ihsinoky/he-piantor-42/task/screenshots/dashboard-390.png

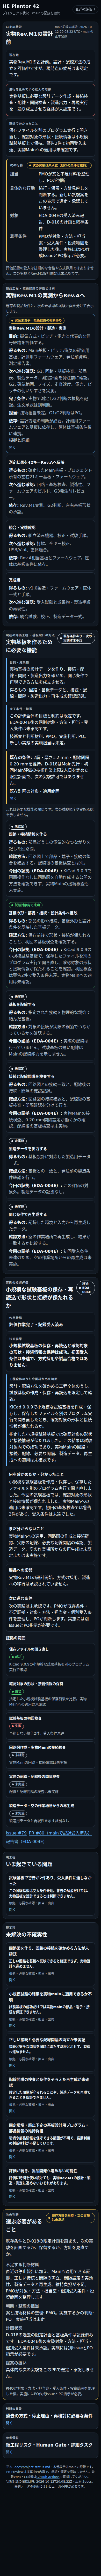
task/screenshots/dashboard-390.png
