ihsinoky/he-piantor-42/task/screenshots/dashboard-320.png

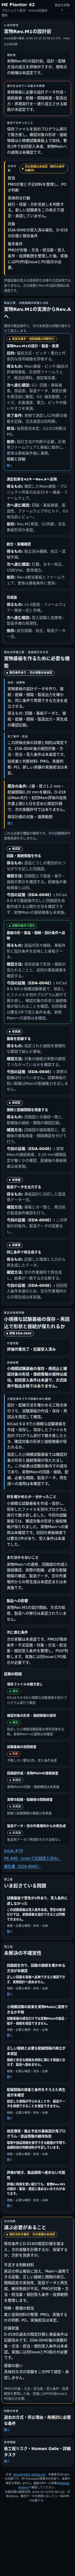
task/screenshots/dashboard-320.png
