ihsinoky/he-piantor-42/mechanical/README.md

# Mechanical

ケース最終データの正本は既存の `hardware/case/issue-198-final/` です。
[成果物索引](../docs/artifacts-index.md)からパラメトリック源・凍結入力・組立STEP・
印刷5ピースのSTEP/STL・検証結果へ直接進めます。

17mm版が正、16mm版は再生成・検証版。固定点15点、200mmハーネス収納、
別基板UDB C3、南辺フラッシュはPO了解済みです。
量産ピッチはMatrix実測後の判断で、ケース印刷はPO判断待ち。
保持力・クリープ等の物理検証は未実施です。[現行状態](../docs/project-status.md)を参照。
