ihsinoky/he-piantor-42/firmware/README.md

# Firmware

Planned stages:

1. Evaluation-board raw sensor acquisition and CSV/log output.
2. Per-key Hall calibration.
3. Digital press/release detection.
4. Vial keymap integration.
5. Layer indicator.
6. Optional adjustable actuation and Rapid Trigger behavior.
