ihsinoky/he-piantor-42/docs/tscircuit-native-spike-report.md

# Issue #19 — native tscircuit Hall spike report

## Outcome and scope

Checkpoints A, B, and C have native TSX implementations and machine-readable stock
tscircuit verification. GitHub Actions remains the authoritative execution
environment. PR #24 run #6 (ID `36808045782`) passed the Checkpoint A regression
and every mandatory Checkpoint B electrical category. Checkpoint B remains a source-level fixture with routing disabled, while
Checkpoint C adds a separate routed manufacturing fixture. This is not a GO or
NO-GO decision for Issue #19; the final decision remains a Human Gate.

The bootstrap task started at handoff commit
`e6ca2dfb0d2d3963bb9bd67fe15b7107af973b36`, which descends from main commit
`44735c7538cb21230758ba9acd334621ba09ad55`. The existing KiCad designs,
firmware, Hall sensor selection, ADC/MUX architecture, and production layout
were not modified.

## Source-of-truth model

The intended experiment was native TypeScript/TSX as the candidate EDA
source-of-truth, with Circuit JSON and manufacturing outputs generated by stock
tscircuit. No KiCad importer, generated-file editing, schema fork, exporter
fork, or autorouter fork was used. Because dependency acquisition was blocked,
the committed design source remains native TSX. Circuit JSON is generated only
as CI evidence and is never edited or committed.

## Tested versions and dependency reproducibility

The requested baseline is `tscircuit` **0.0.2646** and Bun **1.2.22**. Local
Codex Cloud execution remains unavailable:

- `npm view tscircuit@0.0.2646 version bin dependencies --json` returned
  `E403 Forbidden` for `https://registry.npmjs.org/tscircuit`.
- A direct `curl -I https://registry.npmjs.org/tscircuit` failed because the
  environment proxy rejected the CONNECT tunnel with HTTP 403.
- The installed Bun was 1.2.14, not the required 1.2.22.
- Node was v24.15.0 and npm was 11.4.2.

No alternative tscircuit version was selected. The handed-off `package.json`
and `package-lock.json` are unchanged. The lockfile SHA-256 is
`a6bd33cc9d0cfdd6f9f60fa343bf413fae4de33b62a8f4c26141857763cf9d33`.
The workflow hard-gates that digest, runs `npm ci`, checks that the lockfile
remains unchanged, and exactly asserts both runtime versions. Run #1 passed the
digest, install, immutability, Bun 1.2.22, and tscircuit CLI 0.0.2646 gates.

`npm ls --all --json` exited with status 1 and reported peer dependency
diagnostics involving `circuit-json@0.0.499` and
`@tscircuit/alphabet@0.0.25`. These diagnostics are retained in the evidence
artifact but do not invalidate the locked installation. The install output also
reported 11 vulnerabilities (8 moderate and 3 high), which remain a
dependency-health and supply-chain risk. This bootstrap checkpoint does not run
`npm audit fix`, update dependencies, or regenerate the lockfile.

The inherited `footprint:verify` package script is an Issue #13 artifact. It is
left unchanged to preserve the verified dependency pair and remains a future
cleanup candidate outside this checkpoint.

## Geometry provenance and Checkpoint A

The repository's existing
`hardware/lib/third_party/marbastlib-he.pretty/SW_MX_HE_0deg_1u.kicad_mod` was
read only as the permitted secondary reference. It identifies the Gateron
Magnetic Jade switch mechanical datasheet and contains the already verified
project geometry. It was not used as converter input and was not modified.

Checkpoint A uses only the pinned stock native `footprint`, `smtpad`,
`platedhole`, `hole`, and `keepout` primitives. The fixture also places stock
top and bottom copper pours. Repository-owned assertions inspect the resulting
Circuit JSON with an absolute tolerance of 0.001 mm.

The authoritative Checkpoint A conclusions are:

- **Native geometry — PASS:** three SMD pads, one PTH, two NPTHs, and all six
  generated positions verified within 0.001 mm.
- **Pin semantics — PASS:** DRV5055 DBZ pin 1 is VCC, pin 2 is OUT, and pin 3
  is GND. SMD pad 3 and PTH pad 3 are distinct physical PCB ports. Stock
  tscircuit represents them as internally connected source ports using
  `source_component_internal_connection`.
- **Keepout — PASS:** native top and bottom keepouts exist with
  `allow_traces = true` and `allow_placements = true`; actual copper-pour
  exclusion is demonstrated on both layers.
- **Copper pour — PASS:** top and bottom BRep pours were generated, both have
  an exclusion ring spanning the conservative keepout envelope, and the source
  render error count is zero.

| Feature | Native value | Provenance | Verification result |
| --- | --- | --- | --- |
| Hall SMD pads | Pin 1 `(-0.9375, -0.95)`, pin 2 `(-0.9375, +0.95)`, pin 3 `(+0.9375, 0)` mm; each `1.475 × 0.6` mm, top | Existing verified project footprint `hardware/lib/third_party/marbastlib-he.pretty/SW_MX_HE_0deg_1u.kicad_mod` | Circuit JSON asserts count, position, size, layer, and port hints |
| Pin 3 PTH | `(2.3, 0)` mm; 0.3 mm drill, 0.6 mm outer diameter | Existing verified project footprint | Circuit JSON asserts geometry and port hint `3` |
| Switch NPTH | `(-5.08, 0)` and `(+5.08, 0)` mm; 1.7 mm diameter | Existing verified project footprint; Gateron Magnetic Jade / KS-20 project reference | Circuit JSON asserts two circular holes and geometry |
| Hall pin mapping | `1=VCC`, `2=OUT`, `3=GND` | TI DRV5055 DBZ | Primary source ports are asserted; SMD 3 and PTH 3 resolve through distinct physical `pcb_port` records to source ports joined by a Hall-owned `source_component_internal_connection` |
| Relative alignment | Literal component-relative coordinates above | Existing verified project footprint | All six copper/mechanical features asserted within 0.001 mm |
| Top keepout | Center `(0,0)`, `4.0 × 3.6` mm, traces and placements allowed | Conservative native representation of the existing KiCad verified geometry's outer envelope | `pcb_keepout` fields and applicable stock copper-pour BRep inner ring asserted |
| Bottom keepout | Center `(0,0)`, `4.0 × 3.6` mm, traces and placements allowed | Conservative native representation of the existing KiCad verified geometry's outer envelope | `pcb_keepout` fields and applicable stock copper-pour BRep inner ring asserted |

### Native keepout result

Two independent native keepouts cover the conservative envelope on top and
bottom. Passing verification requires two `pcb_keepout` records and one stock
BRep copper pour per layer, each with an inner ring spanning the keepout
envelope. The pours use fixture-only `net.GND` because `connectsTo` is required
by the pinned stock API. They do not connect the Hall sensor and do not start
Checkpoint B. Merely finding keepout records is not sufficient.

## Checkpoint B — electrical result

**PASS.** PR #24 workflow run #6 (ID `36808045782`) is the authoritative
Checkpoint B execution. The native electrical fixture uses routing disabled
and contains exactly one `U1` Hall sensor, one `C_HALL1` 100 nF 0603
capacitor, and one `TP_H0_RAW` circular 1.2 mm pad test point. Named source
traces explicitly connect U1.VCC and C_HALL1.pin1 to the power net `HALL_5V`,
U1.GND and C_HALL1.pin2 to the ground net `GND`, and U1.OUT and
TP_H0_RAW.pin1 to `H0_RAW`.

PMO inspection of the generated stock Circuit JSON and all four evidence files
confirmed that every mandatory category passes:

- Hall sensor count: one named `U1` with `ftype = simple_chip`.
- Required nets: unique `HALL_5V`, `GND`, and `H0_RAW`; stock output marks
  `HALL_5V.is_power = true` and `GND.is_ground = true`.
- Hall mapping: primary pins `1=VCC`, `2=OUT`, `3=GND`.
- Hall attributes: VCC requires power and connection and recommends 100 nF
  decoupling; OUT requires connection; GND requires ground and connection.
- Hall connectivity: named source traces resolve VCC to `HALL_5V`, GND to
  `GND`, and OUT to `H0_RAW` using generated `source_port`, `source_net`, and
  `source_trace` records with `connected_source_port_ids` and
  `connected_source_net_ids`, not net-name string matching.
- Duplicate pin 3: the secondary physical PTH port remains internally connected
  to primary U1.GND.
- Decoupling: `C_HALL1` normalizes to `1e-7 F`; its two independently checked
  traces connect pin1 to `HALL_5V` and pin2 to `GND`.
- Capacitor footprint: one PCB component and two SMT pads are generated by the
  stock `0603` footprinter.
- Raw test point: stock `simple_test_point` output retains pad/circle/1.2 mm
  configuration and generates an SMT pad; its named trace connects pin1 to
  `H0_RAW`, shared with U1.OUT.
- Source electrical errors: `source_failed_to_create_component_error`,
  `source_trace_not_connected_error`, `source_pin_must_be_connected_error`, and
  `pcb_missing_footprint_error` each have count zero.
- Routing remains intentionally disabled in Checkpoint B; Checkpoint C uses its separate routed fixture.
- Checkpoint A regression: PASS in the same authoritative workflow.

The Checkpoint B artifact is `issue-19-tscircuit-native-checkpoint-b`, artifact
ID `11138353031`, digest
`sha256:a2924fee0e4158fd2677385f7176dd2c108224afc7b06eae0895679c6d4b6c01`.
Checkpoint B PASS is not an Issue #19 GO decision.

## Checkpoint C — two-layer PCB and manufacturing result

**PASS.** The authoritative GitHub Actions run is PR #25 workflow run #8
(ID `36851569406`, result **success**). The fixture uses stock
`autorouter="default"`, an explicit two-layer 1.2 mm board, 0.20 mm
trace/clearance rules, top and bottom GND pours, and one explicit 0.30/0.60 mm
top-to-bottom GND stitching via. PMO verification of the Checkpoint C artifact
confirmed one PCB board, three PCB traces, one PCB via, two keepouts, and zero
Circuit JSON `*_error` records. Physical routing exists for `HALL_5V`, `GND`,
and `H0_RAW`. Checkpoints A and B regressions also pass in the same workflow.

The stock `tsci build` command exits zero. `tsci check` reports zero errors.
The non-fatal warnings are `schematic_missing_sheet_warning` and
`pcb_component_missing_courtyard_warning` for U1 and TP_H0_RAW. The locked
stock `tsci check shorts --mode gerber --layer all` reports zero shorts; no
dependency or CDN workaround was used.

## Manufacturing results

Stock `tsci export <generated-circuit-json> --format gerbers` produces the ZIP;
no generated output is edited. Machine-readable verification confirms:

- `F_Cu.gbr`, `B_Cu.gbr`, and `Edge_Cuts.gbr` exist and are non-empty, with no
  inner-copper Gerber.
- `drill-L1-L2.drl` retains both 0.30 mm plated drills: the Hall PTH and the GND
  via. `drill_npth.drl` retains both 1.70 mm switch holes.
- `bom.csv` contains U1 and C_HALL1. U1 source metadata retains TI
  `DRV5055A3QDBZR`, and the stock BOM retains JLCPCB part `C266128`.
- `pick_and_place.csv` contains U1 and C_HALL1 with designator, finite X/Y,
  top/bottom layer, and finite rotation. The physical test point is normally
  excluded from assembly output.
- The plated drill contains the Hall PTH at `X2.3000Y0.0000` and the GND
  stitching via at `X7.0000Y3.0000`, both 0.30 mm. The NPTH drill contains the
  switch holes at `X-5.0800Y0.0000` and `X5.0800Y0.0000`, diameter 1.70 mm.
- The actual stock PnP rows are `U1,0.000,0.000,top,0` and
  `C_HALL1,7.000,-3.000,top,0` (columns: designator, mid X, mid Y, layer,
  rotation).

**PCB FABRICATION PIPELINE = PASS. PCBA DATA STRUCTURE = PASS. PCBA ORDER
READINESS = PARTIAL / DESIGN DATA GAP.** The `C_HALL1` 100 nF 0603 capacitor
supplier identity remains **TBD**, and supplier-specific JLCPCB orientation
correction is **UNVERIFIED**. These are design-data gaps, not stock exporter
data loss, and the PCB is not declared ready to order. The baseline FR4, two
layers, 1.2 mm, 0.20 mm trace/clearance, 0.30/0.60 mm via, and 1.70 mm NPTH is
within the supplied JLCPCB capability baseline. The existing Hall 0.30 mm PTH
is within minimum drilling capability but remains a **MANUFACTURABILITY
CAUTION** because it is below the general 0.50 mm PTH recommendation.

Custom router/exporter/format-workaround count is **zero**. STOP A, B, C, D,
and E are not reached. The authoritative Checkpoint C workflow and artifact
details are recorded below.

## Available DRC/checks

Stock render assertions, `tsci build`, `tsci check`, stock Gerber-mode shorts
checking, and repository-owned read-only verification of Circuit JSON and
manufacturing files all pass locally. The repository code does not implement
EDA, routing, manufacturing export, or generated-file repair.

## CI and evidence artifact

PR #23 workflow run #3 (ID `36770701295`) is **FAIL** for the two implementation
defects described above. Its Checkpoint A artifact ID is `11123790964`, digest
`sha256:1162fc507e20ad94806b1214e56531cef63a6271209c23cc67bce74328f62b0d`.
That run exposed the initial verifier's incorrect shared-`pcb_port_id`
assumption and the copper-pour fixture's missing required `connectsTo` prop.
Both defects were corrected in the subsequent revision.

PR #23 workflow run #4 (ID `36778588388`) is **PASS**. Its Checkpoint A artifact
`issue-19-tscircuit-native-checkpoint-a` has artifact ID `11126467110` and
digest
`sha256:071f9856bd37782197fc6f434c3dac8bc27cfc1aed724696164cffefbfa02094`.
PMO inspection confirmed every mandatory result is PASS, with Circuit JSON
counts of three `pcb_smtpad`, one `pcb_plated_hole`, two `pcb_hole`, two
`pcb_keepout`, two `pcb_copper_pour`, and zero
`source_failed_to_create_component_error` records. Existing `engineering-ci`
run #141 is also **PASS**.

PR #24 workflow run #6 (ID `36808045782`) is **PASS**. Checkpoint A regression
and all mandatory Checkpoint B electrical categories passed in that run. The
Checkpoint B artifact `issue-19-tscircuit-native-checkpoint-b` has artifact ID
`11138353031` and digest
`sha256:a2924fee0e4158fd2677385f7176dd2c108224afc7b06eae0895679c6d4b6c01`.
PMO verified its `verification-result.json`, `electrical-summary.json`,
`execution-log.txt`, and generated `circuit.json`. The corresponding
`engineering-ci` run #144 is also **PASS**.

PR #25 workflow run #8 (ID `36851569406`, head
`b379151529ccaf8bcd1dcfc5cdec0be90cacb399`) is **PASS**. The
`issue-19-tscircuit-native-checkpoint-c` artifact is ID `11155442692`, digest
`sha256:943422a9a635dfc8df5a82657e0cd19dc17e6e08d0eafd0af14e8f10e3a16886`.
PMO verified the artifact and confirmed Checkpoints A, B, and C all **PASS**;
the stock build exits 0, `tsci check` reports zero errors, and
`tsci check shorts --mode gerber --layer all` reports zero shorts. Stock
Gerber, drill, BOM, and PnP export passes. `engineering-ci` run #147
(ID `36851569279`) is also **PASS**.

## Codex Cloud limitation

The environment forced npm and HTTPS traffic through `proxy:8080`; access to
the npm registry and GitHub raw content was rejected with HTTP 403. The required
Bun version was also absent. These are local Codex Cloud limitations rather than
evidence of a tscircuit product limitation. GitHub Actions is therefore used to
validate the handed-off dependency pair without developer-local hidden state.

## Stock-only policy and custom repository code

Stock-only policy was maintained. The repository-owned verification script
asserts stock Circuit JSON but does not implement EDA, routing, exporting, or a
format adapter. No hidden patch or workaround was introduced.

## Remaining unsupported or unverified features

Checkpoint C now verifies the two-layer stock manufacturing pipeline. Full PCBA
order readiness remains partial because capacitor supplier identity and
supplier-specific orientation metadata are source-design gaps.

## STOP status and Human Gate

- **STOP A — not reached:** run #4 passed all mandatory native geometry and
  functional copper-pour exclusion checks.
- **STOP B — not reached:** generated-file editing was neither attempted nor
  required.
- **STOP C — not reached:** no browser UI, interactive login, or
  developer-local hidden state has been shown to be essential. Local Codex
  Cloud package access is blocked, while GitHub Actions is the verified
  non-interactive execution path.
- **STOP D — not reached:** no paid dependency requirement was observed.
- **STOP E — not reached:** stock export retains all mandatory Gerber, drill,
  BOM identity, routing, and pick-and-place fields.

Current bootstrap status matrix:

- Codex Cloud local npm access: **BLOCKED**
- GitHub Actions bootstrap: **PASS**
- Dependency reproducibility: **PASS**
- npm ci: **PASS**
- Bun 1.2.22: **PASS**
- tscircuit 0.0.2646: **PASS**
- Lock integrity: **PASS**
- Checkpoint A: **PASS**
- Checkpoint B: **PASS**
- Checkpoint C: **PASS**

Checkpoint A, B, and C pass without reaching a technical tscircuit STOP.
STOP A, B, C, D, and E are not reached. No GO/NO-GO recommendation is made.
**BOOTSTRAP GATE — PASS**, **CHECKPOINT A — PASS**, **CHECKPOINT B — PASS**, and
**CHECKPOINT C — PASS** do not constitute a GO for Issue #19 as a whole. The
technical checkpoints are complete; the final GO/NO-GO decision remains with
the PO / PMO Human Gate. Issue #19 remains open.

CHECKPOINT C evidence finalized — final PO / PMO Human Gate waiting
