ihsinoky/he-piantor-42/hardware/rev-m1/architecture.md

# Physical Rev.M1 architecture

Accepted architecture requirements — D-015 / D-017, Issues #41 / #57. No schematic, footprint, PCB,
routing, panel or manufacturing output is implemented here.

> **Planning-time record:** The EDA direction and sequence below describe the
> D-016/D-017 acceptance-time plan. EDA-004B–E later qualified none of these
> product-design routes; no current backend or next experiment is approved.
> See the [current project status](../../docs/project-status.md).

[D-015](../../docs/decisions.md#d-015---revm1-reusable-main--evaluation-wing-architecture)
separates physical Rev.M1 from the permanent four-key qualification fixture.
The frozen native tscircuit source/verifier, C2 parity contract/evidence, C3
geometry report and historical sensor-test inputs remain unchanged. D-014 is
historical electrical authority for the fixture, not an adoption decision for
the new product. C2 remains accepted PASS: 68 components, 200 normalized
endpoints, 43 named nets, 185 endpoint/net edges, 4 direct links, 7 intentional
NCs. C3 remains valid discrepancy/modeling/footprint-policy evidence; exact
geometry convergence to the legacy reference is no longer required for adoption.
Those questions have changed relevance, not all been resolved.

```text
USB -> Reusable Main: RP2040 + 3V3 + switched HALL_5V + debug
                    | address / enable / power / ground
                    v
             Evaluation Wing(s): Hall positions -> TMUX1208
                    | analog outputs through representative interconnect
                    v
             Main: three divider/filter paths -> three ADC channels

Rev.A: accepted Main <-> Left 21-key Wing (3 TMUX1208)
                     <-> Right 21-key Wing (3 TMUX1208)
```

Main owns USB, MCU/core and logic power, switched Hall power generation,
three ADC channels and their dividers/filters, Wing interface and bring-up
facilities. Evaluation Wing owns Hall positions, TMUX1208, its connection to
Main and physical switch geometry for pitch and magnetic experiments.

First-choice Rev.A reuses Main unchanged or with explicitly approved
corrections. Left/Right Wings share a project-owned generation definition;
separate designs and manufacturing outputs are allowed, with no reversible
PCBA requirement. Keeping the validated MCU/power/ADC/filter boundary reduces
Rev.A risk, but interconnect loading and production bank behavior must be
represented in M1 measurements before reuse is accepted.

Fixed by D-015: modular responsibilities, Main-side ADC conditioning, Main
reuse intent, three-TMUX/21-key-per-Wing Rev.A candidate, and evaluation of
17.0 / 16.5 / 16.0 mm. [D-017](../../docs/decisions.md#d-017---revm1-mainwing-architecture-and-interface-freeze) and the
[accepted G0B record](g0b-freeze-proposal.md) freeze the exact JST GH 14-position
connector/pinout, six common-GND returns, nominal 100 mm 1:1 evaluation
harness, external Main-side pull-down for each `WING_EN`, pitch-specific
Wings and full-load three-TMUX/three-ADC coverage. Production pitch, final
Hall choice, final cable mechanics, resistor value and physical implementation
remain open. Do not consume `hardware/layout/**`.

[G0A](../../docs/project-status.md#human-gates) was completed at D-016: Issue #55 /
[D-016](../../docs/decisions.md#d-016---jitx-physical-backend-no-go-native-tscircuit-resumes-as-active-revm1-eda-candidate)
records JITX physical-backend NO-GO and, at that decision, native stock
tscircuit as the forward Rev.M1 EDA path. G0B is accepted / done under D-017.
The original planned sequence was G0B -> EDA-003B representative
stock-tscircuit physical/routing proof -> if accepted, full Rev.M1
implementation. EDA-003B through EDA-004E have since completed with
unqualified/blocked outcomes; that sequence is historical, not the current
authorized plan. EVT-002 is not active.
EDA-003A is accepted as UPSTREAM_FIX_CANDIDATE; current importer reuse is
not approved and native TSX remains authoritative. C4A itself did not select
an active backend.
See [logical interface](main-wing-interface.md), [experiments](evaluation-plan.md)
and [DFM policy](dfm-policy.md). No physical hardware is claimed implemented.
