ihsinoky/he-piantor-42/hardware/jitx/PLAN.md

# Project Plan: HE Piantor 42 JITX Challenger Backend

## Scope and authority

EDA-002B establishes only a reproducible JITX project and a machine-readable
parity contract. It does not implement, place, route, or make authoritative an
M1 JITX board. The frozen electrical authority remains
`../tscircuit/src/evaluation/m1-four-key.tsx`, verified by
`../tscircuit/scripts/verify-m1-electrical.tsx`.

## Data sources

| Source | Approved use |
| --- | --- |
| `../tscircuit/src/evaluation/m1-four-key.tsx` | Frozen M1 component, net, connectivity, geometry, and board data |
| `../tscircuit/scripts/verify-m1-electrical.tsx` | Independently asserted endpoint and critical-footprint requirements |
| `../sensor-test/design.md` | Historical qualification-fixture requirements and design-data gaps |
| `../sensor-test/pinmap.csv` | Historical qualification-fixture RP2040 logical assignments |

`../layout/**` is GPL/QMK-derived and is explicitly out of scope. No component
data or geometry is sourced from it.

## Bootstrap task

### [bootstrap-01] Canonical JITX project

- **Type:** project bootstrap
- **Description:** Scaffold the CLI-owned project layout, pin Python `jitx`
  4.4.3, and retain only source/configuration files needed to repeat the
  authenticated Codespaces bootstrap build.
- **Verification:** `jitx build he_piantor_42_jitx.main.HePiantor42Bootstrap`
- **Status:** accepted

### [parity-01] M1 parity contract

- **Type:** contract
- **Dependencies:** bootstrap-01
- **Description:** Freeze the backend-neutral requirements a future JITX
  implementation must reproduce from the approved project-owned sources.
- **Verification:** `python -m json.tool parity/m1-parity-contract.json`
- **Status:** accepted

### [EDA-002C0] Built-design graph introspection

- **Type:** reproducibility and capability spike
- **Dependencies:** bootstrap-01, parity-01
- **Description:** Establish a reproducible Python dependency resolution and
  prove whether a real JITX build has a deterministic, machine-readable graph
  export through the documented JITX plugin interface.
- **Verification:** `jitx design export bootstrap-graph
  he_piantor_42_jitx.main.HePiantor42Bootstrap --output <path>` and
  `python -m unittest tests.test_bootstrap_graph`.
- **Status:** accepted — **PASS**
- **Evidence:** `parity.exporter` is registered through the standard
  `jitx-plugin` project entry-point group and invoked by the documented
  `jitx design export` command. Its `Export.submitted()` hook receives the
  actual `RuntimeDesign`; the exporter uses only `RuntimeDesign.query()`,
  `RuntimeDesign.nets().find()`, `jitx.inspect.visit()`, and `Trace.path`.
  Two real non-dry exports produced semantically identical normalized JSON:
  two resistor instances, four public `Port` identities, and two resolved
  port-membership groups. It does not parse project source or any generated
  JITX artifact, and it uses no private JITX object or module.
- **Stability:** `jitx.inspect` and `jitx.plugin.export.Export` are documented
  public APIs. `jitx.run`, which defines `RuntimeDesign.query()` and
  `RuntimeDesign.nets()`, is documented but explicitly marked experimental.
  The standardized `Export` hook is the supported boundary supplying the
  object; the graph mechanism has no category-C dependency. PMO accepted these
  category-B runtime-design methods for the JITX challenger/parity evaluation
  workflow; that acceptance does not classify `RuntimeDesign` as stable.
- **Compatibility rule:** Any future JITX Python package or JITX runtime
  version change must rerun and pass the EDA-002C0 normalized graph exporter
  and bootstrap graph self-test before graph-parity compatibility may be
  assumed.

### [EDA-002C1] Component modeling

- **Type:** component-modeling checkpoint
- **Dependencies:** EDA-002C0
- **Description:** Model the M1 manufacturer components from manufacturer
  documents, retaining project-approved semantic identities only as metadata
  for a later top-level assembly. `component-sources.md` is the authoritative
  source-manifest for this increment.
- **Status:** done / accepted — all nine manufacturer-specific models
  have physical inventories, explicit pad maps, structural tests and real builds.
  PR #36 merged into main at a27fc48; C1 accepted/done. EDA-002C2 is done / accepted / merged PR #38 with electrical parity PASS.
- **Parity qualification:** HRO and Winbond manufacturer geometry differs from
  frozen M1 geometry. `component-sources.md` enumerates the differences for PMO;
  no geometric parity claim or authority change is made.

### [reproducibility-01] Locked Python environment

- **Type:** dependency reproducibility
- **Description:** Commit the standard `uv.lock` resolution generated by
  `uv lock`; use `uv sync --locked --group dev` to recreate the local editable
  environment without changing the validated JITX runtime.
- **Verification:** `uv sync --locked --group dev`
- **Status:** accepted

### [EDA-002C2] M1 electrical graph parity

- **Dependencies:** EDA-002C0, accepted EDA-002C1 (merged PR #36)
- **Issue:** #37
- **Status:** done / accepted / merged PR #38 at `67b6c302` — electrical graph parity **PASS**. Geometry parity explicitly **NOT established**.
- **Evidence:** actual RuntimeDesign exports, deterministic raw and normalized
  graphs, strict comparator and fault-injection tests. 68 components, 200
  normalized endpoints, 43 named nets, 185 endpoint/net edges, four direct links,
  seven intentional NCs; 23 extra physical GPIOs explicitly unconnected.
- **Verification:** locked sync; 20 Python tests; bootstrap and C2 real-export
  regressions; ruff; pyright; real M1 build; frozen tscircuit verifier;
  protected-file checks and git diff --check. `parity/EDA-002C2.md` records
  commands, review and reproduction instructions.

### [EDA-002C3] Historical geometry evidence

- Issue #39 / merged PR #40, baseline `bc061435`.
- Evidence package retained and valid: `geometry/EDA-002C3.md` and
  `geometry/geometry-reconciliation.json` remain unchanged, including their
  recorded Human Gate dispositions/recommendations.
- HRO, Winbond, RP2040 and derived-land discrepancies demonstrate manufacturer
  modeling capability and footprint-policy risks. They are not all resolved.
- D-015 changes relevance: exact legacy geometry convergence is no longer
  required for adoption; C2 electrical PASS remains accepted.

## EDA-002C4 sequence — evaluation rebaseline (issue #41)

### EDA-002C4A — accepted / merged PR #42

Merged baseline: `8f6c401a902353547dcacbdfc76978ac807ce7f9`.

Completion freezes the legacy four-key golden permanently as a qualification
fixture, retains C2 electrical PASS and C3 historical geometry evidence,
removes exact geometric convergence as an adoption criterion, defines physical
pipeline acceptance criteria, and separates physical Rev.M1 implementation
under [D-015](../../docs/decisions.md) from JITX qualification. No hardware,
footprint or PCB geometry changes, connector selection or adoption decision
occur here. D-014 remains unchanged. C3 discrepancies do not invalidate C2;
manufacturer evidence informs the new product, without correcting the legacy
tscircuit geometry or declaring all C3 questions resolved.

### EDA-002C4B — completed investigation / BLOCKED (issue #43)

The disposable four-key physical wrapper builds with a project-owned 80 × 60 mm,
nominal 1.2 mm two-layer stack and explicit placement of all 68 existing
components. Six source route segments realize copper on both layers through
two vias. Public capture, BOM/PnP review CSVs and supported ODB++ exports repeat;
68 ODB placements/angles agree with the review CSVs. C2 electrical parity
remains PASS with the accepted counts and unchanged contract.

**BLOCKED:** full board routing/DRC and a supported, qualified Gerber/Excellon
handoff are not demonstrated. ODB content order/IDs vary despite matching narrow
geometric records. Supported KiCad export was investigated; downstream CAM and
JLCPCB rotation conventions remain unqualified. Generic BOM completeness is a
separate product sourcing limitation. No private API, artifact patch, external
CAD round-trip, component redesign, product Main/Wing implementation or order
was used. See the [C4B report](physical/EDA-002C4B.md) and machine-readable evidence.

C4C is next / Human Gate; G0A is ready-for-decision on this blocked evidence,
not GO. G0B remains not-ready and EVT-002 remains blocked/unstarted. No D-016
or adoption decision is made here.

### EDA-002C4C — next / Human Gate / G0A

Inputs: C0-C3 accepted evidence and C4B physical/manufacturing pipeline result.
Explicit outcome:

- **GO:** JITX becomes the active EDA candidate for physical Rev.M1 / Rev.A.
- **NO-GO:** retain/fallback to another supported backend without invalidating
  C0-C3 evidence.

C4A makes neither decision. A future accepted D-016 may record JITX as the
active EDA for Rev.M1 and Rev.A; D-016 is not created or accepted now.
G0B separately freezes physical architecture/interface before implementation.
See [physical architecture](../rev-m1/architecture.md).

## Deferred product work

Physical Rev.M1 Main/Wing schematic, placement, routing, DRC, connector
selection, manufacturing and EVT-002 remain unstarted behind G0A/G0B.
`hardware/layout/**` is excluded; future Left/Right generation geometry must
be project-owned or explicitly approved at a later Human Gate.

## Task complete: EDA-002B bootstrap and parity contract

**What was built:** Canonical `hardware/jitx/` CLI project with
`he_piantor_42_jitx.main.HePiantor42Bootstrap` and
`parity/m1-parity-contract.json`.

**Build:** `status: ok` (via
`jitx build he_piantor_42_jitx.main.HePiantor42Bootstrap`)

**Primary source:** JITX CLI scaffold for the bootstrap package; frozen M1
sources listed in the Data Sources table for the parity contract.

**Secondary references:** `../sensor-test/design.md` and
`../sensor-test/pinmap.csv`.

**Footprint source:** not applicable: no M1 footprint or layout was implemented.

**Checks run:**
- `ruff check`: clean
- `ruff format --check`: clean
- `pyright`: not available; not installed in the project environment
- Parity JSON: `python -m json.tool parity/m1-parity-contract.json` passed
- Frozen M1 verification: `npm --prefix ../tscircuit run m1:verify` passed

**Interface notes:**
- Ports exposed: bootstrap-only seed circuit; no M1 interface is exposed.
- Power requirements: no M1 power tree is implemented.
- Constraints needed at top level: deferred to the M1 parity increment.

**JITX code review (self):** clean
- CRITICAL: 0 — no string-keyed models, reflection, parallel scene graphs,
  framework-boundary bypasses, or dynamic classes in
  `he_piantor_42_jitx/`.
- WARNING: 0
- NOTE: 0

**JITX skill use:** The JITX code-review skill was an execution-time agent aid
only. No JITX skill source, script, or other proprietary material is retained
in this repository.

**Outside-voice review (codex):** not applicable: complete-board, task class
not in trigger list.

**Verdict (self):** ready-for-review

**Open issues / deferred (historical EDA-002B):** Electrical parity was then
deferred; C2 now passes it. Geometry, placement, routing, DRC and EVT-002 remain
deferred.

**Verdict (acceptance):** accept
**Notes:** EDA-002B intentionally supplies a reproducible challenger bootstrap,
not an M1 board implementation.

## EDA-002C2 execution plan and completed gates (issue #37)

- Phase 0: frozen project sources only; electrical semantics authorized by the
  implementation request. Existing C1 models retained without edits. Geometry,
  layout, SI/DRC and manufacturing are explicitly outside this task.
- Phase 1: project-owned generic components (no invented MPNs), structural
  validity only; physical implementation choices are non-authoritative.
- Phases 2/3: idiomatic JITX circuit assembly, explicit nets and object ports;
  separate machine-readable parity normalization, never used to wire the circuit.
- Phase 3b: audit complete connectivity against frozen requirements, including
  supply domains, NCs, RP2040 pin assignments and exact passive values.
- Phase 4: real build; two independent RuntimeDesign electrical exports;
  actionable comparator and fault-injection tests; bootstrap regression; locked
  dependencies, lint/type checks, golden verifier, protected-file checks.
- Completion: self-review and evidence; update status only upon full PASS; push
  the C2 branch and open one PMO-review PR without merging (completed as PR #38).
  C3 historical evidence is now retained under the C4A rebaseline.

Status: done / accepted / merged PR #38 at `67b6c302`, electrical PASS.
Geometry parity NOT established; EVT-002 blocked/unstarted.
Runtime startup repaired using existing authorized runtime;
versions unchanged. No skill source is copied into the repository.

## EDA-002C4B execution plan (issue #43)

Disposable backend qualification only. The user authorized autonomous execution;
existing C1 models and C2 topology are locked inputs. No new sourcing, product
architecture, production geometry, layout-directory consumption or dependency
change is planned. Complete-board capability investigation; unsupported gates
remain failures, rather than being waived by the skill workflow.

1. Discover public supported surfaces and record an early capability matrix.
2. Define a project-owned two-layer, 1.2 mm substrate and simple board; compose
   the existing M1ElectricalCircuit with explicit placement, without rewiring.
3. Test source Route/Via realization and supported validation; account for
   incomplete routing rather than undertaking an unreasonable hand route.
4. Assess built-in manufacturing exports and public project BOM/PnP export,
   repeat generation and compare. Preserve separate EDA/BOM conclusions.
5. Run C0/C1/C2 and physical checks, code review, protected-file checks; record
   actual verdict and update only authorized status documents; commit/push/PR.

Phase 0 data/requirements gate: accepted inputs from C1/C2; JLCPCB qualification
defaults explicitly labeled, no production or SI targets. PLAN/ARCHITECTURE
already exist. Official docs and installed CLI are the workflow authority.
Mandatory Gerber/drill/PnP and full routing/validation remain open until proven.

C4B execution result: investigation complete / BLOCKED. Supported board, stack,
explicit placement, partial two-layer source copper, public BOM/PnP observer
and ODB++ generation are demonstrated. Complete routing/DRC and qualified
Gerber/drill handoff remain open; complete-board acceptance is not granted.
All 20 existing tests and final lint/format checks pass; source hashes and
protected-file checks pass. Independent review warnings were resolved.
See `physical/EDA-002C4B.md` and `physical/evidence/`. C4C is next / Human Gate;
G0A ready-for-decision on blocked evidence, G0B not-ready, EVT-002 unstarted.
