ihsinoky/he-piantor-42/hardware/jitx/physical/EDA-002C4B5.md

# EDA-002C4B5 — supported complete-routing qualification

**Final C4B5 disposition: BLOCKED.** Issue [#53](https://github.com/ihsinoky/he-piantor-42/issues/53).
The pinned public source workflow produces substantial copper, but neither
retained candidate achieves zero downstream unconnected electrical items.
The explicit multilayer candidate retains **39 unconnected items and a dangling
via**. This concludes a bounded supported-workflow investigation, not complete
routing, manufacturing release, or the C4C / G0A adoption decision.

## Baseline and boundary

Clean working tree, HEAD, local main, freshly fetched/pruned origin/main, and
merge bases with both main refs all matched
`69dd846ac76d40f333b1b099a13d2a4720cfe758`. Git fetch required sandbox escalation.
Issue #53 was read completely (no comments), along with C4B–C4B4B reports,
physical source/reproduction/reconciliation and both status authorities.
Branch: `eda-002c4b5-complete-routing-feasibility`.
[Discovery/preflight](c4b5-evidence/routing-surface.json) records this state.

Forward `routing_qualification.py` subclasses the unchanged disposable C4B
circuit, which inherits accepted C2. All 68 components, manufacturer landpatterns,
NCs, topology, 80 x 60 mm board, substrate, fabrication constraints and source
placement remain unchanged. No `hardware/layout/**` geometry is used. This is
not physical Rev.M1 Main/Wing, Rev.A or G0B implementation. Historical C4B through
C4B4B reports/evidence and all pre-existing JITX source/configuration remain
byte-unchanged. Generated CAD/CAM is ignored and never edited.

## Supported surface and early strategy

[Surface matrix](c4b5-evidence/routing-surface.md) distinguishes A public,
B experimental, C interactive/manual-only, D private and E unavailable. Exact
installed symbols/signatures, source module hashes and public CLI help are in
its JSON companion. Environment: **Python 3.14.2 / JITX 4.4.3 /
jitxlib-standard 4.4.0 / runtime 4.4.2 / KiCad CLI 9.0.9**. Locked sync, auth,
runtime reachability and non-dry builds succeeded; no version upgrade.

The strongest established non-interactive surface is **A: source `Route` requests
using the JITX single-layer topological engine**, with public sketches, pads,
source vias and signal `PortAttachment`. The existing public capture observer
uses **B: experimental RuntimeDesign**. Interactive selection/layer routing and
auto-via are supported UI facilities; no public headless global multilayer
planner or whole-GUI-layout-to-Python routing conversion was established in the
pins. This is a bounded surface finding, not proof of impossibility.

Before specifying point-by-point paths, select deterministic nearest-pad spanning
trees from actual public `Net`, `PadMapping` and pad geometry. This scales endpoint
intent to all required nets with compact Python. Preserve the four existing
Hall/probe paths, including H0's two vias. Include physical multi-pad islands:
USB SHIELD receives three requests among its four manufacturer stakes despite
having a singleton semantic endpoint. Empty declarations, intentional NCs and
unused GPIOs get no requests. The method delegates copper pathfinding to JITX;
it is not an external autorouter or user implementation of a copper router.

A preliminary real build/capture/DRC reduced historical 147 unconnected items
to 42 (111/153 requests realized), with a new copper-sliver warning. This justified
the fresh systematic experiment and a representative explicit multilayer escape,
without a large manual segment program. Preliminary ignored outputs are under
`designs/c4b5/exploratory`; retained qualification evidence is the fresh pair below.

## Actual downstream results

[Pipeline](c4b5-evidence/pipeline.json) records exact command argv, exit codes,
logs/hashes, source hashes and complete generated inventories. Each experiment
restarts the pinned runtime and removes only that forward design's ignored
state and its own run directory. The two experiments use different circuit
variants; **they are not two successful regenerations of one candidate**.

| Fresh experiment | Source requests realized / total | Vias | KiCad unconnected | New routing findings |
| --- | ---: | ---: | ---: | --- |
| 1: systematic top-layer requests + inherited H0 path | 113 / 153 | 2 | **40** | One F.Cu copper-sliver warning |
| 2: replace failed MUX_A0 request with explicit two-via escape | 116 / 155 | 4 | **39** | One dangling-via warning |

Both real builds report `status: ok`; that does not certify physical connectivity.
Both supported `legacy-kicad` exports succeed. KiCad input is mounted read-only;
all input-tree hashes remain unchanged after KiCad DRC. DRC returns code 5.
Raw findings and physical capture are retained in
[experiment 1](c4b5-evidence/experiment-1.json) and
[experiment 2](c4b5-evidence/experiment-2.json).

Experiment 2 binds GPIO2 and mux A0 to two unchanged 0.65/0.30 mm through vias
at (-18.5, 1.4) and (11.8, 2.275) mm. JITX realizes the bottom span and mux-side
top connection; it fails the MCU-side top escape. KiCad independently identifies
the MCU-side via as connected on only one layer. MUX_A0 remains unconnected.
Replacing a constructed request emits a structural lost-reference warning;
the test verifies exactly one old request is removed, and capture confirms 155
requests including the three replacements. No hidden route is assumed.

Other missing connectivity spans supply distribution, MCU/flash QSPI, USB,
crystal, debug, mux controls and Hall-to-mux connections. Source endpoint counts
are not substituted for this physical evidence. In both fresh reports USB_SHIELD
has no missing connection: all four stakes are physically joined in downstream
CAD. This local success does not hide the remaining board-wide failures.

Both reports also retain exactly **four known USB NPTH hole-clearance errors
and 68 generated-library-registration warnings**. No new short, wrong-net,
copper-clearance, invalid via geometry/layer-transition, copper-outside-board or
edge-clearance finding was reported. The new sliver/dangling-via findings remain
unresolved; their warning severity is not used to waive them. No rule was relaxed.

Complete routing was not achieved, so Gerber/Excellon generation and a successful
same-candidate two-fresh-run manufacturing comparison are **not applicable** and
were not performed. Earlier and fresh top-layer captures differ in realized
request count; routing stability is unqualified. No geometric difference was
normalized away. The two different experiments cannot establish determinism.

## Workflow suitability and limiting mechanism

All attempted routing intent is represented in Python. Regeneration is
non-interactive, with no GUI action or GUI-authored hidden state. Ordinary diffs
expose endpoint selection, via coordinates, layer use and optional sketches;
computed copper needs capture/downstream DRC to review. The routing module is
approximately 140 lines, including both variants; 147 additional requests are
selected systematically, not hand-written segment by segment. One manual
escape adds two positions and three requests. Existing six routes/two vias are
inherited unchanged. Codex can create/review this intent and run the pipeline.

The limiting mechanism is **global layer/fanout/path planning**, not lack of a
Route constructor or route-all CLI. Single-layer endpoint trees leave 40 physical
connections missing. Specifying a second-layer span does not solve reaching that
layer from a crowded MCU pad. Expansion requires package escape placement,
layer allocation, route ordering/sketch changes and repeated physical verification
across many nets. No supported automatic source helper for those combined tasks
was established in the installed pins. Constraints, control points and via
structures describe local intent; they do not supply this planner.

This evidence does not prove that an expert cannot finish the board manually,
or that every alternative placement/route ordering fails. It establishes that
these compact supported approaches did not complete this fixture, and that a
credible complete AI/source-controlled workflow has not been demonstrated.
A routine maintenance claim would currently depend on unqualified substantial
manual routing strategy, likely aided by GUI inspection. Arbitrary placement
sweeps or enumerating many sketches to force green would not establish suitability.
No such brute force, private API, generated-KiCad edit, external router or EDA
round-trip is used. Further investment belongs in the C4C assessment.

## Electrical regression, reproduction and review

[Electrical reconciliation](c4b5-evidence/reconciliation.json) compares both live
wrapper graphs with a fresh unchanged C2 export, excluding only added physical
attachments from original component memberships. Components and original net
memberships match. The unchanged normalized contract passes: **68 components,
200 endpoints, 43 named nets, 185 endpoint/net edges, four direct links,
seven intentional NCs**, with accepted unused GPIO accounting.

From `hardware/jitx`, with the existing environment and Docker:

```bash
UV_CACHE_DIR=/tmp/eda-c4b5-uv-cache uv sync --locked --group dev
source .venv/bin/activate
jitx auth show
jitx runtime start --background
python -m physical.reproduce_c4b5
python -m unittest discover -v
ruff check he_piantor_42_jitx physical parity tests
ruff format --check he_piantor_42_jitx physical parity tests
python -m compileall -q he_piantor_42_jitx physical parity tests
```

The reproducer uses supported non-dry build, existing physical capture plugin,
`legacy-kicad`, then read-only pinned-container `kicad-cli pcb drc --format json
--severity-all --exit-code-violations`. It stops on unexpected command failure.
These partial designs must not be fabricated. No CAM or ordering command follows.

[Validation and self-review](c4b5-evidence/validation.json) records actual checks,
protected historical files, regression outcome and review scope. Same-model JITX
review uses installed jitx/physical-layout/code-review instructions and architecture
checklist. No unresolved critical code issue or private boundary crossing remains.
The intentional removed-request warning and incomplete route planner are retained
limitations. The two new tests protect physical-pad/NC coverage and exact
single-request replacement; downstream DRC remains completion authority.

## PMO / Human Gate

No environment/license STOP occurred; the experiments were meaningful. C4B5 is
**BLOCKED**, not PASS_WITH_LIMITATIONS: required physical routing is incomplete.
There is no assertion that only a forbidden workaround could solve the board.

C4B4B's downstream manufacturing path remains **PASS_WITH_LIMITATIONS**, including
the misleading generated 1.6 mm overall CAD/job metadata and independent **1.2 mm**
finished-thickness handoff. USB remains **OPEN — PRE-ORDER DFM REVIEW REQUIRED**;
no production exception or clearance resolution is granted. No supplier contact,
upload or order occurred.

After C4B5 acceptance, **C4C / G0A Human Gate is next** and must explicitly evaluate
this routing/workflow limitation; JITX is not technically accepted for full
physical implementation. No adoption decision, C4C work or automatic merge.
PMO reviews the bounded BLOCKED conclusion; PO decides MERGE / HOLD.
