ihsinoky/he-piantor-42/hardware/jitx/physical/EDA-002C4B2.md

# EDA-002C4B2 — JITX → headless KiCad downstream CAM

**Verdict: BLOCKED.** Issue [#45](https://github.com/ihsinoky/he-piantor-42/issues/45).
The supported one-way pipeline executes twice, but manufacturing qualification
is blocked by a thickness conversion conflict and four source copper-to-NPTH
clearance errors. Expected partial routing is **not** the reason for BLOCKED.
No C4C / G0A adoption decision is made.

## Scope, baseline and environment

Before changes, HEAD, merge-base with main, local main and live GitHub main
were all `d085e540aefc76e2dd56b614b2c8141f42facbe9`; the working tree was clean.
Issue #45 was read completely, with zero comments, along with the historical
[C4B report](EDA-002C4B.md) and its evidence. Branch:
`eda-002c4b2-headless-kicad-cam`.

Python 3.14.2; **JITX 4.4.3 / jitxlib-standard 4.4.0 / runtime 4.4.2**.
Locked sync succeeds without dependency changes. Existing image
`kicad/kicad:9.0.9` executes `kicad-cli version` and reports **9.0.9**;
local image ID is
`sha256:e638b79b0321f29395a5b783e94bb9f3c73303e8da15da27b8f5cb4b67a37729`.
No image pull, package/runtime upgrade or autorouter was used.

JITX is the sole design authority for this disposable qualification fixture.
The frozen tscircuit oracle and D-014/D-015 retain their historical roles.
The accepted source, C0–C3 and historical C4B report/evidence remain unchanged.
Generated KiCad files are read-only downstream inputs, never manually edited,
repaired or round-tripped. No Main/Wing, G0B, complete routing, ordering or
production adoption work was performed.

## Reproduction

Run from the repository root, with Docker and the existing licensed runtime
available. These commands use the existing locked environment:

```bash
cd hardware/jitx
UV_CACHE_DIR=/tmp/eda-c4b2-uv-cache uv sync --locked --group dev
source .venv/bin/activate
jitx auth show
jitx runtime start --background
python -m physical.reproduce_c4b2
python -m physical.qualify_c4b2
python -m physical.compare_c4b2
python -m unittest discover -v
ruff check he_piantor_42_jitx physical parity tests
ruff format --check he_piantor_42_jitx physical parity tests
python -m compileall -q he_piantor_42_jitx physical parity tests
cd ../..
node --check task/data/project-status.js
git diff --check
```

The reproducer restarts runtime 4.4.2, removes only the ignored generated
qualification design directory and the corresponding `designs/c4b2/run-N`,
then builds, captures and exports sequentially for N=1 and N=2. Historical
C4B evidence is never regenerated. Each run is independent of GUI/cache state
for this fixture. Original C4B source/config hashes are verified against its
manifest before and after generation. The read-only reconciliation was
implemented after generation and its final source hashes are separately
recorded in the determinism evidence.

The underlying commands for each run are:

```bash
DESIGN=he_piantor_42_jitx.physical_qualification.M1FourKeyPhysicalQualification
RUN="$PWD/designs/c4b2/run-1" # use run-2 for the second fresh generation
jitx runtime stop
# The Python reproducer deletes only this fixture's ignored generated directory.
jitx runtime start --background
jitx design build "$DESIGN" --no-dependency-check
jitx design export physical-qualification "$DESIGN" --output "$RUN"
jitx design export legacy-kicad "$DESIGN"
# The reproducer copies the unmodified kicad export tree into $RUN/kicad.
# Invoke each command with this identical Docker prefix:
docker run --rm --user "$(id -u):$(id -g)" \
  -v "$RUN/kicad:/input:ro" -v "$RUN/cam:/out" kicad/kicad:9.0.9 \
  kicad-cli pcb drc --format json --severity-all --exit-code-violations \
  --output /out/drc.json "/input/$DESIGN.kicad_pcb"
# With the same Docker prefix, replace the kicad-cli arguments with:
kicad-cli pcb export gerbers \
  --layers F.Cu,B.Cu,F.Mask,B.Mask,F.Paste,B.Paste,F.SilkS,B.SilkS,Edge.Cuts \
  --output /out/gerber/ "/input/$DESIGN.kicad_pcb"
kicad-cli pcb export drill --format excellon --excellon-units mm \
  --excellon-separate-th --generate-report --report-path /out/drill-report.txt \
  --output /out/drill/ "/input/$DESIGN.kicad_pcb"
kicad-cli pcb export pos --format csv --units mm --side both \
  --output /out/positions.csv "/input/$DESIGN.kicad_pcb"
```

[Pipeline evidence](c4b2-evidence/pipeline.json) records every actual argv,
return code, output size/hash and source hash. DRC code 5 is accepted only as
report-producing evidence; other failing command codes stop the reproducer.
The reconciliation then interprets the findings. All CAM commands return 0;
DRC returns 5 in both runs. Hashing verifies the entire KiCad input tree is
unchanged after CAM. `--no-dependency-check` follows locked sync and does not
bypass physical validation. The official [JITX CLI](https://docs.jitx.com/en/latest/getting-started/cli/index.html)
and [KiCad 9.0.9 CLI reference](https://docs.kicad.org/9.0/en/cli/cli.html)
are the supported workflow references; installed CLI help was also checked.

## Generated-output inventory and physical reconciliation

Each run contains 59 KiCad files: PCB, schematic, project, worksheet, two
library tables, legacy symbol library and 52 footprint library files. CAM
creates nine Gerbers plus a job file, PTH/NPTH Excellon files, drill report,
68-row position CSV and JSON DRC report. Public JITX capture adds electrical
and physical observations plus BOM/PnP review CSVs. Full inventories/hashes
are in `pipeline.json`; generated packages remain ignored under `designs/`.
The two raw DRC reports, positions and drill reports are retained in the new
`c4b2-evidence/` directory as review evidence, without design authority.

[Reconciliation evidence](c4b2-evidence/reconciliation.json) records:

| Check | Result |
| --- | --- |
| Outline | Closed rectangle 80 × 60 mm; Edge.Cuts x=99.5…179.5, y=78…138 |
| Copper layers | Exactly F.Cu and B.Cu |
| Population/poses | All 68 components match historical C4B poses; all on top |
| Coordinates | PCB x=139.5+JITX x, y=108−JITX y; footprint angles retain JITX CCW values |
| Pads/net identity | 228 pad/hole records match source geometry and port mappings; no net differences |
| Vias | Two H0_RAW through vias: source (31,−12)/(33,−12); 0.65 pad / 0.30 drill |
| Source routes | Six source routes represented by seven segments and one arc, with copper on both layers |
| Connectivity | Original component topology preserved; C2 comparator PASS |
| Drill | Two 0.30 mm plated via holes, four 0.60 mm plated shell slots, two 0.60 mm NPTH locators |
| Gerbers | Two copper, two mask, two paste, two legend, one outline; job inventory reconciles |
| PnP | 68 rows; x=PCB x, y=−PCB y, rotations agree; fixture origins, no supplier qualification |

The comparison uses public JITX `TestCase`, `visit`, PadMapping and documented
Component default port-to-pad ordering; it reads the downstream S-expression
without modifying it. Analytic source circle radii are used rather than coarse
display polygons. Other pad geometry agrees within 0.001 mm. Existing C4B route
WKT uses public `ShapelyGeometry.from_shape`'s documented 0.01 mm arc approximation;
observed maximum Hausdorff differences are 0.00218518 mm top / 0.000120454 mm
bottom. These are bounded observer comparisons, not an exact arc equivalence
certificate. The fresh physical/electrical/PnP captures also match historical
C4B hashes exactly. Two extra mask-only SMD records represent the NPTH mask
openings, not new components or connected copper.

The Gerber job's function vocabulary uses SolderPaste/SolderMask/Profile;
individual X2 headers use Paste/Soldermask/Profile,NP. Both observed vocabularies
are explicitly reconciled. The job's 80.05 × 60.05 mm size includes the
0.05 mm outline stroke; centerline dimensions remain 80 × 60 mm.

## DRC interpretation and supported-workflow blockers

Both raw reports record **147 unconnected items, four hole-clearance errors,
and 68 library warnings**. This is not a green manufacturing DRC.

The 147 unconnected items reconcile exactly per net with source physical-pad
islands and historical endpoint accounting. Each Hall net has one missing
connection to its mux endpoint, after subtracting the realized Hall/probe path.
USB_SHIELD has three missing links between its four physical stakes, consistent
with C4B's explicit singleton physical-pad-review limitation. GND has 47,
V3V3 24, HALL_5V 12 and VBUS eight missing links; other per-net counts are
recorded in the reconciliation. Empty CC1/CC2 declarations and accepted NCs
are not converted into false routes. No unexpected net membership was found.

**Blocker 1: source clearance.** J1 contact lands A1_B12/A12_B1 have approximately
0.2001 mm copper-to-locator gaps; A4_B9/A9_B4 approximately 0.2349 mm. These
are below the unchanged fixture's 0.25 mm copper-to-hole qualification rule.
Independent source geometry agrees with KiCad's measurements. They are newly
observed source-rule conflicts, not evidence of copper lost in conversion.
Historical C4B checked pad overlap/containment but did not establish this DRC.
The accepted manufacturer model and historical evidence are preserved.

**Blocker 2: thickness conversion.** Source and exported physical stack total
1.20 mm including masks (1.17 mm excluding them), but generated PCB
`general.thickness` is 1.6 mm. KiCad's Gerber job also declares
`BoardThickness: 1.6`. A fabrication consumer could receive the wrong thickness;
this is a material supported-export discrepancy, not harmless metadata or
partial routing. No supported correction was established in this qualification.
No generated-file patch, design change, upgrade or private workaround was tried.

The 68 `lib_footprint_issues` warnings say the generated library is not included
in the current configuration, despite a generated table and `.pretty` tree
being present. An additional supported invocation with Docker working directory
`/input` returns the same findings. Board-embedded geometry/net mapping checks
pass; library registration/checking remains a limitation. No manual library
repair was performed. There are no additional track, via, board-outline or
copper-clearance findings in these reports. DRC is subject to the generated
project's rules; this does not prove every JITX fabrication field transfers.

## Two-run determinism

[Determinism evidence](c4b2-evidence/determinism.json) accounts for all 86 run
files: 68 byte-identical; 12 differ only in verified timestamp fields; two
copper Gerbers differ in timestamps and ordering of the same two via flashes;
one PCB differs in via record order/IDs; two schematic companion files differ;
one runtime log differs in PID/socket URI. No archive is used in this pipeline.

Every raw difference is retained in
[two-run-differences.json](c4b2-evidence/two-run-differences.json), a read-only diff
that is never applied. No nondeterminism is hidden. PCB comparison preserves
scalar coordinates and polygon/stack/layer sequence, removes only UUID/tstamp
and numeric net aliases, and compares unordered property/object records.
Gerber comparison removes only the two creation-time fields and sorts only
consecutive absolute-coordinate D03 flashes with identical surrounding modal
state. It never sorts paths, apertures, attributes or polarity commands.

**No manufacturing-significant difference was found in this pair:** geometry,
net identity, layer content, drilling and assembly coordinates repeat. The
thickness error repeats too. Position CSVs are byte-identical; drill commands,
tool diameters and coordinates are identical after removing creation times.
DRC differs only in its date. Schematic symbol allocation/presentation and
legacy symbol-library content vary substantially; their semantic equivalence
is unqualified and out of scope for this PCB-fed CAM path. This is a two-run
observation, not a general determinism guarantee.

## Verdict dimensions, validation and PMO input

| Dimension | Conclusion |
| --- | --- |
| A — JITX → KiCad usable? | Usable for disposable downstream validation/plotting; manufacturing conversion fidelity is BLOCKED by thickness |
| B — missing DRC/unrouted validation? | Demonstrated: machine-readable DRC detects the known partial state and additional source clearance conflicts |
| C — Gerber/Excellon/PnP generation? | Demonstrated twice; outputs remain unqualified for manufacturing because of the material findings |
| D — full-routing limitation independent? | Yes; pipeline needs no extra routing and its known unrouted findings are reconciled; complete source routing remains open |

Validation: locked sync; two non-dry physical builds and legacy exports;
two headless DRC/Gerber/Excellon/PnP runs; all 20 unchanged C0/C1/C2 regressions;
read-only source/geometry/connectivity/CAM reconciliation; hash consistency;
45-file ruff format/lint; Python compilation; Dashboard syntax and whitespace
checks. CI scope changes no layout, existing KiCad product, firmware or workflow
paths, so those engineering jobs are inapplicable under the unchanged workflow's
path classifier. Draft PR CI results are recorded in `validation.json`.

Task acceptance: supported pipeline execution and narrow reconciliation are
accepted as qualification evidence; manufacturing qualification **BLOCKED**.
Public API review found no private calls, source-design changes, generated-file
writes or unsupported repair. Static type checking is unavailable in the existing
environment and was not installed. Sourcing, assembly filtering, supplier
zero-angle conventions and full source routing remain independent limitations.
PMO should review these findings before PO MERGE/HOLD. C4C / G0A remains a
later Human Gate; G0B remains not-ready and EVT-002 unstarted. Do not merge
this Draft PR automatically.
