ihsinoky/he-piantor-42/hardware/jitx/geometry/EDA-002C3.md

# EDA-002C3 geometry reconciliation decision package

Issue: [#39](https://github.com/ihsinoky/he-piantor-42/issues/39). Research date:
2026-10-03; completed 2026-10-04. **Evidence package prepared; Human Gate OPEN. No component has
an approved geometry decision. No geometry implementation is authorized.**

Electrical parity remains **PASS**. Geometry parity is **NOT established**.
EVT-002 remains blocked; D-014 and JITX challenger status are unchanged.
This report recommends correcting HRO to its exact manufacturer PCB layout
after approval, and deferring Winbond land selection until the assembly-policy
and coordinate-view questions below are resolved. The frozen project geometry
remains the baseline until PMO / Product Owner explicitly decides otherwise.

## Checkout and authority

Initial working tree was clean. Branch was and remains
`eda-002c3-jitx-geometry-reconciliation`; HEAD, merge base with the expected
baseline, and local `origin/main` were all
`67b6c3026b9931883b5699f0cecd73ea79996676`, PR #38 squash merge. No AGENTS.md
was found. Issue #39 was created before geometry research or repository edits.

| Tier | Authority | Application here |
| --- | --- | --- |
| 1 | Exact manufacturer's recommended PCB layout, package drawing and exact ordering code | HRO exact M-12 layout; Winbond exact UX mechanical outline and UXIQ ordering |
| 2 | Explicit, reviewable package-rule / IPC derivation | Installed JITX SON density-C computation using Winbond tolerances; a design derivation, not manufacturer-approved lands |
| 3 | Project-owned frozen tscircuit M1 geometry | Current project baseline; stronger evidence can support a proposed correction, subject to the Human Gate |
| 4 | Distributor/community footprints and metadata | Corroboration only; none was needed to decide the findings in this report |

No `hardware/layout/**` content was consumed. No distributor footprint was
downloaded. C1 descriptions were used to locate sources, not treated as proof.

Classification is per feature: IDENTICAL means the same dimension;
TOLERANCE_EQUIVALENT means a nominal difference fits an explicitly stated
drawing tolerance, or numerical rounding fits the frozen verifier's 0.001 mm
comparison threshold, without claiming full fit or manufacturing acceptance;
PROJECT_DESIGN_CHOICE means a defensible land-design alternative requires
explicit approval; FROZEN_BASELINE_ERROR means the frozen claim of an exact
manufacturer layout is contradicted by stronger evidence;
SOURCE_AMBIGUITY means the available evidence does not settle the comparison.

## Reopened primary sources and reproducibility

Both official landing pages and their actual PDF links were freshly fetched
with curl and a browser user-agent; HRO also required its official-page referer.
The web reader failed for these URLs, but direct downloads succeeded. Each file
has a PDF signature and was opened with an isolated PyMuPDF reader in `/tmp`.
No project dependency or lockfile was changed. Fresh PDFs also match the C1
cache byte-for-byte by SHA-256; fresh HRO page 4 and Winbond PDF pages 68, 73,
74 were rendered and inspected independently. The identical C1 page-6 render
was used to inspect Winbond's printed-page-5 top-view pin map.

| Source | Exact selection | SHA-256 of downloaded PDF |
| --- | --- | --- |
| [HRO official product page](https://en.krhro.com/Product-Details/726.html) → [family PDF](https://omo-oss-file110.thefastfile.com/portal-saas/pg2026081913505947704/cms/file/type-c-31-m-12%2612a%2612b%2612c%281%29.pdf) | Four-page family; PDF page 4; PART NO. TYPE-C-31-M-12; 2020.12.08; sheet 1 of 1. M-12A/B/C excluded. | `1c23b78973c56e8dd83f1b46b8c31226f31ba0ea136ce3babd9f80bbaf2e7345` |
| [Winbond official index](https://www.winbond.com/hq/support/documentation/levelOne.jsp?__locale=en&DocNo=DA00-W25Q16JV.1) → [Rev J PDF](https://www.winbond.com/resource-files/W25Q16JV%20SPI%20RevJ%2005202026%20Plus.pdf) | May 28, 2026; 77 PDF pages. Printed p. 67 = PDF p. 68; printed pp. 72–73 = PDF pp. 73–74. | `0a7d2859578bdf11ca5519d444c11cdc790fcbe6921989689b9c1ae4599780ef` |

HRO HTML `pdfPreview` and hidden `modelSrc` identify the family PDF; Winbond
HTML `productUrl` identifies the Rev J PDF. PDFs remain outside tracked source;
the links, hashes, page identities and factual transcription here permit review
without publishing full manufacturer documents.

`capture_geometry.py` records actual public JITX pad shapes/transforms, frozen
HRO and Winbond source values, the limited other-seven audit, installed package
versions, generator hashes and project input hashes. It uses the public JITX
TestCase inspection context and creates
no board, placement or routing. Run from `hardware/jitx`:

```sh
PYTHONPATH=. .venv/bin/python geometry/capture_geometry.py > /tmp/c3-observation.json
cmp geometry/evidence/geometry-observation.json /tmp/c3-observation.json
```

The checked-in observation is deterministic across two runs. Frozen Winbond
values below are transcribed from `m1-four-key.tsx:23` and cross-checked against
the unchanged verifier's `flashGeometry` check. Dimensions below are mm.

## HRO: independent layout transcription

The exact drawing explicitly defines a recommended component-side PCB layout.
Its local PCB tolerance is ±0.05, taking precedence over the general title-block
mechanical tolerances for this layout. Copper, drills, and contacts must be read
from that layout, not the adjacent component mechanical views.

Choose origin at the midpoint of locating holes, x rightward, y toward the
contact row. This is the accepted JITX model's frame. To express frozen local
values in that comparison frame use `x = frozen pcbX`,
`y = -(frozen pcbY + 2.60)`. This reflection normalizes the row direction
for dimension comparison; it is **not** an implemented placement transform or
proof that labeled physical orientation matches between tools.

The layout gives opposing center spans 6.40 (outer wide contacts), 4.80
(inner wide contacts), 3.50 and 2.50 (signal contacts), and 0.50 signal pitch.
Divide symmetric spans by two and continue the pitch inward to obtain the
following full contact inventory. Each row's manufacturer/JITX y is 1.07;
each frozen normalized y is 1.445.

| Contact, left to right in layout | Manufacturer x | Frozen x | Manufacturer / frozen width | Classification of x |
| --- | ---: | ---: | --- | --- |
| A1/B12 | -3.20 | -3.25 | 0.60 / 0.60 | FROZEN_BASELINE_ERROR (6.40 span becomes 6.50) |
| A4/B9 | -2.40 | -2.45 | 0.60 / 0.60 | FROZEN_BASELINE_ERROR (4.80 span becomes 4.90) |
| B8 | -1.75 | -1.75 | 0.30 / 0.30 | IDENTICAL |
| A5 | -1.25 | -1.25 | 0.30 / 0.30 | IDENTICAL |
| B7 | -0.75 | -0.75 | 0.30 / 0.30 | IDENTICAL |
| A6 | -0.25 | -0.25 | 0.30 / 0.30 | IDENTICAL |
| A7 | 0.25 | 0.25 | 0.30 / 0.30 | IDENTICAL |
| B6 | 0.75 | 0.75 | 0.30 / 0.30 | IDENTICAL |
| A8 | 1.25 | 1.25 | 0.30 / 0.30 | IDENTICAL |
| B5 | 1.75 | 1.75 | 0.30 / 0.30 | IDENTICAL |
| A9/B4 (drawing B4/A9) | 2.40 | 2.45 | 0.60 / 0.60 | FROZEN_BASELINE_ERROR (paired span) |
| A12/B1 (drawing B1/A12) | 3.20 | 3.25 | 0.60 / 0.60 | FROZEN_BASELINE_ERROR (paired span) |

All individual widths and the 0.50 signal pitch are IDENTICAL. Although each
wide center shifts only 0.05, the drawing dimensions **opposing spans**;
the frozen spans deviate by 0.10, exceeding the layout's 0.05 tolerance. It is
therefore inappropriate to declare the entire contact row tolerance-equivalent.

The drawing's contact upper edge is y=1.64, lower edge y=0.50 from the locator
line. Thus length is `1.64 - 0.50 = 1.14`, and center is
`(1.64 + 0.50)/2 = 1.07`. The 0.50 also locates the upper shell centerline.
The upper-to-lower shell center separation is 4.18, giving lower y=-3.68.
PCB edge is 5.79 below the contact upper edge, so y=`1.64-5.79=-4.15`.
These are dimension-line derivations, not pixel measurements.

| Feature | Exact recommended layout / observed JITX | Frozen normalized geometry | Classification and reason |
| --- | --- | --- | --- |
| Contact length, all 12 | 1.14 | 1.45 | FROZEN_BASELINE_ERROR: +0.31, no documented alternate land rationale |
| Contact-row center above locator | 1.07 | 1.445 = -(-4.045+2.60) | FROZEN_BASELINE_ERROR: +0.375 |
| Contact lower / upper edge | 0.50 / 1.64 | 0.720 / 2.170 | FROZEN_BASELINE_ERROR: derived edges differ by +0.220 / +0.530 |
| Locator drill diameter | 0.60 | 0.65 | TOLERANCE_EQUIVALENT: at +0.05 boundary; this is not an established intentional clearance choice |
| Locator centers and separation | (-2.89,0), (2.89,0); 5.78 | same after datum normalization | IDENTICAL |
| Upper shell centers | (-4.325,0.50), (4.325,0.50) | (-4.32,0.53), (4.32,0.53) | TOLERANCE_EQUIVALENT: x ±0.005 and y +0.03 |
| Lower shell centers | (-4.325,-3.68), (4.325,-3.68) | (-4.32,-3.65), (4.32,-3.65) | TOLERANCE_EQUIVALENT: same center offsets |
| Shell horizontal center span | 8.65 | 8.64 | TOLERANCE_EQUIVALENT: -0.01; 8.64 is also shown in the mechanical view, not the PCB layout |
| Shell row separation | 4.18 | 4.18 | IDENTICAL |
| Upper shell copper, width × overall length | 0.90 × 2.00 | 1.00 × 2.10 | PROJECT_DESIGN_CHOICE candidate: enlarged copper might improve joint margin, but is not the recommended layout and has no documented clearance review |
| Upper shell slot, width × overall length | 0.60 × 1.70 | 0.60 × 1.70 | IDENTICAL |
| Lower shell copper | 0.90 × 1.70 | 1.00 × 1.60 | PROJECT_DESIGN_CHOICE candidate: wider but shorter copper; no documented solder-joint justification |
| Lower shell slot | 0.60 × 1.40 | 0.60 × 1.20 | FROZEN_BASELINE_ERROR: 0.20 shorter; slot clearance cannot be justified by copper-area preference |
| PCB edge from locator | -4.15 | no explicit edge in this footprint | SOURCE_AMBIGUITY: cannot compare an absent edge datum |
| Body envelope | 8.94 width × 7.35 depth in mechanical view | no explicit corresponding envelope in the footprint | SOURCE_AMBIGUITY: package outline is not a board-edge definition |

The shell widths 0.90 copper and 0.60 slot are shown at the lower stake and
apply to the corresponding upper shape as well; upper vertical lengths are
2.00/1.70, lower lengths 1.70/1.40. All four are vertical capsule/oval shapes;
these lengths include the rounded ends, not just the straight portion.
The fresh JITX observation matches the transcribed nominal layout for every
contact, shell land/drill and locator. Body/edge values are documentary datums;
the accepted JITX footprint itself has no explicit board outline.

**Agent recommendation: ADOPT_MANUFACTURER. PMO decision: PENDING.** Tier 1 is
explicit and exact-part. There is no demonstrated technical reason to retain
the whole frozen footprint: possible reasons for enlarged shell copper or hole
clearance do not explain shifted contacts, excessive contact length, or the
shortened lower slots. The frozen source's comment calling it a manufacturer
recommended pattern is inconsistent with these values. PMO may authorize a
future correction, or request exact-part manufacturer clarification / explicit
assembly evidence for exceptions. This report makes neither change.

**Human Gate question:** Does the exact manufacturer document define a
recommended PCB layout strongly enough that retaining the frozen geometry has
no defensible engineering basis? **Answer:** yes for retaining the complete
frozen footprint without additional evidence. The exact M-12 recommendation
is explicit. Individual copper/clearance exceptions could be defensible with
documented assembly and tolerance analysis, but no such basis was found for the
complete footprint or its shortened lower slots and shifted contact row.

Risks below are engineering consequences to review, not observed assembly
failures or quantified failure probabilities:

| Risk of retaining an unsupported layout | Evidence-linked mechanism |
| --- | --- |
| Assembly fit | A lower slot 0.20 mm shorter than recommended can prevent the shell stake seating correctly. |
| Locating-feature interference or looseness | Locator-to-contact and locator-to-shell datums must work together. The 0.65 mm hole is larger, not intrinsically an interference condition; loose registration can let the connector shift, while conflicting stake/locator tolerances can prevent seating. |
| Solderability | The 0.375 mm row-datum shift and changed contact lengths can change terminal overlap, solder volume and joint formation. More copper alone does not prove better joints. |
| Shell retention | Changed shell copper and slot lengths alter the soldered retention structure and may leave stakes incompletely seated. |
| Insertion and mechanical stress | Mis-seating or insufficient retention can transfer cable insertion/extraction loads into contact joints or the PCB instead of the intended shell support. |
| Tolerance stack-up | A nominal dimension at the drawing tolerance boundary is not a fabrication target with remaining process margin. Hole finish, staking variation, placement and PCB-edge registration require a combined analysis. |

## Winbond: package evidence versus land-design evidence

Printed pp. 72–73 explicitly associate **W25Q16JVUXIQ** with package **UX**,
USON-8 2 × 3 × 0.6 maximum. I is industrial temperature; Q is the option
suffix. The selected mechanical drawing is section 11.3, printed p. 67,
not UU, XG, ZP or an SOIC package. Relevant exact UX table values are:

| Symbol / meaning | Minimum | Nominal | Maximum |
| --- | ---: | ---: | ---: |
| D, span direction body dimension | 2.90 | 3.00 | 3.10 |
| E, dimension along the four-pad rows | 1.90 | 2.00 | 2.10 |
| A, height | 0.50 | 0.55 | 0.60 |
| b, terminal width | 0.20 | 0.25 | 0.30 |
| L, terminal length | 0.40 | 0.45 | 0.50 |
| D1, central exposed metal width | 0.15 | 0.20 | 0.25 |
| E1, central exposed metal length | 1.55 | 1.60 | 1.65 |
| e, row pitch | 0.50 BSC | 0.50 BSC | 0.50 BSC |

The supplied drawing describes **metal terminals and package**, not PCB copper
or paste. Inspection of the complete PDF and searches for PCB/layout/footprint
did not locate a UX recommended land drawing. No additional exact UX
manufacturer application land guide was located in the official source trail;
this is not a claim that none can exist. Notes about central-pad connection and
exposed PCB vias on other WSON drawings must not be transferred automatically
to UX. EP remains electrically unchanged and intentionally unconnected here.

### Reviewable JITX density-C derivation

Actual installed versions are JITX 4.4.3 and jitxlib-standard 4.4.0, unchanged.
`SONLead` selects `SmallOutlineNoLeads`; its C fillets are toe=0.20,
heel=0, side=-0.04, courtyard excess=0.10. `compute_ipc` implements an
IPC-7351B-based formula with fabrication tolerance F=0 and placement accuracy
P=0. This is a disclosed tool approximation. The IPC text was not independently
licensed/read; this report verifies the installed implementation and numerical
derivation, not full compliance with every IPC requirement. Generator file
hashes are in `evidence/geometry-observation.json`.

Use lead span 2.90–3.10, length 0.40–0.50, width 0.20–0.30:

```text
CL = 3.10 - 2.90 = 0.20
CT = 0.50 - 0.40 = 0.10
CW = 0.30 - 0.20 = 0.10
Smax = 3.10 - 2*0.40 = 2.30
CS = sqrt(CL² + CT²) = 0.223606797749979
Z = 2.90 + 2*0.20 + CL = 3.50
G = Smax - 2*0 - CS = 2.076393202250021
X = 0.20 + 2*(-0.04) + CW = 0.22
land length = (Z-G)/2 = 0.711803398874990
column center span = G + land length = 2.788196601125010
column centers = ±1.394098300562505
```

The eight public JITX pad observations reproduce these results. Central copper
0.20 × 1.60 is explicitly requested by the component model from nominal
D1/E1, **not** calculated by the signal-land IPC formula. Nominal metal size
alone does not validate PCB soldermask, paste, assembly tolerance or stencil
coverage. Density C is also a design-policy choice, not a manufacturer mandate.

| Feature | Tier 1 package / JITX derived lands | Frozen lands | Classification |
| --- | --- | --- | --- |
| Exact part, UX package and eight signal positions + central metal | established / retained | retained | IDENTICAL inventory and identity; not a dimension verdict |
| Signal land length | package L=0.40–0.50; JITX 0.711803399 | 0.8128 | PROJECT_DESIGN_CHOICE: both are PCB lands longer than the terminals; package L does not mandate either |
| Signal land width | package b=0.20–0.30; JITX 0.22 | 0.254 | PROJECT_DESIGN_CHOICE: neither value is the manufacturer's specified PCB width |
| Column center span | derived JITX 2.788196601 | 2.8956 | PROJECT_DESIGN_CHOICE: +0.107403399 in frozen; package D is not a copper center span |
| Signal row pitch | 0.50 BSC / JITX 0.50 | approximately 0.50 (0.500001 outer interval) | TOLERANCE_EQUIVALENT: numerical rounding ≤0.000001 per outer interval, not exact BSC equality |
| Total first-to-fourth row center span | JITX 1.50 | 1.500002 | TOLERANCE_EQUIVALENT: 0.000002 numerical rounding |
| Central land width × length | package nominal 0.20 × 1.60; JITX same | 0.254 × 1.651 | PROJECT_DESIGN_CHOICE: frozen exceeds nominal by 0.054 × 0.051; do not compare copper size to metal tolerance as a pass/fail test |
| Pin-numbered coordinate handedness | manufacturer top view; JITX pin 1 at (-1.3940983,+0.75) | frozen pin 1 at (-1.4478,-0.750001) | SOURCE_AMBIGUITY across tool views; raw local coordinates reverse y order and require explicit view reconciliation before geometry acceptance |

For an additional dimensional cross-check, frozen outside copper span is
`2.8956+0.8128=3.7084`; inner gap is `2.8956-0.8128=2.0828`.
Compared with the JITX 3.50 outside span and 2.076393202 inner gap, frozen lands
mainly add outer extension. This can be an intentional assembly choice, but no
reviewable assembly derivation accompanies the frozen values in the permitted
source. Their inch-like values are not evidence of manufacturer approval.

### Frozen Winbond provenance and exact evidence still needed

The unchanged verifier, `verify-m1-electrical.tsx:40`, names the vendored
**Keebio `USON-8_UX_2x3x0p6_WIN`** as geometry provenance. The native TSX
transcription entered in PR #27, commit `795479e`; it is project-owned Tier 3
geometry. `hardware/lib/THIRD_PARTY.md` identifies upstream
[Keebio-Parts.pretty](https://github.com/keebio/Keebio-Parts.pretty), the MIT
license and the verbatim vendored asset. Its baseline Git blob is
`a8d20d514acc922c04199154de73d22ea76d58f9`; it entered the repository in
`cabdde34c7a5127fc697e46bb05d47d082163d2a`. This establishes community
provenance (Tier 4), **not** a manufacturer-approved land pattern or an IPC
derivation. The inventory does not identify an exact upstream revision for
Keebio or explain its copper/paste rationale. No `hardware/layout/**` content
was read; this provenance comes from the native verifier and redistribution
metadata, not from GPL-derived geometry.

No exact official UX PCB land guidance was found in the already reviewed
Winbond index and complete Rev J datasheet. Manufacturer **PACKAGE METAL**
geometry is not manufacturer-recommended **PCB LAND** geometry. Differences
between frozen and generated copper therefore remain PROJECT_DESIGN_CHOICE,
with a separate SOURCE_AMBIGUITY for physical view mapping.

To choose KEEP_FROZEN versus ADOPT_IPC_GENERATED, the following evidence is
still required:

1. For KEEP_FROZEN: document how Keebio's 0.8128 × 0.254 signal lands,
   2.8956 column span and 0.254 × 1.651 central land were derived, or supply an
   independent design calculation and assembly justification for those values.
   Trace the upstream revision if relying on upstream design rationale.
2. For ADOPT_IPC_GENERATED: independently review the exact UX tolerance inputs,
   SON lead form, density selection and fillet rules; specify fabrication and
   placement accuracy and assess the current F=P=0 simplification. The recorded
   installed-tool calculation is reproducible but does not independently
   qualify those assumptions.
3. For either: resolve top/bottom view, axis direction, layer and pin-1 mapping
   with a labeled copper overlay or signed coordinate comparison; an unlabeled
   reflection is insufficient to prove physical pad-number parity.
4. For either: document copper, soldermask and paste openings, central-land
   solder coverage/stencil rationale, and its treatment across D1/E1 tolerance.
   Preserve EP's existing electrical disposition; this gate authorizes no net
   change. Explicitly compare the two candidates against assembly capability.

The coordinate-view observation is separate from pad size. JITX pins 1–4 have
y `[+0.75,+0.25,-0.25,-0.75]`, while frozen pins 1–4 have approximately the
opposite signs; pins 5–8 likewise reverse. A reflection can normalize these
lists for size comparisons, but a reflection is not an in-plane component
rotation. Confirm tscircuit's top/bottom-view and y-axis conventions against
the manufacturer's top-view numbering before accepting either full physical
mapping. C2's graph-only PASS does not answer that physical question.

**Agent recommendation: NEED_MORE_EVIDENCE. PMO decision: PENDING.**
Retain the frozen baseline administratively while the gate is open. There is
insufficient Tier 1 evidence to call the frozen land dimensions an error or
call the JITX lands manufacturer-approved. Request exact UX land guidance if
available; otherwise choose and document a package-rule derivation with explicit
density, fabrication/placement tolerances, central-land/paste policy and view
mapping. PMO can choose the existing C derivation only by consciously accepting
its assumptions; C1 component-model acceptance alone is not that decision.

## Limited audit of the other seven accepted components

This is a limited comparison of accepted C1 models, source-manifest/completion
records and the unchanged native frozen model. C1 source investigation was not
repeated. A fresh native `m1:verify` run provided generated copper sizes; JITX
public pad inspection provided the accepted models' sizes. Dimensions are
width × length normalized for rotation; this audit does not certify labeled
orientation, paste or full geometry parity. The generated Circuit JSON is not
committed. `geometry-reconciliation.json` records these observations and the
audit outcomes; the accepted models are unchanged.

| Part | Frozen / accepted JITX observations (mm) | Audit classification | Human Gate implication |
| --- | --- | --- | --- |
| RP2040 | Frozen generic QFN lands: 0.875 × 0.25 on all sides; central 5.45 × 5.45. C1 exact recommended layout: left/right 0.875 × 0.20, top/bottom 1.175 × 0.20, central 3.20 × 3.20. | NEW_DISCREPANCY | Material exact-manufacturer-layout discrepancy, newly recorded by C3. Add RP2040 to the gate; recommendation ADOPT_MANUFACTURER, decision PENDING. |
| USBLC6-2SC6 | Frozen stock sot23_6: 1.00 × 0.60; accepted explicit density-C derivation: 0.95 × 0.42. | NEW_DISCREPANCY | Different derived lands, PROJECT_DESIGN_CHOICE; assembly significance needs review, not an automatic manufacturer error. NEED_MORE_EVIDENCE / PENDING. |
| ABM8-272-T3 | Both four 1.30 × 1.05 lands at 2.30 × 1.75 physical pitch. | NO_KNOWN_BLOCKER | No new dimensional blocker. Pin-numbered view/orientation is not certified by this size audit; retain existing C1 bottom-view record. |
| AP2112K-3.3TRG1 | Frozen stock sot23_5: 1.325 × 0.60; accepted derived: 1.191421356 × 0.16. | NEW_DISCREPANCY | Significant width difference; review exact-package land guidance and default density/fillet assumptions. PROJECT_DESIGN_CHOICE, NEED_MORE_EVIDENCE / PENDING. |
| TPS22919DCKR | Frozen stock sot363: 1.03 × 0.35; accepted DCK-derived: 1.276227766 × 0.26. | NEW_DISCREPANCY | Different derived lands; confirm exact DCK fit and assembly rationale. PROJECT_DESIGN_CHOICE, NEED_MORE_EVIDENCE / PENDING. |
| TMUX1208PWR | Frozen stock tssop16_p0.65mm: 1.45 × 0.30; accepted PW-derived: 1.435849528 × 0.36. | NEW_DISCREPANCY | Different derived lands; PROJECT_DESIGN_CHOICE pending significance/derivation review. NEED_MORE_EVIDENCE / PENDING. |
| DRV5055A3QDBZR | Frozen native HallKey sensor lands: 1.475 × 0.60; accepted DBZ-derived: 1.308868904 × 0.46. | NEW_DISCREPANCY | Sensor copper differs: PROJECT_DESIGN_CHOICE, NEED_MORE_EVIDENCE / PENDING. Frozen switch NPTHs, GND PTH and keepouts belong to the HallKey assembly fixture and are NOT_COMPARABLE / NOT_IN_FROZEN_GEOMETRY_SCOPE for the standalone manufacturer sensor model. |

Six newly recorded dimensional discrepancies are not six proven assembly
failures. RP2040 directly conflicts with an exact recommended manufacturer
layout already established in C1; the other five compare stock/project lands
with package-based derivations and require an explicit design choice. None is
fixed here, and no full audit of those five derivations is claimed.

## Human Gate decision record — not yet approved

| Part | Evidence status | Classification | Agent recommendation | PMO decision |
| --- | --- | --- | --- | --- |
| HRO TYPE-C-31-M-12 | Exact M-12 recommended PCB layout verified | FROZEN_BASELINE_ERROR for contacts/lower slots; other feature classes detailed above | ADOPT_MANUFACTURER | PENDING |
| Winbond W25Q16JVUXIQ | Exact UX package verified; official UX land guidance not found; design/view evidence incomplete | PROJECT_DESIGN_CHOICE; view SOURCE_AMBIGUITY | NEED_MORE_EVIDENCE | PENDING |
| RP2040 | C1 exact recommended layout versus fresh frozen generic QFN observation | FROZEN_BASELINE_ERROR for central land and side geometry | ADOPT_MANUFACTURER | PENDING |
| USBLC6-2SC6; AP2112K-3.3TRG1; TPS22919DCKR; TMUX1208PWR; DRV5055A3QDBZR | Limited audit records different derived lands; materiality not qualified | PROJECT_DESIGN_CHOICE | NEED_MORE_EVIDENCE | PENDING for each part |

No selection, silence, issue creation or merge of this evidence PR implies
geometry approval. Record the approver, date, selected baseline and rationale
for every part in a future decision record. C3 is not done/accepted.

| Possible explicit PMO decision | Implementation in a separately authorized follow-up |
| --- | --- |
| HRO ADOPT_MANUFACTURER | Correct the frozen project's contacts, datums, holes and shell geometry to the exact M-12 PCB recommendation; update affected geometry assertions and comparison records explicitly. Accepted C1 HRO nominal copper/drills already match; do not change electrical semantics or D-014. Establish board-edge/view mapping before asserting physical parity. |
| HRO KEEP_FROZEN | Keep the frozen footprint and record explicit exceptions with fit, solderability, stress and tolerance evidence. Preserve JITX manufacturer geometry as a separately labeled candidate unless a further explicit approval selects a common project exception layout. |
| Winbond KEEP_FROZEN | Retain frozen copper, establish its accepted derivation and view/paste policy; only with explicit model-change approval align the challenger land implementation to the approved project choice. Never describe community lands as manufacturer-approved without new evidence. |
| Winbond ADOPT_IPC_GENERATED | Select a fully reviewed IPC derivation; if selecting current output, update the frozen lands to 0.711803399 × 0.22 at 2.788196601 span and the explicitly approved central land, with matching geometry assertions. Change the accepted model only if PMO approves different generator inputs/policies. Resolve orientation and paste first. |
| Any part NEED_MORE_EVIDENCE / DEFER | Make no geometry change; obtain the exact missing derivation, view and assembly evidence, then return to PMO. |
| RP2040 ADOPT_MANUFACTURER | Correct the frozen QFN's central land and unequal side lengths/widths to the exact accepted manufacturer layout, and explicitly update geometry assertions. Verify the full numbered-pad mapping before parity acceptance. |
| Other five ADOPT_REVIEWED_DERIVATION or KEEP_FROZEN | After part-specific evidence review, change only the explicitly authorized footprint/model and assertions to that chosen baseline, or retain existing geometry with documented exceptions. Do not infer authority from this limited audit. |

A future authorized implementation must specify precisely which file becomes
the accepted geometry baseline, preserve electrical semantics, reconcile
physical views and labeled pads, update geometry assertions explicitly, and
verify the resulting footprint against the chosen evidence. That is a separate
task. This package neither changes D-014 nor unblocks EVT-002, and it authorizes
no placement/routing, DRC, manufacturing preparation or dependency change.

## Validation and limits

- Fresh source-link retrieval, PDF signature/page verification and hash checks
  succeeded; source values were independently transcribed from drawings.
- Actual accepted HRO and Winbond component geometry was captured without a
  runtime build; repeated observations are identical.
- `npm --prefix hardware/tscircuit run m1:verify`: fresh native verification
  PASS, all 22 checks, zero Circuit JSON errors; no generated artifacts committed.
- Existing offline component tests: 11 PASS across remaining-components,
  Abracon, AP2112 and TI test modules; no live export required.
- Existing C2 comparator rerun on `parity/evidence/m1-runtime-graph.json`:
  PASS, 68 components, 200 endpoints, 43 nets, 185 edges, four direct links,
  seven intentional NCs; no differences. This rechecks stored C2 runtime
  evidence, not a new runtime export.
- An attempted live electrical regression could not export: the CLI found on
  PATH did not expose `m1-electrical-graph`. No exporter/dependency alteration
  was made to accommodate this. This is a verification-environment limitation,
  not a new electrical failure; fresh live runtime parity is not claimed.
  Per the C3 acceptance boundary, no fresh electrical export is required when
  unchanged C2 code, stored-evidence PASS and protected comparisons pass. This
  limitation is not a C3 blocker; no repair, dependency or runtime update was attempted.
- The new observer passes ruff formatting/lint checks. `git diff --check` and
  a changed-path allowlist cover the new `geometry/` evidence directory and the
  five necessary status/read-model documents. All protected source/models, normalization/parity code,
  `hardware/layout/**`, D-014, dependency manifests and `uv.lock` are unchanged.
- Dashboard `node --check task/data/project-status.js`: PASS. Machine-readable
  records parse, use the allowed classifications and keep every PMO decision
  PENDING. Detailed commands and protected hashes are in `evidence/validation.json`.

Protected verification covers 48 tracked source/evidence/test/dependency files
by byte equality against `67b6c302`, plus an unchanged tracked diff for
`hardware/layout/**` without reading its content. The existing runtime symlink
still targets 4.4.2; no runtime update was performed. D-014's decision document
is byte-identical, and the synchronized status files retain tscircuit authority.

Research does not establish mechanical fit, solder-joint qualification,
manufacturing readiness or full geometry parity. The pending gate is a product
decision supported by this evidence, not an implementation approval.
