ihsinoky/he-piantor-42/hardware/jitx/parity/EDA-002C2.md

# EDA-002C2 electrical parity evidence and review

Issue: [#37](https://github.com/ihsinoky/he-piantor-42/issues/37).
Baseline: a27fc48a2a8a44fcc7359e44b7fabcfb563788de, merged PR #36.
Branch: `eda-002c2-jitx-electrical-parity`.
Status: done / accepted candidate, electrical graph parity PASS; PMO review waiting.

## Actual built graph result

| Compared fact | Count | Result |
| --- | ---: | --- |
| Component instances | 68 | PASS: each frozen reference exactly once |
| Normalized semantic endpoints | 200 | PASS: exact inventories |
| Named nets | 43 | PASS: declarations and runtime resolution |
| Endpoint/net edges | 185 | PASS: exact memberships, including no extra edges |
| Direct endpoint links | 4 | PASS: same resolved connectivity, exact groups |
| Intentional NCs | 7 | PASS: all electrically unconnected |
| Additional physical RP2040 GPIOs | 23 | PASS: explicit inventory, all unconnected |
| Resistors / capacitors | 10 / 25 | PASS: frozen electrical values |
| Manufacturer models / instances | 9 / 12 | PASS: approved classes, MPN/JLC identities |
| RP2040 frozen physical assignments | 34 | PASS: actual public pad mappings |

`evidence/m1-runtime-graph.json` is actual `Export.submitted(RuntimeDesign)`
output. `evidence/m1-electrical-graph.json` is its explicit normalization;
`evidence/m1-parity-result.json` is the comparator verdict. These are project
exporter outputs, not parsed backend artifacts or Python source inspection.
Source filenames and structural paths are identities, not source-text proof.

The C0 plugin and test are preserved. C2 subclasses its electrical capture and
overrides export to exclude captured geometry. At submission, runtime resolved
net names are unset. Each public named Net declaration and each component Port
resolves through `nets().find()` to the same runtime connectivity object; this
relation supplies the name-to-membership association. No membership-based name
guessing occurs. Empty CC1/CC2 declarations and the separate unnamed CC links
match the actual golden source and frozen contract. Named-net shorts fail.

## Explicit normalization

All 68 component paths and all 200 endpoint aliases are explicit in
`m1-normalization.json`, including identity mappings. The mapping never feeds
the JITX assembly. All aliases, passive groups and extra endpoint inventories
are audited against project-owned frozen M1 evidence; there is no fuzzy matching.
Unknown, missing, duplicated or overlapping endpoints fail closed. Endpoint and
component inventories are independently checked globally and per component.

| Physical manufacturer port | Frozen project semantic port |
| --- | --- |
| U_MCU.GPIO2 | U_MCU.MUX_A0 |
| U_MCU.GPIO3 | U_MCU.MUX_A1 |
| U_MCU.GPIO4 | U_MCU.MUX_A2 |
| U_MCU.GPIO5 | U_MCU.MUX_EN0 |
| U_MCU.GPIO7 | U_MCU.HALL_PWR_EN |
| U_MCU.GPIO11 | U_MCU.STATUS_LED |
| U_MCU.GPIO26 | U_MCU.ADC_SENSE |
| U_MCU.TESTEN | U_MCU.TESTEN_19 |
| U_MCU.ADC_AVDD | U_MCU.ADC_AVDD_43 |
| U_MCU.VREG_IN | U_MCU.VREG_IN_44 |
| U_MCU.VREG_VOUT | U_MCU.VREG_VOUT_45 |
| U_MCU.USB_VDD | U_MCU.USB_VDD_48 |
| U_MCU.QSPI_CSn | U_MCU.QSPI_SS |
| U_MCU.GND | U_MCU.GND_57 |
| Every local resistor/capacitor p1 / p2 | Corresponding pin1 / pin2 |

Unused physical GPIO0, GPIO1, GPIO6, GPIO8..10, GPIO12..25, GPIO27..29 are
individually enumerated and must remain unconnected. They are not silently
removed. Every RP2040 physical assignment is read from actual public
`PadMapping.items()` and the accepted manufacturer's `physical_pads()` inventory;
no coordinates or dimensions are read for the verdict. Physical inventory has
57 unique pins, and 34 normalized pin numbers match the frozen RP2040 mapping.
A swapped GPIO alias cannot mask an incorrect logical-to-physical assignment.

Passive group references are explicit and cover all 35 passives exactly once.
Expected numerical quantities derive from exact frozen value strings with
explicit unit conversions, not editable copied expected numbers. Floating-point
comparison permits only 1e-12 relative representation tolerance. BOM labels
must equal their electrical resistor/capacitor quantities before export.

## Reproduction and validation

Run from `hardware/jitx` with the installed authenticated runtime reachable:

```bash
uv sync --locked --group dev
uv run jitx runtime start --background
uv run jitx build he_piantor_42_jitx.m1.M1FourKeyElectrical
uv run jitx design export m1-electrical-graph \
  he_piantor_42_jitx.m1.M1FourKeyElectrical --output /tmp/m1-first.json
uv run jitx design export m1-electrical-graph \
  he_piantor_42_jitx.m1.M1FourKeyElectrical --output /tmp/m1-second.json
uv run python -m parity.m1 /tmp/m1-first.json \
  --normalized /tmp/m1-normalized.json --result /tmp/m1-result.json
cmp /tmp/m1-first.json /tmp/m1-second.json
uv run python -m unittest discover -v
uv run python -m unittest tests.test_bootstrap_graph tests.test_m1_electrical_parity -v
uv run ruff format --check he_piantor_42_jitx parity tests
uv run ruff check he_piantor_42_jitx parity tests
uv tool run --from pyright pyright --pythonpath .venv/bin/python \
  he_piantor_42_jitx/m1.py he_piantor_42_jitx/components/generic_electrical.py \
  parity/exporter.py parity/m1.py tests/test_m1_electrical_parity.py
npm --prefix ../tscircuit run m1:verify
```

| Validation | Result |
| --- | --- |
| Checkout / baseline / initial working tree | Exact requested branch and SHA; clean |
| `uv sync --locked --group dev` | PASS: 30 packages, unchanged lock |
| Full Python discovery | PASS: 20 tests |
| Bootstrap graph regression | PASS: two real exports, unchanged expected output |
| C2 electrical parity tests | PASS: eight tests, two independent real exports |
| Ruff format/check | PASS: full package, parity and tests |
| Pyright new/changed modules | PASS: 0 errors, 0 warnings |
| Real non-dry complete M1 build | PASS: `status: ok` |
| Two real raw exports | PASS: byte identical |
| Two normalized exports and results | PASS: byte identical; no differences |
| Frozen tscircuit verifier | PASS: all 22 reported checks |
| JITX skill grep gates (executed from installed skill) | PASS: 0 hard-fail, 0 review-required |
| Protected-file diff against baseline | PASS: all protected paths unchanged |
| `git diff --check` | PASS |

Both independent raw exports SHA-256:
`b910bd267d1be0adb70ef40905802a025a288408c290850244929a93ebd67f60`.
Both normalized electrical outputs SHA-256:
`e8d47cdd3798a5e56d32500e4ee0005c18d0717279080b06f14782b4e6da4e2c`.

The eight C2 tests inject component/endpoint deletion, duplicates and unknowns,
net opens/shorts, extra edges, NC/unused-GPIO connections, direct-link opens and
shorts, missing/unresolved/duplicate named nets, incorrect passive values,
manufacturer/supplier/model substitutions, physical pin swaps and alias swaps.
A deliberately different geometry record leaves the electrical verdict PASS.

Execution environment: JITX Python 4.4.3, jitxlib-standard 4.4.0, Linux runtime
4.4.2. No package/runtime/dependency update. A writable temporary UV cache was
used because the default cache was read-only. The installed runtime was started
with access to its existing home-directory statistics/cache files and kept in a
foreground tool session when background lifetime was insufficient. GitHub CLI
access required the network-enabled execution context. These are environment
repairs, not compatibility changes. Pyright used an isolated UV tool environment
against the project's actual interpreter, without changing `uv.lock`.

## Task completion: generic components

| Component check | Evidence / disposition |
| --- | --- |
| Source | User explicitly authorizes non-MPN generic components; frozen passive values and golden LED/button/TP declarations |
| Identity | Capacitor, LED, PushButton, TestPoint; no MPN/manufacturer/JLC claims; C/D/SW/TP prefixes |
| Pins | Capacitor 2, LED 2, normally-open button 2, TP 1; corresponding frozen semantic endpoints preserved |
| Landpattern | Standard SMT 0402 capacitor / 0603 LED and button; project-owned 1.2 mm circular TP from golden source |
| Library defaults | SMT generator/table and density defaults intentionally only structural build scaffolding; no authoritative geometry or fab suitability asserted |
| Value / BOM | Passive quantity consistency guarded in runtime exporter and frozen comparator; green/amber LED and normally-open button labels tested; TP value explicitly tested unset |
| No-field walk | No supplier selections, voltage/capacitance tolerances or real switch package approved; intentionally absent |
| Provenance | No unapproved physical choice presented as authoritative; generic choices explicitly authorized C2 implementation detail |
| Checks | Pyright clean; integration/structural inventories pass; complete real M1 build `status: ok` |
| Verdict | Complete for electrical-only C2; physical sourcing/package validation deferred |

## Task completion: assembly, export and comparator

Built `M1ElectricalCircuit` / `M1FourKeyElectrical`, extended C0 exporter and
strict normalized comparator. Primary source: unchanged frozen contract and
M1 golden/verifier; secondary source: project-owned sensor-test pinmap/design.
Manufacturer models and their C1 provenance remain unchanged. Only public JITX
APIs are used: existing Export/query/find/visit/Trace plus public Net, component
metadata, unit conversions and PadMapping.items. RuntimeDesign remains the
accepted category-B experimental surface; no category-C API/artifact is used.
No proprietary skill source or script is retained in the repository.

The same-model `jitx-code-review` pass read the installed architecture rules and
pattern checklist against all new/changed Python modules. No circuit reflection,
dynamic classes, string-keyed construction model, free-function structural
mutation, private JITX access, or copied framework navigation was found.
Explicit JSON keys belong to the external parity/serialization schema; they
never construct design objects. Process-local object IDs join runtime facts and
never become output identities. Typed electrical net/declaration records were
added during review; passive BOM consistency and label checks were strengthened.

- CRITICAL: 0 outstanding.
- WARNING: 0 outstanding.
- NOTE: 2, retained by authorized scope: `m1.py:275` sample board/substrate and
  `components/generic_electrical.py:19` onward generic physical choices are
  non-authoritative scaffolding; `parity/exporter.py` runtime NC warnings are
  expected for the seven contract NCs and 23 unused physical GPIOs, and tests
  prove those exact dispositions. No required connected endpoint floats.

Scope-limited electrical audit: VBUS supplies LDO/load/ESD; V3V3 and V1V1 reach
all frozen MCU power ports; Hall and mux VDD use HALL_5V; TESTEN is grounded;
USB shield stays distinct. All four Hall channels map S1..S4, MUX_D feeds the
6.8k/10k/1nF ADC network, QSPI/BOOTSEL and crystal paths match, and controls,
LEDs and all 17 test points resolve exactly. Direct links are stored structural
nets. Power integrity, voltage ratings, SI and geometry are not asserted.

Completed phase gates: requirements and data authorization (0→1); existing
manufacturer models plus generic structural build validity (1→2); explicit
circuit connections and normalization boundaries (2→3); full real assembly
(3→3b); frozen electrical graph and pin/value audit (3b→4); deterministic real
exports, regression/fault tests, static checks and golden verifier (4).
The physical parts of the complete-board workflow were explicitly excluded by
the user's C2 scope. This is an electrical parity increment, not a hardware
readiness review; no additional manufacturer-model/outside-voice re-review was
required because all accepted C1 models remain unchanged.

Self verdict: ready for PMO review. Technical acceptance: electrical PASS
candidate. PMO acceptance/merge remains pending.

## Protected boundary and deferred gates

Unchanged: golden TSX, golden verifier, frozen parity contract,
`hardware/layout/**`, all nine accepted manufacturer model sources/geometry,
bootstrap design/test, Python dependency configuration and `uv.lock`.
`hardware/layout/**` was not consumed. tscircuit remains authoritative under
D-014; JITX remains a challenger. No manufacturing artifacts were generated.

**Geometry parity is excluded and NOT established.** No transforms, pad
coordinates, footprint dimensions or PCB dimensions affect the C2 verdict.
HRO and Winbond discrepancies remain unresolved for **EDA-002C3:
manufacturer-vs-frozen geometry reconciliation / PMO Human Gate**, which is
unstarted. EVT-002 remains blocked/unstarted. No final placement, routing,
DRC/manufacturing readiness or authority change is claimed.
