ihsinoky/he-piantor-42/hardware/jitx/physical/c4b4a-evidence/ARCHITECTURE.md

# Qualification coupon architecture

USBDFMCoupon Design -> CouponBoard (40 x 25 mm) + unchanged
QualificationSubstrate + CouponCircuit -> accepted TYPE_C_31_M_12.
Connector local datum placed at (0, -5) mm, top side, zero rotation.
Two separated top silkscreen lines: DFM TEST ONLY / DO NOT ORDER.
No supplies, wiring, routes, planes, added pads or added holes. All accepted
contact lands, plated shell stakes and NPTH locator holes remain present.
The connector's SHIELD mapping intentionally has disconnected physical stakes.
Normal rigid two-layer FR-4, 0.035 mm copper each side; source stack total
1.20 mm including masks / 1.17 mm excluding masks, unchanged.
CAD/job thickness limitation is handled only by upload-file exclusion and
manual 1.2 mm finished-board selection. Manufacturing release remains blocked.
