ihsinoky/he-piantor-42/hardware/jitx/physical/c4b4a-evidence/PLAN.md

# C4B4A execution plan

Workflow tier: complete-board; one disposable qualification coupon.
Authority: Issue #49 and the user's explicit execution instructions authorize
this fixed source/data plan. No new components, stackup, process or footprint.

1. Baseline/protected-source/environment preflight — PASS before implementation.
2. Directly compose accepted connector and QualificationSubstrate; create only
   coupon outline, placement and silkscreen. No electrical functionality.
3. Independently measure accepted source geometry in public TestCase context;
   compare against accepted C4B3 values with a 0.000001 mm material-change guard.
4. Build/export through supported commands twice; compare raw CAM geometry
   with public source geometry within the existing 0.001 mm observer tolerance.
5. Whitelist nine Gerbers plus PTH/NPTH Excellon; verify ZIP bytes/hashes.
6. Run existing C0/C1/C2 tests, lint/format/syntax and applicable CI.
7. Record report, PO procedure, support question; commit forward material only;
   open exactly one Draft PR. No external DFM result or disposition.

Acceptance and phase gates are recorded in code-review.md after validation.
