ihsinoky/he-piantor-42/hardware/jitx/physical/c4b4a-evidence/run-1-drill-report.txt

Drill report for he_piantor_42_jitx.usb_dfm_coupon.USBDFMCoupon.kicad_pcb
Created on 2026-10-04T10:58:35+0000

Copper Layer Stackup:
    =============================================================
    L1 :  F.Cu                      front
    L2 :  B.Cu                      back

Drill file 'he_piantor_42_jitx.usb_dfm_coupon.USBDFMCoupon-PTH.drl' contains
    plated through holes:
    =============================================================
    T1  0.600mm  0.0236"  (4 holes)  (with 4 slots)

    Total plated holes count 4

Drill file 'he_piantor_42_jitx.usb_dfm_coupon.USBDFMCoupon-NPTH.drl' contains
    unplated through holes:
    =============================================================
    T1  0.600mm  0.0236"  (2 holes)

    Total unplated holes count 2
