ihsinoky/he-piantor-42/hardware/kicad/qualification/issue-226-main-rev6/manufacturing/drill-report.txt

Drill report for main-rev6.kicad_pcb
Created on 2026-11-12T11:46:14+0900

Copper Layer Stackup:
    =============================================================
    L1 :  F.Cu                      front
    L2 :  In1.Cu                    in1
    L3 :  In2.Cu                    in2
    L4 :  B.Cu                      back

Drill file 'main-rev6-PTH.drl' contains
    plated through holes:
    =============================================================
    T1  0.300mm  0.0118"  (130 holes)

    Total plated holes count 130

Drill file 'main-rev6-NPTH.drl' contains
    unplated through holes:
    =============================================================
    T1  2.200mm  0.0866"  (3 holes)

    Total unplated holes count 3
