ihsinoky/he-piantor-42/hardware/kicad/qualification/issue-185-main-rev3/manufacturing/drill-report.txt

Drill report for main-stage2.kicad_pcb
Created on 2026-11-06T22:24:34+0900

Copper Layer Stackup:
    =============================================================
    L1 :  F.Cu                      front
    L2 :  In1.Cu                    in1
    L3 :  In2.Cu                    in2
    L4 :  B.Cu                      back

Drill file 'main-stage2-PTH.drl' contains
    plated through holes:
    =============================================================
    T1  0.300mm  0.0118"  (113 holes)
    T2  0.600mm  0.0236"  (4 holes)  (with 4 slots)

    Total plated holes count 117

Drill file 'main-stage2-NPTH.drl' contains
    unplated through holes:
    =============================================================
    T1  0.650mm  0.0256"  (2 holes)
    T2  2.200mm  0.0866"  (4 holes)

    Total unplated holes count 6
