ihsinoky/he-piantor-42/hardware/kicad/qualification/issue-147-wing-order-prep/16mm/drill-report.txt

Drill report for wing-16mm.kicad_pcb
Created on 2026-11-05T12:58:39+0900

Copper Layer Stackup:
    =============================================================
    L1 :  F.Cu                      front
    L2 :  B.Cu                      back

Drill file 'wing-16mm-PTH.drl' contains
    plated through holes:
    =============================================================
    T1  0.300mm  0.0118"  (196 holes)

    Total plated holes count 196

Drill file 'wing-16mm-NPTH.drl' contains
    unplated through holes:
    =============================================================
    T1  2.200mm  0.0866"  (4 holes)

    Total unplated holes count 4
