ihsinoky/he-piantor-42/docs/decisions.md

# Design Decisions

This file records decisions that materially affect hardware, firmware, manufacturing, or enclosure design.

> **監査案内（2026-11-08、Issue #205）:** 状態・PO 根拠・適用範囲・後継関係は [全34件の監査報告](issue-205-adr-audit.md) を参照。既存 Status／本文／見出しは履歴として保存し、訂正・補足は監査注記で示す。採択根拠不足は「未確認」に分離している。

## D-001 - One-piece geometry

Status: provisional

Interpret "120-degree reverse-V" as an internal angle of 120 degrees between left and right key fields, with the left field at +30 degrees and right field at -30 degrees in the project coordinate convention (+x right, +y down).

Reason: this is the simplest consistent geometric interpretation and is easy to review visually once the Piantor key centers are transformed.

## D-002 - Key pitch

Status: historical provisional baseline; fixed production pitch superseded/reopened by D-015

Historical decision (retained): Use 17.0 mm pitch rather than 16.5 mm.

Reason: 16.5 mm square narrow MX-stem keycaps exist. At 17.0 mm center spacing this leaves a nominal 0.5 mm cap-to-cap gap. A 16.5 mm pitch would leave no nominal gap.

D-015 reopens production pitch: 17.0 mm remains an evaluation candidate alongside
16.5 and 16.0 mm. The historical clearance rationale above remains evidence,
not a final production-pitch requirement.

## D-003 - Magnetic switch

Status: provisional baseline

Use Gateron Magnetic Jade Pro HE / KS-20-compatible as the primary design reference.

Reason: it is a full-height HE switch, has published magnetic values at 1.2 mm PCB thickness, and has current Japanese availability.

Do not release the 42-key production PCB based only on nominal switch data. Validate the sensor range with a small evaluation board first.

## D-004 - Power indication

Status: accepted

> **監査注記（2026-11-08、Issue #205）:** 原文 accepted に対応する PO の明示採択／マージゲートと決定日は未確認。初出 42caa276 は記録の根拠であり採択の代用ではない。本監査では「未確認」とする。 詳細・根拠は [監査報告](issue-205-adr-audit.md)。

Use a dedicated power indicator LED independent of the MCU.

Reason: it provides a basic hardware diagnostic when firmware or USB enumeration fails.

## D-005 - Layer indication

Status: accepted

> **監査注記（2026-11-08、Issue #205）:** 原文 accepted に対応する PO の明示採択／マージゲートと決定日は未確認。初出 42caa276 と採択判断を分け、本監査では「未確認」とする。 詳細・根拠は [監査報告](issue-205-adr-audit.md)。

Use a separate MCU-controlled RGB LED for four-layer indication.

## D-006 - Manufacturing strategy

Status: accepted

> **監査注記（2026-11-08、Issue #205）:** 原文 accepted に対応する初期方針全体の PO 採択根拠と決定日は未確認。後続の個別 PCBA 方針を全体の採択に遡及させず、本監査では「未確認」とする。 詳細・根拠は [監査報告](issue-205-adr-audit.md)。

Target JLCPCB PCBA for the assembled PCB and FDM printing for the first enclosure.

## D-007 - Project tracking

Status: accepted

The documents under `docs/` are the authoritative record of project state and
decisions. The Dashboard is a human-readable project overview and read model,
not a source of truth. Production Dashboard deployments represent merged
`main`; a PR Preview may be used to inspect a proposed state before merge.

Reason: separating the reviewed project record from its presentation prevents
stale runtime, GitHub, or deployment snapshots from overriding design decisions.

## D-008 - PCB thickness

Status: provisional baseline

Use 1.2 mm PCB thickness for both the Hall evaluation board and the 42-key production board.

Reason: the Gateron Magnetic Jade Pro reference data publishes switch magnetic-flux values at 1.2 mm PCB thickness. Keeping the evaluation and production geometry equal avoids adding PCB thickness as an uncontrolled magnetic-distance variable.

## D-009 - Hall analog power rail

Status: provisional baseline pending current measurement

Power Hall sensors and analog multiplexers from a switched USB VBUS rail named HALL_5V. Use TPS22919DCKR as the baseline load switch controlled by GPIO7.

Reason: forty-two linear Hall sensors are a significant continuous load. Supplying them through the 3.3 V logic LDO would add unnecessary regulator dissipation. A switched 5 V rail also permits controlled startup and fault isolation.

## D-010 - Hall multiplexing topology

Status: provisional baseline pending evaluation

Use TMUX1208 rather than 5 V 74HC4067 devices. The production board uses six TMUX1208 devices as two banks of three, with seven used sensor inputs per mux.

Shared address lines are MUX_A0..A2. MUX_EN0 and MUX_EN1 select the 21-key bank. Three mux outputs feed RP2040 ADC0..ADC2 through 6.8 kOhm / 10 kOhm dividers and 1 nF ADC-node capacitors.

Reason: TMUX1208 explicitly supports low-voltage digital control while operating from the 5 V analog rail. Three ADC channels sampled per address reduce the number of sequential acquisition slots to 14 for all 42 keys.

## D-011 - Evaluation board before main PCB

Status: accepted measurement intent; one-piece four-key physical implementation assumption superseded by D-015

> **監査注記（2026-11-08、Issue #205）:** 初期の accepted measurement intent の PO 採択根拠と決定日は未確認。D-015 の物理形態変更、D-017 の後続測定枠組み採択とは区別する。量産前実測の意図を失効させたり実測済みと判定したりする注記ではない。 詳細・根拠は [監査報告](issue-205-adr-audit.md)。

Do not release the 42-key PCB until a four-key Hall evaluation board has measured:
- switch travel curve and polarity,
- usable ADC span and clipping margin,
- noise and repeatability,
- mux settling time,
- adjacent-key magnetic coupling,
- Hall-rail current and turn-on behavior,
- short-term thermal drift.

Reason: Hall switch behavior depends on the switch magnet, Hall sensor, PCB thickness, physical alignment, analog path and firmware timing as one system. Nominal component specifications alone are not sufficient for the production PCB.

D-015 replaces the one-piece four-key physical implementation with a reusable
Main + Evaluation Wing(s). The historical requirement above to physically
validate Hall behavior before releasing the 42-key design remains valid.

## D-012 - PCB layer baseline

Status: accepted

> **監査注記（2026-11-08、Issue #205）:** D-019 は Main に限り4層へ改定。D-021 は代表21キー Wing の独立した2層／ルール採択で、その Amendment は同じ ID の幅条件改定。D-028 は Matrix への適用を明示する。1.2mm厚は維持。 詳細・根拠は [監査報告](issue-205-adr-audit.md)。

Use a two-layer PCB for the evaluation board and as the current production
baseline. Prioritize JLCPCB's low-cost manufacturing options. Four-layer
capability is not a current project requirement; if it becomes necessary, it
must be reconsidered through a separate design decision and Human Gate.

This layer baseline does not change D-008: both the Hall evaluation board and
the production board retain the 1.2 mm PCB-thickness baseline.

Reason: a two-layer baseline keeps the current evaluation aligned with the
project's low-cost manufacturing objective without treating an unneeded
four-layer capability as an EDA acceptance criterion.

## D-013 - EDA backend evaluation strategy

Status: accepted evaluation baseline

Do not adopt automatic KiCad-to-tscircuit import as the authoritative migration
path. Evaluate a greenfield design written in native TypeScript / TSX, using
stock tscircuit, before implementing the evaluation PCB. The intended flow is:

```text
requirements / datasheets / verified geometry
    -> native TypeScript / TSX
    -> stock tscircuit
    -> 2-layer PCB
    -> Gerber / Drill / BOM / PnP
    -> JLCPCB
```

Before a GO decision, do not introduce a tscircuit fork, Circuit JSON fork, or
custom Gerber exporter. Generated Circuit JSON and Gerber files must not be
edited directly. Repository-owned validation and tests are permitted. Existing
KiCad designs remain available as fallback, reference, and prior-design
evidence, and must not be removed before the migration GO decision.

Reason: the earlier Issue #13 spike proved a reproducible non-interactive setup:
a committed dependency lock, a fresh GitHub Actions `npm ci`, Bun 1.2.22,
tscircuit 0.0.2646, and CI bootstrap all passed. However, PR #16's conversion of
`SW_MX_HE_0deg_1u.kicad_mod` with `kicad-to-circuit-json` 0.0.117 reached
**STOP 1 - FOOTPRINT INTEGRITY**. It preserved the Hall SMD pads, plated
through-hole pad, duplicate pad-number semantics, two NPTH switch holes,
plated/non-plated distinction, mechanical alignment, and the observed Y-axis
inversion, but lost two copper-pour keepout zones. This rejects the import path;
it does not establish that a native tscircuit design is impossible. Native
stock-tscircuit feasibility therefore requires a separate technical gate.

## D-014 - Native tscircuit is the M1 electrical source

Status: accepted

Use native TypeScript / TSX through unmodified stock tscircuit to generate
Circuit JSON for the M1 four-key Hall evaluation board. The Issue #19 Human
Gate is **GO**: Checkpoints A, B, and C demonstrated the required Hall geometry,
source-level electrical connectivity, and two-layer manufacturing pipeline.
The KiCad design is retired as fallback/reference evidence (`EDA-000`), not an
authoritative source and not converter input.

This freezes the M1 electrical architecture; it does not approve placement,
routing, a manufacturing package, an order, or G1. The current evaluation and
production baselines are two copper layers and 1.2 mm thickness.

Reason: the native spike preserved the Hall geometry and keepouts, resolved
real source ports/nets/traces, and produced stock outputs without an importer,
Circuit JSON patch, fork, custom schema, or exporter.

## D-015 - Rev.M1 reusable Main + Evaluation Wing architecture

Status: accepted

Physical Rev.M1 is a new modular design, separate from the permanent frozen
four-key EDA qualification fixture. D-014 remains unchanged as historical native
tscircuit electrical authority for that fixture. C2 electrical graph parity is
accepted PASS; C3 geometry discrepancies remain valid historical evidence, not
resolved by this decision. Exact geometric convergence to the legacy golden is
no longer a JITX adoption criterion. Manufacturer evidence should inform the new
production design; no legacy geometry is corrected in EDA-002C4A (issue #41).

The reusable Main carries RP2040, USB, 3.3 V logic/core power, switched HALL_5V
generation, three RP2040 ADC channels, ADC dividers and filters, the Wing
connection interface, and M1 debug/bring-up facilities. Reuse this Main unchanged
in Rev.A, or with only explicitly approved corrections.

The Evaluation Wing carries Hall sensor positions, TMUX1208, the board-to-board
or cable connection to Main, and switch geometry for pitch/interference tests.
No board or exact connector is designed or selected in C4A.

First-choice Rev.A reuses the accepted Main with a Left 21-key Wing and a Right
21-key Wing, three TMUX1208 devices per Wing. Both Wings are generated from the
same project-owned design definition; separate manufacturing datasets are
allowed. A single reversible left/right PCBA is not required. Future geometry
must be project-owned or explicitly approved; its source approval remains a
later Human Gate. `hardware/layout/**` must not be consumed.

The logical Main/Wing interface includes HALL_5V, GND, MUX_A0/A1/A2, Wing/bank
enable, three analog MUX outputs for production-compatible Wings, and any
additional required control/reference signals identified at interface design.
ADC dividers/filters stay on Main. At D-015 acceptance, exact connector, pin
count/order, shielding, ground allocation and mechanical implementation were
TBD at G0B. D-017 now records the accepted interface and evaluation harness;
final Rev.A cable mechanics remain open.

Compare 17.0, 16.5 and 16.0 mm pitches experimentally for typing feel/mechanical
usability, neighboring-magnet Hall interference, signal range, repeatability,
and practical switch/keycap interference. 16.0 mm is interesting because it may
allow a 21-key Wing inside JLCPCB's low-cost 100 x 100 mm region. Fitting that
region is an optimization target, not a pitch requirement. Magnetic performance
and usability take priority over PCB cost.

Use the [Rev.M1 DFM policy](../hardware/rev-m1/dfm-policy.md): prefer Economic
PCBA where practical, two copper layers, 1.2 mm thickness and SMD on one side.
Prefer Basic, then Promotional Extended parts; minimize unnecessary distinct
Extended types without sacrificing performance. Main + Evaluation Wing within
100 x 100 mm is a cost experiment, with separate orders allowed. No panel is
designed here.

Main reuse is intended to reduce Rev.A risk by retaining the power, MCU, ADC
and analog conditioning path once physically validated, while scaling the sensor Wings. G0A selects an active
EDA through C4B pipeline proof and C4C GO/NO-GO; G0B freezes architecture,
interface and experiments before physical implementation. C4A does not adopt
JITX or create D-016. See [architecture](../hardware/rev-m1/architecture.md),
[interface](../hardware/rev-m1/main-wing-interface.md) and
[evaluation plan](../hardware/rev-m1/evaluation-plan.md).

## D-016 - JITX physical backend NO-GO; native tscircuit resumes as active Rev.M1 EDA candidate

Status: accepted

The [Product Owner decision on Issue #55](https://github.com/ihsinoky/he-piantor-42/issues/55#issuecomment-5991285003)
completes EDA-002C4C / G0A: **NO-GO — JITX physical backend** for Rev.M1 / Rev.A.
JITX is not selected as the active physical EDA backend under the qualified
versions and workflow. Native stock tscircuit resumes as the active forward EDA
candidate/path for physical Rev.M1, subject to G0B and later product,
ERC/DRC and manufacturing gates. This is a project-fit decision, not a claim
that JITX is generally incapable or that routing completion is impossible.

Primary reason: [C4B5's accepted BLOCKED evidence](../hardware/jitx/physical/EDA-002C4B5.md).
Source-level routing worked materially, reducing the historical 147 downstream
unconnected items substantially. The retained multilayer experiment still had
39 downstream unconnected items plus a dangling via. No supported public
headless global multilayer routing workflow was demonstrated in the pinned
JITX environment. The complete, reproducible AI/source-controlled physical-routing
workflow required by this project was therefore not demonstrated. Further
investment in global fanout, layer allocation, via placement, route ordering
and conflict avoidance would require substantial routing strategy/tooling or
interactive work; the PO judged that investment a poor fit for completing the
keyboard. These bounded results do not prove that an expert cannot route the
board or that other placements and strategies cannot succeed.

Accepted positive results remain valid: graph introspection, manufacturer
component modeling, electrical parity, source-controlled design representation,
headless build and verification, and the downstream KiCad/CAM path with known
limitations. Retain all JITX source, manufacturer models, qualification code and
C0-C4B5 evidence unchanged for reference or possible future reevaluation. Carry
forward useful manufacturer-model, DFM, architecture and validation knowledge.

USB NPTH DFM is **OPEN — PRE-ORDER DFM REVIEW REQUIRED**, a separate product
manufacturing risk and not a reason for JITX NO-GO. The generated 1.6 mm
overall-thickness metadata problem remains historical JITX downstream-path
evidence/limitation, not the primary NO-GO reason; that path requires an
independent 1.2 mm finished-thickness handoff.

D-014 remains valid historical authority for the permanent frozen M1 electrical
fixture and is not rewritten. D-015 remains valid and continues to define the
reusable Main + Evaluation Wing architecture. No historical C0-C4B5 verdict
is changed by this adoption decision.

**At D-016 acceptance, G0A was complete and G0B was next / not-ready.**
D-017 below now completes G0B; EDA-003B acceptance remains necessary before
full Rev.M1 implementation. This decision does not authorize physical Rev.M1
implementation. Physical Main/Wing remains unimplemented; at this decision,
G0B acceptance was still required. Native
tscircuit is the forward candidate/path, not an already implemented or
production-qualified physical Rev.M1 design.

## D-017 - Rev.M1 Main/Wing architecture and interface freeze

Status: accepted

> **監査注記（2026-11-08、Issue #205）:** D-024 は GH14 電気契約を維持して2ポートへ拡張。D-033 は Main Rev.4 に限り100mm前提を200mm×2へ置換し、D-034 が保持する。層・ルールの後継は Main が D-019、Wing が D-021、Matrix 評価構成は D-028。G0B 全体の取消ではない。 詳細・根拠は [監査報告](issue-205-adr-audit.md)。

The [Issue #57 PO GO](https://github.com/ihsinoky/he-piantor-42/issues/57#issuecomment-6010634587)
on 2026-10-06 accepts the [reviewed G0B record](../hardware/rev-m1/g0b-freeze-proposal.md).
**G0B is complete.** The frozen values are authoritative within this boundary;
implementation items explicitly left open remain open. D-014/D-015/D-016 and
historical qualification evidence remain valid.

### Connector and interface

JST GH 14-position: `BM14B-GHS-TBT(LF)(SN)` Main/Wing headers,
`GHR-14V-S` housings, `SSHL-002T-P0.2` contacts. The exact accepted pin allocation
is in [G0B section 3](../hardware/rev-m1/g0b-freeze-proposal.md#3-accepted-exact-14-pin-interface):
`HALL_5V`, six physical GND/return contacts on common `GND`, `MUX_A0`, `MUX_A1`,
`MUX_A2`, `WING_EN`, `MUX_OUT_A`, `MUX_OUT_B`, `MUX_OUT_C`.

Switched `HALL_5V` remains default-off. Each `WING_EN` requires its own explicit
external Main-side hardware pull-down; firmware/internal pulls are insufficient.
The exact resistor value remains implementation work. The evaluation harness
is nominal 100 mm, 14 conductors, wired 1:1.

### Evaluation and current planning basis

Use three pitch-specific Evaluation Wings: **17.0 / 16.5 / 16.0 mm**. Preserve
production-equivalent/full-load electrical coverage, three TMUX1208 / three ADC
path coverage and the 21-sensor full-load/electrical-load path. The reviewed
[G0B coverage, test-access and measurement framework](../hardware/rev-m1/g0b-freeze-proposal.md#6-production-equivalent-mux-and-bank-evidence)
is accepted. Production pitch is not selected.

DRV5055 at 5 V: **3 mA typical / 5 mA maximum**. Planning estimates are
approximately **127 mA per 21-key Wing / 254 mA for 42 sensors / two Wings**.
These are planning estimates, not final USB/system power qualification; MCU,
other loads and startup/inrush remain subject to later verification. The final
Hall sensor is not selected by this planning basis.

### PCB / DFM

Two copper layers, 1.2 mm thickness, SMD one side preferred, and JLCPCB Economic
PCBA preferred where practical. **100 x 100 mm is optimization only.**

**USB NPTH — OPEN — PRE-ORDER DFM REVIEW REQUIRED**

No manufacturing exception or release is approved.

### EDA authority and sequence

Native stock tscircuit remains active forward physical EDA; native TSX remains
authoritative. [EDA-003A](tscircuit-kicad-importer-requalification.md) / merged
PR #59 is accepted as **UPSTREAM_FIX_CANDIDATE**: both copper-pour keepouts were
silently lost, warnings did not report the material loss, and rounded-pad
corner radius was incorrect. Current KiCad footprint importer reuse is **NOT
approved**. KiCad assets remain reference / secondary evidence. Future importer
reuse requires separately accepted fidelity evidence after fixes.

**G0B accepted -> EDA-003B representative stock-tscircuit physical/routing proof
-> if accepted, full Rev.M1 implementation.** EVT-002's G0B prerequisite is
satisfied; full implementation is not yet active. No schematic/PCB/manufacturing
package completion is claimed.

### Remaining open

Production key pitch; final Hall sensor choice; final Rev.A cable mechanics/length;
exact `WING_EN` pull-down resistor; final placement; PCB routing; representative
stock-tscircuit routing capability; USB NPTH manufacturing disposition; final
USB/system power budget; manufacturing release. Planning values do not become
final production requirements.

## D-018 - Bounded alternate physical backend qualification planning

Status: accepted PO planning decision; qualification execution not authorized

The [Issue #71 PO Human Gate comment](https://github.com/ihsinoky/he-piantor-42/issues/71#issuecomment-6046244229)
on 2026-10-07 approves decision recording, documentation/Dashboard alignment,
a bounded qualification plan and a draft of the next execution Issue body.
It approves ending additional product-track exploration of the internal
tscircuit router evaluated in EDA-003F. The accepted EDA-003F result remains
**INTERVENTION_UNSAFE_REGRESSION**, terminal **K1**: zero required unrouted,
but two wrong-net copper components. Neither reduced diagnostic counts nor
signature disappearance establishes a safe improvement.

Retention of the tscircuit frontend is still being evaluated; it has not been
abandoned. **Candidate B is the first qualification candidate, not an adopted
backend**: native TSX -> genuinely unrouted Circuit JSON -> KiCad -> DSN ->
local headless Freerouting -> SES -> KiCad verification/manufacturing.
Prefer existing converters and public APIs. No private API, permanent fork,
large custom interchange implementation or new manufacturing exporter is
approved. A and C remain comparison candidates, with no automatic fallback.

The first Main evaluation has a **two-workday engineering-effort cap**, including
preparation, interchange and reconciliation. Permit one initial Main routing
run and one fresh confirmation only if the first passes. Preserve components,
connectivity, placement, outline, two copper layers, 1.2 mm thickness and the
unchanged **0.20 mm material-clearance requirement**. Stop on material transfer
loss, headless failure, shorts, incomplete routing, targeted physical violations,
non-reproducibility, excessive adapter work or exceeded budget. Main must pass
before Wing/export work advances. Candidate/placement changes, retries/tuning
or exceptions require a new PO decision.

Issue #71 authorizes **documentation and planning only**. Actual qualification
requires a separate **PO-created execution Issue** and a subsequent **PO
instruction after its number is confirmed**. Full Rev.M1 implementation,
backend adoption and ordering remain blocked. CI success cannot pass these
gates. Existing G0A/G0B decisions remain completed; no Human Gate is reopened
or newly passed by Codex.

D-014 remains historical electrical authority for the permanent frozen fixture.
D-015/D-017 Main/Wing architecture and interface, D-016 JITX physical backend
NO-GO, all historical verdicts and design/evidence bytes remain unchanged.
Production **tscircuit 0.0.2646** remains pinned. **USB NPTH OPEN — PRE-ORDER
DFM REVIEW REQUIRED** remains a product risk with no manufacturing exception.
Production pitch is unselected; final Hall choice, Rev.A cable mechanics,
exact WING_EN pull-down, final placement/routing and USB/system power remain
open. This forward planning decision supersedes the old future EDA-003B
sequence without rewriting D-016/D-017's historical authority.

See the [bounded qualification plan](alternate-physical-backend-qualification-plan.md)
and [execution Issue body draft](alternate-physical-backend-main-qualification-issue-draft.md).

## D-019 - Rev.M1 Main four-layer and 0.10 mm design-rule baseline

Status: accepted

The [Issue #123 PO decision](https://github.com/ihsinoky/he-piantor-42/issues/123)
on 2026-11-04 revises D-012 for **Rev.M1 Main only**. Use four copper layers:
**F.Cu signal / In1.Cu GND plane / In2.Cu signal / B.Cu signal**, with
**1.2 mm** finished PCB thickness. Use **0.10 mm trace width / 0.10 mm
clearance** and **0.60 mm via diameter / 0.30 mm drill** as the design-rule
baseline. This replaces the Main layer/rule assumptions retained in
D-015/D-017/D-018 without rewriting their historical records. D-008's 1.2 mm
thickness baseline is unchanged.

Reason: [Issue #117](https://github.com/ihsinoky/he-piantor-42/issues/117)
([results](issue-117-four-layer-main-and-wing-outlook.md)) left 26 unrouted
with fab_router and 28 with KRT at four layers / 0.20 mm.
[Issue #119](https://github.com/ihsinoky/he-piantor-42/issues/119)
([results](issue-119-promising-tools-relaxed-conditions.md)) left one unrouted
with KRT and 19 with fab_router at four layers / 0.127 mm; Freerouting left
27 and also violated the width requirement.
[Issue #121](https://github.com/ihsinoky/he-piantor-42/issues/121)
([results](issue-121-full-auto-conditions.md)) completed automatic routing
with KRT at four layers / 0.10 mm and the unchanged 0.60/0.30 mm vias:
zero unrouted and all four independent metrics zero (required unconnected,
wrong-net contact, physical violations, unexplained transfer changes).
The JLCPCB instant quotation checked on 2026-11-04 for **four layers,
48 x 44 mm, 1.2 mm, five boards** priced the **bare PCBs at USD 8.00**, with
no fine-trace surcharge for 0.10 mm, as recorded in the PO decision above.
This is bare-board quotation evidence, not a total PCBA/order price or a
manufacturing release.

Wing layer construction and design rules have not been evaluated under these
conditions and are outside this decision. Do not extend the Main baseline
to Evaluation Wings or Rev.A Wings.

**Undecided order specifications:** via-in-pad / paste-opening disposition
(the 25 observations in Issue #121 are manufacturing notes, not DRC violations)
and the assembly process for USB J1's PTH retention legs (to be checked in
[Issue #124](https://github.com/ihsinoky/he-piantor-42/issues/124)). This decision
selects neither specification nor process; pre-order manufacturing review
remains required.

## D-020 - Representative 21-key Wing 100 x 100 mm requirement relaxation

Status: accepted PO decision (2026-11-05)

The PO decision in [Issue #127](https://github.com/ihsinoky/he-piantor-42/issues/127)
on **2026-11-05** relaxes the **100 x 100 mm requirement for the representative
21-key Wing only**. Preserve the Piantor layout, the product premise based on
[D-001's geometry foundation](#d-001---one-piece-geometry), and accept these
measured design outlines:

| Pitch | Accepted representative Wing outline (W x H) |
| --- | --- |
| 16.0 mm | 110 x 100 mm |
| 17.0 mm | 116.5 x 104.75 mm |

Reason: both Piantor-based outlines exceed 100 x 100 mm. Preserving the Piantor
layout takes priority over fitting that area. These are measurements of the
generated outline vertices, not physical-board measurements; see the
[Issue #127 design record](issue-127-wing-design.md).
The historical 100 x 100 mm target in the [evaluation plan](../hardware/rev-m1/evaluation-plan.md#cost--geometry)
is **superseded for this representative Wing** by the accepted dimensions above.

This decision does not affect the dimensions of the **3 x 3 pitch-evaluation
Wings**. The independent **load21** configuration (3 x 3 plus 12 Hall-only
sites) provides electrical full-load verification coverage. Production pitch
selection remains a later measured-results/G2 decision.

This records dimensional acceptance only. Design data and generated artifacts,
including the native 100 mm fab constraint, are unchanged; routing, DRC and
manufacturing approval are not established by this decision.

## D-021 - Rev.M1 Wing two-layer and 0.10 mm design-rule baseline

Status: accepted PO decision (2026-11-05); amended 2026-11-05 (see
[Amendment](#d-021-amendment-2026-11-05-trace-width-classes))

The PO decision for [Issue #135](https://github.com/ihsinoky/he-piantor-42/issues/135)
on **2026-11-05** adopts the following design and manufacturing baseline for the
**Rev.M1 Wing (representative21, both 16 mm and 17 mm pitches)**: **two copper
layers**, **1.2 mm** finished PCB thickness, **0.10 mm trace width / 0.10 mm
clearance**, and **0.60 mm via diameter / 0.30 mm drill**. Automatic routing
under these conditions is demonstrated with KiCad Routing Tools (KRT,
escalation off).

This is a **Wing-side decision independent of
[D-019](#d-019---revm1-main-four-layer-and-010-mm-design-rule-baseline)**, which
sets the Main four-layer baseline. D-019 does not extend to Wings and this
decision does not alter Main; the two baselines are cross-referenced but decided
separately.

Reason: [Issue #131](https://github.com/ihsinoky/he-piantor-42/issues/131)
([results](issue-131-wing-condition-search.md)) completed full automatic routing
with KRT at both pitches with all four independent metrics zero (required
unconnected, wrong-net contact, physical violations, unexplained transfer
changes). [Issue #133](https://github.com/ihsinoky/he-piantor-42/issues/133)
([results](issue-133-wing-cost-check.md)) confirmed no additional cost: bare
PCBs for five boards are **USD 9.30 (16 mm)** and **USD 9.90 (17 mm)**, **USD
19.20** for both pitches. This is bare-board quotation evidence, not a total
PCBA/order price or a manufacturing release.

Reservations:

- Whether a Keyboard Design surcharge applies stays **undetermined until the
  manufacturer's file review**.
- Trace-width manufacturing tolerance is **±20%** (JLCPCB official statement).

The 3 x 3 pitch-evaluation Wings and Rev.A Wings are not covered. Production
pitch selection remains a later measured-results/G2 decision, and pre-order
manufacturing review remains required.

### D-021 Amendment (2026-11-05): trace-width classes

Status: accepted PO decision (2026-11-05), amends the original conditions above
([Issue #143](https://github.com/ihsinoky/he-piantor-42/issues/143)). The
original text above (uniform 0.10 mm trace width; PR #132 / #136) is retained
as history and is superseded only for trace width.

Changed: the trace-width condition changes from "uniform 0.10 mm" to a class
split: **signal 0.10 mm / power (HALL_5V and GND) 0.30 mm**.

Unchanged: two copper layers, **1.2 mm** PCB thickness, **0.60 mm via diameter
/ 0.30 mm drill**, **0.10 mm clearance**, and automatic routing demonstrated
with KRT (escalation off).

Reason: the demonstration in
[Issue #141](https://github.com/ihsinoky/he-piantor-42/issues/141) (PR #142)
showed all four independent metrics zero at both pitches, and the voltage drop
at the datasheet-table maximum load had positive margin in every case against
the recommended lower limit of 4.5 V.

Reservations carried over unchanged:

- Whether a Keyboard Design surcharge applies stays **undetermined until the
  manufacturer's file review**.
- Trace-width manufacturing tolerance is **±20%**.

This records the decision only; design data, board data and other documents are
unchanged.

## D-022 - Rev.M1 Main order specifications: POFV vias and J1 Economic PCBA

Status: accepted PO decision (2026-11-05)

> **監査注記（2026-11-08、Issue #205）:** D-029 の POFV 不要判断は Matrix Rev.3 限定で、この旧 Main 仕様を取り消さない。Main Rev.3 の撤回提案 D-030 は未確認（PO 判断待ち）。D-033 は Main Rev.4 の J1 を UDB に分離し、同版の通常 tented／非POFVは業者 DFM 待ちの提案として記録する。旧版や UDB 全体の工程へ一括適用しない。 詳細・根拠は [監査報告](issue-205-adr-audit.md)。

Per the PO decision of 2026-11-05 ([Issue #145](https://github.com/ihsinoky/he-piantor-42/issues/145)),
this decision **finalizes the two order specifications that
[D-019](#d-019---revm1-main-four-layer-and-010-mm-design-rule-baseline) left
undecided**. The basis is the investigation in
[Issue #137](https://github.com/ihsinoky/he-piantor-42/issues/137)
(PR #139, merged; [report](issue-137-main-manufacturing-review-prep.md)).

1. **Via treatment:** explicitly specify **epoxy-filled and copper-capped vias
   (POFV)** at order time for vias in pads (25 locations, centered on the 23
   where the hole falls on a mounted-component pad). The routing demonstrated in
   [Issue #121](https://github.com/ihsinoky/he-piantor-42/issues/121) is kept;
   **no design-side via avoidance is made**.
2. **USB J1 assembly:** mount the SMD terminals and the four PTH retention legs
   **together in the same Economic PCBA order**. The hand-soldering process fee
   (USD 0.0164 per joint + USD 3.58 per order, **USD 3.9080 for five boards**)
   is already included in the [Issue #124](https://github.com/ihsinoky/he-piantor-42/issues/124)
   estimate. **No move to Standard PCBA.**

Items to confirm at order time:

- The POFV surcharge for four layers / five boards.
- How the manufacturer's supported via size is stated (outer diameter or hole
  diameter) and whether our 0.60 mm / 0.30 mm vias qualify.
- The final scope of vias subject to filling.
- J1's PTH legs and NPTH holes are **excluded** from filling.

D-019's other content is unchanged. This records the decision only; it is not
a manufacturing release or an order, and design data, board data and other
documents are unchanged.

## D-023 - Rev.M1 Main mounting revision: plan A, retained 48 x 44 mm outline

Status: accepted PO decision (2026-11-06)

> **監査注記（2026-11-08、Issue #205）:** D-024 の第2ポート、D-025 の外形変更では4穴を維持する。D-033 は Main Rev.4 に限り三角形／3穴へ置換する。旧版の4穴記録を Rev.4 の穴数として使わない。 詳細・根拠は [監査報告](issue-205-adr-audit.md)。

Per [Issue #155](https://github.com/ihsinoky/he-piantor-42/issues/155), adopt
**plan A** from [Issue #153 Stage 1](issue-153-main-mounting-stage1.md#2-第一案a48×44mm4穴部品ビア固定)
for reuse of Main in ver.A: retain the **48 x 44 mm** outline
(KiCad absolute X76–124 / Y78–122) and add four **non-plated Ø2.2 mm**
mounting holes in a non-rectangular pattern:

| Hole | KiCad absolute X, Y (mm; top view, X right, Y down) |
| --- | --- |
| H1 | 79, 92 |
| H2 | 121, 81 |
| H3 | 79, 119 |
| H4 | 102, 111.5 |

Reserve **Ø5.0 mm on every copper layer**, prohibiting tracks, vias and copper
pour. NPTH holes carry no net; use the Wing rule-area treatment from #131 so
the mechanical NPTH itself is not reported as a prohibited copper pad. Check
existing copper pads independently. Preserve all existing components, nets,
J1/J2 positions and the electrical interface. Use the #121 qualified PCB and
its corresponding input project as the revision baseline.

The basis is #153 §2 and §5 and its
[plans.json](../hardware/kicad/qualification/issue-153-main-mounting-stage1/plans.json):
no component, pad or existing via intersects the nominal reservations; three
segments (VBUS, WING_EN, GND) require rerouting and the GND plane requires
refilling. Try local rerouting first, then at most the explicitly scoped full
reroute within Issue #155's timebox. Retain **D-019** routing/stackup conditions
and **D-022** POFV and J1 Economic PCBA specifications; reclassify via treatment
after routing rather than carrying forward the old counts as new measurements.

Candidate fastening uses M2 through screws and insulating spacers, with head,
washer and contacting boss projected diameter **at most Ø4.5 mm**, no countersink.
Actual tolerances, tightening, non-rectangular support under J1/J2 insertion
loads, tool access and underside solder/boss clearance remain mechanical
validation items. This adopts the layout; qualification and manufacturing
review remain required. It does not authorize ordering, billing or merge.

## D-024 - Rev.M1 Main two-Wing interface and plan A / plan C fallback

Status: accepted PO scope decision (2026-11-06); implementation remains subject
to the mechanical gate and independent qualification

> **監査注記（2026-11-08、Issue #205）:** 案A配置は D-025 の案C採択へ、機構の先行ゲートは D-026 の設計先行方針へ、入力境界は D-027 へ部分更新。D-033 は Main Rev.4 の外形／UDB／200mmを更新する。GH14 pin配置・共通バス・独立enableは継承する。 詳細・根拠は [監査報告](issue-205-adr-audit.md)。

[Issue #160](https://github.com/ihsinoky/he-piantor-42/issues/160) adopts the
interface proposed in [Issue #157 §2–4](issue-157-main-dual-wing-stage1.md)
as a two-Wing extension of D-017. J2 is L/Bank0; added J3 (`J_WING_R`) is
R/Bank1. Both use BM14B-GHS-TBT(LF)(SN), GHR-14V-S and SSHL-002T-P0.2.
Preserve the existing G0B pin allocation: pin1 HALL_5V; pins2/4/8/10/12/14
common GND; pins3/5/6 MUX_A0/A1/A2; pins9/11/13 MUX_OUT_A/B/C; pin7 is
the respective independent enable. Reinforcement lands remain mechanical NC.
No GND contact becomes an ID or other signal.

Share address and the three raw MUX buses, retaining the existing three
divider/filter/ADC paths. Feed both Wings from common HALL_5V with two branches
near U5 output, not a thin J2 daisy chain or external Y cable. U5 and
HALL_PWR_EN (U1.9/GPIO7, R7 100kΩ) remain the common default-off power control.
Existing J2 WING_EN is logical MUX_EN0 (U1.7/GPIO5, R6 100kΩ).
J3 pin7 uses new MUX_EN1 at U1.8/GPIO6 with a new explicit 100kΩ external
pull-down; remove that pin's source NC declaration when implementing it.
Check leakage/noise and transitions before accepting the pull-down value.

Firmware must disable both banks before address/bank changes, wait for actual
output disable and address settling, then enable only one bank and wait for
ADC settling. Simultaneous enables are prohibited. Reset, unstable power,
suspend and faults require both banks off. Verify 2 banks × 7 addresses ×
3 ADC channels, single-Wing operation and L/R calibration mapping. Enable
selection does not turn off Hall power or halve the supply load.

Use one nominal 100mm, 14-individual-wire, fully 1:1 representative G0B harness
per port, with all six returns. Same-type connectors do not mechanically
exclude L/R interchange: label both ends, constrain the case paths and verify
all 28 circuits and left/right key identity during assembly. Longer/asymmetric
product harnesses need renewed power and settling evaluation. Hot-plug is
not qualified; initial evaluation uses power-off mating/unmating.

The adopted first placement is **plan A: J3=(105,81), 0°, 48×44mm**.
Retain D-023's four NPTHs, coordinates and all-copper-layer Ø5 reservations,
J1/J2 positions and existing components. The exception to D-023's electrical
preservation is limited to this approved second port, enable/pull-down and
necessary power/signal routing. Verify actual housing, cable bends, latch,
finger/tool access and fastening tolerances. If plan A cannot be established
or presents too many disadvantages, **record the evidence, propose plan C
and stop**; do not force the layout or shrink an unverified service envelope
to declare success. Plan C is J3=(105,73), 0°, X76–124/Y70–122 (48×52mm),
retaining the four holes. It is a fallback proposal requiring PO approval
before changing the outline, not an automatically adopted board revision.

Plan for 127mA per Wing / 254mA total and also evaluate the #141
11mA-per-sensor sensitivity envelope. Reduce Main power-path resistance;
simple branching of the current thin path is insufficient. Use actual routed
common and branch supply/return resistance, harnesses and Wing networks to
show the farthest sensor remains at least 4.5V over the declared conditions;
do not substitute TPS22919's current rating for USB or local-voltage evidence.
Identify any unachievable envelope instead of relaxing it. Check startup,
ground sharing, address loading, bus contention, ADC noise and settling.

D-019 remains four layers / 1.2mm, signal width and clearance 0.10mm,
via 0.60/0.30mm, In1.Cu GND plane. Deliberately wider power paths implement
the low-resistance requirement; do not reduce any minimum, change layer
assignment or enable escalation. Freeze routing scope and attempt/time
limits before routing; no unbounded retry. Requalify all nets against the
input project with all four independent metrics zero. Regenerate and
reconcile manufacturing data, reclassify actual revised vias under D-022's
epoxy-fill/copper-cap POFV policy, retain J1's same Economic PCBA process,
and update BOM/CPL and quotation evidence only after the applicable gates.
Neither this decision nor prior-board qualification qualifies a new revision
or authorizes manufacturing release, ordering, billing or merge.

## D-025 - Rev.M1 Main two-Wing plan C outline and J3 placement

Status: accepted PO decision (2026-11-06)

> **監査注記（2026-11-08、Issue #205）:** 機構確認を本作業の先行ゲートとする条件は D-026 で後段へ移された。外形／穴／配置は Main Rev.4 の範囲で D-033 へ置換する。機構確認の合格を意味しない。 詳細・根拠は [監査報告](issue-205-adr-audit.md)。

Per [Issue #163](https://github.com/ihsinoky/he-piantor-42/issues/163), adopt
**plan C** following the [Issue #160 mechanical gate](issue-160-main-dual-wing-stage2.md):
extend Main north by **8 mm** to **48 x 52 mm**, KiCad absolute
**X76–124 / Y70–122**, and place **J3 = (105,73), 0 degrees**.
This supersedes D-024's initial plan A placement and the requirement to obtain
PO approval before adopting that specific plan C outline.

Retain D-023's four mounting holes, their coordinates and all-layer diameter
5 mm copper reservations. Preserve J1/J2 and existing component coordinates.
D-024's electrical interface remains adopted: common Hall power, address and
three ADC paths, independent enables with MUX_EN1 at U1.8/GPIO6 and a new
100 kohm pull-down, and two power branches near U5 output. D-019 routing and
D-022 POFV / J1 Economic PCBA conditions remain in force.

Outline adoption does not establish mechanical or electrical qualification.
Issue #163 must concretize screw/tool handling, latch release, cable height
and the insertion/extraction load on the north overhang, reduce and evaluate
the routed power resistance, and independently requalify every net before
manufacturing outputs or quotation can be accepted for the revised board.
If the conditions cannot be established, record the state and stop without
relaxing conditions or unbounded retries. This decision authorizes no order,
charge, manufacturing release or merge.

## D-026 - Main two-Wing implementation: design-first mechanics and regulated 5.2 V

Status: accepted PO scope decision (2026-11-06); electrical implementation and
qualification are not established by this decision

> **監査注記（2026-11-08、Issue #205）:** D-027 は変換器入力4.75V要求を Main USB コネクタの入力範囲へ置換する。5.2V方式、127mA/Wing、出力・抵抗目標は維持。Main Rev.4 の形状と200mmハーネスは D-033 に従う。 詳細・根拠は [監査報告](issue-205-adr-audit.md)。

Per [Issue #167](https://github.com/ihsinoky/he-piantor-42/issues/167), retain
D-025 plan C: X76–124 / Y70–122 (48 x 52 mm), J3=(105,73), 0 degrees,
four fixed mounting holes with their all-layer diameter 5 mm reservations,
and all existing component coordinates. Adopt mechanical policy **(b), design
first**. The ver.A enclosure must provide support near J3; measure GH latch
operation and insertion/extraction forces early on M1 hardware. These physical
checks remain downstream verification items and are **not gates for Issue
#167**. This supersedes the physical-mechanics gates in D-024/D-025 for this
work, without declaring those checks passed.

Adopt [Issue #165's recommendation](https://github.com/ihsinoky/he-piantor-42/pull/166):
a regulated **5.2 V rail**, using a TPS63070-class buck-boost in **forced PWM**,
followed by the common default-off U5 and two low-resistance power branches
near its output. D-009's direct switched-VBUS supply is superseded for this
revision. Retain D-024's interface, common address/raw ADC buses and independent
enables: GPIO5/WING_EN is logical MUX_EN0; GPIO6/U1.8 is MUX_EN1 with an
explicit 100 kohm pull-down and its previous NC declaration removed when
implemented. HALL_PWR_EN/GPIO7 and its external pull-down retain common
default-off control. Disabling a MUX bank does not reduce the Hall supply load.
Lower Wing conductor resistance remains a ver.A Wing design requirement;
this Issue implements the Main side only.

The adopted design load is **127 mA per Wing**, continuously supplied on both
ports. The farthest sensor target is **4.60 V**, retaining 100 mV above the
4.5 V lower limit for unmodelled effects. Target extracted Main common and
per-branch loop resistances of **at most 50 milliohm each**. Retain the #165
5.2 V rail tolerance target of +/-2% and downward ripple/transient budget of
50 mV; verify high-side and startup limits as well. Include the inherited
100 mm harness/contact, width-minus-20% and 125 degrees C resistance
sensitivities without presenting them as a whole-product ambient guarantee.
The **11 mA per sensor envelope is recorded as stress only**, outside the
adopted guarantee; it must not replace or reduce the 127 mA design load.

Demonstrate **4.75 V at the converter input**, accounting for upstream USB
losses and other Main loads, and reconcile total current with USB permission
before claiming the supply qualified. The value is a requirement to establish,
not an assumed USB source guarantee. Final component selection, actual routed
resistances, startup, suspend, reverse feeding, noise and ADC settling require
their own evidence. D-019 and D-022 remain unchanged: no width/clearance/layer
or escalation relaxation, bounded routing, independent all-net qualification
with all four metrics zero, regenerated manufacturing data, actual-via POFV
classification and J1's same Economic PCBA process. If electrical conditions
cannot be established, record the state and stop. No order, charge,
manufacturing release or merge is authorized.

## D-027 - Main USB input requirement at the board connector

Status: accepted PO requirement redefinition (2026-11-06)

Per the [Issue #167 resume instruction](../hardware/kicad/qualification/issue-167-main-dual-wing-stage2/resume/instructions-167-resume.md),
replace D-026's requirement to demonstrate 4.75 V **at the converter input**.
The previous run established that a USB source at its permitted 4.75 V lower
limit cannot deliver 4.75 V after any positive cable/contact/board resistance
under load. This was a requirement-location problem, not evidence that a
buck-boost cannot regulate below 4.75 V. Preserve that run and its input-budget
evidence; its stop is superseded only by this explicit PO decision.

Define input at the **Main USB connector**, referenced to local connector GND.
For configured high-power USB 2.0 operation, use **4.50–5.25 V**: USB 2.0
Revision 2.0 sections 7.2.1.4 and 7.2.2 specify the 4.75 V upstream lower
limit and maximum detachable-cable drops of 125 mV on VBUS and 125 mV on GND;
4.75 - 0.125 - 0.125 = 4.50 V at the device. The 4.40 V enumeration condition
and Figure 7-47's low-power path must not be confused with a grant to draw
500 mA from a bus-powered low-power hub. Subtract the implemented Main input
path drop separately when checking converter operating range and current.
A USB-C connector and CC pull-downs do not themselves grant extra current.

Across this input range, retain the **5.2 V rail +/-2%** accuracy requirement
and **50 mV per-side ripple/transient budget**. At **127 mA per Wing**, show
converter input current plus all other Main loads within the **configured
USB allowance of 500 mA**, with explicit maximum-load estimation assumptions
and evidence. Configuration permission is required before enabling the
converter, U5 or either MUX; reset, unconfigured and suspend states must keep
them off. Distinguish guaranteed component limits, engineering allocations,
and unmeasured prototype behaviour. A typical efficiency curve alone is not
a guaranteed worst-case current bound.

The output guarantee is unchanged: farthest sensor **4.60 V design target**
at the design load, inherited harness/contact/copper-temperature sensitivities,
and Main common/branch loop resistance targets of at most 50 milliohm each.
The 11 mA-per-sensor envelope remains stress-only. D-025/D-026 geometry,
mechanics policy (b), forced PWM, common default-off U5 and two low-resistance
branches remain adopted. D-019's routing conditions and bounded attempts,
all-net independent four-zero qualification, regenerated manufacturing data,
D-022 POFV classification and same Economic PCBA process for J1 remain
mandatory. No relaxation of output targets, unbounded retry, order, charge,
manufacturing release or merge is authorized.
## D-028 - Dual-pitch Matrix Rev.2 evaluation board (naming per Issue #179 convention)

Status: accepted PO scope decision (2026-11-06), per
[Issue #178](https://github.com/ihsinoky/he-piantor-42/issues/178)
(corrected body: 16 mm and 17 mm; the old issue title is not the specification)

Board names follow the naming convention of Issue #179 (phases and board
revisions are separate; M1 names the evaluation phase only). The boards in
scope are **Main Rev.2 (two Wing ports), Matrix Rev.2 (this evaluation
board), and Wing Rev.1 (the left/right 21-key boards)**. The matrix board measures
Hall-effect interaction while multiple keys are pressed and compares key pitch;
it does not select a production pitch or qualify magnetic behaviour by geometry
alone. The 16.5 mm variant is outside this scope.

Replace the two separate pitch9 evaluation candidates (Matrix Rev.1) for this evaluation
with **one board carrying a 16 mm 3 x 3 field (9 keys) and a 17 mm 3 x 3 field
(9 keys), 18 keys total**. Keep three TMUX1208 banks. Bank A/B/C serves the
same column A/B/C in both fields: addresses 0/1/2 are the three rows of the
16 mm field, addresses 3/4/5 the three rows of the 17 mm field. S7/S8
(addresses 6/7) and the physical NC pin remain unconnected. Keep the D-017
GH14 interface, including all six GND contacts, common address/enable and
three analog outputs; do not add or repurpose interface pins.

Target at least **34 mm between the nearest key centres of different fields**;
report the achieved distance and native-board basis. Preserve each field's
unmodified 16/17 mm pitch. Mounting fixtures, magnet height and actual magnetic
isolation remain physical evaluation items.

For this matrix board, explicitly apply the D-021 amended routing conditions:
**2 copper layers / 1.2 mm, signal 0.10 mm, HALL_5V and GND 0.30 mm,
clearance 0.10 mm, via 0.60/0.30 mm, KRT escalation off**. This extends those
conditions to this evaluation board despite D-021's historical exclusion of
separate pitch9 boards; it does not alter the representative21 baseline.
Require independent all-net qualification with all four metrics zero and
Gerber plus JLCPCB-format PCBA BOM/CPL from the qualified revision.

The implementation and evidence are in
[Issue #178 report](issue-178-m1-matrix-board.md). Passing routing/DRC does not
establish magnetic interaction, harness/ADC settling, manufacturer PCBA
acceptance or manufacturing release. No order, charge or merge is authorized.

## D-029 - Matrix Rev.3: keep every via clear of component pads; no POFV

Status: accepted PO design policy (2026-11-06), per
[Issue #182](https://github.com/ihsinoky/he-piantor-42/issues/182).

For the matrix board, **do not overlap any component copper pad with a via**,
including bare testpads, NC lands and connector reinforcement pads. Require
**at least 0.10 mm from every via's outer copper annulus to every pad's copper**,
irrespective of net. Independently audit every via and retain its minimum gap.

**Matrix Rev.3 does not require epoxy filling or copper capping (POFV)** because
its qualified routing meets that condition. This supersedes the Matrix Rev.2
fabrication note requiring all 146 vias to be filled/capped, only for the Rev.3
data package. It does not change Main's D-022 via treatment or retroactively
qualify Rev.2 artwork. Ordinary plated through vias and inherited mask tenting
are retained; do not use the Rev.2 artwork with the Rev.3 process note.

Keep Rev.2's component placement, board outline, GH14 interface and electrical
configuration. Retain D-021 unchanged: **2 copper layers / 1.2 mm; signal
0.10 mm; HALL_5V/GND 0.30 mm; clearance 0.10 mm; via 0.60/0.30 mm; KRT
escalation off**. Require all four independent all-net qualification metrics
zero, plus the all-via pad audit, before regenerating manufacturing data.

The [Rev.3 report](issue-182-matrix-rev3.md) records the qualified result and
manufacturing evidence. Manufacturer DFM and assembly orientation review remain
later release tasks. This decision authorizes no order, charge or merge.
=======
>>>>>>> origin/main

## D-030 - Main Rev.3 via relocation to remove the POFV design requirement

Status: Issue #185 implementation proposal; pending PO review / merge (2026-11-06)

> **監査注記（2026-11-08、Issue #205）:** **未確認（PO 判断待ち）**。実装は PR #187（f04ef1b7）でマージ済みだが、POFV 要求撤回の方針採択は PO の明示確認が未了。Issue #205 と PMO 引継ぎに従い Accepted にしない。採択日も未確認。D-033 は別版の判断であり、本提案の遡及採択ではない。 詳細・根拠は [監査報告](issue-205-adr-audit.md)。

Per [Issue #185](https://github.com/ihsinoky/he-piantor-42/issues/185), Main Rev.3
relocates the 35 vias that failed the [Issue #183 audit](https://github.com/ihsinoky/he-piantor-42/pull/184)
from the qualified Main Rev.2 board in PR #176. All 66 footprint positions and
orientations, existing 693 track segments and all 113 via identities are retained.
The 33 straight-connection candidates are implemented first, followed by the two
local connection cases at C5.2/GND and C4.1/V3V3. No whole-board routing is used.

The [Issue #185 report](issue-185-main-rev3.md) records all four independent metrics
at zero across all 44 nets after GND zone refill. All 113 vias have annulus-to-pad
copper clearance at least 0.10 mm, including same-net and bare test pads. Via
copper and drills overlap neither paste layer. The extracted 125°C / track-width
−20% model gives common loop **41.135 mΩ**, J2 branch **24.834 mΩ**, and J3 branch
**26.095 mΩ**, preserving the 50 mΩ common/branch targets. These are model values,
not finished-board resistance or operating-performance guarantees.

For this qualified Rev.3 package, propose removing D-022's **epoxy-filled and
copper-capped POFV** order requirement: there are no remaining via-in-pad sites.
Keep the exported solder-mask settings and request ordinary tented vias, subject
to manufacturer DFM acceptance. This applies only to the new Rev.3 package;
D-022 continues to describe the previous boards. Keep D-022's J1 SMD contacts and
four PTH shell legs in the same Economic PCBA process. D-019 remains four layers,
1.2 mm, minimum track/clearance 0.10 mm and via 0.60/0.30 mm, with In1.Cu GND.

Regenerated Gerber/drill/paste/BOM/CPL and CAM checks accompany the proposal.
This change does not adopt quotation-only substitute parts, guarantee a cost
reduction or constitute manufacturing release. Vendor acceptance, revised
quotation, material minima, procurement and physical validation remain separate.
No order, charge or merge is authorized or performed.

## D-031 - Knowledge recording: ADR, Finding Records, and promotion

Status: accepted PO decision (2026-11-07); piloted in this project

Knowledge in this project is kept in three layers:

- **Judgments** continue as ADR in this file (D-xxx). Only significant
  decisions record options, rejection reasons and verification method in
  full. Finalized records are not edited; a change supersedes the old
  record.
- **Empirical findings** are recorded in
  [findings.md](findings.md) — a single ledger at first, split into
  `docs/findings/NNNN-*.md` when it grows. Every entry requires: a
  conclusion with confidence and trial count; the conditions tried (exact
  tool versions, target commit, parameter ranges); failed attempts (one
  line each); a validity scope (untested ranges, assumptions, invalidation
  conditions, re-verification triggers); evidence links (raw logs live in
  Issues/PRs and are not duplicated); and a `Promoted to` field.
- **Lessons** are not kept as a separate register. When rework occurs, the
  process that would have prevented it is written as a process definition
  (for steps needing judgment) or a skill (for steps an agent executes);
  the Finding keeps only its `Promoted to` reference.

Not maintained: a lessons register, AAR, postmortem documents, design
doc/RFC, runbook, and tech radar (the last is trigger-based only).

## D-032 (draft) - Wing Rev.2 baseline (Issue #194)

Status: **Draft for PMO review; not an order or production release**.

> **監査注記（2026-11-08、Issue #205）:** **2026-11-07、PR #195 の PO マージゲートで採択済み。その後 D-034 で部分置換。** Issue #205 と PMO 引継ぎを a313ca4f／Phase B 報告書に照合した。旧 Draft 表記と見出しは履歴／アンカー維持のため保存する。外形、GH／サービス部品、南側穴、100mm前提は D-034 へ。キー中心、Hall姿勢、locator等の継承条件は有効。製造GOではない。 詳細・根拠は [監査報告](issue-205-adr-audit.md)。

Adopt the approved Phase A Stage 1 key centers and thumb poses, C0=0 degrees,
with separate left/right 21-key boards at both 16 and 17mm pitch. Outlines have bounds
117.2x82.698516mm (16mm) and 123.2x86.698516mm (17mm). Per the PO decision
on 2026-11-07, trim the south edge to the full switch-envelope limit and
chamfer the south inner corner by 3.956/3.928mm from the former corner.
Move the outer south mounting center with the edge and move the inner south
center north by 15.8mm, preserving the fixed coordinate frame and all key
centers. See the exact five-vertex contours and four mounting centers in
the Issue #194 report and generated case CSVs. All 21 DRV5055 DBZ
sensors and their local 100nF capacitors are on the bottom. MUX/GH14 remain on
top. Native bottom transformations preserve the physical pin map. Calibrate
active point to land origin by F=K-R(theta)delta, delta=(0,0)mm nominal,
using TI Rev.C Figure6-5 and the body-centered Wing land; device XY tolerance
+/-0.05mm remains separate.

Adopt nominal locator pairs +/-5.08mm in the key frame and completed NPTH
1.70+/-0.05mm from the Jade Pro manufacturer's drawing grid. This design
adoption does not certify physical fit: no fabricated Jade Pro fit data was
available. Complete a sample fit and supplier tolerance review before ordering.
Keep D-017's GH14 pin map, six GND conductors, 100mm 1:1 harness, 3x7 MUX
assignment, S8 NC and independent Main enable control.

D-021 applies: two copper layers, 1.2mm PCB, signal tracks >=0.10mm,
HALL_5V/GND tracks >=0.30mm, clearance >=0.10mm, ordinary through vias
0.60/0.30mm. Supplementary HALL_5V front and GND rear pours implement the
Wing conductor improvement requested by #165. Verify their actual filled
connectivity; copper area is not a system voltage-drop guarantee.

All four boards require independent zero required opens, wrong-net contacts,
material violations and unexplained placement/pin transfer changes. Also audit
every via against every copper pad, including same-net pads, for edge gap
>=0.10mm, with actual minimum and distribution reported. Avoid the limit by
routing with 0.15mm same-net pad target and explicit native-checked local
margin repairs. The qualified package uses ordinary vias without POFV.

Manufacture each pitch as one left/right panel with electrically independent
halves, copper-free routed separation tabs and Standard PCBA for the two
assembly sides. Review panel rails, tooling, mouse bites, bottom pin1 and CPL
machine rotations with the assembler before ordering. Keep pitch selection,
magnetic polarity/response, stack/locator fit, cap clearance and loaded-system
power acceptance as physical gates. See [the Phase B report](issue-194-wing-rev2-stage2.md).

## D-033 - Main Rev.4 triangular baseline and separated UDB

Status: accepted 2026-11-07 (PO merge gate, PR #197).

> **監査注記（2026-11-08、Issue #205）:** **2026-11-07、PR #197 の PO マージゲートで採択済み。** PMO 引継ぎ、既存 Status、90c8314b／Phase B 報告書を照合した。本文の draft／merge禁止は採択前の記録として保存する。D-017 の100mm、D-025 の外形、D-023 の4穴、D-022 のオンボードJ1工程の変更は Main Rev.4 限定。通常 tented／非POFVの提案、再見積・業者DFM・製造リリースの別ゲートは保持する。 詳細・根拠は [監査報告](issue-205-adr-audit.md)。

Use the accepted Phase A-2 triangle (75.785364 × 65.632051 mm bounding box),
59 electrical components and three φ2.2 NPTH mounting holes. J2/J3 remain
BM14B-GHS-TBT(LF)(SN), aligned to the slopes and mating from above (+Z).
Each hole keeps its all-layer copper reservation of diameter 5.0004 mm.
This supersedes D-025's previous Main outline and D-023's four-hole arrangement
for this Rev.4 package only.

Separate USB onto the PO-owned UDB C3. Remove Main J1, CC R1/R2 and data ESD U2;
retain the RP2040-side 27 Ω R3/R4. Add J4 SM04B-SRSS-TB(LF)(SN), LCSC C160404,
with 1:1 pins 1=protected VBUS, 2=D−, 3=D+, 4=GND. This replaces D-022's
onboard USB-C assembly policy for Main Rev.4. The C3/SH case datum and physical
cable assembly remain review items.

**Supersede D-017's 100 mm GH harness length for Main Rev.4 with 200 mm × 2.**
Keep D-024's electrical skeleton and pin assignments, regulated 5.2 V rail,
TPS63070-class converter, RP2040 and common default-off supply control. The
resistance model requires full 200 mm conductor paths, AWG28-equivalent minimum
0.0804 mm² copper area and six return wires. Do not shorten the model to a chord
or inherit the old 100 mm voltage-drop result.

Keep D-019: four layers, 1.2 mm, minimum 0.10 mm track/clearance, 0.60/0.30 mm
vias and In1.Cu dedicated GND. The [Phase B report](issue-196-main-rev4-phaseb.md)
records four independent metrics at zero, all 130 vias clear of pads by at least
0.145 mm, and common/branch loop resistance below 50 mΩ in the extracted model.
At 127 mA/Wing with the explicit 200 mm harness model, the worst far-end voltage
is 4.797985 V. These are design-model results, not measured manufacturing bounds.

Use the Rev.4 manufacturing package and quote handoff from the report. Ordinary
tented vias without POFV are proposed for this package, subject to manufacturer
DFM. Requote through PMO; do not reuse Rev.3 pricing. This draft authorizes no
order, charge, merge or manufacturing release. Prior revision artifacts retain
their own baseline and qualification history.

## D-034 (draft) - Wing Rev.3 baseline (Issue #200)

Status: **Accepted 2026-11-07 (PO merge gate, PR #201)**. Harness length: 200mm retained (PO decision 2026-11-07, confirming D-033) — the Stage 2 power re-verification showed the farthest point at 4.943V with 200mm vs 4.946V at the ~124mm route length, a ~3mV difference, so voltage is not a deciding factor; the slack is absorbed by the case service-loop storage (Issue #198).

> **監査注記（2026-11-08、Issue #205）:** **2026-11-07、PR #201 の PO マージゲートで採択済み。見出し draft は表記不整合。** PMO 引継ぎ、既存 Status、932b880c／Stage 2 報告書を照合した。見出しと本文の draft は履歴／旧アンカー維持のため保存し、この注記で状態を補足する。D-032 の指定範囲を置換し D-033 の200mmを保持する。124mmへの短縮決定や発注／製造GOではない。 詳細・根拠は [監査報告](issue-205-adr-audit.md)。

For Wing Rev.3, supersede D-032's outline, GH/service-component placement,
south mounting-hole placement and inherited 100mm harness assumption. Keep
D-032 as the historical Rev.2 record. Use the Stage 1b broad north shoulder
with R5 reentrant corner and stepped south trim in
`hardware/case/issue-200-stage1/geometry.json`. Preserve Rev.2 key centers,
Hall/local capacitor poses, physical bottom pin transforms, nominal active
point delta=(0,0), locator pairs +/-5.08mm and completed NPTH1.70+/-0.05mm.
Generate both pitches and both sides individually; never mirror copper pads.

Put GH14 at assembly (-27,-41)/(27,-41)mm; relocate all three MUX, their
capacitors and all 15 testpoints into the north service area. Keep the Stage 1
mounting candidates: H1 left (3,-5)/(4,-6)mm at 16/17mm; H3 right uses the
negative X. Other mounting centers remain Rev.2. Retain four phi2.2 NPTHs
and full phi5 all-copper reservations. Case CSVs are in
`hardware/case/issue-200-rev3/`.

Keep D-021: two layers, 1.2mm, signal >=0.10mm, power/GND >=0.30mm,
clearance >=0.10mm and ordinary via0.60/0.30mm. Use filled HALL_5V on the
front and GND on the back; reserve the full southern 2mm strip against signal
tracks and vias. Use the two-layer power copper in this strip as the power
spine and GND band, with mounting exclusions bypassed through interior copper.
Require native DRC zero and independent four metrics zero on every board;
audit every via against all pads, including same-net and NPTH, >=0.10mm,
with a 0.125mm-class practical minimum. No POFV is specified.

D-024's electrical interface, six GND conductors, GH14 1:1 wiring, three
seven-channel MUX groups, unused S8 and independent Wing enable remain.
**The adopted Main Rev.4 harness length is still 200mm per D-033.** Evaluate
both the new route's 124.097mm requirement and 200mm, using newly extracted
Rev.3 copper resistance instead of the old Issue #141 Wing drop. This draft
makes no decision to shorten the procured harness. Keep 127mA/Wing as the
design load and the documented Main/rail/contact/temperature worst corner.

Use the report's Main overhead route and Z reservation. Phi2 is only the old
screening diameter; the 14-wire assembly must fit the proposed <=phi5 envelope,
R5 bends and 8mm GH mated-height reservation. Transfer the required cable/lid
clearance and GH overhead access space to Issue #198. Real harness OD, bend
radius, strain relief, 200mm surplus storage and mating remain fit checks.

Each pitch uses one electrically independent left/right manufacturing panel,
with copper-free mouse-bite tabs and rails. Standard PCBA is required for
bottom Hall/local capacitors and top MUX/GH assembly. Keep DFM, tab separation,
locator fit, pin1/machine CPL rotation, magnetic response, noise and assembled
power acceptance as the existing physical gates. This draft authorizes no
order or quotation. See [the Stage 2 report](issue-200-wing-rev3-stage2.md).

## D-035 - Main Rev.5 Fly Daughterboard connector proposal

Status: **提案（2026-11-10、Issue #221）。未採択。実装・データ上の検証完了、POマージゲート待ち。**

Main Rev.5 の J4 を JST SM04B-SRSS-TB(LF)(SN) / C160404 から
Molex Pico-EZmate **781710004 / C588524** へ変更する。PO在庫はGeon × Wolf Fly DBで、
変換ケーブルを追加せず同梱EZmate↔EZmate 1:1ケーブル170mmを用いる。
[POの追加確認](https://github.com/ihsinoky/he-piantor-42/issues/221#issuecomment-6750942420)により、付属ケーブルで直接接続し、ケーブルの別途調達は不要。
採択時に限り D-033 の **Main側USBドーターボード用コネクタ部分**を supersede する。
外形・3穴・J2/J3・全他部品配置・ネット構成・5.2V電源設計・200mm GH条件を継承する。
Matrix／Wingデータを変更しない。

ピン順は1=VBUS、2=USB_DM_ESD（D−）、3=USB_DP_ESD（D+）、4=GNDを維持する。
直接のFly番号付き回路図を得たという意味ではなく、
[PMOの再開判断](https://github.com/ihsinoky/he-piantor-42/issues/221#issuecomment-6750886847)
が承認した次の文書チェーンを根拠とする。

1. Rev.4のPCB・回路図XML・BOMで現行J4ピン順を照合済み。
2. Fly公式販売店CannonKeysの[ケーブル規約](https://cannonkeys.com/products/molex-and-jst-cables)
   がMolex↔JSTの1:1／UDB互換を明示し、[Fly販売情報](https://cannonkeys.com/products/fly-daughterboard-and-molex-cable)
   はFlyとMolexケーブルの組合せを扱う。
3. [Geon公式情報](https://geon.works/products/fly-daughter-board)と設計者のUDB代替という位置づけ、
   [UDBプロジェクトの説明](https://hackmd.io/w7rV9b1fRHau51bIx631Hw)のGeon Flyも同じケーブルを使うという説明を結び付ける。
4. 共通ケーブルを用いるUDB互換製品としての主張をピン順同一の根拠として採用する、というPMO判断。
   これは資料の互換性主張からの判断であり、線色・写真だけからの割付ではない。

**初回通電前に必ず実測する。** Mainへ未接続のFly単体をUSB電源につなぎ、
同梱ケーブル先端で端子4を基準に端子1が+5V（VBUS=5V／GND=0V）であることを測定・記録する。
電源を切ってからMainへ接続する。極性異常なら接続・通電しない。USB認識も初回組立で確認し、
D+/D−の取り違えが実証された場合のみRev.5.1で是正する。実測は本作業では未実施。

Molex図面781710000-SD Aの推奨信号ランド0.60×0.85mm/pitch1.20mm、補強0.70×0.80mmを照合した。
J4原点(100,90)mm・180°を維持し、局所のF.Cu3線分を削除・11線分を追加。via変更0。
DRC/ERC/未配線0、40ネットの独立銅箔検査0異常、130via×232padの最小間隔0.145mm。
入力往復抵抗モデルは44.910→48.686mΩ（+3.776mΩ）、下流最遠点4.797986Vを維持。
電源の実材質・完成Fly上流抵抗・効率を測定した保証ではない。

Rev.5 Gerber ZIP/BOM/CPL/GerberフレームCPL/quote-handoffを新生成しCAMと全55配置点を独立照合した。
頻繁に抜き差ししない内部接続用途（挿抜10回級）。実在庫、ステンシル、業者DFM・pin1/回転受入れ、
完成配索・機構・初回通電実測は別ゲート。
[報告書と検証証跡](issue-221-main-rev5.md)をPOゲートへ提出する準備まで完了。
採択・発注対象の正式切替・製造GOは行わず、push/PR作成/発注もしない。

## D-036 - Main Rev.6 triangular vertex chamfers

Status: **Adopted (2026-11-12, Issue #226, PR #227). PO approved the 4 mm chamfers at the merge gate.**

The PO identified the three sharp Main tips as a handling hazard. Rev.6 is Rev.5 plus an equal-leg **4 mm chamfer at each of the three approximately
60° vertices**. Each new face is approximately 4 mm long, removing 3.464 mm of
tip depth and replacing the original vertex with two approximately 120° corners.
This is a substantive cut while retaining all three Ø2.2 mm mounting holes and
their full Ø5 mm support disks. The nearest new edge is 2.382050 mm from a hole
boundary; the minimum support-disk margin to the entire outline is 0.946152 mm.
Larger 6 mm legs would leave only about 0.65 mm to a hole boundary, and would
cut into the Ø5 mm support area; 4 mm retains practical mechanical margin.

All 62 footprint placements, angles and complete footprint definitions, including
J2/J3/J4, all 1,143 track segments, 130 vias, nets and project rules remain
identical to Rev.5. The necessary copper change is limited to clipping the In1.Cu
GND plane at all three corners, with a nominal 0.55 mm setback. Actual minimum
copper/hole clearance to the new edges is **0.549999609 mm**. Parsed and geometric
diffs enumerate this edit, including sub-grid oblique-boundary rounding inside
the independently checked 2 nm numerical envelope. There is no routing change.

The new outline is an exact subset of Rev.5 (outside area **0 mm²**): material
removal only. Mounting locations and support areas are preserved, and existing
case interference is unaffected. Matrix, Wing and case data are unchanged.
Native DRC/ERC/unrouted counts are zero; independent 40-net connectivity and the
30,160-pair via/pad audit pass (minimum gap 0.145 mm). Fresh Rev.6 power extraction
using Rev.5 assumptions gives input loop **48.682870 mΩ** and farthest-point
**4.797985723 V** at 127 mA/Wing. The tiny resistance decrease versus 48.686448 mΩ
is within mesh error, not evidence that removing copper improves conductivity.
These remain models with the inherited material/load/harness assumptions.

The [Rev.6 qualification package](../hardware/kicad/qualification/issue-226-main-rev6/README.md)
contains regenerated manufacturing data, independent CAM readback, a rederived
Gerber-frame CPL translation and [outline comparison PNG](../hardware/kicad/qualification/issue-226-main-rev6/outline-comparison.png).
D-035 electrical/assembly and first-power conditions remain. This draft proposes
only the Main outline revision; it authorizes no adoption, order, merge or release.

## D-037 - Case outline smoothing and Fly Daughterboard seat (Issue #228)

Status: **Adopted (2026-11-13, Issue #228, PR #229). PO approved the Phase A outline on 2026-11-12 and accepted the connector qualification limit below at the Phase C merge gate on 2026-11-13.**

The case outline supersedes the #198 stepped south edge: each Wing's south edge
is a single strictly convex quadratic Bézier sweep from the pinky side to the
thumb side (R5 tangent fillets at both ends, curvature sign changes 0), and the
north edge is a single curve with the former USB notch removed. The maximum
south shelf depth is 16.80 mm in the pinky band only; a geometric lower bound of
15.64 mm applies to any convex boundary satisfying pocket containment plus the
2 mm wall, and PO accepted this trade-off at the Phase A gate. All other #198
interior structure (Wing/Main pockets, split at X=3.5 mm, cable rack, Wing
harness and its 200 mm storage) is unchanged; the case volume outside the
daughterboard bay is identical to the #198/Phase B data (0 mm³ added/removed).

The daughterboard seat is adapted from the UDB C3 to the real **Fly
Daughterboard (Geon × Wolf, V4.2)**, dimensioned from the official STEP
(PO-supplied; SHA-256 `5707b0866c41ebe3e1776fb918f55f2ae8503a37a938268fe3ef24b1c29c1ee7`):
board 23.57 × 8.30 × 1.59 mm, mounting holes Ø2.2 mm at 19.00 mm spacing,
USB-C mouth 0.235 mm proud of the board edge with its axis ≈3.3 mm above the
board bottom, EZmate header hanging 1.45 mm below the bottom face. The seat
moves to the north outer wall — at the former centre seat the receptacle face
sat ≈20 mm behind the wall and a USB-C plug could not reach it (PO finding,
2026-11-13). The mouth now sits 0.30 mm inside the outer wall surface behind a
W16 mm open-top opening. Fixings are the Fly's 2× M2 (MH1/MH2, Ø4.5 mm bosses),
so total PCB fixing points change from 15 to 13. A continuous plug-insertion
sweep (USB-IF nominal plug, 30 mm travel) shows zero interference with case,
boards and hardware at both pitches, reaching 6.20 mm penetration. The included
170 mm EZmate cable is modelled end-to-end (73.9 mm route plus a central
service loop), with all clearances > 0.20 mm. The full retained #198
verification suite passes at both 17 mm and 16 mm pitches; production data is
`hardware/case/issue-228-final/`.

**Accepted qualification limit.** The strict mating proof against the official
STEP's connector internals cannot pass, because the supplied model itself is
defective (Finding F-015): its USB shell solid is an invalid BRep, and a
USB-IF nominal plug overlaps the modelled internal solids beyond 4.805 mm
penetration (4.80 mm³ at the 6.20 mm full-mate pose, growing linearly — the
signature of envelope-modelled internals, not of seat misalignment; the
case-side insertion path is completely clear). PO accepts this limit and
adopts the design on the following basis: the case design depends only on the
receptacle's external envelope, mouth plane and axis, which are measured from
the model and cross-validated against PO's own viewer measurements (hole
spacing 19.00 mm); the physical Fly is a commercial product whose receptacle
accepts standard USB-C plugs by design; and physical mating is confirmed with
the real board at assembly. This decision authorizes no order or print; the
print pitch decision (MS4, 16/17 mm) and the case print GO remain separate PO
gates.

## D-038: Wing マウントは E-R（トレイ＋支持ポスト＋アルミプレート）を採用

- 日付: 2026-11-13（Issue #230 の検討結果を PO が採用）。Wing Rev.4 は行わない。
- 採用構成: 現行の4点トレイ固定を維持し、基板裏に着脱式の絶縁支持ポストを6本/Wing追加し、1.5mm 5052-H32 アルミスイッチプレート（Jade Pro データシートの開口14mm・板厚1.50mm仕様に準拠）を装着する。ポストは取り外し可能で、原状のトレイマウントへ完全に戻せる。
- 根拠（Issue #230 のモデル推定）: 支持点までの距離は中央値 31.4→10.0mm、最悪 56.0→19.2mm。最悪キーのたわみ推定 1.19→0.02mm（プレート寄与を割り引いた保守側でも0.05mm）。Jade Pro は電気接続を持たず位置決め脚のみで基板に載るため、プレートのクリップ保持は固定信頼性の改善にもなる。
- 不採用: Tadpole 浮動は、ソケット配置の制約で最悪支持距離47mmが残り、引き上げ止め・沈み止め・ボス切り下げとピン頭部の高さ確保（ケース再設計）を要するため。浮動案の中では最良（Tadpole＋アルミ、70A）として検討記録に残す。アクリルプレートは板厚公差が Jade Pro の要求（1.45–1.51mm）を素の板材では保証できないため、厚み選別と全開口検査を条件とする外観バリエーションに留め、標準採用はしない。
- プレート外形: PO 指示（2026-11-13）により、基板外形への追従ではなく、筐体（D-037）の外形に合わせた全面カバー形状とする。ケース側のレッジ、GHコネクタの切り欠き、手のひらが触れる南側の扱いなどの詳細は実装 Issue で確定する。
- 実装は後続 Issue で行う。プレートの製造発注は PO ゲート。
