ihsinoky/he-piantor-42/docs/project-status.md

# Project status

This document is the authoritative record of the project's high-level progress.
Detailed implementation work is tracked by GitHub Issues rather than duplicated
here.

### 更新草案（2026-11-10、Issue #221、未採択）

発注1のMainをRev.5（J4=Molex 781710004 / C588524、Geon × Wolf Fly DB）へ
更新する案の**実装・データ検証・製造パッケージ準備が完了**。
[PMO判断](https://github.com/ihsinoky/he-piantor-42/issues/221#issuecomment-6750886847)
の互換性チェーンに基づき、ピン順1=VBUS/2=D−/3=D+/4=GNDを維持して再開した。
DRC/ERC/未配線0、全via–pad最小0.145mm、下流最遠点モデル4.797986V。
[D-035](decisions.md#d-035---main-rev5-fly-daughterboard-connector-proposal)は**提案**のまま。
既存の採択済みベースラインは下記記録のままで、発注対象の正式切替はPOマージゲート。
PMOはRev.5の再見積/在庫/DFM/実装向き/上流抵抗の確認材料を整理する。
**初回通電前のFly単体・ケーブル先端VBUS/GND極性実測は未実施で必須**。
[最終報告・製造引継ぎ](issue-221-main-rev5.md)参照。Matrix/Wingのデータ変更なし。

Cross-cutting lessons distilled from the decision record (D-001–D-027) and the
PMO run record (Issues #87–#169) are collected in
[lessons-learned-device-development.md](lessons-learned-device-development.md).
Read it when starting a new device development or revisiting a settled method.

## Current situation（2026-11-08、Issue #207 / 整理計画 P3）

**現在位置：MS1 完了、MS2 は未着手で PO の発注 GO 待ち。** 設計ベースラインは
Main Rev.4／Matrix Rev.3／Wing Rev.3／ケース最終。正本と検証記録は
[成果物索引](artifacts-index.md)を参照する。データ上の検証と実機合格を区別する。

- Main Rev.4：三角形・3穴、USB は別基板 UDB C3。D-033 採択済み。
- Matrix Rev.3：16mm／17mm 各3×3、計18キーの評価基板。D-028／D-029。
- Wing Rev.3：16mm／17mm × 左右、単板4枚と左右一体製造パネル2種。D-034 採択済み。
- ケース最終：17mm版が正、16mm版は再生成・検証版。固定点15点
  （Wing 各4＋Main 3＋UDB 4）、GH ハーネスは各200mm。
  **南辺フラッシュは PO 了解済み**（本P3要件による現行状態）。
  過去のケース報告・整理計画に残る「最終判断持ち越し」は記録当時の状態。

### 残件と次の責任者・着手条件

| 残件 | 次の判断・条件 | 担当 |
| --- | --- | --- |
| 発注1（Main Rev.4＋Matrix Rev.3） | **PO の GO 待ち**。前提：CPL 原点確認、UDB 上流抵抗の実測。再見積・BOM調達・業者DFM／工程受入れも製造リリースの別ゲートとして残す | PMO が確認材料を整理、PO が発注判断 |
| 量産ピッチ | **未決定**。Matrix 実測後に16mm／17mmを判断。17mmケース正本の存在は量産ピッチ確定ではない | PO（MS3→MS4） |
| 実機・物理検証 | **未実施**。実ハーネス配索・嵌合・保持力・クリープ・足位置、USB、電源／ノイズ／磁気相互作用などを実機確認 | 実施担当は別途割当、PO が結果判断 |
| ケース印刷 | **PO 判断待ち**。印刷・実造形検証は未実施 | PO |
| Wing 発注・FW・完成・公開 | MS3以降のゲートに従う。押下推定方式はFW検証で確定。公開の詳細は別計画 | PO／PMO |

設計採択は製造GO・実機動作保証ではない。旧EDA試験のSTOPを取り消さず、
G1〜G5の完了もここで推定しない。旧記録は下の[履歴](#status-history)に保存する。

### マイルストーン計画（PMO 案、P3 の PO PR ゲートで確認）

従来のフェーズ名 M0／M1／M2 と、この計画の MS1〜MS8 は別体系。
MS8 は完成成果の公開用リポジトリ／Releases の計画であり、既存開発リポジトリの公開履歴とは別。
詳細状態は上記と各報告書を正とし、[ダッシュボード](../task/index.html)は計画と現在位置の大局ビューだけを表示する。

| ID | マイルストーン | 状態 | 完了の根拠／次のゲート |
| --- | --- | --- | --- |
| MS1 | 設計ベースライン確定 | 完了 | Main Rev.4／Matrix Rev.3／Wing Rev.3／ケース最終データが揃い、版別の採択・検証記録あり。 |
| MS2 | 発注1：Main Rev.4＋Matrix Rev.3 の製造 | 未着手 | PO の発注 GO 待ち。前提確認：CPL 原点、UDB 上流抵抗の実測。 |
| MS3 | Matrix 実測 | 未着手 | MS2 後、相互作用の大きさと工場実装／手実装の精度を比較する。 |
| MS4 | 量産ピッチ決定（16mm／17mm） | 未着手 | MS3 の結果で PO 判断。 |
| MS5 | Wing 発注（Order 2）とケース印刷 | 未着手 | MS4 後に Wing 発注判断。ケース印刷は PO 判断待ち。 |
| MS6 | 組立・通電確認 | 未着手 | 基板・ケースを揃え、組立・通電と物理適合を確認する。 |
| MS7 | ファームウェア検証と完成 | 未着手 | 押下推定方式を確定し、実機でファームウェアを検証する。 |
| MS8 | 成果公開（公開用リポジトリと Releases） | 未着手 | 完成後の公開。詳細は別計画。 |

## Board naming convention (PO decision, 2026-11-06)

Milestone names and board revision names are kept separate. `M0` / `M1` / `M2`
name phases (milestones) only and are never used as board names. Each board
carries its own revision number; there is no cross-board generation label.
The former `Rev.M1` label is retired. Historical documents and decision
records that use `Rev.M1` / `Rev.A` are not rewritten; read them through this
table.

| Board | Revision | Meaning | Former names |
| --- | --- | --- | --- |
| Main board | Rev.1 | Single-Wing version. Not an order target. | Rev.M1 Main (single-Wing) |
| Main board | Rev.2 | Dual-Wing version (Issue #175 final board). Historical dual-Wing Main; superseded by Rev.4. | Rev.M1 Main (dual-Wing) |
| Matrix board | Rev.1 | Separate 3x3 boards per pitch (16 mm and 17 mm), 9 keys each. Designed in Issue #127, routing-evaluated in Issue #129; never fabricated. | Evaluation Wing, pitch9 |
| Matrix board | Rev.2 | One board carrying both pitches: 16 mm 3x3 block + 17 mm 3x3 block, 18 keys (Issue #178). Purpose: pitch comparison and simultaneous-press Hall-interaction measurement. | - |
| Matrix board | Rev.3 | Rev.2 with every via moved clear of component pads; no POFV required (Issue #182). | - |
| Main board | Rev.3 | Rev.2 with 35 vias relocated clear of pads; POFV removal proposed for this package (Issue #185); D-030 adoption unconfirmed per Issue #205. | - |
| Main board | Rev.4 | Triangular Main with separate UDB C3, three mounting holes and 200 mm GH harnesses; routed and manufacturing package prepared in Issue #196 Phase B / PR #197. D-033 accepted; manufacturing release and physical validation pending. | - |
| Wing board (Left / Right) | Rev.1 | 21-key Hall key boards, manufacturing data SILK-149A. | Rev.A Wing, "ver.A Wing" |
| Wing board (Left / Right) | Rev.2 (historical) | [Issue #194 Phase B](issue-194-wing-rev2-stage2.md): separate left/right 21-key boards at 16/17mm, bottom Hall/local C, revised outline and locator holes, low-resistance pours, copper-free-tab Standard-PCBA panel. D-032 accepted, specified scope superseded by D-034; physical acceptance/order release pending. | - |
| Wing board (Left / Right) | Rev.3 | [Issue #200 Stage 2](issue-200-wing-rev3-stage2.md): Stage 1b north shoulder/R5 and GH relocation, stepped south edge, north service layout, new copper resistance extraction and Standard-PCBA panels. D-034 accepted, partially supersedes D-032; 200mm harness retained. | - |

Phase usage stays as before: M1 is the evaluation phase, M2 is the
42-key product phase. The earlier PO-approved front-loading of Wing Rev.1
bare boards was a historical plan; the current order plan is MS2 / MS5 above.

### Revision history (background, one line per revision)

Kept here because the reasons behind a revision cannot be recovered from
comparing artifacts. Detailed changes live in the decision records and the
issue reports, not here.

- Wing Rev.3 - Issue #200 implements the Stage 1b broad R5 north
  shoulder and relocated GH, trims the south while preserving keys/sensors,
  relocates service parts and one mounting hole per side, and requalifies all
  four PCBs plus panels. Replaces the historical Wing voltage drop with a new
  copper extraction; compares 124.097mm and adopted 200mm harness lengths.
  D-034 is accepted; the final case data is available from Issue #198.

- Main Rev.1 - Built as the single-Wing evaluation Main; superseded before
  ordering when dual-Wing connection became a requirement.
- Main Rev.2 - The dual-Wing revision; its placement passed under the PO
  policy of proceeding with design while deferring physical GH checks to
  real hardware, and it gained a regulated 5.2 V rail after analysis showed
  raw VBUS could not hold the far-end sensor voltage.
- Matrix Rev.1 - Designed as two separate per-pitch boards for pitch
  comparison; replaced before fabrication when the verification approach
  changed to one combined board.
- Matrix Rev.2 - Rebuilt as one combined board after simultaneous-press
  Hall-interaction measurement was added to its purpose, so both pitches
  are measured under identical conditions.
- Wing Rev.1 - The representative 21-key Wing taken to manufacturing data
  (SILK-149A) with silkscreen prepared for hand soldering; both pitches
  prepared because the production pitch is decided from measurements.
- Matrix Rev.3 - Rework of Rev.2 that moved every via clear of component
  pads so the POFV (epoxy fill and cap) requirement could be withdrawn;
  layout, outline and circuits unchanged. Cut the PCBA quote by $57.33.
- Main Rev.3 - Rework of Rev.2 that relocated 35 vias (plus local stubs)
  without touching placement or the existing routing skeleton, so the
  POFV specification from D-022 could be dropped for this package; the
  minimum via-to-pad gap is exactly 0.100 mm nominal. Cut the PCBA quote
  by $19.29.

- Main Rev.4 - Rebuilt around the Phase A-2 triangular placement, with USB-C/CC/
  data ESD moved to the separate UDB C3 and J4 added. Three mounting holes and
  200 mm GH harnesses supersede the previous mechanical/length baseline for
  this package (D-033 accepted). Full routing, independent qualification, 0.145 mm
  minimum via-to-pad clearance and manufacturing data are recorded in the
  [Phase B report](issue-196-main-rev4-phaseb.md). Manufacturing release and physical
  assembly validation remain pending.

## Status history（2026-10-14 時点の状態と当時の評価記録）

以下は当時の記述を保存した履歴。EDA停止・未承認・未着手や「current」は当時の範囲を指し、
現行基板・ケースの状態は冒頭の2026-11-08節を参照する。技術的STOPの結論は変更しない。

## Historical: Current situation (Issue87 resumed Main incomplete / pass contract unqualified, 2026-10-14)

**Location:** Before real Rev.M1/Main product design. Same Draft
[PR #88](https://github.com/ihsinoky/he-piantor-42/pull/88), Issue87. PR #86 is an
accepted historical STOP, with prior authority/budget corrections retained.
Current PO limited-resume authority permits the small structural DSN restoration;
utilization reset does not reset the6h Issue frame or add attempts.

**Latest result:** **ROUTING_BLOCKED / MAIN_OUTPUT_INCOMPLETE /
RUN_CONTRACT_UNQUALIFIED / MAIN_UNQUALIFIED**, recovery STOP
**2026-10-14 22:23:18.672066 UTC**. [Latest report](issue-87-native-main-routing.md#resume-01).
The existing Main wrapper exited0 at21:41:53.513 UTC after1203.752s and saved SES,
but final router telemetry has35 incomplete connections. Logs reach512 passes
instead of declared100: the public parsed-settings probe did not establish the
effective runtime cap. No claim that the fixed100-pass trial was valid. The
precise timeout/job termination cause is not certified; outer1260s timeout did
not fire. Codex utilization interruption is a separate event. No replacement or
resume routing process was launched during recovery.

**Established in limited resume:** only typed smd_smd50→200um changed, raw kept,
independent AST/byte diff and public fixed-JAR effective F/B matrix readback pass.
Ordinary/netclass rules and all other loaded objects remain unchanged. Full
individual Main input DSN pad/net/NC/duplicate/pose/shape/outline/layer/local-copper/
hole-obstacle reconciliation passes; DSN omissions vs native retained properties
are explicit. Small roundtrip **1 PASS WITH SCOPE**: returned KiCad nonroute
semantics unchanged, DRC/unconnected0, actual copper graph and all4 metrics0.
Prior actual.10mm gap/via fault evidence is hash-verified and reused.

**Attempts:** small **1**, Main initial **1**, confirmation **0**. Main four
post-return physical metrics are **null**, not router35 or clearance0. The latest
PO recovery caseC requires STOP on incomplete output; no new Main SES-import/
DRC/graph experiment followed that finding. Prepared code was not executed.
Main post-return parity, material acceptance, complete routing and confirmation
remain unqualified. This is not a valid fixed100-pass placement result or proof
of method-wide inability. No retry, setting exploration or confirmation.

Baseline Main ERC0 and61 known printing warnings are retained. No new Main DRC
was run, so no post-route print/material status is inferred. Printing/glyphs are
still manufacturing work; no deletion/suppression/exception. USB NPTH DFM,
product source/production0.0.2646/D-014–18, Wing/manufacturing/Gates remain unchanged.

**Next owner/action:** PMO reviews bounded restoration/small success, incomplete
Main and runtime-contract failure; PO decides record acceptance and any new
scope/investment or hold. No next technical execution is authorized. Target,
method, implementer, independent acceptance and investment remain unplanned.

| Capability | Evidence / practical limit |
| --- | --- |
| Core Main / earlier real faults | Hash-verified reuse; individual input parity and prior actual gap/via/short proof. |
| DSN rules / individual transfer | Known token restored only; independent diff, effective class matrix and full input reconciliation pass. Native drilling/thickness/printing retention distinguished from router obstacles. |
| Small roundtrip | One route; native nonroute geometry/drill/NC preserved, four metrics0 in tiny fixture only. |
| Main initial | One incomplete output; public parser said100passes, actual512. No physical terminal qualification; metrics null. |
| Confirmation |0, not entered; initial all-condition pass absent. |
| Product/manufacturing | No start/approval;61baseline warnings/glyph/USB DFM remain open. |

| Uncertainty | Evidence / consequence | Needed disposition | Owner |
| --- | --- | --- | --- |
| Effective run contract | Requested100, observed512; parsed-setting success insufficient. Exact runtime cause unqualified. | Review run validity and any separately scoped proof, no automatic retry. | PMO/PO |
| Main physical result | Router35 incomplete is telemetry; returned Main physical graph/DRC/parity unmeasured after caseC STOP. | Retain partial SES and null metrics; no method-wide claim. | PMO/PO |
| Printing/product | Baseline61warnings and glyph/USB DFM unresolved; no post-route DRC. | Resolve before manufacturing; no exception. | PO; product implementer unassigned |
| Interruption/time | Prior13min + charged resume/unattended route + recovery/report/submission. Utilization-wait boundary uncertain. | Lower/upper ledger, upper used for6h; no reset, no fabricated1h contemporaneous note. | PO/PMO |
| Maintenance | Public binding/parser/config integration and whole-environment reconstruction remain unqualified. | Evaluate bounded maintenance/investment only under new authority. | PMO/PO |

The separate product lifecycle remains:

1. **Rev.M1 build and measurement:** reusable Main + pitch/magnetic Evaluation
   Wings, measurement firmware, pre-order package and measured report. G1 checks
   actual ERC/DRC, BOM, manufacturing and measurement plan; G2 decides from
   magnetic/noise/scan/power/pitch/analog measurements. Hardware and measurement
   planning remain incomplete; firmware is needed and enclosure follows PCB.
2. **42-key Rev.A:** accepted Main and project-owned Left/Right 21-key Wings,
   subject to G2/geometry-source approval; circuit/DRC/manufacturing/firmware and
   G3 pre-order review remain required.
3. **Integration and physical checks:** assembled unit/procedures, typing,
   calibration, USB/Vial and enclosure at G4.
4. **Release:** reproducible v1.0 manufacturing/firmware/enclosure/procedures at
   G5 / PO approval.

Detailed product schedule, firmware/enclosure milestones and several acceptance
conditions remain unplanned. G1–G5 remain not-ready. No method report starts
product implementation or passes a manufacturing gate.

## Historical: Current milestone

**M1 — Magnetic approach / evaluation board** (`current`)

- **Deliverable:** reusable Main board + pitch/magnetic Evaluation Wing(s), measurement
  firmware, and measured-results report. Physical hardware is not implemented yet.
- **Exit criteria:** ERC and DRC pass; physical measurements establish sensor
  range, noise, scan speed, power consumption, and the selected magnetic
  approach, production pitch and representative analog path at G2.

## Historical: Roadmap

| Milestone | Status | Deliverable | Exit criteria |
| --- | --- | --- | --- |
| M0 — Design policy / basic geometry | `done` | Historical 42-key requirements, 17 mm layout, and acquisition-method design policy (pitch reopened by D-015) | Principal requirements, key-center coordinates, and evaluation policy are documented. |
| M1 — Magnetic approach / evaluation board | `current` | Reusable Main + pitch/magnetic Evaluation Wing(s), measurement firmware, and measured-results report (hardware not implemented) | ERC and DRC pass; physical measurements establish range, noise, scan speed, power consumption, production pitch, representative analog path, and the magnetic approach. |
| M2 — 42-key Rev.A | `next` | Reuse accepted Main + Left 21-key Wing + Right 21-key Wing + production firmware, subject to G2 pitch/magnetic decision | Main/Wing ERC/DRC, manufacturability checks, and firmware build pass. |
| M3 — Integration / enclosure / test | `todo` | Enclosure, integrated unit, and assembly, calibration, and test procedures | Physical operation, all-key calibration, USB/Vial behavior, and enclosure fit pass testing. |
| M4 — Final release | `todo` | Reproducible v1.0 manufacturing, firmware, and enclosure package | Final artifacts are fixed and the Product Owner approves the completed release. |

## Historical: Human Gates

| Gate | Current status | Check | Trigger | Unlock condition |
| --- | --- | --- | --- | --- |
| G0A — JITX Backend Adoption | `done` | C0-C4B5 accepted evidence; Issue #55 PO decision recorded in D-016 | C4C / G0A completed: JITX active physical backend NO-GO for Rev.M1 / Rev.A. | Historical JITX NO-GO remains valid; G0B is done under D-017. D-018's planning scope was accepted at that decision; it did not adopt a candidate or authorize Main. |
| G0B — Rev.M1 Architecture / Interface Freeze | `done` | Accepted connector/pinout, external WING_EN pull-down requirement, evaluation harness, Wings/coverage, test access, measurement framework and DFM boundary in D-017 | Issue #57 PO GO accepted the freeze. | Architecture/interface remain frozen. Subsequent EDA evaluations did not qualify the path; full implementation remains unapproved. |
| G1 — Rev.M1 Main + Evaluation Wing pre-order review | `not-ready` | Actual Main/Wing circuit/ERC, DRC, BOM, manufacturing outputs and measurement plan | Complete manufacturing package exists after separately accepted backend qualification and authorized full Rev.M1 implementation. | Rev.M1 Main + Evaluation Wing ordering may proceed. |
| G2 — Post-EVT-002 magnetic / pitch / analog-path decision | `not-ready` | Measured range, noise, scan speed, power, interference, actual interconnect path and pitch usability | Physical evaluation measurements and report are complete. | Select among 17.0 / 16.5 / 16.0 mm and production magnetic architecture; the Rev.A circuit may be fixed. |
| G3 — Rev.A pre-order review | `not-ready` | Main/Left/Right Wing DRC, BOM, Gerbers, drill/placement outputs and cost | The 42-key manufacturing package is complete. | Rev.A PCBA ordering may proceed. |
| G4 — Physical operation review | `not-ready` | Typing, calibration, Vial, USB, and enclosure fit | Integrated-unit bring-up is complete. | The final design may be fixed. |
| G5 — Final approval | `not-ready` | All v1.0 artifacts and procedures | Acceptance testing passes. | v1.0 may be released. |

## Historical: Workstreams

| Workstream | Current high-level state |
| --- | --- |
| Hardware | EDA-004G resume02 / PR #86: fresh Main/ERC/DRC out of scope; authority claim withdrawn. Retained technical result: PRE_ROUTE_PHYSICAL_DRC_STOP / MAIN_UNQUALIFIED. Four models/raw roles, fresh ERC0, core pads/holes/poses/copper and four synthetic faults pass scoped checks;61 printing violations/full glyph uncertainty stop before effective rules/DSN/SES/routes.0/0/0. Prior STOPs/records unchanged; EDA-004F PR #84 accepted. PMO/PO review; no inferred further experiment. |
| Firmware | M0 requirements are done; M1 measurement firmware is in progress. Hall/Vial integration and later firmware remain unstarted. |
| Enclosure / Mechanical | M0 geometry constraints are done; M1 is waiting for PCB constraints. Later enclosure integration and manufacturing artifacts remain unstarted. |
| Verification / Test | M0 planning is done; M1 magnetic and power measurement is waiting for the evaluation hardware. Rev.A bring-up and later testing remain unstarted. |

## Historical engineering evidence and accepted product requirements

This section records accepted historical evidence and product requirements; it
is not the current next-step plan. The current location and unresolved method
qualification are summarized at the top of this document. Issue #19's Human Gate returned GO for native stock
tscircuit, so EDA-001 is done and EDA-000 is retired fallback/reference. PR #27
completed EVT-001 and froze `hardware/tscircuit/src/evaluation/m1-four-key.tsx`
and its Checkpoint A/B/C evidence as the M1 electrical golden reference. D-014
remains the accepted historical decision that made native tscircuit the M1
electrical source.

EDA-002C0 passed the technical JITX graph-export gate through the documented
`Export` plugin boundary: it captures stable structural paths, component types,
ports, resolved nets, and port membership from the actual bootstrap build.
`RuntimeDesign.query()` and its net-resolution methods are documented but
explicitly experimental; PMO accepted that category-B surface for the JITX
challenger/parity evaluation workflow without classifying it as stable.
Any future JITX Python package or runtime version change must rerun and pass
the EDA-002C0 normalized graph exporter and bootstrap graph self-test before
graph-parity compatibility may be assumed. EDA-002C1 is accepted/done: all nine
manufacturer models passed and PR #36 was merged into main at a27fc48.
EDA-002C2 (issue #37) is done / accepted / merged PR #38 at `67b6c302`,
electrical graph parity PASS: 68 components, 200 normalized endpoints, 43 named
nets, 185 endpoint/net edges, four direct links and seven intentional NCs.
Actual RuntimeDesign exports are deterministic; the 20-test suite includes
bootstrap regression and C2 fault-injection coverage. Geometry parity is
explicitly NOT established.

EDA-002C3 (issue #39 / merged PR #40, baseline `bc061435`) remains valid
historical evidence. The [unchanged report](../hardware/jitx/geometry/EDA-002C3.md)
and reconciliation record preserve their recorded discrepancies and Human Gate
states; not all geometry questions are resolved. They do not invalidate C2.
Exact geometry convergence against the legacy reference is no longer a JITX
adoption criterion; manufacturer evidence should inform the new product.
No old tscircuit geometry is corrected in C4A.

EDA-002C4A (issue #41) is accepted / merged PR #42; documentation/architecture
rebaseline only. The old footprint-alignment plan is cancelled. The golden is
a permanent qualification oracle, not the physical Rev.M1 manufacturing design.
[D-015](decisions.md#d-015---revm1-reusable-main--evaluation-wing-architecture)
accepts reusable Main + Evaluation Wing architecture: Main owns RP2040,
USB/power, three ADC channels and dividers/filters; Wing owns Hall/TMUX and
pitch-test geometry. Compare 17.0 / 16.5 / 16.0 mm for magnetic performance and
usability; 100 x 100 mm is a cost target, not a pitch requirement. Rev.A's
first-choice is accepted Main reuse + Left/Right 21-key Wings, three TMUX1208
each, generated from one project-owned definition; separate manufacturing
outputs are allowed, without a reversible PCBA requirement.

The following C4B-C4B3 summaries record historical results. The C4B4B
disposition below records the then-current path/product status at its acceptance;
later EDA-004B–E evaluations supersede that historical EDA-route state. Their
reports and evidence remain unchanged.

**EDA-002C4B investigation: BLOCKED** (issue #43). The disposable four-key
qualification wrapper builds with explicit 68-component placement, partial
copper on two layers/two vias, ODB++ and public BOM/PnP review exports. The two
fresh generations repeat captured geometry and CSVs; ODB order/IDs vary.
Full routing, complete DRC and a qualified Gerber/Excellon JLCPCB handoff remain
unproven. C2 electrical parity remains PASS. See the
[C4B evidence](../hardware/jitx/physical/EDA-002C4B.md).

**EDA-002C4B2 downstream CAM: BLOCKED** (issue #45 / merged PR #46).
The unchanged fixture generates JSON DRC, nine Gerber layers, PTH/NPTH Excellon
and 68-row PnP through KiCad 9.0.9 twice from fresh state. Its 147 missing
connections reconcile with C4B's intentional partial routing. Four USB source
copper-to-NPTH clearance conflicts and exported 1.6 mm thickness contradicting
the 1.2 mm source stack block manufacturing qualification. No manufacturing
geometry/drill/assembly-coordinate difference was found between runs; all raw
differences are retained. Historical evidence, versions and full routing remain
unchanged. See [C4B2 evidence](../hardware/jitx/physical/EDA-002C4B2.md).

**EDA-002C4B3 manufacturing disposition: BLOCKED** (issue #47 / merged PR #48).
The thickness mismatch originates in a fixed 1.6 mm runtime export template;
no supported overall CAD/job override was found. A supported limited handoff
excludes the optional job and specifies 1.2 mm independently, preserving all
individual Gerber/drill bytes. Current JLCPCB rigid FR-4 NPTH capability is
0.20 mm; the 0.25 mm fixture rule was a qualification default. The smallest
USB gaps are 0.20009999 mm and remain marginal release blockers. Rev.M1 DFM
policy separates capability floor, 0.25 mm target and numerical review guard;
exceptions require evidence. Fresh two-run CAM/source reconciliation and all
20 C0/C1/C2 regressions pass. Historical evidence, topology, manufacturer
geometry and partial routing remain unchanged. Incomplete routing is **not**
the only major remaining issue. See [C4B3 evidence](../hardware/jitx/physical/EDA-002C4B3.md).

**EDA-002C4B4A completed / merged PR #50** (issue #49): the qualification-only
coupon preserved accepted connector geometry and provided the exact human-upload
ZIP. See [C4B4A](../hardware/jitx/physical/EDA-002C4B4A.md).

**EDA-002C4B4B accepted external evidence disposition** (issue #51; merged PR #52).
Human JLCDFM observation is **INCONCLUSIVE** for the exact
NPTH-to-adjacent-pad-copper measurement; the viewer exposed no measured result.
Absence of a warning is not production approval. The JLCPCB Japan support/sales
response received 2026-10-05 confirms a **0.20 mm minimum capability**, numerically
met by all four accepted-source gaps (0.2000999900 / 0.2348831648 mm).
JLCPCB recommends additional clearance where feasible without specifying 0.25 mm.
The **0.25 mm preferred target** and **0.001 mm numerical review guard** remain
project-owned, not JLCPCB requirements or recommendations.

**JITX -> legacy-kicad -> KiCad -> Gerber/Excellon: PASS_WITH_LIMITATIONS.**
Accepted source geometry was preserved; USB gaps are connector properties,
not export distortions. The misleading generated CAD/Gerber-job overall thickness
metadata must be excluded from production handoff; independently select/confirm
**1.2 mm finished thickness**. This does not qualify a production PCB or complete
routing/DRC.

**USB product release: OPEN — PRE-ORDER DFM REVIEW REQUIRED.** USB margin is
reclassified from a JITX-backend qualification blocker to a product manufacturing
risk. Before any actual Rev.M1 / Rev.A fabrication order, increase clearance
where feasible, or explicitly accept/document manufacturer-minimum geometry and
pass actual order-time CAM/process review. No production exception is granted.
See [C4B4B disposition and external evidence](../hardware/jitx/physical/EDA-002C4B4B.md).

**EDA-002C4B5 — done / accepted BLOCKED evidence** (issue #53; merged PR #54).
Public source Route trees retain 40 downstream unconnected items; a representative
two-via escape retains 39 and a dangling via. C2 topology and manufacturer geometry
remain unchanged. Complete routing and successful two-run reproducibility are
unqualified. See [C4B5 evidence](../hardware/jitx/physical/EDA-002C4B5.md).
**EDA-002C4C / G0A is complete**: the [Issue #55 PO decision](https://github.com/ihsinoky/he-piantor-42/issues/55#issuecomment-5991285003)
is **NO-GO for JITX as the active physical backend for Rev.M1 / Rev.A**, recorded
in [D-016](decisions.md#d-016---jitx-physical-backend-no-go-native-tscircuit-resumes-as-active-revm1-eda-candidate).
The primary reason is the complete-routing workflow not demonstrated in C4B5,
not USB DFM or the separate generated-thickness metadata limitation. Accepted
electrical/component/modeling successes and all JITX source/evidence remain
valid and retained. At that historical D-016 acceptance, native stock tscircuit
resumed as the forward candidate/path, subject to later ERC/DRC and manufacturing
gates; physical Main/Wing remains unimplemented and is not production-qualified.
**G0B is done / accepted** by the [Issue #57 PO GO](https://github.com/ihsinoky/he-piantor-42/issues/57#issuecomment-6010634587) and
[D-017](decisions.md#d-017---revm1-mainwing-architecture-and-interface-freeze).
The JST GH 14-position connector/pinout, six common-GND return contacts, nominal
100 mm 1:1 evaluation harness, external Main-side pull-down per `WING_EN`,
three pitch Wings and full-load three-TMUX/three-ADC coverage are frozen.
The exact pull-down resistor value remains implementation work.

**Historical EDA evaluation sequence (completed through EDA-004E):**
EDA-004D / Issue #77 / PR #78 CONVERSION_BLOCKED -> EDA-004E / Issue #79 /
PR #80 PCB_IO_PASS / FRONTEND_UNQUALIFIED. This records the evaluation history,
not a current next-step plan. Main remains unqualified and full implementation/
adoption remains unapproved. Current next direction is undecided as stated at the
top of this document.
See [EDA path history](eda-path-history.md) and
[native KiCad feasibility](native-kicad-authoring-feasibility.md).
Full Rev.M1 implementation requires separate authorization. No
schematic/PCB/manufacturing package completion, placement, routing or order
is claimed. Production pitch, final Hall choice, final Rev.A cable mechanics/length,
exact pull-down resistor, final placement, PCB routing, representative Main
routing qualification, USB NPTH manufacturing disposition, final USB/system
power budget and manufacturing release remain open. The accepted DRV5055 5 V
basis (3 mA typical / 5 mA maximum) yields approximately 127 mA per 21-key Wing
and 254 mA for 42 sensors / two Wings: planning estimates, not final USB/system
power qualification or final production requirements. `hardware/layout/**` is not consumed; future Wing
geometry must be project-owned or explicitly approved at a later Human Gate.
See [Rev.M1 architecture](../hardware/rev-m1/architecture.md),
[interface](../hardware/rev-m1/main-wing-interface.md),
[evaluation plan](../hardware/rev-m1/evaluation-plan.md) and
[DFM policy](../hardware/rev-m1/dfm-policy.md).

EDA-002A's Cloud Codex capability probe remains historical evidence of that
environment's HUMAN / ENVIRONMENT STOP. EDA-002B subsequently passed the
GitHub Codespaces JITX environment/bootstrap feasibility gate: its canonical
project uses `jitx==4.4.3`, runs against the already validated Linux runtime
4.4.2, and completed a real bootstrap build. EDA-002C0 then passed its
documented graph-introspection proof. See
[`jitx-evaluation.md`](jitx-evaluation.md) for the evidence and stability
classification. The JITX challenger evaluation ended in physical-backend
NO-GO at C4C/G0A; all historical qualification evidence is retained. C4B4B
classifies the demonstrated JITX downstream path PASS_WITH_LIMITATIONS; C4B5
remains accepted BLOCKED for complete routing. G0B remains accepted.
EDA-003B through F are completed historical work;
D-018 remains unchanged. EDA-004B's environment STOP and EDA-004C / Issue #75's
conversion STOP are historical results, superseded as the latest evaluation by
the later EDA-004D/#77 and EDA-004E/#79 records.

The previous spike established reproducibility with a committed dependency
lock, fresh GitHub Actions `npm ci`, Bun 1.2.22, tscircuit 0.0.2646, and
non-interactive CI bootstrap. Its KiCad footprint-import path stopped at
footprint integrity: conversion of `SW_MX_HE_0deg_1u.kicad_mod` using
`kicad-to-circuit-json` 0.0.117 preserved Hall SMD pads, the plated through-hole
pad, duplicate pad-number semantics, two NPTH switch holes, plated/non-plated
distinction, mechanical alignment, and an observed Y inversion, but lost two
copper-pour keepout zones. Therefore KiCad import is not the authoritative
migration path. This result does not rule out native tscircuit design.

**EDA-003A / merged PR #59: accepted UPSTREAM_FIX_CANDIDATE.** Both copper-pour
keepouts were silently lost, warnings did not report the material loss, and
rounded-pad corner radius was incorrect. Current KiCad footprint importer
reuse is **NOT approved**. Native TSX remains authoritative; KiCad assets
remain reference / secondary evidence. Future importer reuse needs separately
accepted fidelity evidence after fixes. Details remain in the
[requalification report](tscircuit-kicad-importer-requalification.md).

Existing KiCad work remains unchanged as reference and prior-design evidence,
but is not the active EDA source. Each detailed increment is
defined and accepted through its own GitHub Issue.

## Historical: EDA-003 history and current planning decision

Completed qualification work does not mean a qualified board or adopted backend.
All reports and evidence remain unchanged:

| Work | Actual terminal classification | Evidence / implication |
| --- | --- | --- |
| EDA-003B (Issue #61 / PR #62) | **BLOCKED — ROUTING_CAUSED_PHYSICAL_ERRORS** | [Report](tscircuit-revm1-routing-proof.md): production 0.0.2646; zero required unrouted, seven Main wrong-net copper components; material Main/Wing errors. |
| EDA-003C (Issue #63 / PR #64) | **WRONG_NET_FIXED_LOWER_RISKS_REMAIN** | [Report](tscircuit-latest-routing-risk-qualification.md): isolated stock 0.0.2748, zero required unrouted/wrong-net; 71 Main material records, Wing errors and Main export assertion failure remain. No production upgrade. |
| EDA-003D (Issue #65 / PR #66) | **BACKEND_DECISION_REQUIRED** | [Report](tscircuit-main-clearance-risk-triage.md): BROAD / DISTRIBUTED, 71 records / 54 physical conflicts / 37 net/NC pairs; no demonstrated fixes. |
| EDA-003E (Issue #67 / PR #68) | **BACKEND_DECISION_REQUIRED** | [Report](tscircuit-via-clearance-signature-probe.md): strong 0.115 mm numeric correlation; repair boundary/size unqualified. |
| EDA-003F (Issue #69 / PR #70) | **INTERVENTION_UNSAFE_REGRESSION — K1** | [Report](tscircuit-clearance-intervention-ab.md): control 71 records / 54 conflicts; intervention zero required unrouted but two wrong-net components. Confirmation and physical comparison not entered. |

The [explicit Issue #71 PO comment](https://github.com/ihsinoky/he-piantor-42/issues/71#issuecomment-6046244229)
is recorded in [D-018](decisions.md#d-018---bounded-alternate-physical-backend-qualification-planning).
Additional product-track exploration of the evaluated internal tscircuit router
has ended. Frontend retention is still being evaluated. Candidate B is the first
bounded qualification candidate, **not adopted**. Production tscircuit remains
**0.0.2646**; representative Main routing remains **unqualified**.

**EDA-004B / [Issue #73](https://github.com/ihsinoky/he-piantor-42/issues/73):
ENVIRONMENT_BLOCKED — P1_SMOKE_CAPTURE_GUARD_ERROR.** The PO authorized the actual
execution Issue incorporated from the fixed planning documents. The first failure
was the executor smoke guard rejecting permitted local copper before raw JSON
capture. This is an executor verification/capture error, not EDA/backend incapability.
A subsequent converter invocation, despite that failure, observed the secondary
environment obstacle **P1_CONVERTER_MODULE_LOAD** (`dist/index.js` absent).
Immediate-stop discipline was not followed. Stage 1 was partial; Main transfer, ERC/DRC,
independent KiCad reconciliation, initial routing and fresh confirmation were
**NOT ENTERED**. Main initial/confirmation counts are **0/0**, smoke routing **0**.
All Main acceptance metrics are null. The executor's smoke guard rejected allowed
local bond copper before raw JSON capture, and the converter was attempted after
that capture failure; P0 freeze was incomplete. Evidence is **PARTIAL**, with
these limitations disclosed in the [terminal report](alternate-physical-backend-main-qualification.md).
Terminal reporting is complete; technical qualification is incomplete. The PO
relayed a PMO chronology finding; correction acceptance and backend PASS are not
claimed. That environment/capture correction was subsequently authorized for
EDA-004C / Issue #75, whose new result is below. Issue #71's historical planning
and [execution draft](alternate-physical-backend-main-qualification-issue-draft.md)
remain unchanged. Aggregate cap remains 16 engineer-hours; later work still needs
separate PO authorization and Main PASS before Wing/export.
**EDA-004C / [Issue #75](https://github.com/ihsinoky/he-piantor-42/issues/75) / PR #76:
CONVERSION_BLOCKED — C1_DUPLICATE_GND_PAD_NET_LOSS.** Fixed-source kicadts build,
converter module load, raw capture/stop-control tests and headless KiCad 9.0.9
schema/binding probes succeeded. Source/Circuit JSON geometry and defined
synthetic pin/circuit checks passed after disclosed preparation corrections.
KiCad conversion loses the second U_TX pin2 land's GND net; pre-route DRC reports
one shorting_items and one solder_mask_bridge error. Schematic conversion emits
duplicate Device:U_chip definitions and passive input/output pins; KiCad ERC
reports two pin_not_connected errors. Library warnings are retained and meaningful
ERC remains unqualified. Experiment stopped before DSN; initial/fresh smoke
routes **0/0**, Main **0**. DSN/SES, post-route checks and reproducibility are
**NOT ENTERED**; acceptance metrics remain null. New raw evidence does not restore
EDA-004B's missing output. Read-only parity fault replay detected 26 injected
faults; it does not qualify the full post-route island/clearance verifier.
See the [new report](alternate-physical-backend-smoke-requalification.md).
PMO/PO reviews this conversion STOP; no automatic repair, retry or candidate switch.
The four-hour Issue budget and original cumulative 16-hour cap are retained;
known AI estimates and unobserved historical/human effort are separated in the report.

Full Rev.M1 implementation, backend adoption and ordering remain blocked.
G0A/G0B remain done; G1-G5 remain not-ready. Codex does not reopen or pass Human
Gates. The historical forward sequences in D-016/D-017 and architecture/interface/
DFM documents describe their acceptance-time state; D-018 governs current planning.
USB NPTH **OPEN — PRE-ORDER DFM REVIEW REQUIRED**, unselected production pitch
and the other product risks listed above remain unchanged.

## Dashboard synchronization

`docs/project-status.md` is authoritative for high-level project status.
`task/data/project-status.js` is a manually synchronized Dashboard read model of the milestone plan and current position. Detailed status is not copied.
The PMO milestone proposal is reviewed at the P3 PO PR gate.
If the read model conflicts with this document, this document is correct. Synchronization is reviewed in
the same pull request as a status change; there is currently no generator or
automatic synchronization.

## EDA-004E native KiCad feasibility (accepted report; evaluation-time result)

[Issue #79](https://github.com/ihsinoky/he-piantor-42/issues/79) evaluation record was accepted in merged PR #80:
**PCB_IO_PASS / FRONTEND_UNQUALIFIED**, STOP recommended before Main.
In KiCad 9.0.9, the fixed small trial board's checked shape/connection information
was retained after its saved file was reopened in a separate program execution.
Initial trial acceptance fails two unexpected DRC warnings (U1 reference-number
printing over a soldering area, unconfigured official footprint
library); the two expected unconnected links are identified separately.
Effective-rule negative test and conditional empty-directory regeneration are
NOT ENTERED. No public method for automatically creating a schematic without
GUI interaction was identified for fixed KiCad 9.0.9;
current Main ERC/parity and Main generation/routing/manufacturing are NOT ENTERED.
Deprecated SWIG binding and exact-library/rule maintenance remain additional work.
[Result/evidence](native-kicad-authoring-feasibility.md) and
[history/retry conditions](eda-path-history.md) preserve prior decisions.
EDA-004D's merged PR #78 retains its footprint-library identity collision STOP.
No backend adoption, Human Gate or full implementation authorization is implied.

## EDA-004F headless schematic qualification (accepted historical record; PR #84)

[Issue #83](https://github.com/ihsinoky/he-piantor-42/issues/83):
**SMALL_SCHEMATIC_CANDIDATE_PASS** within six-symbol/16-pin fixture only.
Initial acceptance FAIL (six library warnings); same schematic/configured-library
ERC and independent parity PASS. Both planned faults detected; value-only change
and same-environment empty-directory regeneration PASS. No generated-file edits,
severity suppression, fork, GUI or KiCad version switch. Main/PCB/routing/spacing/
manufacturing/adoption NOT ENTERED. The report was accepted in merged PR #84 on 2026-10-14; acceptance is not
source migration or a Human Gate. Issue #85 separately authorized EDA-004G, whose
proposed STOP is the current evaluation above. No trial is authorized after that STOP. [Report/evidence](headless-schematic-qualification.md).

設計の世代・過去の試行・証跡は [履歴索引](history-index.md) を参照。
