ihsinoky/he-piantor-42/docs/artifacts-index.md

# 現行成果物索引

2026-11-08 / Issue #207（整理計画 P3）。この索引は案内であり、設計データの新しい正本ではない。
既存パスを直接参照し、複製や可変の「latest」は作らない。
[現在の状態・残件・マイルストーン](project-status.md) ／ [ADR採択・置換監査](issue-205-adr-audit.md)。

報告書や成果物READMEの draft／長さ未決等は記録当時の表記。
現行は D-033／D-034 採択済み・GH各200mm、ケース固定点15点、南辺フラッシュはPO了解済み。
これは製造GO・実機合格ではなく、17mmケース正本も量産ピッチ決定を意味しない。

## 現行4成果物

| 対象・版・用途 | CAD／回路の源（正本） | 製造データ／ケース出力 | 検証結果と根拠 | 採択・未了ゲート | 置換元 |
| --- | --- | --- | --- | --- | --- |
| Main Rev.4：再利用Main、三角形3穴、別基板UDB C3 | [最終PCB](../hardware/kicad/qualification/issue-196-main-rev4-phaseb/inspection/final/main.kicad_pcb) · [project](../hardware/kicad/qualification/issue-196-main-rev4-phaseb/inspection/final/main.kicad_pro) · [fp-lib-table](../hardware/kicad/qualification/issue-196-main-rev4-phaseb/inspection/final/fp-lib-table) · [ライブラリ](../hardware/kicad/qualification/issue-196-main-rev4-phaseb/Rev4.pretty) · [native回路図](../hardware/kicad/qualification/issue-196-main-rev4-phaseb/schematic/main.kicad_sch) · [回路XML](../hardware/kicad/qualification/issue-196-main-rev4-phaseb/schematic/main.net.xml) · [論理契約](../hardware/kicad/qualification/issue-196-main-rev4-phaseb/logical-contract.json) | [基板製造ZIP](../hardware/kicad/qualification/issue-196-main-rev4-phaseb/manufacturing/main-rev4-fabrication-review.zip) · [BOM](../hardware/kicad/qualification/issue-196-main-rev4-phaseb/manufacturing/BOM.csv) · [CPL](../hardware/kicad/qualification/issue-196-main-rev4-phaseb/manufacturing/CPL.csv) · [Gerber/drill](../hardware/kicad/qualification/issue-196-main-rev4-phaseb/manufacturing/gerber) · [paste](../hardware/kicad/qualification/issue-196-main-rev4-phaseb/manufacturing/paste) · [再見積引継ぎ](../hardware/kicad/qualification/issue-196-main-rev4-phaseb/manufacturing/quote-handoff.md)。ケースは下記最終版 | 独立4指標0、native DRC違反／未接続0、130via最小0.145mm。[検証](../hardware/kicad/qualification/issue-196-main-rev4-phaseb/verification.json) · [最終判定](../hardware/kicad/qualification/issue-196-main-rev4-phaseb/inspection/final/assessment.json) · [生成hash](../hardware/kicad/qualification/issue-196-main-rev4-phaseb/export-provenance.json) · [CAM](../hardware/kicad/qualification/issue-196-main-rev4-phaseb/cam-check.json) | [D-033](decisions.md#d-033---main-rev4-triangular-baseline-and-separated-udb)採択済み。発注1 PO GO待ち（CPL原点・UDB上流抵抗実測）、再見積／調達／業者DFM、実機検証 | [Main Rev.3](issue-185-main-rev3.md)。旧外形・4穴・オンボードUSB・100mmを当該版で置換 |
| Matrix Rev.3：16/17mm各3×3、18キーの相互作用／実装精度評価基板（製品Wingとは別） | [最終PCB](../hardware/kicad/qualification/issue-182-matrix-rev3/board/m1-matrix18.kicad_pcb) · [project](../hardware/kicad/qualification/issue-182-matrix-rev3/board/m1-matrix18.kicad_pro) · [fp-lib-table](../hardware/kicad/qualification/issue-182-matrix-rev3/board/fp-lib-table)。回路・配置は[Rev.2定義](../hardware/jitx/wing/matrix.py)・[nativeエントリ](../hardware/jitx/he_piantor_42_jitx/evaluation_wing.py)・[回路JSON](../hardware/jitx/wing/generated/m1-matrix18-16-17mm/definition.json)・[nets](../hardware/jitx/wing/generated/m1-matrix18-16-17mm/nets.csv)を継承 | [製造条件](../hardware/kicad/qualification/issue-182-matrix-rev3/manufacturing/FABRICATION.md) · [基板製造ZIP](../hardware/kicad/qualification/issue-182-matrix-rev3/manufacturing/m1-matrix18-gerber-review.zip) · [BOM](../hardware/kicad/qualification/issue-182-matrix-rev3/manufacturing/BOM.csv) · [CPL](../hardware/kicad/qualification/issue-182-matrix-rev3/manufacturing/CPL.csv) · [Gerber/drill](../hardware/kicad/qualification/issue-182-matrix-rev3/manufacturing/gerber) · [paste](../hardware/kicad/qualification/issue-182-matrix-rev3/manufacturing/paste)。ケース出力なし（評価用） | 全受入条件合格、158via最小約0.10746mm。[検証](../hardware/kicad/qualification/issue-182-matrix-rev3/verification.json) · [最終判定](../hardware/kicad/qualification/issue-182-matrix-rev3/inspection/final/assessment.json) · [hash](../hardware/kicad/qualification/issue-182-matrix-rev3/manifest.json) · [回路等保持](../hardware/kicad/qualification/issue-182-matrix-rev3/design-preservation.json) · [CAM](../hardware/kicad/qualification/issue-182-matrix-rev3/manufacturing/manufacturing-check.json) | [D-028](decisions.md#d-028---dual-pitch-matrix-rev2-evaluation-board-naming-per-issue-179-convention)＋[D-029](decisions.md#d-029---matrix-rev3-keep-every-via-clear-of-component-pads-no-pofv)。発注1 PO GO待ち、実測未実施 | [Matrix Rev.2](issue-178-m1-matrix-board.md)、via非重複化。当該Rev.3のみPOFV不要 |
| Wing Rev.3：左右各21キー、16/17mmの4単板、2製造パネル | 下表の最終PCB／projectと各 definition.json（回路・配置定義）。[Stage 1b形状](issue-200-wing-rev3-stage1b.md)を入力とする | 下表の左右一体Standard-PCBAパネルの製造ZIP・BOM・CPL。単板CAMと区別。ケース入力は次節の確定CSV | 4単板の独立接続／DRC／機械検証、パネル／CAM照合。[単板総括](../hardware/kicad/qualification/issue-200-wing-rev3/qualification-summary.json) · [機械](../hardware/kicad/qualification/issue-200-wing-rev3/mechanical-verification.json) · [パネル](../hardware/kicad/qualification/issue-200-wing-rev3/panel-verification.json) · [CAM](../hardware/kicad/qualification/issue-200-wing-rev3/cam-verification.json) · [200mm電源モデル](../hardware/kicad/qualification/issue-200-wing-rev3/power-summary.json) | [D-034](decisions.md#d-034-draft---wing-rev3-baseline-issue-200)採択済み（D-021等継承）。MS3実測→MS4ピッチ判断→Order 2、実物適合・電源検証未了 | [Wing Rev.2](issue-194-wing-rev2-stage2.md)／D-032の指定範囲を置換、200mm保持 |
| ケース最終：17mm正／16mm検証版、固定15点、200mm収納 | [生成器](../hardware/case/issue-198-final/generate.py) · [基本形状](../hardware/case/issue-198-final/base.py) · [詳細](../hardware/case/issue-198-final/details.py) · [依存](../hardware/case/issue-198-final/requirements.txt) · [凍結CSV入力](../hardware/case/issue-198-final/inputs/rev3-final) · [凍結geometry](../hardware/case/issue-198-final/inputs/wing-rev3-geometry.json) | 下表の組立STEPと印刷5ピースSTEP/STL。基板製造・BOM/CPLは対象外 | 両ピッチ：意図しない干渉0、114 solids、印刷5ピース、15点のボス／下穴開口、hash照合。[最終報告](../docs/issue-198-case-final.md)・下表verification | 専用採択D番号なし。D-033／D-034の確定入力、[#198最終報告](issue-198-case-final.md)。南辺フラッシュPO了解済み（P3要件）。印刷PO判断待ち、保持力等の物理検証未了 | [Stage 2](issue-198-case-stage2.md)の13点から最終15点、Wing Rev.3確定CSVへ |

## Wing：単板と製造パネル

単板は `main.kicad_pcb` が最終。`input.kicad_pcb` は入力契約、`routed.kicad_pcb` は途中結果。
右は独立した部品姿勢・銅箔を持つ。単板CAMを左右一体パネル用データと混ぜない。

| 単板 | CAD／回路定義 | 基板hashと検証 | 対応製造パネル |
| --- | --- | --- | --- |
| 16mm 左 | [最終PCB](../hardware/kicad/qualification/issue-200-wing-rev3/wing-rev3-16mm-left/main.kicad_pcb) · [project](../hardware/kicad/qualification/issue-200-wing-rev3/wing-rev3-16mm-left/main.kicad_pro) · [fp-lib-table](../hardware/kicad/qualification/issue-200-wing-rev3/wing-rev3-16mm-left/fp-lib-table) · [回路・配置定義](../hardware/kicad/qualification/issue-200-wing-rev3/wing-rev3-16mm-left/definition.json) | [qualification](../hardware/kicad/qualification/issue-200-wing-rev3/wing-rev3-16mm-left/qualification.json) · [DRC](../hardware/kicad/qualification/issue-200-wing-rev3/wing-rev3-16mm-left/drc.json) · [CAM hash](../hardware/kicad/qualification/issue-200-wing-rev3/wing-rev3-16mm-left/cam-manifest.json) | [panel-16mm](../hardware/kicad/qualification/issue-200-wing-rev3/panel-16mm/) |
| 16mm 右 | [最終PCB](../hardware/kicad/qualification/issue-200-wing-rev3/wing-rev3-16mm-right/main.kicad_pcb) · [project](../hardware/kicad/qualification/issue-200-wing-rev3/wing-rev3-16mm-right/main.kicad_pro) · [fp-lib-table](../hardware/kicad/qualification/issue-200-wing-rev3/wing-rev3-16mm-right/fp-lib-table) · [回路・配置定義](../hardware/kicad/qualification/issue-200-wing-rev3/wing-rev3-16mm-right/definition.json) | [qualification](../hardware/kicad/qualification/issue-200-wing-rev3/wing-rev3-16mm-right/qualification.json) · [DRC](../hardware/kicad/qualification/issue-200-wing-rev3/wing-rev3-16mm-right/drc.json) · [CAM hash](../hardware/kicad/qualification/issue-200-wing-rev3/wing-rev3-16mm-right/cam-manifest.json) | [panel-16mm](../hardware/kicad/qualification/issue-200-wing-rev3/panel-16mm/) |
| 17mm 左 | [最終PCB](../hardware/kicad/qualification/issue-200-wing-rev3/wing-rev3-17mm-left/main.kicad_pcb) · [project](../hardware/kicad/qualification/issue-200-wing-rev3/wing-rev3-17mm-left/main.kicad_pro) · [fp-lib-table](../hardware/kicad/qualification/issue-200-wing-rev3/wing-rev3-17mm-left/fp-lib-table) · [回路・配置定義](../hardware/kicad/qualification/issue-200-wing-rev3/wing-rev3-17mm-left/definition.json) | [qualification](../hardware/kicad/qualification/issue-200-wing-rev3/wing-rev3-17mm-left/qualification.json) · [DRC](../hardware/kicad/qualification/issue-200-wing-rev3/wing-rev3-17mm-left/drc.json) · [CAM hash](../hardware/kicad/qualification/issue-200-wing-rev3/wing-rev3-17mm-left/cam-manifest.json) | [panel-17mm](../hardware/kicad/qualification/issue-200-wing-rev3/panel-17mm/) |
| 17mm 右 | [最終PCB](../hardware/kicad/qualification/issue-200-wing-rev3/wing-rev3-17mm-right/main.kicad_pcb) · [project](../hardware/kicad/qualification/issue-200-wing-rev3/wing-rev3-17mm-right/main.kicad_pro) · [fp-lib-table](../hardware/kicad/qualification/issue-200-wing-rev3/wing-rev3-17mm-right/fp-lib-table) · [回路・配置定義](../hardware/kicad/qualification/issue-200-wing-rev3/wing-rev3-17mm-right/definition.json) | [qualification](../hardware/kicad/qualification/issue-200-wing-rev3/wing-rev3-17mm-right/qualification.json) · [DRC](../hardware/kicad/qualification/issue-200-wing-rev3/wing-rev3-17mm-right/drc.json) · [CAM hash](../hardware/kicad/qualification/issue-200-wing-rev3/wing-rev3-17mm-right/cam-manifest.json) | [panel-17mm](../hardware/kicad/qualification/issue-200-wing-rev3/panel-17mm/) |

| 製造パネル（左右1組） | CAD | 製造・実装正本 | 検証 |
| --- | --- | --- | --- |
| 16mm 左右一体 | [PCB](../hardware/kicad/qualification/issue-200-wing-rev3/panel-16mm/main.kicad_pcb) · [project](../hardware/kicad/qualification/issue-200-wing-rev3/panel-16mm/main.kicad_pro) | [基板製造ZIP](../hardware/kicad/qualification/issue-200-wing-rev3/panel-16mm/fabrication.zip) · [BOM](../hardware/kicad/qualification/issue-200-wing-rev3/panel-16mm/bom.csv) · [CPL](../hardware/kicad/qualification/issue-200-wing-rev3/panel-16mm/cpl.csv) · [pin1](../hardware/kicad/qualification/issue-200-wing-rev3/panel-16mm/pin1.csv) | [CAM hash](../hardware/kicad/qualification/issue-200-wing-rev3/panel-16mm/cam-manifest.json) · [DRC](../hardware/kicad/qualification/issue-200-wing-rev3/panel-16mm/drc.json) |
| 17mm 左右一体 | [PCB](../hardware/kicad/qualification/issue-200-wing-rev3/panel-17mm/main.kicad_pcb) · [project](../hardware/kicad/qualification/issue-200-wing-rev3/panel-17mm/main.kicad_pro) | [基板製造ZIP](../hardware/kicad/qualification/issue-200-wing-rev3/panel-17mm/fabrication.zip) · [BOM](../hardware/kicad/qualification/issue-200-wing-rev3/panel-17mm/bom.csv) · [CPL](../hardware/kicad/qualification/issue-200-wing-rev3/panel-17mm/cpl.csv) · [pin1](../hardware/kicad/qualification/issue-200-wing-rev3/panel-17mm/pin1.csv) | [CAM hash](../hardware/kicad/qualification/issue-200-wing-rev3/panel-17mm/cam-manifest.json) · [DRC](../hardware/kicad/qualification/issue-200-wing-rev3/panel-17mm/drc.json) |

各パネルは独立回路の左右を無銅タブで連結。両面実装の Standard PCBA（下面84＋上面14購入部品配置）を前提に、製造後に左右を分離する。

### Wing→ケースの確定インタフェース

供給側正本は [issue-200-rev3 README](../hardware/case/issue-200-rev3/README.md)。ケース側の `inputs/rev3-final/` は最終生成時の凍結入力であり、供給側の代替正本ではない。

| ピッチ・側 | 確定CSV（供給側） |
| --- | --- |
| 16mm left | [outline](../hardware/case/issue-200-rev3/outline-16mm-left.csv) · [holes](../hardware/case/issue-200-rev3/holes-16mm-left.csv) · [keys](../hardware/case/issue-200-rev3/keys-16mm-left.csv) |
| 16mm right | [outline](../hardware/case/issue-200-rev3/outline-16mm-right.csv) · [holes](../hardware/case/issue-200-rev3/holes-16mm-right.csv) · [keys](../hardware/case/issue-200-rev3/keys-16mm-right.csv) |
| 17mm left | [outline](../hardware/case/issue-200-rev3/outline-17mm-left.csv) · [holes](../hardware/case/issue-200-rev3/holes-17mm-left.csv) · [keys](../hardware/case/issue-200-rev3/keys-17mm-left.csv) |
| 17mm right | [outline](../hardware/case/issue-200-rev3/outline-17mm-right.csv) · [holes](../hardware/case/issue-200-rev3/holes-17mm-right.csv) · [keys](../hardware/case/issue-200-rev3/keys-17mm-right.csv) |

## ケース：組立確認と印刷データ

パラメトリック源・凍結入力は上表。`assembly.step` は組立確認用で、印刷データは5ピース。

| 版 | 組立・経路 | 印刷5ピース（各 STEP / STL） | 検証・hash・寸法 |
| --- | --- | --- | --- |
| 17mm（正） | [組立](../hardware/case/issue-198-final/17mm/assembly.step) · [ハーネス](../hardware/case/issue-198-final/17mm/harness.step) · [200mm収納](../hardware/case/issue-198-final/17mm/storage-200mm.step) | [tray-left STEP](../hardware/case/issue-198-final/17mm/tray-left.step) · [STL](../hardware/case/issue-198-final/17mm/tray-left.stl)<br>[tray-right STEP](../hardware/case/issue-198-final/17mm/tray-right.step) · [STL](../hardware/case/issue-198-final/17mm/tray-right.stl)<br>[splice-1 STEP](../hardware/case/issue-198-final/17mm/splice-1.step) · [STL](../hardware/case/issue-198-final/17mm/splice-1.stl)<br>[splice-2 STEP](../hardware/case/issue-198-final/17mm/splice-2.step) · [STL](../hardware/case/issue-198-final/17mm/splice-2.stl)<br>[cable-rack STEP](../hardware/case/issue-198-final/17mm/cable-rack.step) · [STL](../hardware/case/issue-198-final/17mm/cable-rack.stl) | [検証](../hardware/case/issue-198-final/17mm/verification.json) · [出力hash](../hardware/case/issue-198-final/17mm/exports-sha256.json) · [寸法](../hardware/case/issue-198-final/17mm/dimensions.json) · [レビュー図](../hardware/case/issue-198-final/17mm/review.svg) |
| 16mm（再生成・検証版） | [組立](../hardware/case/issue-198-final/16mm/assembly.step) · [ハーネス](../hardware/case/issue-198-final/16mm/harness.step) · [200mm収納](../hardware/case/issue-198-final/16mm/storage-200mm.step) | [tray-left STEP](../hardware/case/issue-198-final/16mm/tray-left.step) · [STL](../hardware/case/issue-198-final/16mm/tray-left.stl)<br>[tray-right STEP](../hardware/case/issue-198-final/16mm/tray-right.step) · [STL](../hardware/case/issue-198-final/16mm/tray-right.stl)<br>[splice-1 STEP](../hardware/case/issue-198-final/16mm/splice-1.step) · [STL](../hardware/case/issue-198-final/16mm/splice-1.stl)<br>[splice-2 STEP](../hardware/case/issue-198-final/16mm/splice-2.step) · [STL](../hardware/case/issue-198-final/16mm/splice-2.stl)<br>[cable-rack STEP](../hardware/case/issue-198-final/16mm/cable-rack.step) · [STL](../hardware/case/issue-198-final/16mm/cable-rack.stl) | [検証](../hardware/case/issue-198-final/16mm/verification.json) · [出力hash](../hardware/case/issue-198-final/16mm/exports-sha256.json) · [寸法](../hardware/case/issue-198-final/16mm/dimensions.json) · [レビュー図](../hardware/case/issue-198-final/16mm/review.svg) |

根拠報告： [Main](issue-196-main-rev4-phaseb.md) · [Matrix](issue-182-matrix-rev3.md) · [Wing](issue-200-wing-rev3-stage2.md) · [ケース](issue-198-case-final.md)。元記録の検証は当該データ・モデルの範囲に限り、実機試験の代用にしない。
