ihsinoky/he-piantor-42/docs/repo-cleanup-plan.md

# リポジトリ整理・ナレッジ整理 実行計画案

作成日：2026-11-08。対象：origin/main = `8ef9efb2feac52cf7158d3e559b4dbd73cf880af`（PR #203 まで）。本書は計画であり、設計変更・再生成・発注・マージの許可ではない。今回の変更は本書の追加だけとする。

## 0. PO判断（2026-11-08）：リポジトリ整理と成果公開の方針【確定】

本節が本計画の確定方針であり、後段の提案・代替案・検討文書と矛盾する場合は本節が優先する。

**構成**
- 開発用リポジトリ（既存の he-piantor-42）：設計データ、開発履歴、失敗試行、検証証跡、ADR、Finding の正本を保持する。現在のフォルダ構造を原則維持し、物理的な再配置は行わない。成果物索引と履歴索引（P3/P4）を整備し、AI が現行の正本と過去の記録を区別できるよう状態情報と参照ルールを整える
- 公開用リポジトリ（新規・独立、名称未定）：完成成果と得られた知見を読者の目的に合わせて編集・整理する場。README からプロジェクト概要、主要な設計判断、得られた知見、製作方法へ進める構造とし、詳細な根拠は開発用リポジトリの ADR、Finding、Issue、PR、検証記録へ案内する。開発用の全ファイルや履歴は複製しない。開発用リポジトリのフォークや常時同期する複製ではない
- ここでいう「公開」は GitHub のアクセス権の変更ではなく、PO 自身の一次発信において何を紹介するかという意味である

**判断理由（要約）**
- hardware/work/ への一括移動案は、相対参照・スクリプトの階層依存・CI・パス付きハッシュへの影響が実測で想定以上に大きいことが示された（`docs/work-layer-discussion.md`）。この費用を負担してまで開発用リポジトリを再配置する合理性は低く、Codex の反対意見を採用した
- 開発の再現性を維持することと、読者に分かりやすく成果を伝えることは目的が異なるため、両者を別リポジトリとして分離する

**GitHub Releases の扱い**
- 製造・利用に必要なデータ（ガーバー、BOM、CPL、ケースの3Dデータ、ファームウェア等）は、公開用リポジトリの GitHub Releases から用途別の ZIP で配布する
- バージョンは Git タグで管理する。版別フォルダは作らない
- 配布物は開発用リポジトリの特定コミットから抽出・生成し、元コミット、対象ファイル、ハッシュ値、検証結果、必要なライセンス情報を記録する
- 公開用の配布データは直接修正しない。変更は開発用の正本に反映する
- 公開前に、必要な依存ファイルが揃っていることと、配布物を利用できることを確認する

**更新方針**
- 公開用リポジトリは開発の各 PR に追随して更新しない。完成時や、独立して公開する価値のある節目に、PO 判断によって更新する
- 公開資料には対象の開発版と検証範囲を明記し、後続の開発結果と混同しないようにする
- 公開資料に問題が見つかった場合は、原則として開発側で事実関係を確認・訂正し、その結果を公開側へ反映する。重大な問題は次の通常更新を待たずに対応する

**本計画のフェーズへの適用**
- P3/P4：予定どおり実施する
- P5/P6：予定どおり実施する（将来の公開にも再利用できる形で知見を蓄積する）
- P7/P8：当面実施しない。物理再配置は今回の整理計画の実行対象から外す。将来、独立した必要性が生じた場合だけ再検討する
- 公開用リポジトリは別計画として扱う。現段階では構築せず、完成に向けた節目で具体化する。本計画（本 PR）のスコープに公開用リポジトリの詳細設計・新規作成は含めない
- 各フェーズは従来どおり個別の Issue、レビュー、PO 承認を経て実行する。本判断をもって計画書の更新以外の作業を自動的に開始しない

**検討文書の位置づけ**
- `docs/publication-discussion.md` と `docs/work-layer-discussion.md` は提案段階の議論記録であり、本節の確定方針とは区別する。各文書の冒頭にもその旨を明記する

## 1. 調査範囲と判断の前提

このチェックアウトの追跡対象14,920ファイルを `git ls-files` で抽出し、分類単位の実在、最新成果物の具体的なファイル、各 README・報告書との対応を確認した。全既存追跡ファイルの SHA-256 を作業用に保存した。棚卸しは付録A・Bで追跡対象全体を覆い、最新成果物は2節でファイルまで絞る。ディレクトリの件数は配下の追跡ファイル数で、部分列挙を全数と誤認しないために示す。未追跡の作業領域は棚卸しの件数に含めない。

根拠は `docs/decisions.md`、`docs/project-status.md`、各成果物の README と対応する Issue 報告書、Git履歴である。2026-11-08 に GitHub CLI で [PR #192](https://github.com/ihsinoky/he-piantor-42/pull/192) を読み取り確認した結果は OPEN / Draft / 未マージ、head は `findings-ledger`、`627fdcf83391a112a74f8a367b5e52a3bd0a8794`。ローカルの同コミットから D-031 と F-001 の全文も確認した。外部状態は実行開始時に再確認する。

「最終」は現時点の設計・検証パッケージの正本を意味する。製造GO、量産ピッチの決定、実機合格は別である。過去の不合格試行、凍結入力、独立検査コードも設計根拠として保存する。ディレクトリ名に Issue 番号があっても不要物とは判定しない。

## 2. 最新成果物の正の場所（実在確認済み）

以下のパスはすべてリポジトリroot基準。略号はこの節で定義する実在ディレクトリへの参照であり、別の保存先ではない。

| 対象 | 正本ディレクトリ | 設計・製造の入口と根拠 |
| --- | --- | --- |
| Main Rev.4（M） | `hardware/kicad/qualification/issue-196-main-rev4-phaseb/` | 同ディレクトリの README、`docs/issue-196-main-rev4-phaseb.md`、D-033。Phase A/A-2 は入力・設計履歴 |
| Matrix Rev.3（X） | `hardware/kicad/qualification/issue-182-matrix-rev3/` | 同 README、`docs/issue-182-matrix-rev3.md`、D-029。18キー・16/17mm混載評価基板で、製品 Wing と別物 |
| Wing Rev.3（W） | `hardware/kicad/qualification/issue-200-wing-rev3/` | 同 README、`docs/issue-200-wing-rev3-stage2.md`、D-034。16/17mm×左右4基板と2パネル |
| Wing→ケースの確定インタフェース | `hardware/case/issue-200-rev3/` | 同 README と生成器、outline/holes/keys の12 CSV。ケース形状そのものではない |
| ケース最終（C） | `hardware/case/issue-198-final/` | 同 README、`docs/issue-198-case-final.md`。17mm版が正、16mm版は再生成・検証済み。固定点15、GH200mm |

### 2.1 Main Rev.4

- 基板：`hardware/kicad/qualification/issue-196-main-rev4-phaseb/inspection/final/main.kicad_pcb`。同所の `main.kicad_pro`、`fp-lib-table`、`Rev4.pretty/` と組にする。
- 回路源：`hardware/kicad/qualification/issue-196-main-rev4-phaseb/schematic/`（native回路図・XML・論理契約）。
- 製造：`hardware/kicad/qualification/issue-196-main-rev4-phaseb/manufacturing/`。`main-rev4-fabrication-review.zip`、`BOM.csv`、`CPL.csv`、`gerber/`、`paste/`。ZIPだけで実装データ一式とは扱わない。
- 引継ぎ：`hardware/kicad/qualification/issue-196-main-rev4-phaseb/manufacturing/quote-handoff.md`。検証：同証跡rootの `verification.json`、`export-provenance.json`、`cam-check.json`、`inspection/final/assessment.json`。
- D-033 は Accepted。再見積、BOM調達、業者受入れ、USB・電源・実組立評価は別ゲート。旧Mainの見積や旧Wing抵抗モデルを新パッケージに流用しない。

### 2.2 Matrix Rev.3

- 基板：`hardware/kicad/qualification/issue-182-matrix-rev3/board/m1-matrix18.kicad_pcb`。同所の `m1-matrix18.kicad_pro`、`fp-lib-table` を保持する。旧命名が残るが、ファイル名だけで版を判定しない。
- 製造：`hardware/kicad/qualification/issue-182-matrix-rev3/manufacturing/`。`FABRICATION.md`、`m1-matrix18-gerber-review.zip`、`BOM.csv`、`CPL.csv`、Gerber/drill/paste、組立図、`manufacturing-check.json`。
- 検証：`hardware/kicad/qualification/issue-182-matrix-rev3/verification.json`、`manifest.json`、`inspection/final/assessment.json`。158 via、最小パッド銅間隔約0.10746mm。Rev.3パッケージのPOFV不要という判断を旧版に遡及しない。

### 2.3 Wing Rev.3

単板の正本は次の4ディレクトリ内の `main.kicad_pcb` と対応 `main.kicad_pro`。同所の `qualification.json` が基板hashと検査を結ぶ。`input.kicad_pcb` は入力契約、`routed.kicad_pcb` は途中結果であり、製造入力に選ばない。

- `hardware/kicad/qualification/issue-200-wing-rev3/wing-rev3-16mm-left/`
- `hardware/kicad/qualification/issue-200-wing-rev3/wing-rev3-16mm-right/`
- `hardware/kicad/qualification/issue-200-wing-rev3/wing-rev3-17mm-left/`
- `hardware/kicad/qualification/issue-200-wing-rev3/wing-rev3-17mm-right/`

製造・実装の正本は次の左右一体パネル。各所に `main.kicad_pcb`、`main.kicad_pro`、`fabrication.zip`、`bom.csv`、`cpl.csv`、`pin1.csv`、`cam-manifest.json`、`drc.json` がある。両面実装の Standard PCBA 前提と、左右を分離する工程を案内に残す。

- `hardware/kicad/qualification/issue-200-wing-rev3/panel-16mm/`
- `hardware/kicad/qualification/issue-200-wing-rev3/panel-17mm/`

ケースへ渡す CSV の正本は `hardware/case/issue-200-rev3/`。例えば `holes-17mm-left.csv`、`outline-17mm-left.csv`、`keys-17mm-left.csv` が実在する。16/17mm・左右を欠かさず一覧化する。D-034 本文は Accepted・200mm維持だが、見出しと Stage 2 報告・README には draft/未決が残る。原記録を消さず最新状態への案内で解決する。
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
