ihsinoky/he-piantor-42/task/screenshots/dashboard-390-text-200pct.png

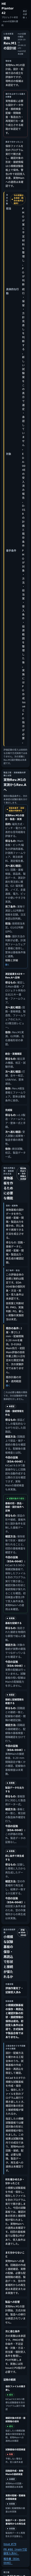
task/screenshots/dashboard-390-text-200pct.png
