ihsinoky/he-piantor-42/hardware/sensor-test/bom.csv

block | reference | qty | manufacturer | mpn | lcsc | package | value_or_note | population
MCU | U1 | 1 | Raspberry Pi | RP2040 | C2040 | LQFN-56 | MCU | baseline
Flash | U2 | 1 | Winbond | W25Q16JVUXIQ | C2843335 | USON-8-EP(2x3) | 16Mbit QSPI | baseline
Crystal | Y1 | 1 | Abracon | ABM8-272-T3 | C20625731 | SMD3225-4P | 12MHz 10pF | baseline
Logic regulator | U3 | 1 | Diodes Inc. | AP2112K-3.3TRG1 | C51118 | SOT-25-5 | 3.3V 600mA | baseline
Logic regulator input capacitor | C1 | 1 | TBD | TBD | TBD | 0603 | 1uF X7R VBUS-to-GND | baseline
Logic regulator output capacitor | C2 | 1 | TBD | TBD | TBD | 0603 | 1uF X7R 3V3-to-GND | baseline
Hall load switch | U4 | 1 | Texas Instruments | TPS22919DCKR | C2149796 | SC-70-6 | switched HALL_5V | baseline
Hall switch input decoupling | C25 | 1 | TBD | TBD | TBD | 0603 | 1uF X7R VBUS-to-GND | baseline
Hall rail bulk/decoupling | C18 | 1 | TBD | TBD | TBD | 0603 | 1uF X7R HALL_5V-to-GND | baseline
Analog mux | U5 | 1 | Texas Instruments | TMUX1208PWR | C494728 | TSSOP-16 | 8:1 mux | baseline
Hall sensor | U6-U9 | 4 | Texas Instruments | DRV5055A3QDBZR | C266128 | SOT-23 | +/-85mT 25mV/mT@5V | reference build
USB connector | J1 | 1 | Korean Hroparts Elec | TYPE-C-31-M-12 | C165948 | SMD | USB-C 16P | baseline
USB ESD | U10 | 1 | STMicroelectronics | USBLC6-2SC6 | C7519 | SOT-23-6L | USB 2.0 two-line ESD protection | baseline
USB CC resistors | R1 R2 | 2 | TBD | TBD | TBD | 0603 | 5.1k 1% | baseline
USB series resistors | R3 R4 | 2 | TBD | TBD | TBD | 0603 | 27R 1% | baseline
Crystal series resistor | R5 | 1 | TBD | TBD | TBD | 0603 | 1k 1% | baseline
Flash decoupling | C3 | 1 | TBD | TBD | TBD | 0402 | 100nF X7R | baseline
RP2040 high-frequency decoupling | C4-C8 C10 C12 C13 C16 | 9 | TBD | TBD | TBD | 0402 | 100nF X7R | baseline
RP2040 regulator decoupling | C9 C11 | 2 | TBD | TBD | TBD | 0402 | 1uF X7R | baseline
RP2040 bulk capacitor | C17 | 1 | TBD | TBD | TBD | 0805 | 10uF X7R | baseline
QSPI optional resistor | R8 | 1 | TBD | TBD | TBD | 0603 | DNF | do not fit
BOOTSEL series resistor | R9 | 1 | TBD | TBD | TBD | 0603 | 1k 1% | baseline
Crystal load capacitors | C14 C15 | 2 | TBD | TBD | TBD | 0402 | 15pF C0G | baseline
ADC divider top | R6 | 1 | TBD | TBD | TBD | 0603 | 6.8k 1% | baseline
ADC divider bottom | R7 | 1 | TBD | TBD | TBD | 0603 | 10k 1% | baseline
ADC filter | C24 | 1 | TBD | TBD | TBD | 0603 | 1nF C0G/X7R | baseline
Hall decoupling | C20-C23 | 4 | TBD | TBD | TBD | 0603 | 100nF X7R | baseline
Mux decoupling | C19 | 1 | TBD | TBD | TBD | 0603 | 100nF X7R | baseline
Power LED | D1 | 1 | TBD | TBD | TBD | 0603 | green | baseline
Power LED resistor | R10 | 1 | TBD | TBD | TBD | 0603 | 1.5k target <1mA | baseline
Status LED | D2 | 1 | TBD | TBD | TBD | 0603 | GPIO11 diagnostic LED | baseline
Status LED resistor | R11 | 1 | TBD | TBD | TBD | 0603 | 1.5k target <1mA | baseline
BOOTSEL switch | SW1 | 1 | TBD | TBD | TBD | PTS810-compatible SMD tact | QSPI_SS to GND through R9 | baseline
RESET switch | SW2 | 1 | TBD | TBD | TBD | PTS810-compatible SMD tact | RUN to GND | baseline
