ihsinoky/he-piantor-42/hardware/kicad/qualification/issue-185-main-rev3/main-bom.csv

ref | value | footprint | part_number | lcsc | assembled | source | procurement_confirmed
C1 | 15pF | Stage175:C1 | 0402CG150J500NT | C1548 | True | Inherited #124 ledger | False
C10 | 100nF | Stage175:C10 | CL05B104KO5NNNC | C1525 | True | Inherited #124 ledger | False
C11 | 100nF | Stage175:C11 | CL05B104KO5NNNC | C1525 | True | Inherited #124 ledger | False
C12 | 1uF | Stage175:C12 | CL05A105KA5NQNC | C52923 | True | Inherited #124 ledger | False
C13 | 1uF | Stage175:C13 | CL05A105KA5NQNC | C52923 | True | Inherited #124 ledger | False
C14 | 10uF | Stage175:C14 | CL21A106KAYNNNE | C15850 | True | Inherited #124 ledger | False
C15 | 100nF | Stage175:C15 | CL05B104KO5NNNC | C1525 | True | Inherited #124 ledger | False
C16 | 1uF | Stage175:C16 | CL10A105KB8NNNC | C15849 | True | Inherited #124 ledger | False
C17 | 1uF | Stage175:C17 | CL10A105KB8NNNC | C15849 | True | Inherited #124 ledger | False
C18 | 1uF | Stage175:C18 | CL10A105KB8NNNC | C15849 | True | Inherited #124 ledger | False
C19 | 1uF | Stage175:C19 | CL10A105KB8NNNC | C15849 | True | Inherited #124 ledger | False
C2 | 15pF | Stage175:C2 | 0402CG150J500NT | C1548 | True | Inherited #124 ledger | False
C20 | 1nF | Stage175:C20 | 0402B102K500NT | C1523 | True | Inherited #124 ledger | False
C21 | 1nF | Stage175:C21 | 0402B102K500NT | C1523 | True | Inherited #124 ledger | False
C22 | 1nF | Stage175:C22 | 0402B102K500NT | C1523 | True | Inherited #124 ledger | False
C23 | 22uF 16V X6S 0805 | Stage175:C23 | GRM21BC81C226ME44L | C258782 | True | Issue175 retained exact MPN; Issue185 geometry; sourcing and manufacturer acceptance pending | False
C24 | 22uF 16V X6S 0805 | Stage175:C24 | GRM21BC81C226ME44L | C258782 | True | Issue175 retained exact MPN; Issue185 geometry; sourcing and manufacturer acceptance pending | False
C25 | 100nF | Stage175:C25 | CL05B104KO5NNNC | C1525 | True | Substituted 2026-11-07 (PO decision): GRM155R71E104KE14D (Murata 100nF 25V X7R 0402 | JLCPCB Extended) replaced by Samsung CL05B104KO5NNNC (100nF 16V X7R 0402 | JLCPCB Basic) | the same part already used at C3-C11/C15. C25 is the TPS63070 VAUX bypass (datasheet SLVSC58A: capacitance connected to VAUX pin 100nF; VAUX absolute maximum 7V) | so a 16V rating keeps more than 2x margin over the maximum voltage the pin can see. Same value | dielectric and footprint; board data unchanged. Verified by requote 2026-11-07: $122.29 vs $125.55 pre-amendment (Extended fee $43.26 vs $46.35). | False
C26 | 22uF 16V X7R 1210 | Stage175:C26 | C3225X7R1C226K250AC |  | True | Issue175 retained exact MPN; Issue185 geometry; sourcing and manufacturer acceptance pending | False
C27 | 22uF 16V X7R 1210 | Stage175:C27 | C3225X7R1C226K250AC |  | True | Issue175 retained exact MPN; Issue185 geometry; sourcing and manufacturer acceptance pending | False
C28 | 22uF 16V X7R 1210 | Stage175:C28 | C3225X7R1C226K250AC |  | True | Issue175 retained exact MPN; Issue185 geometry; sourcing and manufacturer acceptance pending | False
C3 | 100nF | Stage175:C3 | CL05B104KO5NNNC | C1525 | True | Inherited #124 ledger | False
C4 | 100nF | Stage175:C4 | CL05B104KO5NNNC | C1525 | True | Inherited #124 ledger | False
C5 | 100nF | Stage175:C5 | CL05B104KO5NNNC | C1525 | True | Inherited #124 ledger | False
C6 | 100nF | Stage175:C6 | CL05B104KO5NNNC | C1525 | True | Inherited #124 ledger | False
C7 | 100nF | Stage175:C7 | CL05B104KO5NNNC | C1525 | True | Inherited #124 ledger | False
C8 | 100nF | Stage175:C8 | CL05B104KO5NNNC | C1525 | True | Inherited #124 ledger | False
C9 | 100nF | Stage175:C9 | CL05B104KO5NNNC | C1525 | True | Inherited #124 ledger | False
J1 | TYPE-C-31-M-12 | Stage175:J1 | TYPE-C-31-M-12 | C165948 | True | Inherited #124 ledger | False
J2 | BM14B-GHS-TBT(LF)(SN) | Stage175:J2 | BM14B-GHS-TBT(LF)(SN) | C265384 | True | Inherited #124 ledger | False
J3 | BM14B-GHS-TBT(LF)(SN) | Stage175:J3 | BM14B-GHS-TBT(LF)(SN) | C265384 | True | Issue175 retained exact MPN; Issue185 geometry; sourcing and manufacturer acceptance pending | False
L1 | 1.5uH XFL4020-152MEC | Stage175:L1 | XFL4020-152MEC | C3033018 | True | Issue175 retained exact MPN; Issue185 geometry; sourcing and manufacturer acceptance pending | False
R1 | 5.1k | Stage175:R1 | 0603WAF5101T5E | C23186 | True | Inherited #124 ledger | False
R10 | 6.8k | Stage175:R10 | 0603WAF6801T5E | C23212 | True | Inherited #124 ledger | False
R11 | 10k | Stage175:R11 | 0603WAF1002T5E | C25804 | True | Inherited #124 ledger | False
R12 | 6.8k | Stage175:R12 | 0603WAF6801T5E | C23212 | True | Inherited #124 ledger | False
R13 | 10k | Stage175:R13 | 0603WAF1002T5E | C25804 | True | Inherited #124 ledger | False
R14 | 6.8k | Stage175:R14 | 0603WAF6801T5E | C23212 | True | Inherited #124 ledger | False
R15 | 10k | Stage175:R15 | 0603WAF1002T5E | C25804 | True | Inherited #124 ledger | False
R16 | 100k | Stage175:R16 | 0603WAF1003T5E | C25803 | True | Issue175 retained exact MPN; Issue185 geometry; sourcing and manufacturer acceptance pending | False
R17 | 54.9k 0.1% 25ppm/K | Stage175:R17 | TNPW060354K9BEEA |  | True | Issue175 retained exact MPN; Issue185 geometry; sourcing and manufacturer acceptance pending | False
R18 | 10k 0.1% 25ppm/K | Stage175:R18 | TNPW060310K0BEEA | C844890 | True | Issue175 retained exact MPN; Issue185 geometry; sourcing and manufacturer acceptance pending | False
R19 | 100k | Stage175:R19 | 0603WAF1003T5E | C25803 | True | Issue175 retained exact MPN; Issue185 geometry; sourcing and manufacturer acceptance pending | False
R2 | 5.1k | Stage175:R2 | 0603WAF5101T5E | C23186 | True | Inherited #124 ledger | False
R3 | 27 | Stage175:R3 | 0603WAF270JT5E | C25190 | True | Inherited #124 ledger | False
R4 | 27 | Stage175:R4 | 0603WAF270JT5E | C25190 | True | Inherited #124 ledger | False
R5 | 1k | Stage175:R5 | 0603WAF1001T5E | C21190 | True | Inherited #124 ledger | False
R6 | 100k | Stage175:R6 | 0603WAF1003T5E | C25803 | True | Inherited #124 ledger | False
R7 | 100k | Stage175:R7 | 0603WAF1003T5E | C25803 | True | Inherited #124 ledger | False
R8 | 10k | Stage175:R8 | 0603WAF1002T5E | C25804 | True | Inherited #124 ledger | False
R9 | 1k | Stage175:R9 | 0603WAF1001T5E | C21190 | True | Inherited #124 ledger | False
TP1 | TestPoint | Stage175:TP1 | N/A (bare PCB test pad) | N/A | False | Inherited #124 ledger | False
TP2 | TestPoint | Stage175:TP2 | N/A (bare PCB test pad) | N/A | False | Inherited #124 ledger | False
TP3 | TestPoint | Stage175:TP3 | N/A (bare PCB test pad) | N/A | False | Inherited #124 ledger | False
TP4 | TestPoint | Stage175:TP4 | N/A (bare PCB test pad) | N/A | False | Inherited #124 ledger | False
U1 | RP2040 | Stage175:U1 | RP2040 | C2040 | True | Inherited #124 ledger | False
U2 | USBLC6-2SC6 | Stage175:U2 | USBLC6-2SC6 | C7519 | True | Inherited #124 ledger | False
U3 | W25Q16JVUXIQ | Stage175:U3 | W25Q16JVUXIQ | C2843335 | True | Inherited #124 ledger | False
U4 | AP2112K-3.3TRG1 | Stage175:U4 | AP2112K-3.3TRG1 | C51118 | True | Inherited #124 ledger | False
U5 | TPS22919DCKR | Stage175:U5 | TPS22919DCKR | C2149796 | True | Inherited #124 ledger | False
U6 | TPS63070RNMR | Stage175:U6 | TPS63070RNMR | C109322 | True | Issue175 retained exact MPN; Issue185 geometry; sourcing and manufacturer acceptance pending | False
Y1 | ABM8-272-T3 | Stage175:Y1 | ABM8-272-T3 | C20625731 | True | Inherited #124 ledger | False
