ihsinoky/he-piantor-42/hardware/case/issue-230-mount-study/16mm-right/pcb-floating-rev4-candidates.csv

id | x_mm | y_mm | hole_diameter_mm | local_plane_clearance_required
C1 | 0.0 | 54.0 | 3.05 | True
C2 | -44.0 | 3.0 | 3.05 | True
C3 | 41.0 | 38.0 | 3.05 | True
C4 | 30.0 | 38.0 | 3.05 | True
C5 | 49.0 | 38.0 | 3.05 | True
C6 | -44.0 | 24.0 | 3.05 | True
