ihsinoky/he-piantor-42/hardware/case/issue-230-mount-study/17mm-left/rev4-legal-boss-candidates.csv

id | x_mm | y_mm | hole_diameter_mm | keepout_diameter_mm | local_plane_clearance_required
D1 | 4.0 | -6.0 | 2.2 | 5 | False
D2 | -57.1 | 48.2 | 2.2 | 5 | False
D3 | 60.1 | -17.0 | 2.2 | 5 | False
D4 | 60.1 | 48.2 | 2.2 | 5 | False
D5 | -42.0 | 36.0 | 2.2 | 5 | True
D6 | 12.0 | 48.0 | 2.2 | 5 | True
D7 | -52.0 | 36.0 | 2.2 | 5 | True
D8 | 44.0 | 1.0 | 2.2 | 5 | True
