ihsinoky/he-piantor-42/hardware/kicad/qualification/issue-200-wing-rev3/harness-main-all-pairs.csv

variant | diameter_mm | reference | value | footprint_bbox_mm | planar_gap_mm | under_sweep | intended_mating
16mm-left | 2.0 | C26 | 22uF 16V X7R 1210 | [2.224998999999997, 34.25, 6.174999999999997, 37.150000000000006] | 14.419421697463267 | False | False
16mm-left | 2.0 | L1 | 1.5uH XFL4020-152MEC | [-0.7000000000000028, 29.700000000000003, 3.700000000000003, 33.3] | 11.299999999999999 | False | False
16mm-left | 2.0 | C21 | 1nF | [14.680000000000007, 52.22, 15.319999999999993, 53.78] | 30.55694554644661 | False | False
16mm-left | 2.0 | C22 | 1nF | [17.680000000000007, 52.22, 18.319999999999993, 53.78] | 33.43720201121572 | False | False
16mm-left | 2.0 | R3 | 27 | [-10.224999999999994, 40.525000000000006, -7.775000000000006, 41.474999999999994] | 3.5953135829172616 | False | False
16mm-left | 2.0 | U4 | AP2112K-3.3TRG1 | [-14.299999999999997, 45.25, -10.700000000000003, 47.75] | 1.5500022854242963 | False | False
16mm-left | 2.0 | U6 | TPS63070RNMR | [-4.450000000000003, 29.299999999999997, -1.7249999999999943, 32.7] | 7.549999999999997 | False | False
16mm-left | 2.0 | C9 | 100nF | [5.680000000000007, 48.72, 6.319999999999993, 50.28] | 20.93880303445165 | False | False
16mm-left | 2.0 | R13 | 10k | [14.525000000000006, 54.775000000000006, 15.474999999999994, 57.224999999999994] | 31.251380590484768 | False | False
16mm-left | 2.0 | C16 | 1uF | [-13.224999999999994, 49.025000000000006, -10.775000000000006, 49.974999999999994] | 5.440217886690318 | False | False
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
17mm-right | 5.0 | J4 | SM04B-SRSS-TB(LF)(SN) | [-3.4000000000000057, 19.75, 3.4000000000000057, 25.549999999999997] | 7.099999999999994 | False | False
