ihsinoky/he-piantor-42/hardware/jitx/wing/generated/pitch9-17mm/placements.csv

reference | mpn | x_mm | y_mm | rotation_ccw_deg | side
U_HA0 | DRV5055A3QDBZR | -17.0 | 27.0 | 0 | top
C_HA0 | GRM188R71C104KA01D | -13.5 | 27.0 | 0 | top
U_HA1 | DRV5055A3QDBZR | -17.0 | 10.0 | 0 | top
C_HA1 | GRM188R71C104KA01D | -13.5 | 10.0 | 0 | top
U_HA2 | DRV5055A3QDBZR | -17.0 | -7.0 | 0 | top
C_HA2 | GRM188R71C104KA01D | -13.5 | -7.0 | 0 | top
U_MUX_A | TMUX1208PWR | -18.0 | -22.0 | 0 | top
C_MUX_A | GRM188R71C104KA01D | -13.0 | -21.0 | 0 | top
TP_W_MUXA | PCB_PAD_1.2MM | -18.0 | -27.0 | 0 | top
TP_W_GND_A | PCB_PAD_1.2MM | -15.0 | -27.0 | 0 | top
U_HB0 | DRV5055A3QDBZR | 0.0 | 27.0 | 0 | top
C_HB0 | GRM188R71C104KA01D | 3.5 | 27.0 | 0 | top
U_HB1 | DRV5055A3QDBZR | 0.0 | 10.0 | 0 | top
C_HB1 | GRM188R71C104KA01D | 3.5 | 10.0 | 0 | top
U_HB2 | DRV5055A3QDBZR | 0.0 | -7.0 | 0 | top
C_HB2 | GRM188R71C104KA01D | 3.5 | -7.0 | 0 | top
U_MUX_B | TMUX1208PWR | 0.0 | -22.0 | 0 | top
C_MUX_B | GRM188R71C104KA01D | 5.0 | -21.0 | 0 | top
TP_W_MUXB | PCB_PAD_1.2MM | 0.0 | -27.0 | 0 | top
TP_W_GND_B | PCB_PAD_1.2MM | 3.0 | -27.0 | 0 | top
U_HC0 | DRV5055A3QDBZR | 17.0 | 27.0 | 0 | top
C_HC0 | GRM188R71C104KA01D | 20.5 | 27.0 | 0 | top
U_HC1 | DRV5055A3QDBZR | 17.0 | 10.0 | 0 | top
C_HC1 | GRM188R71C104KA01D | 20.5 | 10.0 | 0 | top
U_HC2 | DRV5055A3QDBZR | 17.0 | -7.0 | 0 | top
C_HC2 | GRM188R71C104KA01D | 20.5 | -7.0 | 0 | top
U_MUX_C | TMUX1208PWR | 18.0 | -22.0 | 0 | top
C_MUX_C | GRM188R71C104KA01D | 23.0 | -21.0 | 0 | top
TP_W_MUXC | PCB_PAD_1.2MM | 18.0 | -27.0 | 0 | top
TP_W_GND_C | PCB_PAD_1.2MM | 21.0 | -27.0 | 0 | top
J_WING | BM14B-GHS-TBT(LF)(SN) | 0.0 | -33.0 | 0 | top
TP_H_CTR_RAW | PCB_PAD_1.2MM | -3.5 | 10.0 | 0 | top
TP_H_N_RAW | PCB_PAD_1.2MM | -3.5 | 27.0 | 0 | top
TP_H_DIAG_RAW | PCB_PAD_1.2MM | -20.5 | 27.0 | 0 | top
TP_W_H5V | PCB_PAD_1.2MM | -10 | 37.0 | 0 | top
TP_W_GND | PCB_PAD_1.2MM | -6 | 37.0 | 0 | top
TP_W_A0 | PCB_PAD_1.2MM | -2 | 37.0 | 0 | top
TP_W_A1 | PCB_PAD_1.2MM | 2 | 37.0 | 0 | top
TP_W_A2 | PCB_PAD_1.2MM | 6 | 37.0 | 0 | top
TP_W_EN | PCB_PAD_1.2MM | 10 | 37.0 | 0 | top
