ihsinoky/he-piantor-42/hardware/jitx/wing/generated/representative21-17mm/placements.csv

reference | mpn | x_mm | y_mm | rotation_ccw_deg | side
U_HA0 | DRV5055A3QDBZR | -46.75 | 36.625 | 0 | top
C_HA0 | GRM188R71C104KA01D | -43.25 | 36.625 | 0 | top
U_HA1 | DRV5055A3QDBZR | 4.25 | 40.875 | 0 | top
C_HA1 | GRM188R71C104KA01D | 7.75 | 40.875 | 0 | top
U_HA2 | DRV5055A3QDBZR | -46.75 | 19.625 | 0 | top
C_HA2 | GRM188R71C104KA01D | -43.25 | 19.625 | 0 | top
U_HA3 | DRV5055A3QDBZR | 4.25 | 23.875 | 0 | top
C_HA3 | GRM188R71C104KA01D | 7.75 | 23.875 | 0 | top
U_HA4 | DRV5055A3QDBZR | -46.75 | 2.625 | 0 | top
C_HA4 | GRM188R71C104KA01D | -43.25 | 2.625 | 0 | top
U_HA5 | DRV5055A3QDBZR | 4.25 | 6.875 | 0 | top
C_HA5 | GRM188R71C104KA01D | 7.75 | 6.875 | 0 | top
U_HA6 | DRV5055A3QDBZR | 12.75 | -14.375 | 0 | top
C_HA6 | GRM188R71C104KA01D | 16.25 | -14.375 | 0 | top
U_MUX_A | TMUX1208PWR | 0.0 | -42.375 | 0 | top
C_MUX_A | GRM188R71C104KA01D | 5.0 | -41.375 | 0 | top
TP_W_MUXA | PCB_PAD_1.2MM | 0.0 | -47.375 | 0 | top
TP_W_GND_A | PCB_PAD_1.2MM | 3.0 | -47.375 | 0 | top
U_HB0 | DRV5055A3QDBZR | -29.75 | 36.625 | 0 | top
C_HB0 | GRM188R71C104KA01D | -26.25 | 36.625 | 0 | top
U_HB1 | DRV5055A3QDBZR | 21.25 | 38.75 | 0 | top
C_HB1 | GRM188R71C104KA01D | 24.75 | 38.75 | 0 | top
U_HB2 | DRV5055A3QDBZR | -29.75 | 19.625 | 0 | top
C_HB2 | GRM188R71C104KA01D | -26.25 | 19.625 | 0 | top
U_HB3 | DRV5055A3QDBZR | 21.25 | 21.75 | 0 | top
C_HB3 | GRM188R71C104KA01D | 24.75 | 21.75 | 0 | top
U_HB4 | DRV5055A3QDBZR | -29.75 | 2.625 | 0 | top
C_HB4 | GRM188R71C104KA01D | -26.25 | 2.625 | 0 | top
U_HB5 | DRV5055A3QDBZR | 21.25 | 4.75 | 0 | top
C_HB5 | GRM188R71C104KA01D | 24.75 | 4.75 | 0 | top
U_HB6 | DRV5055A3QDBZR | 29.75 | -18.625 | 0 | top
C_HB6 | GRM188R71C104KA01D | 33.25 | -18.625 | 0 | top
U_MUX_B | TMUX1208PWR | 14.0 | -42.375 | 0 | top
C_MUX_B | GRM188R71C104KA01D | 19.0 | -41.375 | 0 | top
TP_W_MUXB | PCB_PAD_1.2MM | 14.0 | -47.375 | 0 | top
TP_W_GND_B | PCB_PAD_1.2MM | 17.0 | -47.375 | 0 | top
U_HC0 | DRV5055A3QDBZR | -12.75 | 38.75 | 0 | top
C_HC0 | GRM188R71C104KA01D | -9.25 | 38.75 | 0 | top
U_HC1 | DRV5055A3QDBZR | 38.25 | 36.625 | 0 | top
C_HC1 | GRM188R71C104KA01D | 41.75 | 36.625 | 0 | top
U_HC2 | DRV5055A3QDBZR | -12.75 | 21.75 | 0 | top
C_HC2 | GRM188R71C104KA01D | -9.25 | 21.75 | 0 | top
U_HC3 | DRV5055A3QDBZR | 38.25 | 19.625 | 0 | top
C_HC3 | GRM188R71C104KA01D | 41.75 | 19.625 | 0 | top
U_HC4 | DRV5055A3QDBZR | -12.75 | 4.75 | 0 | top
C_HC4 | GRM188R71C104KA01D | -9.25 | 4.75 | 0 | top
U_HC5 | DRV5055A3QDBZR | 38.25 | 2.625 | 0 | top
C_HC5 | GRM188R71C104KA01D | 41.75 | 2.625 | 0 | top
U_HC6 | DRV5055A3QDBZR | 46.75 | -22.875 | 0 | top
C_HC6 | GRM188R71C104KA01D | 50.25 | -22.875 | 0 | top
U_MUX_C | TMUX1208PWR | 28.0 | -42.375 | 0 | top
C_MUX_C | GRM188R71C104KA01D | 33.0 | -41.375 | 0 | top
TP_W_MUXC | PCB_PAD_1.2MM | 28.0 | -47.375 | 0 | top
TP_W_GND_C | PCB_PAD_1.2MM | 31.0 | -47.375 | 0 | top
J_WING | BM14B-GHS-TBT(LF)(SN) | -40.25 | -42.375 | 0 | top
TP_H_CTR_RAW | PCB_PAD_1.2MM | -50.25 | 19.625 | 0 | top
TP_H_N_RAW | PCB_PAD_1.2MM | -33.25 | 19.625 | 0 | top
TP_H_DIAG_RAW | PCB_PAD_1.2MM | -16.25 | 38.75 | 0 | top
TP_W_H5V | PCB_PAD_1.2MM | -10 | 49.375 | 0 | top
TP_W_GND | PCB_PAD_1.2MM | -6 | 49.375 | 0 | top
TP_W_A0 | PCB_PAD_1.2MM | -2 | 49.375 | 0 | top
TP_W_A1 | PCB_PAD_1.2MM | 2 | 49.375 | 0 | top
TP_W_A2 | PCB_PAD_1.2MM | 6 | 49.375 | 0 | top
TP_W_EN | PCB_PAD_1.2MM | 10 | 49.375 | 0 | top
