ihsinoky/he-piantor-42/hardware/kicad/qualification/issue-147-wing-order-prep/16mm/preview-review/wing-16mm-F_Mask.png

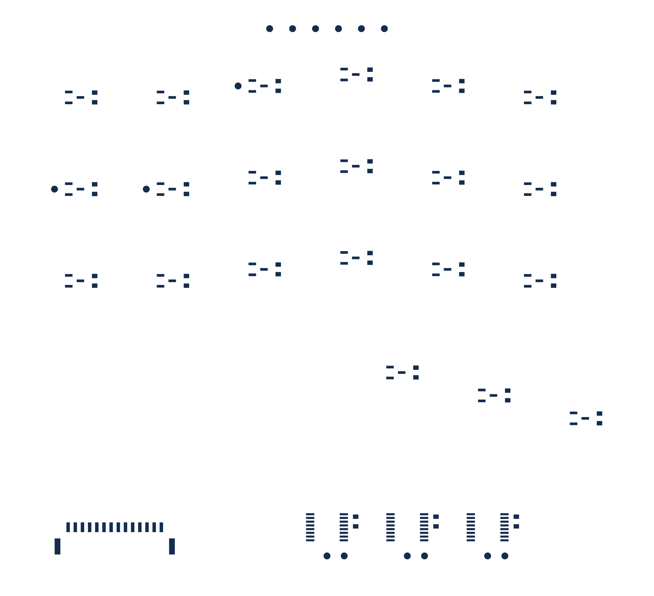
hardware/kicad/qualification/issue-147-wing-order-prep/16mm/preview-review/wing-16mm-F_Mask.png
