ihsinoky/he-piantor-42/hardware/case/issue-228-final/17mm/assembly.step

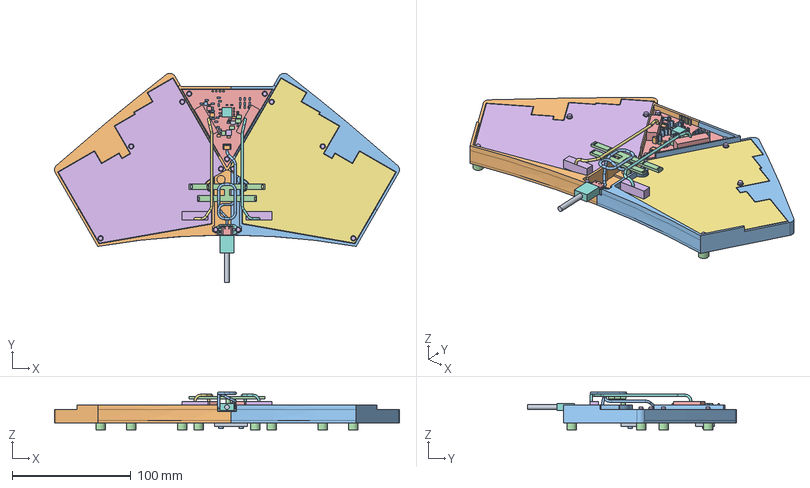
[picture p5: CAD file, 2026-11-12]
hardware/case/issue-228-final/17mm/assembly.step
291.0 x 176.7 x 32.0 mm
splice-1
splice-2
cable-rack
main
wing_left
wing_right
Fly-official-00
Fly-official-01
Fly-official-02
Fly-official-03
Fly-official-04
Fly-official-05
Fly-official-06
Fly-official-07
Fly-official-08
Fly-official-09
Fly-official-10
Fly-official-11
Fly-official-12
Fly-official-13
Fly-official-14
Fly-official-15
Fly-official-16
Fly-official-17
Fly-official-18
Fly-official-19
Fly-official-20
Fly-official-21
Fly-official-22
Fly-official-23
Fly-official-24
Fly-official-25
Fly-official-26
Fly-official-27
Fly-official-28
Fly-official-29
Fly-official-30
Fly-official-31
Fly-official-32
Fly-official-33
Fly-official-34
Fly-official-35
Fly-official-36
Fly-official-37
Fly-official-38
Fly-official-39
Fly-official-40
Fly-official-41
Fly-official-42
Fly-official-47 x 2
Fly-official-48 x 2
Fly-official-49 x 2
Fly-official-50 x 2
Fly-official-51
Fly-official-52
Fly-official-53
Fly-official-54
Fly-official-55
Fly-official-56
Fly-official-57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
