ihsinoky/he-piantor-42/hardware/case/issue-198-final/16mm/tray-right.stl

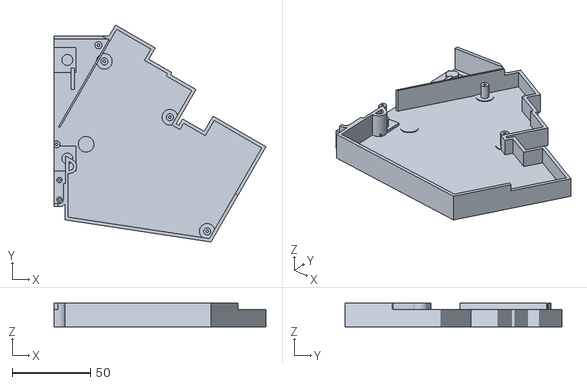
[picture p6: CAD file, 2026-11-07]
hardware/case/issue-198-final/16mm/tray-right.stl
135.5 x 138.7 x 15.2
