ihsinoky/he-piantor-42/hardware/case/issue-198-stage1/16mm/tray.stl

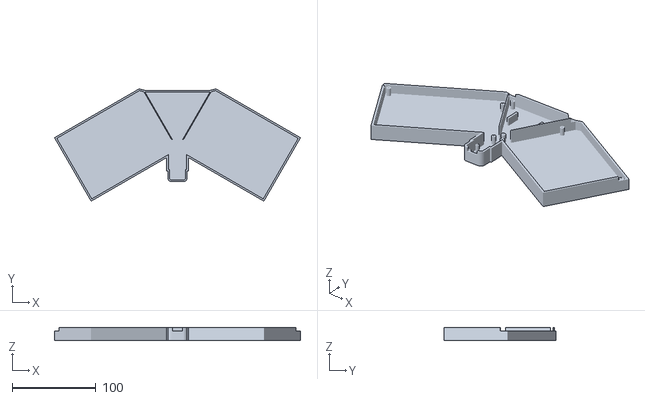
[picture p7: CAD file, 2026-11-07]
hardware/case/issue-198-stage1/16mm/tray.stl
294.5 x 134.5 x 15.2
