ihsinoky/he-piantor-42/hardware/case/issue-198-stage1/17mm/tray.step

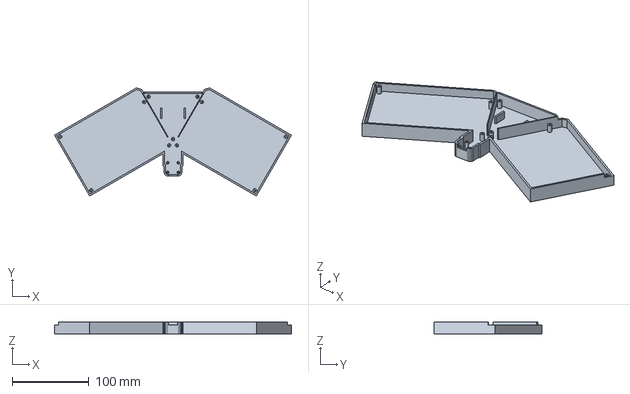
[picture p8: CAD file, 2026-11-07]
hardware/case/issue-198-stage1/17mm/tray.step
308.9 x 141.0 x 15.2 mm
