ihsinoky/he-piantor-42/hardware/case/issue-198-stage2/17mm/harness.step

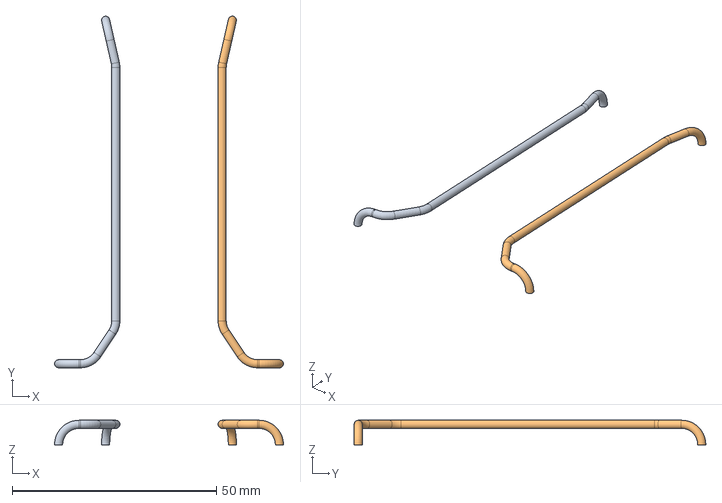
[picture p9: CAD file, 2026-11-07]
hardware/case/issue-198-stage2/17mm/harness.step
56.0 x 86.0 x 6.00 mm
GH-left
GH-right
