ihsinoky/he-piantor-42/hardware/case/issue-228-final/16mm/tray-left.step

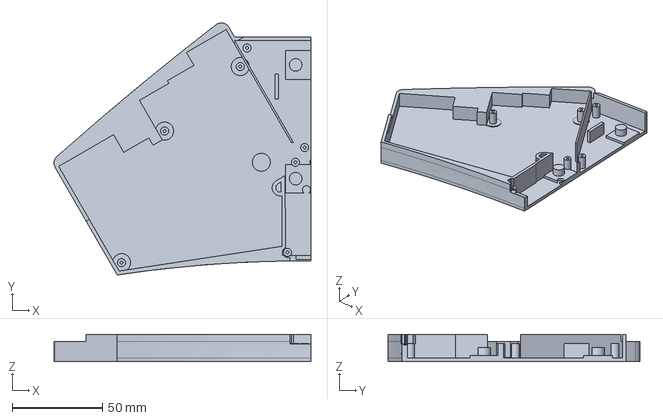
[picture p10: CAD file, 2026-11-12]
hardware/case/issue-228-final/16mm/tray-left.step
142.3 x 139.6 x 15.2 mm
