ihsinoky/he-piantor-42/hardware/case/issue-228-final/inputs/TheFly_DaughterBoard_V4.2.stp

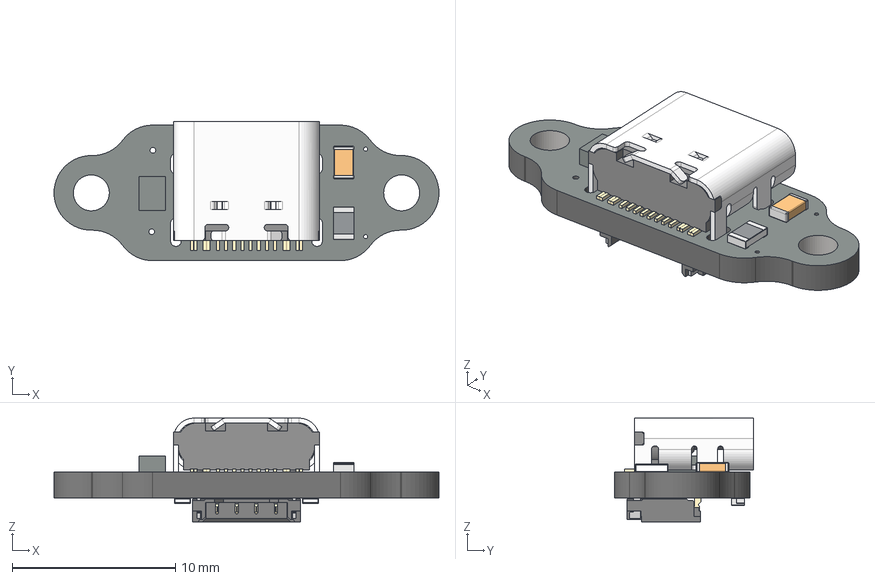
[picture p11: CAD file, 2026-11-12]
hardware/case/issue-228-final/inputs/TheFly_DaughterBoard_V4.2.stp
23.6 x 8.53 x 6.35 mm
Board
TYPE-C-31-M-12
ECMF024CMX8
M1201RS-04-BK
