ihsinoky/he-piantor-42/hardware/case/issue-230-mount-study/16mm-left/plate-study.stl

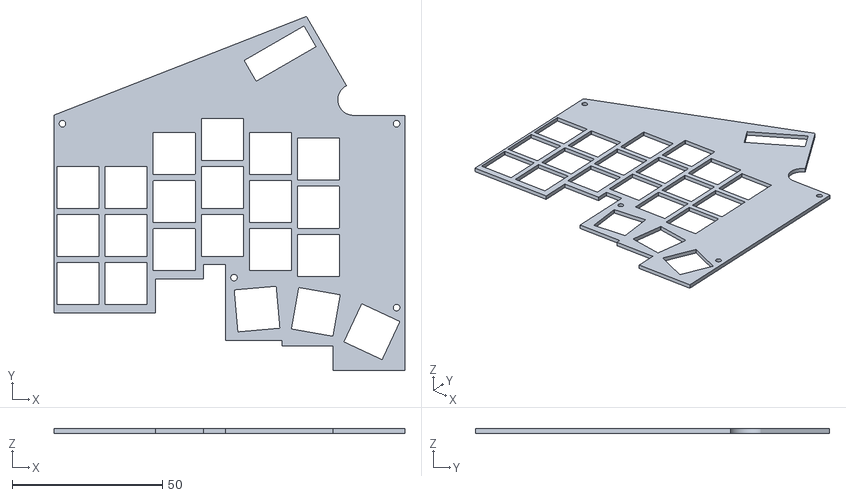
[picture p12: CAD file, 2026-11-13]
hardware/case/issue-230-mount-study/16mm-left/plate-study.stl
116.8 x 117.9 x 1.50
