ihsinoky/he-piantor-42/hardware/case/issue-230-mount-study/support-shaft.stl

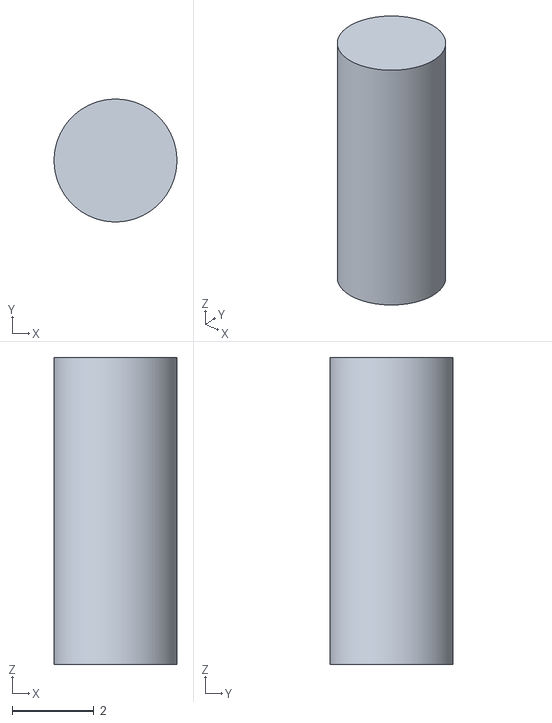
[picture p13: CAD file, 2026-11-13]
hardware/case/issue-230-mount-study/support-shaft.stl
3.00 x 3.00 x 7.50
