ihsinoky/he-piantor-42/hardware/case/issue-232-final/16mm/plate-package/plate-right.step

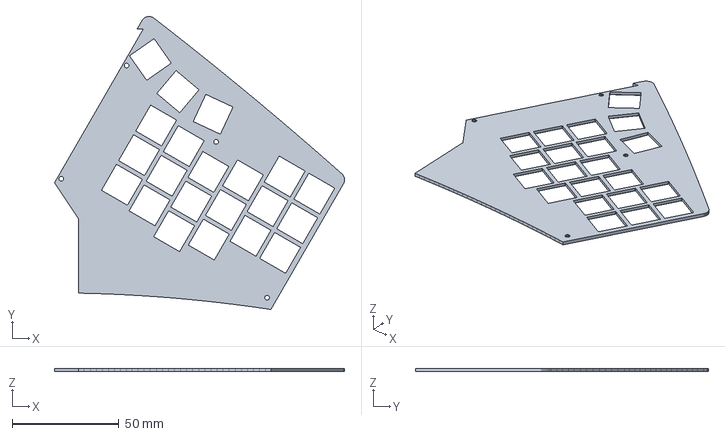
[picture p14: CAD file, 2026-11-13]
hardware/case/issue-232-final/16mm/plate-package/plate-right.step
135.7 x 137.0 x 1.50 mm
