ihsinoky/he-piantor-42/hardware/case/issue-232-final/16mm/tray-left.step

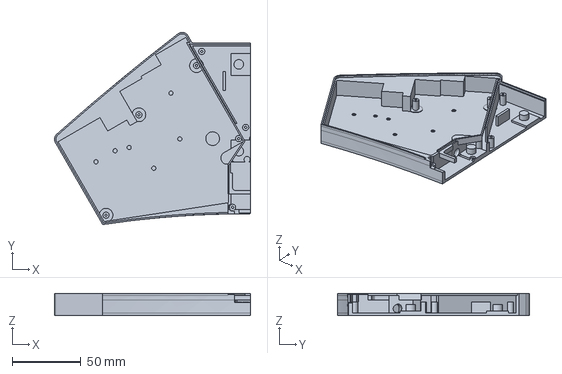
[picture p15: CAD file, 2026-11-13]
hardware/case/issue-232-final/16mm/tray-left.step
142.3 x 139.6 x 16.2 mm
