ihsinoky/he-piantor-42/hardware/case/issue-232-final/17mm/plate-package/plate-right.step

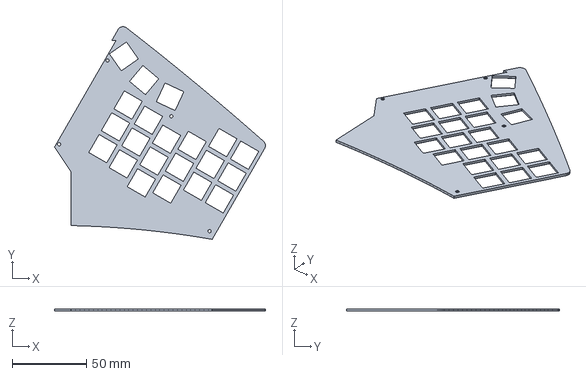
[picture p16: CAD file, 2026-11-13]
hardware/case/issue-232-final/17mm/plate-package/plate-right.step
142.4 x 143.5 x 1.50 mm
