ihsinoky/he-piantor-42/hardware/case/issue-232-final/17mm/splice-1.step

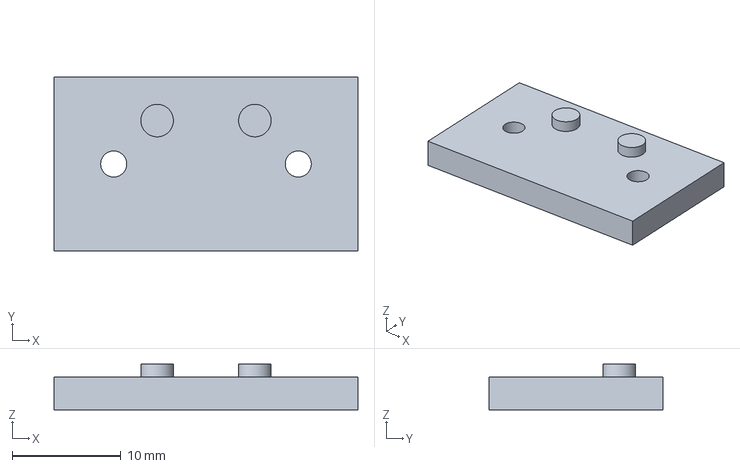
[picture p17: CAD file, 2026-11-13]
hardware/case/issue-232-final/17mm/splice-1.step
28.0 x 16.0 x 4.20 mm
