ihsinoky/he-piantor-42/hardware/case/issue-232-final/support-post.step

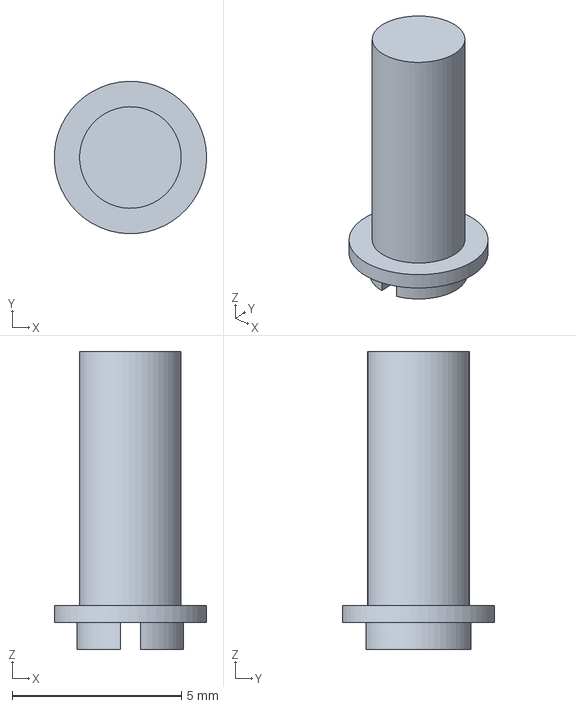
[picture p18: CAD file, 2026-11-13]
hardware/case/issue-232-final/support-post.step
4.50 x 4.50 x 8.80 mm
