ihsinoky/he-piantor-42/hardware/case/issue-240-bay-cover/16mm/wing-right-160mm.step

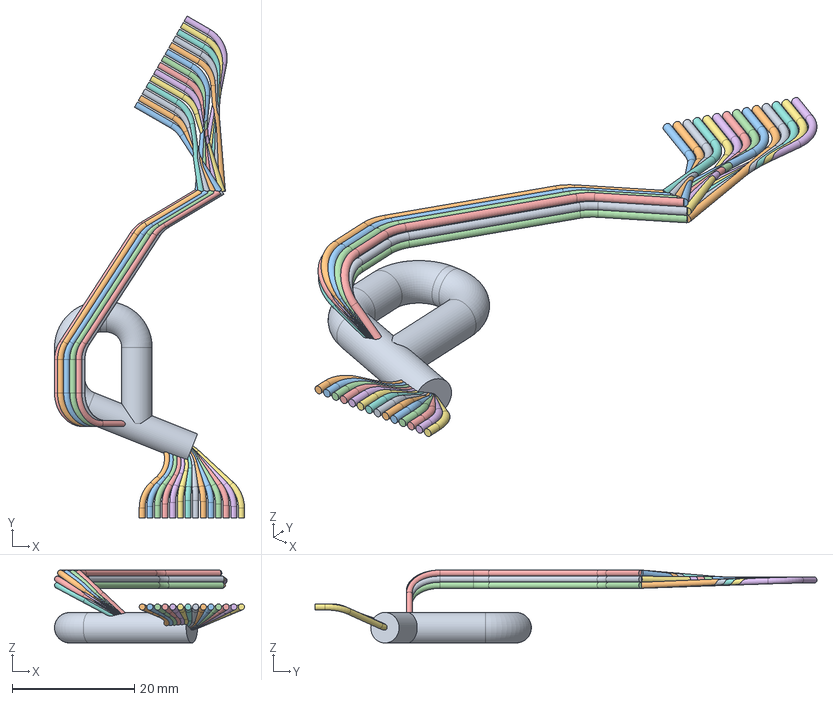
[picture p19: CAD file, 2026-11-13]
hardware/case/issue-240-bay-cover/16mm/wing-right-160mm.step
31.1 x 82.2 x 11.9 mm
