ihsinoky/he-piantor-42/hardware/case/issue-240-bay-cover/17mm/cover-trial.step

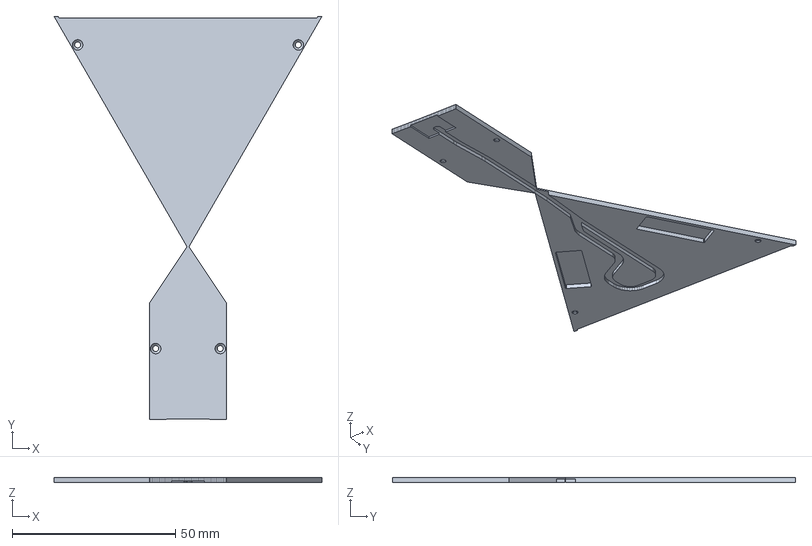
[picture p20: CAD file, 2026-11-13]
hardware/case/issue-240-bay-cover/17mm/cover-trial.step
82.0 x 123.4 x 1.50 mm
