ihsinoky/he-piantor-42/hardware/case/issue-242-bay-final/16mm/fly-170mm.step

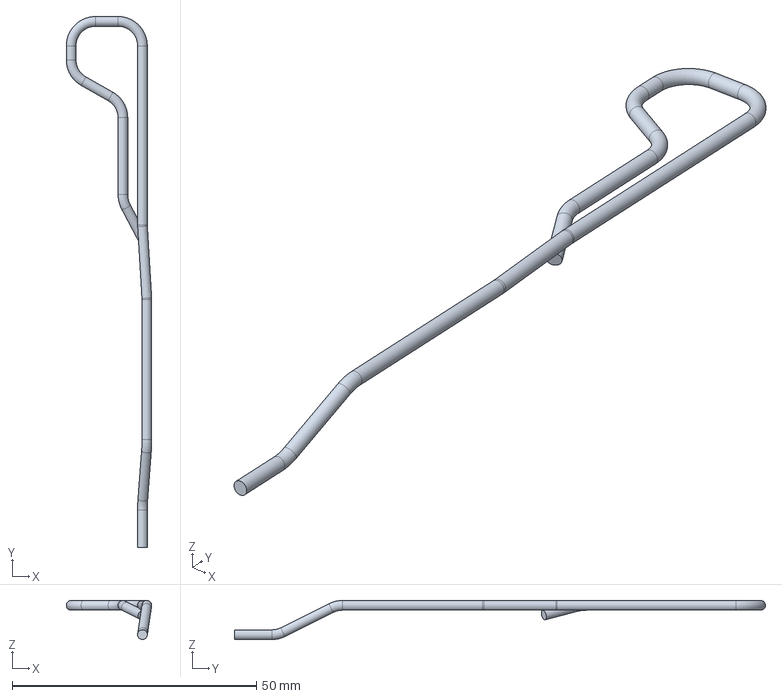
[picture p21: CAD file, 2026-11-13]
hardware/case/issue-242-bay-final/16mm/fly-170mm.step
17.5 x 108.7 x 8.00 mm
