ihsinoky/he-piantor-42/hardware/case/issue-244-height-search/delta-6/17mm/wing-right.step

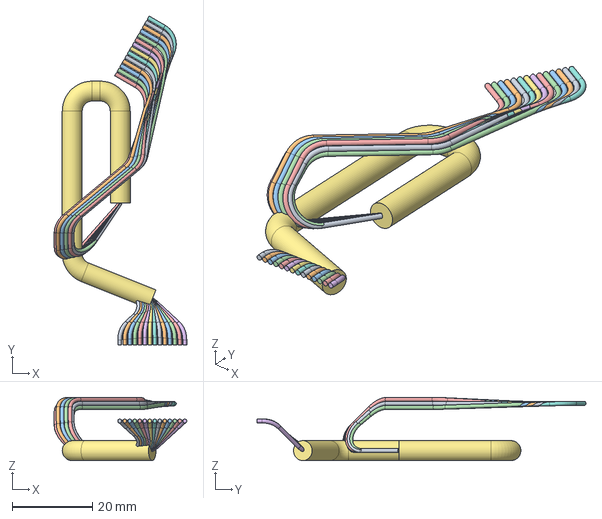
[picture p22: CAD file, 2026-11-13]
hardware/case/issue-244-height-search/delta-6/17mm/wing-right.step
33.1 x 82.2 x 15.8 mm
Wing-right-lower
