ihsinoky/he-piantor-42/hardware/case/issue-246-delta6-tuning/packed/delta-6/17mm/cover-study.step

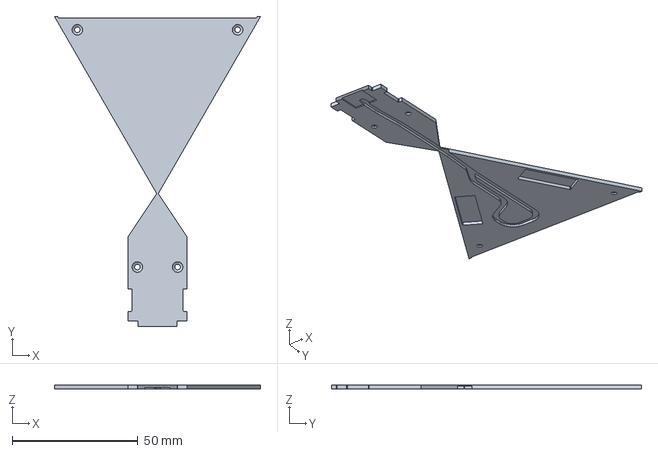
[picture p23: CAD file, 2026-11-13]
hardware/case/issue-246-delta6-tuning/packed/delta-6/17mm/cover-study.step
82.0 x 123.4 x 1.50 mm
