ihsinoky/he-piantor-42/hardware/kicad/qualification/issue-233-wing-single-sided/case/17mm/trial-Fly-short.step

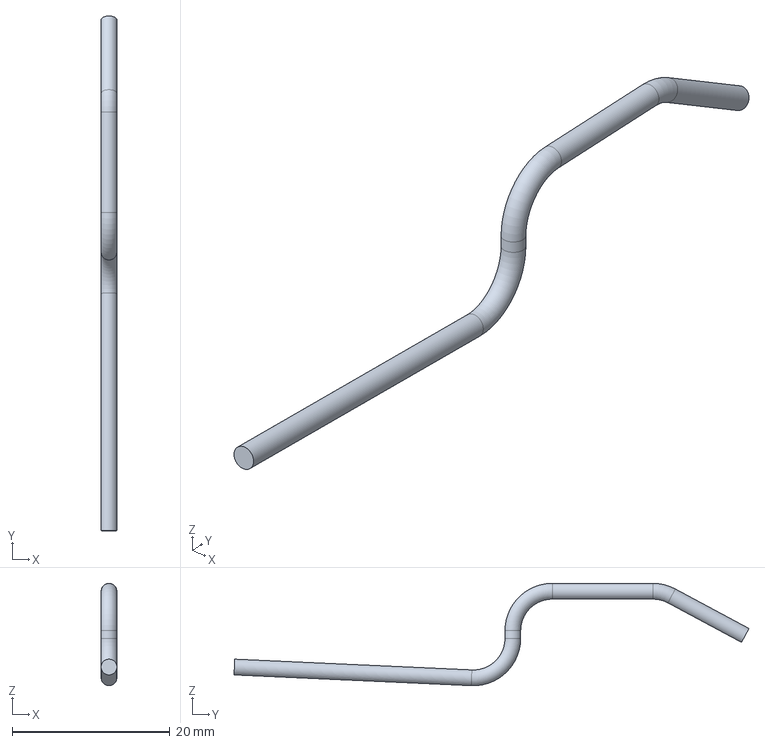
[picture p24: CAD file, 2026-11-13]
hardware/kicad/qualification/issue-233-wing-single-sided/case/17mm/trial-Fly-short.step
2.00 x 65.2 x 13.0 mm
