ihsinoky/he-piantor-42/hardware/kicad/qualification/issue-235-wing-round2/case/16mm/trial-GH-left.step

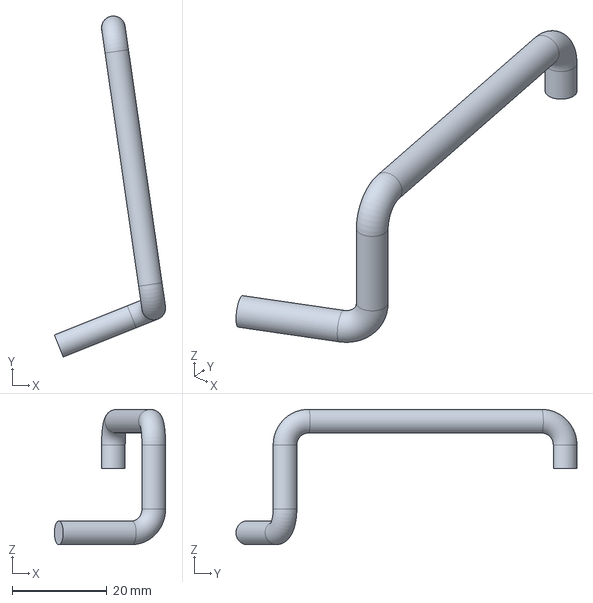
[picture p25: CAD file, 2026-11-13]
hardware/kicad/qualification/issue-235-wing-round2/case/16mm/trial-GH-left.step
23.4 x 71.8 x 28.5 mm
