ihsinoky/he-piantor-42/hardware/kicad/qualification/issue-235-wing-round2/case/17mm/diagnostic-overlay.step

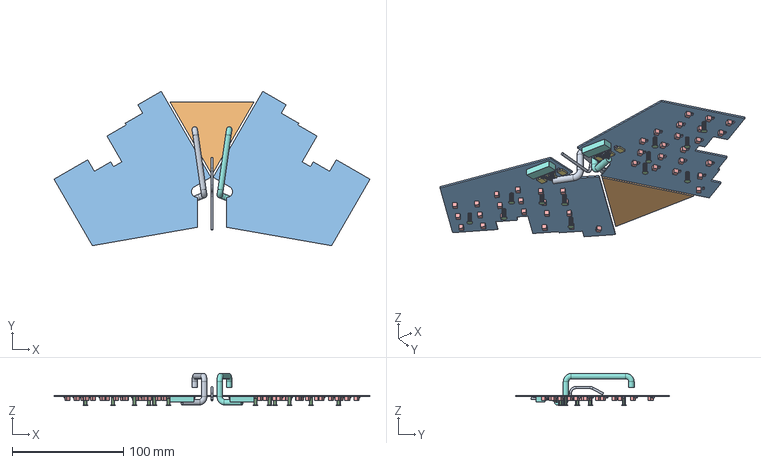
[picture p26: CAD file, 2026-11-13]
hardware/kicad/qualification/issue-235-wing-round2/case/17mm/diagnostic-overlay.step
284.5 x 139.0 x 29.0 mm
