ihsinoky/he-piantor-42/hardware/case/issue-198-final/16mm/storage-200mm.step

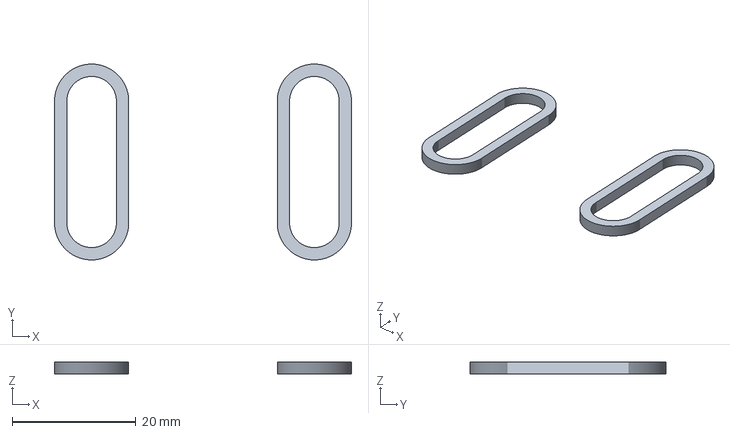
[picture p27: CAD file, 2026-11-07]
hardware/case/issue-198-final/16mm/storage-200mm.step
48.0 x 31.7 x 2.00 mm
