ihsinoky/he-piantor-42/hardware/case/issue-228-final/17mm/cable-rack.step

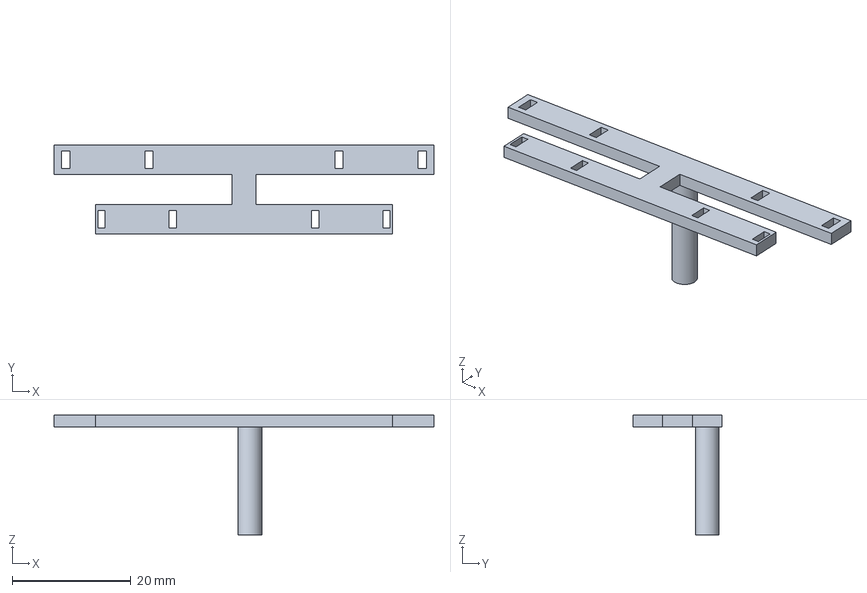
[picture p28: CAD file, 2026-11-12]
hardware/case/issue-228-final/17mm/cable-rack.step
64.0 x 15.0 x 20.2 mm
