ihsinoky/he-piantor-42/hardware/case/issue-232-final/16mm/harness-left-160mm.step

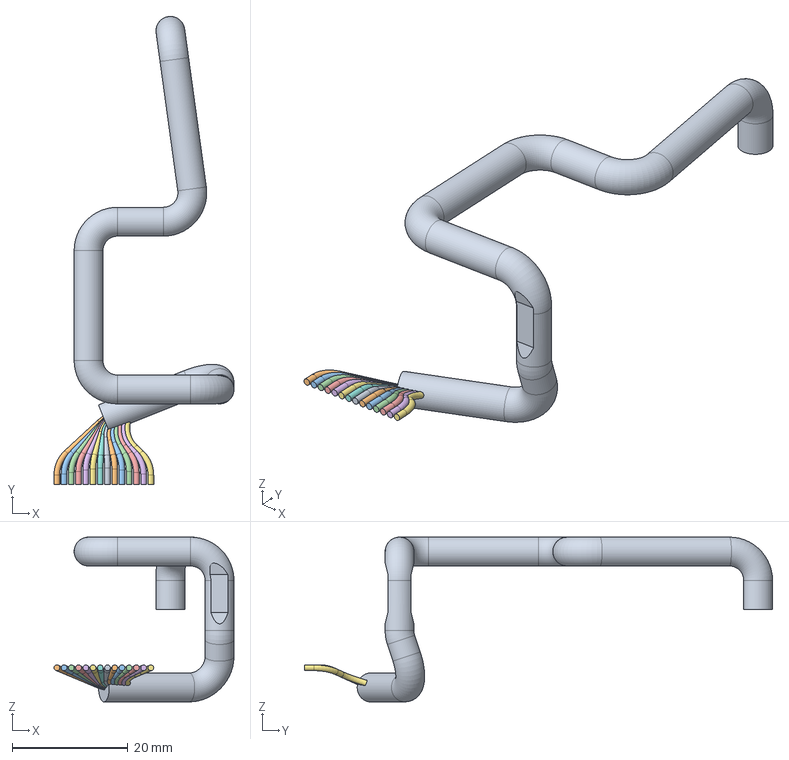
[picture p29: CAD file, 2026-11-13]
hardware/case/issue-232-final/16mm/harness-left-160mm.step
31.1 x 80.9 x 28.5 mm
