ihsinoky/he-piantor-42/hardware/case/issue-232-final/17mm/tray-right.step

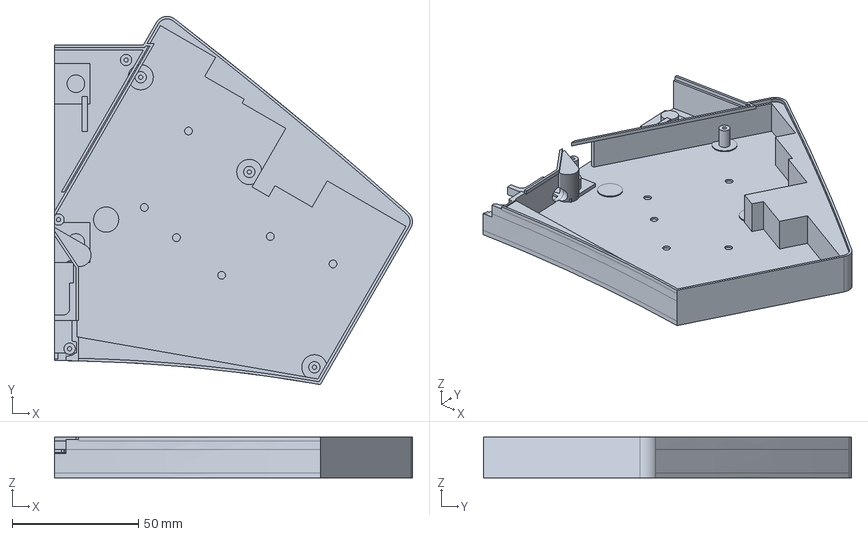
[picture p30: CAD file, 2026-11-13]
hardware/case/issue-232-final/17mm/tray-right.step
142.0 x 146.1 x 16.2 mm
