ihsinoky/he-piantor-42/hardware/case/issue-242-bay-final/16mm/wing-right.step

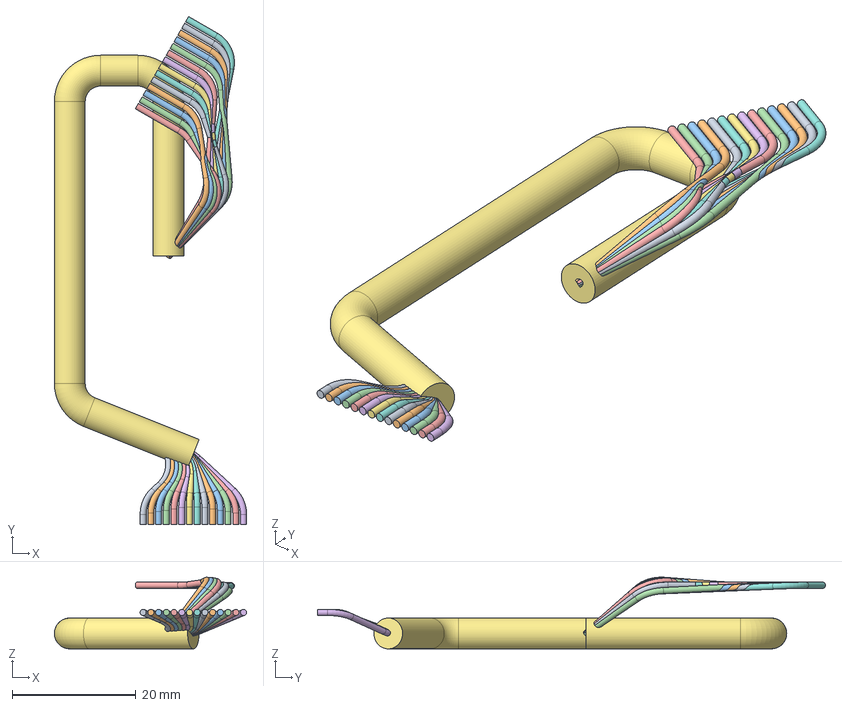
[picture p31: CAD file, 2026-11-13]
hardware/case/issue-242-bay-final/16mm/wing-right.step
31.1 x 82.2 x 11.6 mm
Wing-right-lower
