ihsinoky/he-piantor-42/hardware/case/issue-244-height-search/delta-6/17mm/tray-left-study.step

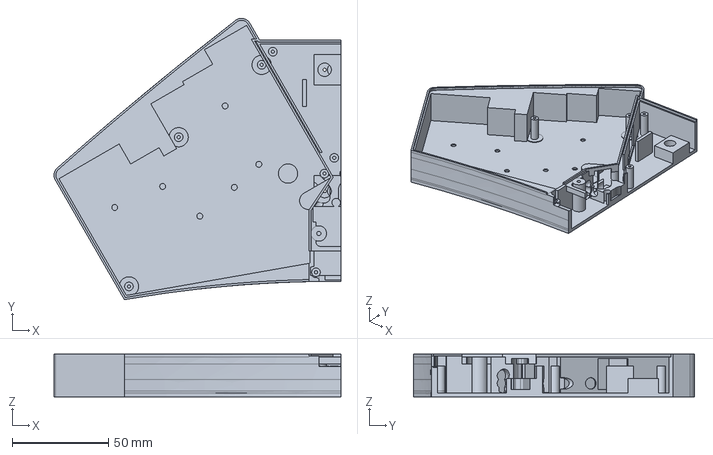
[picture p32: CAD file, 2026-11-13]
hardware/case/issue-244-height-search/delta-6/17mm/tray-left-study.step
149.0 x 146.1 x 22.2 mm
