ihsinoky/he-piantor-42/hardware/kicad/qualification/issue-233-wing-single-sided/case/16mm/tray-right-channel-candidate.step

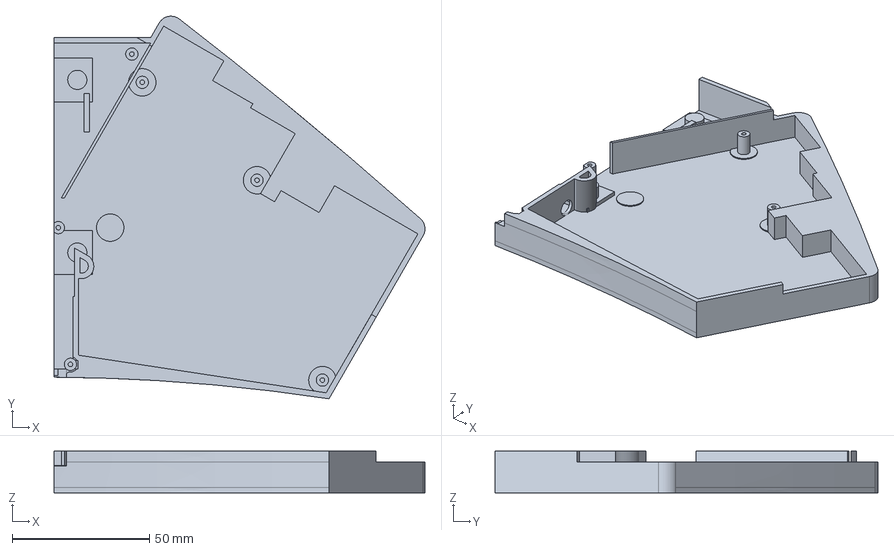
[picture p33: CAD file, 2026-11-13]
hardware/kicad/qualification/issue-233-wing-single-sided/case/16mm/tray-right-channel-candidate.step
135.3 x 139.6 x 15.2 mm
