ihsinoky/he-piantor-42/hardware/kicad/qualification/issue-233-wing-single-sided/case/17mm/actual-GH-exit-left.step

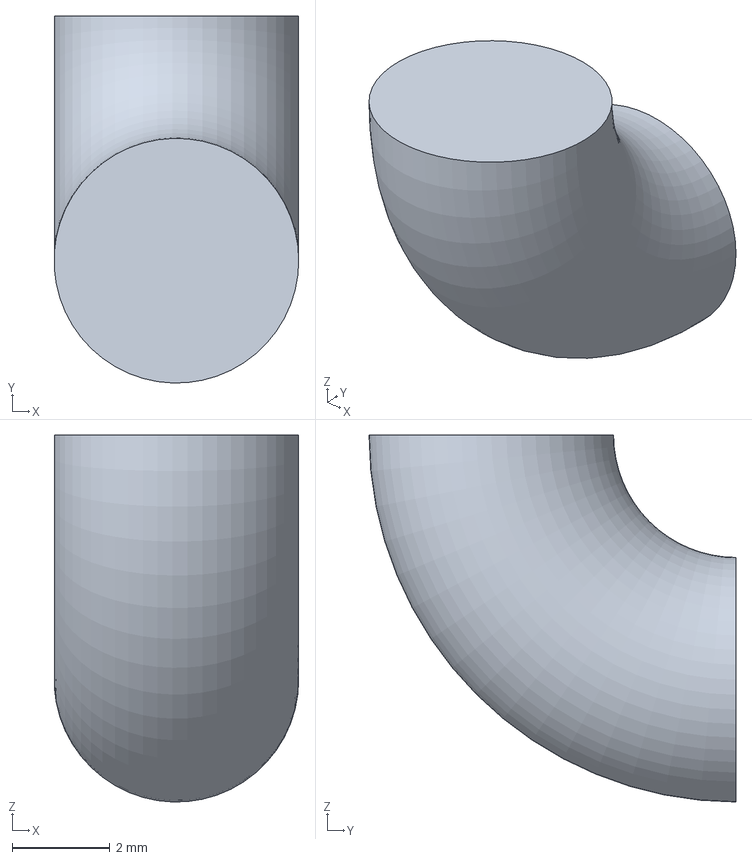
[picture p34: CAD file, 2026-11-13]
hardware/kicad/qualification/issue-233-wing-single-sided/case/17mm/actual-GH-exit-left.step
5.00 x 7.50 x 7.50 mm
