ihsinoky/he-piantor-42/hardware/kicad/qualification/issue-235-wing-round2/case/17mm/tray-left-channel-candidate.step

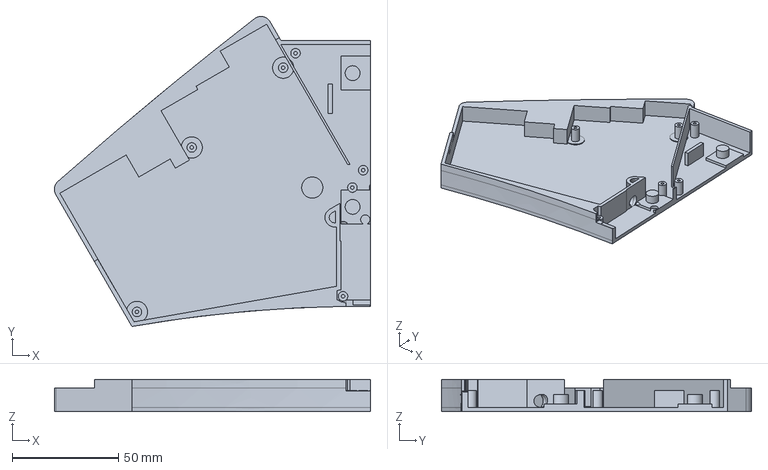
[picture p35: CAD file, 2026-11-13]
hardware/kicad/qualification/issue-235-wing-round2/case/17mm/tray-left-channel-candidate.step
149.0 x 146.1 x 15.2 mm
