ihsinoky/he-piantor-42/hardware/case/issue-244-height-search/delta-10/17mm/wing-left.step

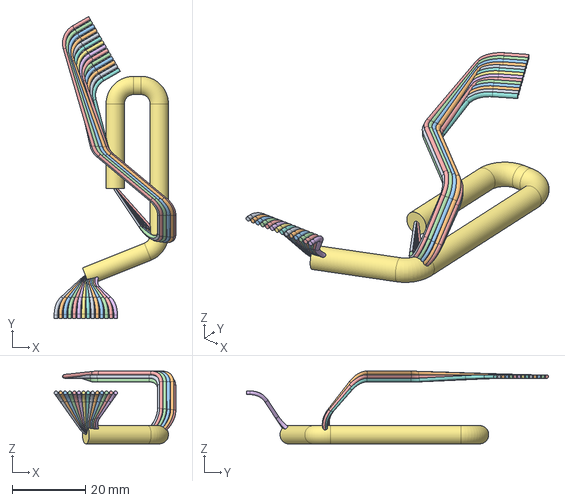
[picture p37: CAD file, 2026-11-13]
hardware/case/issue-244-height-search/delta-10/17mm/wing-left.step
33.1 x 82.2 x 19.8 mm
Wing-left-lower
