ihsinoky/he-piantor-42/hardware/case/issue-246-delta6-tuning/packed/delta-6/17mm/tray-right-study.step

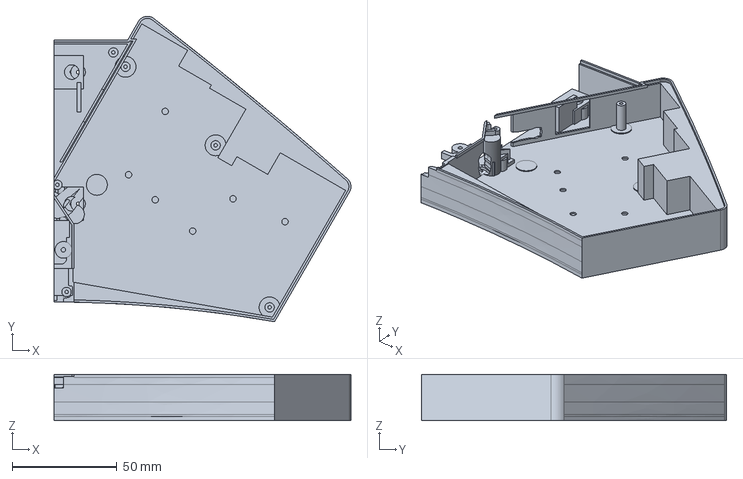
[picture p38: CAD file, 2026-11-13]
hardware/case/issue-246-delta6-tuning/packed/delta-6/17mm/tray-right-study.step
142.0 x 146.1 x 22.2 mm
