ihsinoky/he-piantor-42/hardware/case/issue-228-final/17mm/tray-right.step

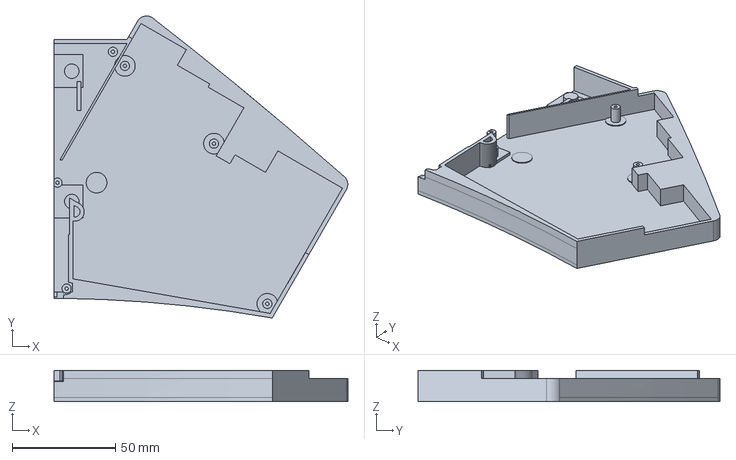
[picture p40: CAD file, 2026-11-12]
hardware/case/issue-228-final/17mm/tray-right.step
142.0 x 146.1 x 15.2 mm
