ihsinoky/he-piantor-42/hardware/case/issue-232-final/16mm/tray-right.step

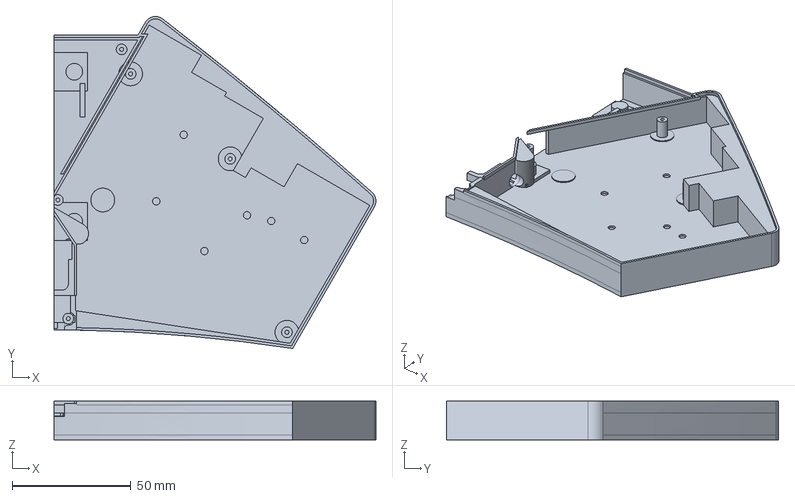
[picture p41: CAD file, 2026-11-13]
hardware/case/issue-232-final/16mm/tray-right.step
135.3 x 139.6 x 16.2 mm
