ihsinoky/he-piantor-42/hardware/case/issue-246-delta6-tuning/packed/delta-6/17mm/wing-right.step

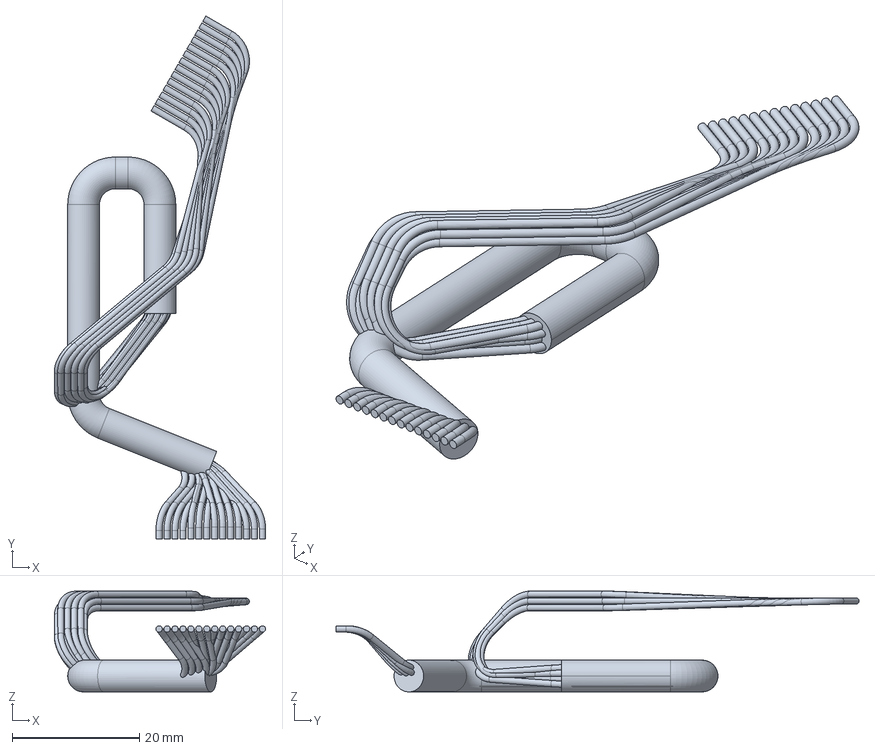
[picture p42: CAD file, 2026-11-13]
hardware/case/issue-246-delta6-tuning/packed/delta-6/17mm/wing-right.step
33.2 x 82.2 x 15.8 mm
