ihsinoky/he-piantor-42/hardware/kicad/qualification/issue-233-wing-single-sided/case/17mm/trial-GH-right.step

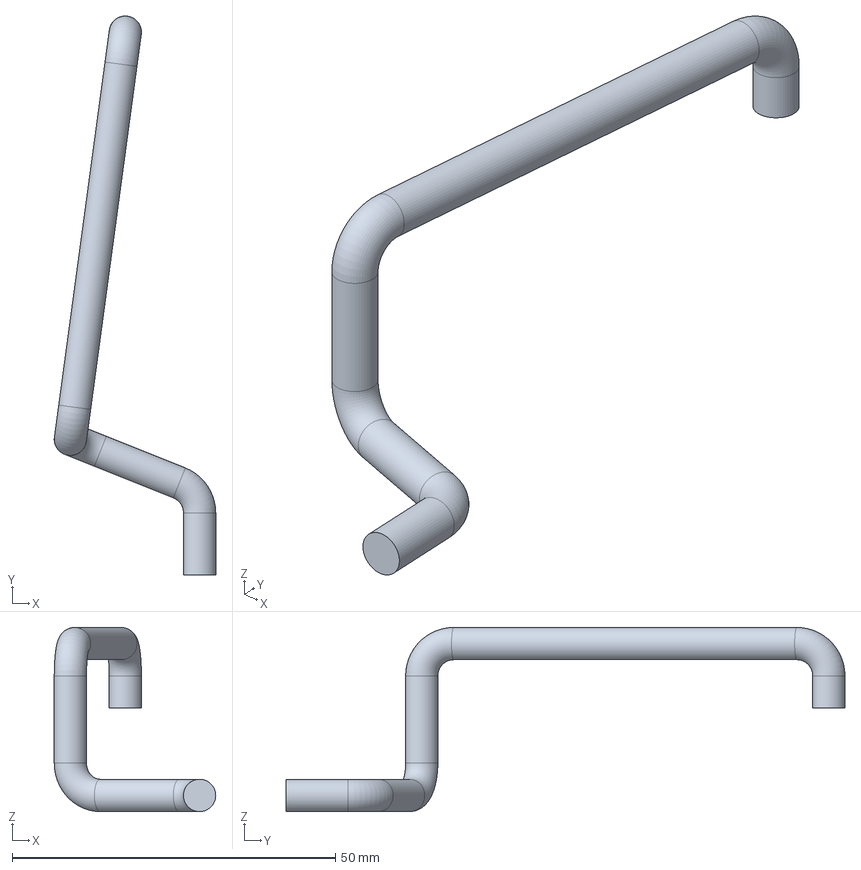
[picture p43: CAD file, 2026-11-13]
hardware/kicad/qualification/issue-233-wing-single-sided/case/17mm/trial-GH-right.step
25.0 x 86.5 x 28.5 mm
