ihsinoky/he-piantor-42/hardware/kicad/qualification/issue-235-wing-round2/case/16mm/diagnostic-overlay.step

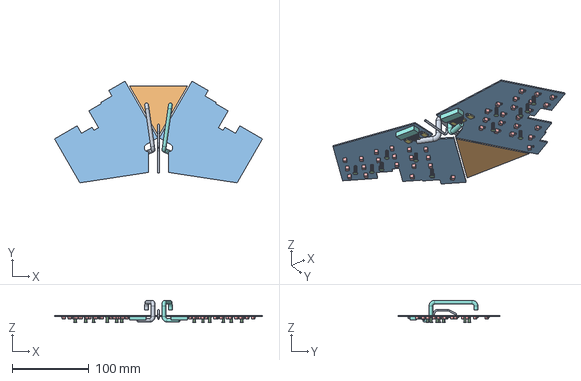
[picture p44: CAD file, 2026-11-13]
hardware/kicad/qualification/issue-235-wing-round2/case/16mm/diagnostic-overlay.step
271.1 x 132.5 x 29.0 mm
