ihsinoky/he-piantor-42/hardware/case/issue-232-final/17mm/fly-harness-170mm.step

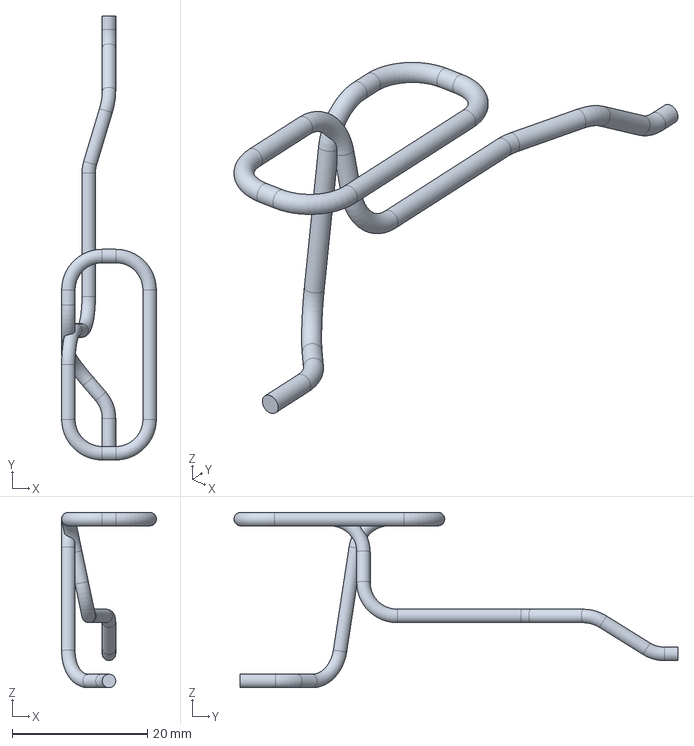
[picture p45: CAD file, 2026-11-13]
hardware/case/issue-232-final/17mm/fly-harness-170mm.step
14.0 x 65.6 x 25.9 mm
