ihsinoky/he-piantor-42/hardware/case/issue-228-final/17mm/fly-harness-and-usb.step

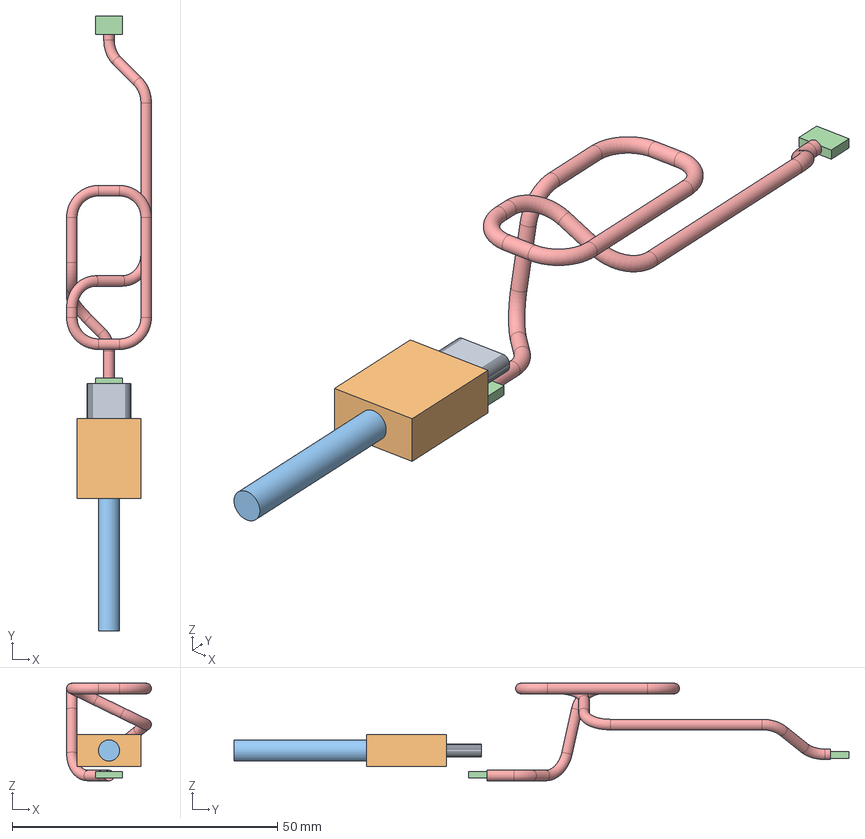
[picture p46: CAD file, 2026-11-12]
hardware/case/issue-228-final/17mm/fly-harness-and-usb.step
16.0 x 115.9 x 18.4 mm
USB-reference-shell
USB-reference-overmold
USB-reference-cable-exit
EZmate-Fly-plug
EZmate-Main-plug
EZmate-170mm-route
