ihsinoky/he-piantor-42/(list of files, cad)

Other CAD files:
hardware/case/issue-244-height-search/delta-10/17mm/assembly-with-cover-REJECTED.step
hardware/case/issue-242-bay-final/17mm/assembly-with-cover-REJECTED.step
hardware/case/issue-246-delta6-tuning/packed/delta-6/17mm/assembly-with-cover.step
hardware/case/issue-242-bay-final/16mm/assembly-with-cover-REJECTED.step
hardware/case/issue-230-mount-study/16mm-right/plate.dxf
hardware/case/issue-230-mount-study/17mm-left/plate.dxf
hardware/case/issue-228-final/16mm/splice-2.step
hardware/case/issue-230-mount-study/16mm-right/plate-study.stl
hardware/case/issue-232-final/17mm/plate-package/plate-left.step
hardware/case/issue-240-bay-cover/16mm/fly-170mm.step
hardware/case/issue-240-bay-cover/17mm/fly-170mm.step
hardware/case/issue-244-height-search/delta-10/17mm/cover-study.step
hardware/kicad/qualification/issue-235-wing-round2/case/16mm/tray-left-channel-candidate.step
hardware/case/issue-198-final/16mm/cable-rack.step
hardware/case/issue-198-final/17mm/splice-1.stl
hardware/case/issue-228-final/16mm/tray-right.stl
hardware/case/issue-228-final/17mm/splice-2.stl
hardware/case/issue-232-final/16mm/harness-right-160mm.step
hardware/case/issue-244-height-search/delta-6/17mm/fly-170mm.step
hardware/kicad/qualification/issue-233-wing-single-sided/case/17mm/tray-left-channel-candidate.step
hardware/kicad/qualification/issue-235-wing-round2/case/16mm/trial-GH-right.step
hardware/case/issue-198-final/16mm/tray-left.stl
hardware/case/issue-232-final/17mm/cable-rack.stl
hardware/case/issue-242-bay-final/16mm/wing-left.step
hardware/case/issue-228-final/17mm/splice-1.step
hardware/case/issue-232-final/16mm/splice-1.step
hardware/case/issue-242-bay-final/16mm/cover-study.step
hardware/case/issue-232-final/16mm/splice-2.step
hardware/case/issue-232-final/17mm/splice-2.step
hardware/case/issue-232-final/17mm/harness-left-160mm.step
hardware/case/issue-198-final/17mm/splice-2.stl
hardware/case/issue-198-final/17mm/tray-right.step
hardware/case/issue-198-final/17mm/tray-right.stl
hardware/case/issue-198-stage1/17mm/tray-left.stl
hardware/case/issue-198-stage2/16mm/cable-rack.step
hardware/case/issue-198-stage2/16mm/tray-right.stl
hardware/case/issue-198-stage2/17mm/tray-right.stl
hardware/case/issue-228-final/16mm/tray-left.stl
hardware/case/issue-228-final/17mm/tray-right.stl
hardware/case/issue-232-final/16mm/tray-right.stl
hardware/case/issue-232-final/17mm/tray-left.stl
hardware/case/issue-232-final/17mm/tray-right.stl
hardware/case/issue-232-final/support-post.stl
hardware/case/issue-242-bay-final/17mm/cover-study.step
hardware/case/issue-242-bay-final/17mm/tray-right-study.step
hardware/case/issue-242-bay-final/17mm/wing-right.step
hardware/kicad/qualification/issue-233-wing-single-sided/case/16mm/trial-GH-left.step
