ihsinoky/he-piantor-42/manufacturing/README.md

# Manufacturing

This directory will hold release-ready manufacturing packages.

Planned outputs:
- Gerber and drill files.
- JLCPCB BOM.
- JLCPCB CPL / placement data.
- PCB ordering notes.
- STEP and STL enclosure exports.
- 3D-print notes.
