ihsinoky/he-piantor-42/docs/issue-138-wing-manufacturing-review-prep.md

# Issue #138 — Wing 発注前製造レビュー準備

[Issue #138](https://github.com/ihsinoky/he-piantor-42/issues/138)、2026-11-05 UTC。
D-021 の representative21、16mm／17mm の留保2件を点検した。**Keyboard Design 加算は、公開説明の形状要因に対する自己点検では非該当。0.08mm 時の電流・発熱スクリーニングは両ピッチとも通過。ただし、電源／GND の抵抗と電流仕様の不確定性があり、「最悪ケースでも電気的に問題なし」と無条件には結論できない。** メーカーの料金判定、電源電圧・アナログ精度の確認は残る。

これは発注判断・製造承認・仕様採用ではない。既存PCB、設計ルール、D-021を変更せず、新規報告と証跡だけを追加した。発注、課金、ファイルアップロード、カート操作、merge は行っていない。

## 1. 対象と証跡の読み方

以下の `E/` は [`hardware/kicad/qualification/issue-138-wing-manufacturing-review-prep/`](../hardware/kicad/qualification/issue-138-wing-manufacturing-review-prep/)。指示書全文は [`E/instructions.md`](../hardware/kicad/qualification/issue-138-wing-manufacturing-review-prep/instructions.md)、取得したIssue本文は `E/issue138.json`。

出発点は [#133 の「未解消リスク」](issue-133-wing-cost-check.md)、同証跡の `geometry-evidence.json` と `capability-capture/capability-retrieval-records.json`。#133 は配線前入力の形状を測っていたため、今回は [#131](issue-131-wing-condition-search.md) の**合格した配線済み出力そのもの**を KiCad public reader で読み直し、線分のUUID・幅・座標・ネット・層をS式の直接読取りとも照合した。元の独立検査は両基板とも4指標0、幅監査通過。今回、配線やDRCを再実行して結果を書き換えてはいない。

| セル | 配線済み `out.kicad_pcb` の SHA256 |
| --- | --- |
| KRT-16-2L-0100 | `0c1a95ef893ead7c8ad8d28a7e807ff085a2d08e2e736197ebace7fd545192d5` |
| KRT-17-2L-0100 | `06d550ff5047a81449dca50dd013c199d2ae5ce1a61fe7ea279a24708da8513c` |

入力パス・hash・#133との比較は `E/board-read-provenance.json` と `E/starting-evidence-comparison.json`。外形とNPTH数は #133 の入力側証跡と一致する。全追加証跡のhashは `E/manifest.json`。

## 2. Keyboard Design 加算の自己点検

[JLCPCB公式追加料金ページ](https://jlcpcb.com/help/article/in-what-cases-will-there-be-charged-extra)の項目16は、形状要因を **“densely packed milled slots and cutouts”** と説明し、追加額を **$16.41＋$49.25/m²** としている。今回も匿名GETでHTTP 200を取得した。時刻・HTMLのSHA256・response dateは `E/sources/capability-retrieval-records.json`、保存本文は `extra-charges.text.txt`（項目16は212–213行）、HTMLは同名 `.html.gz`。

| 実基板側の項目 | representative21-16mm | representative21-17mm | 公式説明との照合 |
| --- | --- | --- | --- |
| 外形 | 110×100mm、直線4辺、閉じた矩形1周 | 116.5×104.75mm、直線4辺、閉じた矩形1周 | 密集した切り欠きはない |
| 内部 Edge.Cuts／切り欠き | 0 | 0 | 該当する切削形状なし |
| ミリングスロット | 0 | 0 | 密集スロットなし |
| 長穴ドリル | 0 | 0 | NPTH/PTHとも長穴なし |
| NPTH | 円形φ2.2mm×4、H1–H4 | 円形φ2.2mm×4、H1–H4 | 四隅の単純な取付穴。切削スロットと区別 |
| PTHパッド／配線ビア | PTH 0、via 193（φ0.60/穴0.30mm） | PTH 0、via 194（同寸法） | 円形の配線用ビアは切削スロットではない |
| rule area | 4（すべてkeepout） | 4（すべてkeepout） | φ5mm禁止領域は銅箔・配置の制約であり、基板に開く穴ではない |

測定はボード図形とフットプリント内図形の両方を対象とし、Edge.Cuts全体が矩形1周だけであることを検証した。NPTH位置・穴径・各外形座標を [`E/geometry-and-board-evidence.json`](../hardware/kicad/qualification/issue-138-wing-manufacturing-review-prep/geometry-and-board-evidence.json) に保存した。部品・キーのシルクやkeepoutを切削形状として数えていない。

**自己判定：両ピッチとも、公開説明に挙がる密集切削形状には非該当。** 同ページ項目3のスロット幅・切削経路密度によるRouting Feeも、内部スロット0なのでその形状要因はない。

**メーカー審査でのみ確定する範囲：** 項目16はキーボード用途全般を明示的に免除する文言や、密集度の数値基準を示していない。従って形状の自己判定は「メーカーが加算しない」という確約ではない。将来Gerber/Excellonを準備した際の外形・穴の解釈、面付け／捨て基板／タブを含む最終データ、Keyboard Designのカテゴリ判定、課金単位と面積の扱いはメーカー確認が必要。今回アップロード・問い合わせ・価格再計算は行わず、#133の$19.20を加算・送料・税込みの確定額として扱わない。

## 3. 全ネットの実幅と役割

[JLCPCB公式能力ページ](https://jlcpcb.com/capabilities/pcb-capabilities)は、線幅公差±20%、0.10mm線の仕上り幅0.08–0.12mmを明記している（`E/sources/capabilities.text.txt`、279–281行）。以下は**全配線が一様に最悪0.08mmまで細る**前提。0.10mmの設計能力と、製造後0.08mmの電気的断面を区別する。

両基板とも2銅層、板厚1.2mm。銅箔面のべた塗りはなく、4個のzoneは全てkeepout。16mmは765線分＋193via、17mmは727線分＋194viaで、**電源、GND、信号を含む全30ネットの全線分が0.10mm**。電源だけ太くなっている箇所はない。viaの寸法は全て0.60/0.30mm。線分はF.Cu/B.Cuの外層のみ。

各ネットの全パッド（役割の根拠）、層別本数、幅ヒストグラムは [`E/net-widths.json`](../hardware/kicad/qualification/issue-138-wing-manufacturing-review-prep/net-widths.json)、集計CSVは [`E/net-widths.csv`](../hardware/kicad/qualification/issue-138-wing-manufacturing-review-prep/net-widths.csv)。UUID付き全配線・via・パッドは各 `E/KRT-*-inventory.json`。次表の長さは全線分の合計であり、直列の単一路長や最遠部品までの距離ではない。

| ネット | 役割 | 幅 min–max → 最悪 (mm、両基板共通) | 16mm 線分 / via / 長さmm | 17mm 線分 / via / 長さmm |
| --- | --- | --- | ---: | ---: |
| `GND` | GND／リターン | 0.10–0.10 → 0.08 | 200 / 27 / 529.26 | 178 / 47 / 557.17 |
| `HALL_5V` | 電源 | 0.10–0.10 → 0.08 | 144 / 56 / 501.64 | 156 / 31 / 523.05 |
| `H_A0_RAW` | 信号 | 0.10–0.10 → 0.08 | 10 / 2 / 92.30 | 6 / 2 / 96.84 |
| `H_A1_RAW` | 信号 | 0.10–0.10 → 0.08 | 9 / 2 / 81.61 | 12 / 4 / 89.61 |
| `H_A2_RAW` | 信号 | 0.10–0.10 → 0.08 | 9 / 2 / 80.01 | 12 / 6 / 84.01 |
| `H_A3_RAW` | 信号 | 0.10–0.10 → 0.08 | 14 / 0 / 67.31 | 21 / 10 / 73.34 |
| `H_A4_RAW` | 信号 | 0.10–0.10 → 0.08 | 9 / 2 / 98.75 | 3 / 2 / 69.10 |
| `H_A5_RAW` | 信号 | 0.10–0.10 → 0.08 | 4 / 0 / 47.44 | 5 / 0 / 49.96 |
| `H_A6_RAW` | 信号 | 0.10–0.10 → 0.08 | 4 / 0 / 31.83 | 3 / 0 / 32.94 |
| `H_B0_RAW` | 信号 | 0.10–0.10 → 0.08 | 17 / 8 / 90.00 | 16 / 4 / 102.67 |
| `H_B1_RAW` | 信号 | 0.10–0.10 → 0.08 | 20 / 6 / 86.68 | 6 / 0 / 84.86 |
| `H_B2_RAW` | 信号 | 0.10–0.10 → 0.08 | 16 / 4 / 90.59 | 17 / 4 / 94.91 |
| `H_B3_RAW` | 信号 | 0.10–0.10 → 0.08 | 15 / 0 / 66.53 | 13 / 4 / 71.17 |
| `H_B4_RAW` | 信号 | 0.10–0.10 → 0.08 | 15 / 8 / 67.14 | 6 / 4 / 65.83 |
| `H_B5_RAW` | 信号 | 0.10–0.10 → 0.08 | 11 / 0 / 51.70 | 7 / 0 / 49.33 |
| `H_B6_RAW` | 信号 | 0.10–0.10 → 0.08 | 5 / 0 / 28.28 | 9 / 2 / 30.13 |
| `H_C0_RAW` | 信号 | 0.10–0.10 → 0.08 | 16 / 8 / 103.38 | 21 / 8 / 110.80 |
| `H_C1_RAW` | 信号 | 0.10–0.10 → 0.08 | 9 / 0 / 79.33 | 9 / 0 / 84.74 |
| `H_C2_RAW` | 信号 | 0.10–0.10 → 0.08 | 32 / 6 / 100.84 | 19 / 6 / 82.36 |
| `H_C3_RAW` | 信号 | 0.10–0.10 → 0.08 | 8 / 0 / 64.63 | 13 / 0 / 95.30 |
| `H_C4_RAW` | 信号 | 0.10–0.10 → 0.08 | 11 / 6 / 63.57 | 8 / 6 / 67.29 |
| `H_C5_RAW` | 信号 | 0.10–0.10 → 0.08 | 6 / 0 / 44.56 | 11 / 0 / 56.55 |
| `H_C6_RAW` | 信号 | 0.10–0.10 → 0.08 | 4 / 0 / 25.49 | 5 / 2 / 26.04 |
| `MUX_A0` | 信号 | 0.10–0.10 → 0.08 | 41 / 17 / 169.05 | 37 / 16 / 173.86 |
| `MUX_A1` | 信号 | 0.10–0.10 → 0.08 | 35 / 14 / 164.95 | 48 / 14 / 193.38 |
| `MUX_A2` | 信号 | 0.10–0.10 → 0.08 | 37 / 12 / 158.21 | 35 / 11 / 171.56 |
| `MUX_OUT_A` | 信号 | 0.10–0.10 → 0.08 | 10 / 2 / 41.48 | 7 / 2 / 44.52 |
| `MUX_OUT_B` | 信号 | 0.10–0.10 → 0.08 | 10 / 2 / 59.13 | 12 / 2 / 63.13 |
| `MUX_OUT_C` | 信号 | 0.10–0.10 → 0.08 | 8 / 0 / 76.17 | 4 / 0 / 79.97 |
| `WING_EN` | 信号 | 0.10–0.10 → 0.08 | 36 / 9 / 163.14 | 28 / 7 / 167.78 |

HALL_5VはJ_WING.1からDRV5055の21個のpin1とTMUX1208の3個のpin13、およびデカップリングへ供給する。GNDはセンサpin3、MUX pin14からJ_WINGの7個のGND端子へ戻る。H_A/B/C*_RAWは各センサのpin2からMUX入力／一部テストポイントへ、MUX_OUT_A/B/CはMUXのpin8からJ_WINGへ接続。MUX_A0/A1/A2とWING_ENは各3個のMUX制御入力である。

## 4. 電流・許容電流の評価

### 4.1 データシートと負荷条件

部品実データはDRV5055A3QDBZR×21、TMUX1208×3。[TI DRV5055データシート](https://www.ti.com/lit/ds/symlink/drv5055.pdf)の取得版は **SBAS640C、2026年6月改訂**。p5 §5.5のICCは5.0V・B=0mTでtyp 3mA／max 5mA、3.3V・B=0mTでtyp 2mA／max 4mA。p4 §5.3は推奨電源範囲4.5–5.5Vまたは3–3.63V、推奨出力連続電流±1mA。基板のネット名はHALL_5Vなので5V側を主に評価し、3.3Vは比較だけとした。

**電流仕様の留保：** 同じRevCのp9 Fig5-13は代表供給電流が約5.3–6.5mAの曲線で、p5のmax 5mA（5V）と整合しない。改訂履歴には供給電流の変更が記載されている。旧版URL `sbas640b/sbas640b.pdf` も取得したが、応答は現行RevCと同じSHA256で、旧版の保証値は確認できなかった。表の値を採用した計算に加え、**10mA/センサを工学的な感度解析用包絡として計算**した。10mAを今回取得したRevCの保証最大値と称していない。温度・磁界・調達する部品の改訂との対応は発注前に確認が必要。

[TI TMUX1208データシート](https://www.ti.com/lit/ds/symlink/tmux1208.pdf)は **SCDS389C、2018年12月改訂**。p6の5V表はIDD max 2.7µA/個（−40～125°C）、p8の3.3V表はmax 1.5µA/個。供給電流の試験条件は制御入力0Vまたは5.5V。実際の3.3V制御・スイッチング時にその保証値をそのまま適用できるとは限らず、動的消費は残リスクにする。p6の制御入力リークはmax ±0.10µA/端子、p5のS/D連続電流の絶対最大は±30mAで、センサの推奨出力±1mAより大きい（絶対最大を通常動作目標にしない）。

PDF・抽出本文・URL・取得UTC・HTTP応答・SHA256は `E/sources/` と `reference-retrieval-records.json`。`drv5055-revb-url-returned-revc.*` は旧URLに対する現行版応答であり、旧版ではない。

| 計算条件 | センサ21個の電流 | MUX 3個の電流 | HALL_5V供給／GNDリターンの各上限として用いる値 |
| --- | ---: | ---: | ---: |
| 3.3V、データシート表max | 84mA | 4.5µA | 84.0045mA（比較） |
| 5V、データシート表max | 105mA | 8.1µA | 105.0081mA |
| 保守包絡10mA×21 | 210mA | 8.1µA | 210.0081mA |
| 包絡＋出力負荷1mA×21 | 231mA | 8.1µA | **231.0081mA** |

センサはMUXで読取り先を切り替えても21個すべて通電している。供給電流を選択中の3個分だけにしていない。最下段は全21出力が同時に1mAを供給する過大側の包絡であり、3個のMUXで同時に選択する通常の3経路より厳しい。出力電流が全てセンサGNDへ戻るわけではないが、供給／リターンのどちらにも同じ上限を割り当てた。デカップリングの起動突入・短絡電流はこの定常値に含めない。

### 4.2 外層1ozの電流容量

一般的な計算根拠として、[TI TIDA-01232設計ガイド](https://www.ti.com/lit/ug/tiducs7/tiducs7.pdf) p9式7と、[QorvoのPCB Trace Power Handling Calculator](https://www.qorvo.com/design-hub/design-tools/interactive/pcb-trace-power-handling-calculator)が記載する **IPC-2221外層の曲線近似**を使用した。QorvoはWeb閲覧で式と係数を確認したが、curl保存本文はブラウザ検証画面だったため根拠本文として使わない（`E/sources/qorvo-web-check.json`）。保存済みのTI設計ガイドPDFで式と係数を確認できる。IPC-2152を解いた結果とは表記しない。外層・銅厚35µm（1oz近似）・幅80µm・許容温度上昇10Kをこのレビューのスクリーニング条件とする。10Kは設計決定ではなく、評価用の明示的な基準である。

```text
A = (0.08 / 0.0254) × (0.035 / 0.0254) = 4.34001 mil²
I = 0.048 × ΔT^0.44 × A^0.725
I(ΔT=10K) = 0.383197 A
ΔT(I) = [I / (0.048 × A^0.725)]^(1/0.44)
```

| 定常電流 | 383.197mAとの容量比 | 推定自己温度上昇 |
| --- | ---: | ---: |
| 105.0081mA | 3.65倍 | 0.53K |
| 210.0081mA | 1.82倍 | 2.55K |
| 231.0081mA | **1.66倍** | **3.17K** |

**HALL_5V／GNDは、細い1線分にWing全体の231.0081mAが流れると仮定しても10K基準を通過。** 枝分かれへの均等配分、via本数による分流、周辺銅箔の放熱効果を合格理由にしていない。信号RAW／MUX_OUTはセンサ出力の推奨±1mAを上限とした場合、同じ断面の383mAより十分小さい。MUX制御4ネットは静的リークだけなら各3×0.10µA＝0.30µAである。MUXの信号経路に21個の供給電流が流れることはない。全60ネットの計算は [`E/electrical-evaluation.json`](../hardware/kicad/qualification/issue-138-wing-manufacturing-review-prep/electrical-evaluation.json)。

この値は条件付きの熱的スクリーニングであり、保証許容電流やIPC認証ではない。仕上り銅厚35µm未満、局部ネック、銅断面形状、周辺部品の発熱、筐体・周囲温度、隣接配線の同時加熱、viaめっき・はんだ接合、動的電流については別途確認が必要。部品の上限125°Cの周囲で自己発熱を上乗せしてよいという意味ではない。

### 4.3 抵抗・電圧降下の補助点検と電気的結論

幅80µm・銅厚35µmでは、銅の抵抗率を20°Cで1.7241×10⁻⁸Ωmと置くと**約6.16Ω/m**。同じ長さの100µm配線から抵抗は**25%増**になる。電流容量の合格だけでセンサ電圧やADC精度の合格とはしない。

補助的に、実配線・パッド・viaの位置を使う直流抵抗回路を作り、21個の負荷を各パッドに接続した。HALL_5VはJ_WING.1、GNDはJ_WINGの7端子を理想電源の基準とし、全ての定常負荷を同時に印加した。viaバレル20µm仮定、パッド内電流拡散と接触は集中定数近似。外部ケーブル／コネクタ／Main電源の抵抗は含めない。各負荷パッドへの接続とKCL、既知の直列・分岐回路で単位と電流の扱いを検証した。これは**電圧降下の規模を見る近似モデル**であり、完成銅箔の保証最悪値や有限要素解析ではない。

| 幅／温度／センサ電流条件 | 16mm 最大往復降下 | 17mm 最大往復降下 | J_WINGで4.75Vと仮定した最小局所電源（16 / 17） |
| --- | ---: | ---: | ---: |
| 0.08mm / 20°C / 表max 5mA | 0.234V | 0.240V | 4.516 / 4.510V |
| 0.08mm / 125°C / 表max 5mA | 0.331V | 0.339V | **4.419 / 4.411V** |
| 0.10mm / 20°C / 包絡11mA | 0.414V | 0.424V | 4.336 / 4.326V |
| 0.08mm / 20°C / 包絡11mA | **0.515V** | **0.528V** | **4.235 / 4.222V** |
| 0.08mm / 125°C / 包絡11mA | 0.728V | 0.745V | 4.022 / 4.005V |

4.75Vは5V−5%の**感度解析用仮定**であり、既存仕様として採用した値ではない。125°Cも抵抗温度依存の感度解析であり、その周囲温度での動作承認ではない。最も大きいセンサ降下は16mmのU_HB2、17mmのU_HB1。11mA包絡・20°C・最悪幅の場合、往復降下の内訳は16mmでHALL_5V 0.278V／GND 0.238V、17mmで0.304V／0.224V。入力が厳密に5.0Vでも局所電源は約4.485／4.472Vとなる。GNDの持ち上がりはアナログ測定にも影響しうる。出力負荷の同時性、実際のICC、供給端電圧、使用温度を確定して再評価する必要がある。

**結論：指定断面・負荷包絡での電流／発熱上の問題は見つからず、この理由だけの再配線は不要。一方、全使用条件での電気的無問題という判定は保留。** 電圧下限4.5Vを割りうる条件が補助計算にあるため、発注前にHALL_5V／GNDのDC給電・リターンとアナログ基準を確認する。これらの負荷／供給／温度条件を設計要求として維持するなら、**HALL_5V／GNDの幹線の拡幅・並列化・銅箔面等の補強と、それに伴う再配線が必要になる**。具体幅は許容電圧降下と配線可能性から決め、両ピッチでDRC・独立接続検査・幅監査を再度通す。今回、幅の採用決定やPCB変更は行わない。信号配線は定常電流を理由に太くする必要は見つからないが、ADC入力負荷・整定・クロストークの実機合格は別途必要。

モデル、全センサの局所電圧、KCL残差、仮定は [`E/dc-drop-estimate.json`](../hardware/kicad/qualification/issue-138-wing-manufacturing-review-prep/dc-drop-estimate.json) と `E/estimate-dc-drop.py`。計算近似をもって実基板が必ず不良だとも断定しない。

## 5. 発注前チェックリスト・残リスク

「済」は今回の点検完了、「未」は発注担当／設計レビューで確認すべき項目。チェック完了は発注GOの代行ではない。

| 状態 | 点検項目と今回の結果 | 残リスク／発注時に確認する事項 |
| --- | --- | --- |
| 済 | D-021対象と#131合格出力を両ピッチで特定、hash固定 | 最終製造データがこの基板と一致するか確認 |
| 済 | #133を起点に公式追加料金ページを再取得、内部切削0・長穴0・NPTH4を実測 | 形状による自己判定は両ピッチ非該当 |
| 未 | Keyboard Design料金のメーカー確定 | 最終Gerber/Excellonと面付け条件で、加算有無・料金単位・面積解釈を確認。金額の自己判断で支払わない |
| 済 | 全30ネット×2基板の幅と役割を集計、全て0.10mm→0.08mm | 信号だけでなくHALL_5V/GNDも最小幅であることを引継ぐ |
| 済 | 外層35µm・10Kスクリーニング：231.0081mA < 383.197mA | 熱容量上の追加幅変更は不要という条件付き結果 |
| 未 | DRV5055供給電流の保証条件 | RevC表とFig5-13の不整合、実部品改訂・磁界・温度、実測最大電流を確認。10mA包絡を保証値と混同しない |
| 未 | HALL_5V/GNDの電圧降下・GND基準 | J_WINGでの最小電圧、ケーブル／コネクタ／Mainの抵抗、ICC、出力負荷、使用温度、ADC基準を確定。センサ端4.5V以上とアナログ誤差を確認し、満たせなければ電源／GNDのみ補強して再配線・再検査 |
| 未 | TMUX1208の実制御条件 | 3.3V制御・選択周波数での消費電流、入力範囲・信号電流、ADC入力負荷・整定を確認 |
| 未 | 銅厚と製造品質 | 外層1ozの仕上り銅厚・幅公差・局部ネック・viaめっきと最終スタックアップを確認。板厚1.2mm／2層／via0.60/0.30mmとの整合 |
| 未 | 起動・故障・環境／実機 | デカップリング突入、短絡保護、筐体内温度、連続動作、遠端電圧、GND差・キー読取り精度を検証 |
| 未 | 発注用データの最終照合 | Edge.Cuts、NPTHφ2.2×4、ドリル分類、単一外形、最小間隔0.10mm、Gerber/Excellonプレビュー。改版があれば本レビューを更新 |
| 未 | 費用と承認 | #133の基板代は参考。加算・送料・税・最終数量・両ピッチの扱いを確認し、発注判断はPOが行う |

## 6. 再現・提出監査

既存のKiCad／geometryランタイムを読取り専用で再利用し、書込み可能な一時状態・Git管理情報は `.issue138-runtime/` へ置いた。通常の `.git` が書込み対象外のため、管理情報を `.issue138-runtime/git` に複製し、同じ作業ツリーに対して指定ブランチ `issue-138-wing-manufacturing-review-prep` を作成した。元の `.git` のmainを切り替えたり、#137の未追跡成果物をstageしたりしていない。

```bash
# リポジトリルートで、保存済み公式資料を再利用して集計・計算する
bash hardware/kicad/qualification/issue-138-wing-manufacturing-review-prep/run-local-analysis.sh
# 公式資料を再取得する場合のみ（匿名GETのみ、注文処理なし）
python3 hardware/kicad/qualification/issue-133-wing-cost-check/fetch-capability-pages.py \
  hardware/kicad/qualification/issue-138-wing-manufacturing-review-prep/sources
python3 hardware/kicad/qualification/issue-138-wing-manufacturing-review-prep/fetch-sources.py
```

ランタイムのパスはこの作業環境向け。別環境では同等のKiCad pcbnew、sexpdata、numpy、shapelyを用意する。公式ページの再取得は時点によって変わるため、保存した取得記録と混同しない。

`E/verification.json` は、既存追跡ファイルと#137報告・証跡を含む開始時hashの一致、配線のnative reader／S式／#131保存snapshotの一致、60ネットの集計、ソースhash、モデルの解析解テストとKCLを監査する。既存ファイルの変更はなく追加のみ。指定ブランチのpushに成功し、[Draft PR #140](https://github.com/ihsinoky/he-piantor-42/pull/140) を作成した。GitHub接続ツールは承認設定のため作成できず、GitHub CLIで作成し、open／draft／未mergeを接続ツールで確認した。公開記録は `E/publication.json`。mergeは行っていない。
