ihsinoky/he-piantor-42/docs/issue-137-main-manufacturing-review-prep.md

# Issue #137 — Main 製造前レビュー準備

**PMOへの推奨は、via は「エポキシ充填＋銅キャップ（POFV）」を第一候補にして現行配線を維持する案、J1 は「Economic PCBA 内で信号端子と固定脚を一括実装」を第一候補にする案である。いずれも個別工程の受入れと増額の確認を条件とする。** 本報告は判断材料であり、POの仕様決定、製造承認、発注ではない。D-019の未決定2件を決定済みに変更していない。

[Issue #137](https://github.com/ihsinoky/he-piantor-42/issues/137) の指示書を全文読んで実施した。出発点は main `8a4c3d321fca4880e62289c10d81af845f162bc5`（リモートmainと一致）。以下 E は [今回の証跡](../hardware/kicad/qualification/issue-137-main-manufacturing-review-prep/) を指す。取得は2026-11-05 UTC。既存設計・既存文書は変更せず、ログイン、設計アップロード、精密見積もり、業者への問い合わせ、発注、課金、mergeは行っていない。

## 25件を合格基板と照合した結果

対象は [#121報告](issue-121-full-auto-conditions.md) の `evidence/inspection/main-cell1/krt/main.kicad_pcb`（再充填済み合格出力、66ビア）と同ディレクトリの `router-structured-log.json` の `VIA_IN_PAD_JSON[0].unprotected`。ログ座標25件が基板の25個のビアに一意に一致した。全ビアは外径0.60 / 穴径0.30 mm。全件で接触パッドと同ネットだった。入力SHA256は E/board-analysis.json に保持する。元ログは `stamped=0 / unstampable=25` で、ファイル形式20241229がKiCad 10の個別filling/capping記録より古いことを理由に挙げる。この自己注記を製造者への工程指定済みと扱わない。

**ログの site 名は実際の部品分類ではない。** `board F.Paste (graphic)` 24件も、位置を調べるとすべて部品またはテストパッドに対応したペースト開口で、同時にそのパッドの銅箔とビア外周が重なる。これを「部品パッドとは無関係な24件」と扱えない。逆に `C5.2` の1件は穴がパッド上にない。

| 排他的な幾何分類 | 件数 | 意味 |
| --- | ---: | --- |
| 搭載部品のパッド内にビア中心 | 19 | 穴も銅箔パッドに重なる。U1.57には2個のビアがある |
| 搭載部品のパッド外に中心、穴の一部がパッド端に重なる | 4 | U3.4、C4.2、C13.1、J2.7。中心が外でもはんだ流入経路は残る |
| 搭載部品のパッドとビア外周銅箔だけが重なる | 1 | C5.2。穴とペースト開口は重ならない |
| 裸テストパッド上の穴 | 1 | TP4.1。購入・搭載部品の接合ではないが、実データにF.Paste開口あり |
| パッド銅箔との重なりがない、ペースト図形だけの検出 | **0** | 今回の25件には該当なし |

したがって**搭載部品の銅箔パッドに穴がかかるのは23件**、裸TPを含む穴対銅箔の重なりは24件。ビア外周対ペースト図形は24件、そのうち**穴そのもの対ペーストは22件**（裸TPを含む）。これらは重複する観点であり、件数を足さない。24件すべての図形をパッド中心へ2nm以内で対応付けできた。

KiCad 9.0.9の実効形状の衝突判定を用い、穴径0.30mmの円と外径0.60mmの円を別々に照合した。さらに独立したS式読取りと円・矩形・長円の距離計算で、25件のパッド/ペーストUUIDと穴重なりを全件再照合した（E/geometry-crosscheck.json: pass）。公差、マスク拡張、実ステンシル補正は含まない公称形状の分類であり、製造者のDFM判定ではない。66個全体の走査でも、この25個以外に同種の銅箔/ペースト重なりは検出しなかった。

代表5例の公称形状。橙=パッド銅箔、緑=ペースト、青=ビア銅箔、白=穴

### 全25件の一覧

座標は基板絶対XY・mm、表面を鏡像にしない。中心=パッド内に中心、端穴=パッド外に中心があるが穴が重なる、外周のみ=穴は重ならない。「穴/ペースト」はドリル円の重なり。全行のUUID・パッド寸法・元site名・図形座標は E/board-analysis.json、機械可読一覧は E/via-observations.csv。

| log順 | X | Y | ネット | 対象パッド | 分類 | 穴/ペースト |
| --- | ---: | ---: | --- | --- | --- | --- |
| 1 | 104.5 | 106.1 | GND | C7.2 | 中心 | 有 |
| 2 | 106.0 | 96.5 | GND | C10.2 | 中心 | 有 |
| 3 | 103.5 | 94.0 | GND | C11.2 | 中心 | 有 |
| 4 | 103.6 | 90.1 | GND | U3.4 | 端穴 | 有 |
| 5 | 109.4 | 116.0 | GND | J2.8 | 中心 | 有 |
| 6 | 114.4 | 116.0 | GND | J2.4 | 中心 | 有 |
| 7 | 116.9 | 116.0 | GND | J2.2 | 中心 | 有 |
| 8 | 100.0 | 100.0 | GND | U1.57 | 中心 | 有 |
| 9 | 94.8 | 99.0 | GND | C4.2 | 端穴 | 有 |
| 10 | 95.0 | 102.5 | GND | C5.2 | 外周のみ | 無（外周/ペーストも無） |
| 11 | 86.2 | 102.1 | GND | Y1.2 | 中心 | 有 |
| 12 | 84.8 | 97.0 | GND | C17.2 | 中心 | 有 |
| 13 | 83.7 | 92.0 | GND | U2.2 | 中心 | 有 |
| 14 | 88.8 | 107.0 | GND | C19.2 | 中心 | 有 |
| 15 | 100.6 | 99.8 | GND | U1.57 | 中心 | 有 |
| 16 | 108.1 | 100.0 | V1V1 | C13.1 | 端穴 | 無（外周/ペーストは有） |
| 17 | 87.0 | 106.8 | HALL_5V | C19.1 | 中心 | 有 |
| 18 | 115.0 | 104.7 | ADC_B | C21.1 | 中心 | 有 |
| 19 | 111.0 | 104.5 | ADC_A | C20.1 | 中心 | 有 |
| 20 | 97.0 | 118.0 | QSPI_SS_FLASH | TP4.1 | 裸TPの中心 | 有 |
| 21 | 93.5 | 99.2 | V3V3 | C4.1 | 中心 | 有 |
| 22 | 103.4 | 97.3 | V3V3 | U1.42 | 中心 | 有 |
| 23 | 99.7 | 106.0 | V3V3 | C6.1 | 中心 | 有 |
| 24 | 81.2 | 99.0 | VBUS | U4.1 | 中心 | 有 |
| 25 | 110.2 | 116.0 | WING_EN | J2.7 | 端穴 | 無（外周/ペーストは有） |

C5.2の穴とパッド銅箔の最短間隙は約0.134253mm、ビア外周の食込みは約0.015747mm。C13.1とJ2.7は穴が銅箔へそれぞれ約0.030 / 0.025mm食い込む一方、縮小されたペースト開口とは穴が重ならない。これだけでは、濡れ広がりやマスク公差を含む吸い込みリスクがないとはいえない（工学的解釈）。TP4のペースト印刷要否も別途確認対象であり、今回削除していない。

## via処理：一次情報と選択肢

JLCPCBの[via covering公式ヘルプ](https://jlcpcb.com/help/article/pcb-via-covering)は、非導電エポキシ充填後の銅めっきと、導電性銅ペースト充填後の銅めっきを別の選択肢として掲載する。tented（マスク被覆）やインクpluggedは同じ工程ではなく、パッド内や開口から0.35mm未満のインク充填は対象外としている。対象viaを図示/注記するか、特定径の全viaとして指定でき、製造ファイル確認を推奨する。

[公式POFV工程説明](https://jlcpcb.com/news/free-via-in-pad-6-20-layer-pcbs-pofv)では、ドリル・穴壁めっきに加え、エポキシ充填→加熱乾燥→平坦化→追加銅めっきの工程を示す。**4層POFVは有料**、6–20層の無料条件はD-019の4層Mainに適用しない。4層樹脂充填の値上げを述べる[2026-08-06公式告知](https://jlcpcb.com/news/pcb-lead-time-and-price-adjustment-august2026)も確認したが、一時的な設備調整の告知であり現在の価格・納期の確定根拠にはしない。**本件5枚の追加額、固定費/面積/個数の算定単位は未取得**。旧資料の価格や他社価格から推測しない。

現行の[PCB能力表](https://jlcpcb.com/capabilities/pcb-capabilities/)はfilled/cappedを掲載する一方、対応する `via diameters` を0.15–0.55mmと表記する。旧POFV説明は穴径0.2–0.5mmである。現基板の穴0.30mm・環状リング0.15mmは旧説明の寸法範囲だが、**現能力表のdiameterが外径か穴径かの正式解釈は未取得**。外径0.60mmへの適用可否を勝手に合格としない。

指定なしの場合、4層で自動的にfilled/cappedになる根拠は得られなかった。[追加料金公式ページ](https://jlcpcb.com/help/article/in-what-cases-will-there-be-charged-extra)には、選択不一致や特殊工程でファイル審査中の追徴があり得る旨があるが、via-in-pad全件を必ず差し戻すという規定は未取得。[PCBA利用条件](https://jlcpcb.com/help/article/terms-and-conditions-of-jlcpcb-assembly-service)はvia-in-padのはんだ吸い込み・部品傾き・tombstoning等と免責を掲載する。**DFMで必ず救済されると期待できない**、というのがこれらからの判断であり、本基板へのDFM回答は未取得である。

| 選択肢 | 費用影響 | リスク・手間 | PMOへの評価 |
| --- | --- | --- | --- |
| (a) 現状のまま、充填/キャップを追加指定しない | 意図したPOFV追加費は見込まないが、審査追徴・不良/再製作費は未取得。基板$8を総額保証に使えない | 配線変更なし。ただし23件の搭載パッドへの穴重なりが残り、吸い込み・接合不足のおそれ。DFM差し戻し/確認の発生は未確定 | 製造側の事前受入れとPOのリスク判断なしに推奨しない |
| (b) filled＋cappedを明示（第一候補：非導電エポキシPOFV） | 4層は追加費用あり。具体額は未取得。銅ペーストとの差額も未取得 | #121の配線を維持できる。対象位置/径、平坦性、銅キャップ、マスク/ペースト、Economic適格性を確認。対象限定か全66個かでも受入れ・費用を確認 | **第一推奨候補**。23件の搭載パッド穴重なりを少なくとも評価対象とし、C5・TP4を含む25件全件を提示して処置範囲をメーカーと確定する案 |
| (c) 設計側で回避（dog-bone、ビア移動、適切なpaste設計等） | 特殊工程を不要にできる可能性。再設計・検証工数と成功率は未取得 | **#121の合格配線を作り直すため再評価が必要**。pasteだけ縮小しても銅箔上の穴は解消しない。未配線・short・物的違反・転送差分、GND再充填、製造形状を再確認する | POFVの費用/適格性が許容されない場合の第二候補。今回の範囲では実施しない |

推奨(b)は配線完成証跡を維持しながら、実際の穴重なりへ工程で対応するための候補である。熱設計上の導電充填要求は本調査では得ておらず、高価とされる銅ペーストを必須にはしない。発注注記を将来作る場合は、対象viaの座標/径を指定し、**J1の4本の部品用PTHと2個のNPTHを充填対象外**と明示する。今回の資料を承認済みfab drawingとして投入しない。

## J1：実形状、サービス差、費用

[#124の改訂後報告](issue-124-main-bom-pcba-estimate.md#改訂後の5枚総額1枚単価)はBOMギャップ解消後の条件付き総額 **5枚$91.1050（表示$91.11）**。この中には既にUSB shellのmanual＋labor予算$3.9080が含まれる。「片面SMD配置前提」を「PTH工程費を一切見込んでいない」と読み替えず、今回も二重加算しない。

現基板でJ1は**12 SMDパッド＋4 PTH固定脚＋2 NPTH**。SMDには信号だけでなく電源/GNDも含む。固定脚はすべてpad番号13・GND、位置は以下。pad番号が同じでも実接合候補は4箇所/枚である。

| XY mm | 銅箔ランド寸法 mm | 長穴drill mm |
| --- | --- | --- |
| (80.68, 79.95)、(89.32, 79.95) | 1.0 × 1.6 | 0.6 × 1.2 |
| (80.68, 84.13)、(89.32, 84.13) | 1.0 × 2.1 | 0.6 × 1.7 |

NPTHは(82.11,83.60)、(87.89,83.60)、直径0.65mmで、はんだ接合数に含めない。さらに**4本のPTH固定脚にもboard-level F.Paste図形がある**（幅1mmの線分で長円形の開口、寸法は対応ランドと一致）。パッド自身のlayer集合にF.Pasteがなくても、基板図形がステンシルへ出る。このため、脚だけ後工程とする場合はステンシル/ペースト工程の扱いも確認が必要。現データから「脚は未はんだで届く」と仮定できない。

JLCPCBの[PCBA能力表](https://jlcpcb.com/capabilities/pcb-assembly-capabilities)は**両サービスで同一発注のSMD＋THT混載を支持**する。一般説明はSMDにリフロー、THTにウェーブだが、J1の混合端子部品にどの工程を使うかまでは示さない。[C165948個別ページ](https://jlcpcb.com/partdetail/C165948)もTYPE-C-31-M-12をSMD / SMT Assembly / Economic and Standardと掲載する。これは部品単位の掲載適格性であり、現footprintの4脚を含む工程承認ではない。

| 観点 | Economic PCBA | Standard PCBA | 本件での意味 |
| --- | --- | --- | --- |
| 配置/混載 | 片面、SMT/THT | 片面/両面、SMT/THT | 固定脚の裏面フィレットだけを理由に「両面部品配置」と断定しない |
| 主な掲載範囲 | 2/4/6層、0.8–1.6mm、2–50枚、最小10×10mm、標準stackup | 1–32層、最小70×70mm、rails/fiducials必要 | 48×44mm・4層・1.2mm・5枚はEconomicの一般範囲。Standardはrails/パネル等の対応が必要 |
| SPI / リフロー温度 | SPIなし、255±5℃（調整不可） | SPIあり、240±5℃ | C165948の個別温度適合と工程は未取得。POFVとの同時適格性も未取得 |

費用出典は[PCBA専用料金表](https://jlcpcb.com/help/article/pcb-assembly-price)（取得時の更新日2026-10-22、USD）。少量manualは**両サービス $0.0164/接合＋hand-soldering labor $3.58/注文**。4脚×5枚=20接合なら `20×0.0164+3.58=$3.9080`。別途掲載されるpre-reflowは$0.016/接合で、20接合なら$0.3200だが、**J1への適用やmanualとの関係は未取得**。安い方を選んで確定値にせず、同じ接合へ両方を自動加算もしない。

Standardに移ると片面setupは$8.18→$25.56、stencilは$1.53→$8.21、feederはEconomicのExtendedのみ$3.07/種から、Basicも含め$1.53/種になる。#124のBOMはBasic11種＋Extended9種なので、同じ20種が課金対象ならfeederは$27.63→$30.60、これら3費目だけで**+$27.03**。Standard総額の差額ではない。料金表にはfixture/storage、packing、handling等もある。handlingはEconomicとの差が$14.93未満なら不足額を課す規定、$0.48/boardはbulkでの最低SMT費を補う規定であり、5枚に一律加算しない。1–29枚のStandard rigid fixture $16.42という表もあるが、本件での適用・最終合計は未取得。

### J1工程の選択肢と推奨

| 選択肢 | 費用 | 現実性・条件 | PMOへの評価 |
| --- | --- | --- | --- |
| (a) 同一PCBA発注でJ1全体を実装 | manualなら5枚$3.9080が既存予算内。リフロー/pre-reflow/ウェーブ等の実課金は未取得 | Economic混載と部品掲載は確認済み。12 SMD端子＋4脚の工程、長穴の穴充填/フィレット、検査、ペースト量の個別確認が必要 | **Economicで一括を第一推奨候補**。Standard必須と先に決めず、Economic不可の具体的理由が出た場合に比較 |
| (b) J1をPCBAで搭載しSMD端子を接合、4脚だけ受領後に手はんだ | 仮にメーカーmanual費だけ外せれば最大$3.9080を除く比較。受領後の工具・材料・工数・検査費は未取得。他の手はんだ工程が残ればlabor全額は消えない | **工程としては条件付きで成立し得る（工学的判断）**。J1本体と脚は一体なので、脚の挿入はPCBA搭載時。受領後は既に挿入された脚を底面からはんだ付けする。脚だけの後付け部品ではない。脚のpaste抑止、脚を未はんだで出荷できるか、輸送時固定、こてアクセス、GNDへの熱供給、接合検査の合意が必要 | メーカーの部分工程対応は**未取得**。単なるBOM/CPL上のJ1除外ではSMD端子実装の前提が崩れるため代替指定にならない。第二候補 |
| (c) J1全体をPCBA対象外にし、受領後に全端子を実装 | J1の部品調達・SMD/脚の組立/検査工数等は未取得。BOM/CPLから除けば部品/feeder等も変わる | 部品単位で分離でき、脚だけ未はんだの特殊指定を避けられるが、狭ピッチSMD端子も自前実装になり難度が上がる。穴保護・paste/ステンシル・調達を準備する | 部分工程を受け付けず一括も不可の場合の予備案。コネクタ変更ならfootprint/機械/USB再検証が必要で今回の範囲外 |

(b)の「成立し得る」は試作実証やJLCPCBの受入れ回答ではない。実装済み信号端子の再加熱、脚の熱容量、底面アクセスを確認し、固定脚が未接合の状態ではコネクタにケーブル挿抜荷重を掛けない工程が必要になる。前述のPTH用paste図形を含むため、現在の製造データを無変更で発注して(b)を実現できるとは判断していない。

## PO判断前に残る取得事項

1. **via工程**：0.60/0.30mmの受入れ、23件の搭載パッド穴重なりとC5/TP4の処置、対象限定/全66個、マスク/ステンシル、4層5枚のPOFV増額・算定規定・納期を確認する。無指定時の当該設計へのDFM回答は未取得。
2. **J1工程**：C165948のSMD端子と4脚を同一Economic注文で接合できるか、工程/接合数/追加費、長穴の検査、NPTH保護を確認する。部分工程なら既存pasteと出荷固定方法まで含めた可否が未取得。
3. **組合せ**：filled/capped＋現Main条件＋C165948を同時にEconomicで扱えるかを確認する。不可ならStandardのrails/パネル・全追加費を比較する。個々の公開能力だけで組合せの受入れを保証しない。
4. PMOが上の回答と増額を整理してから、**POが仕様を決定**する。今回の候補・式をそのまま注文仕様や確定総額に転用しない。

## 証跡・検証・提出

E/primary-sources.json に公式9ページのURL、UTC取得開始/終了、HTTP 200、本文SHA256、該当節、短い原文抜粋、取得事実と未取得事項を保存した。初回Python HTTP取得はIncompleteRead等があり E/initial-http-attempts.json に残し、curl HTTP/1.1で全9件を取得し直して本文を確認した。全文HTMLは `.issue137-runtime/sources/`、Gitへは取得記録と必要な抜粋を保持する。検索スニペットだけで料金を確定せず、認証なしの実取得本文を用いた。

E/analyze-board.py、crosscheck-geometry.py、build-review-assets.py は読取り・派生成果物作成用。実行環境・入力/成果物hash・件数・費用式・追加のみの検査は E/provenance.json、verification.json、manifest.json、提出の試行結果は E/submission.json を参照。設計変更がないためルータ、再充填、DRCを再実行しておらず、#121の完成を再認定したとも主張しない。

開始時に既存未追跡 `.issue129-runtime/`、`.issue133-runtime/`、`.issue135-runtime/` があり、そのまま保持した。元 `.git` は読み取り専用でブランチ作成できなかったため、同じ作業ディレクトリの `.issue137-runtime/git/` に管理情報をコピーして `GIT_DIR` / `GIT_WORK_TREE` を指定し、ブランチ `issue-137-main-manufacturing-review-prep` を作成した。既存追跡ファイルと元Git管理情報を変更していない。追加成果物をコミットし、Draft PRの作成を試み、mergeしない。pushできない場合は同ランタイムのコミットとbundleをPMOへ引き継ぐ。

提出：指定ブランチのpushに成功し、[Draft PR #139](https://github.com/ihsinoky/he-piantor-42/pull/139) を作成した。GitHubコネクタの作成呼出しは環境の承認ポリシーで実行不可だったため、GitHub CLIの `--draft` で作成し、`isDraft=true / state=OPEN / mergedAt=null` を確認した。提出記録を追加コミットして同PRへpushする。仕様決定・発注・mergeは行っていない。
