ihsinoky/he-piantor-42/hardware/kicad/qualification/issue-167-main-dual-wing-stage2/instructions.md

# Issue #167 指示：Main 2 Wing 化 Stage 2（再構成）

GitHub Issue #167「Main 2 Wing 化 Stage 2（再構成）：案C＋5.2V安定化レールの実装・再配線・再資格確認」を取得し、その内容を実行してください。作業ブランチは issue-167-main-dual-wing-stage2 を切ってください。

## 決定済みの前提
- 案C：外形 X76–124／Y70–122（48×52mm）、J3=(105,73)・0°、取付穴4個と既存部品座標は固定（D-025）
- 機構は (b) 方針：設計先行。J3 近傍支持は筐体要件、GH 実物確認は M1 実機での後段検証として記録するだけとし、本作業のゲートにしない
- 電源：5.2V 安定化レール（TPS63070 級・強制 PWM buck-boost）＋共通 default-off（U5）＋低抵抗2分岐（Issue #165 の推奨、報告書 docs/issue-165-dual-wing-power-study.md）
- 保証範囲：設計負荷 127mA/Wing、最遠点 4.60V が設計目標、Main 共通／枝抵抗は各 50mΩ 以下が目標、11mA 包絡はストレス記録のみ

## 作業の要点
1. PR #164 ブランチ（issue-163-main-dual-wing-plan-c）の D-024／D-025 本文と #160／#163 の報告書・証跡を取り込み、docs/decisions.md に D-026（機構 (b) 方針、電源方式、保証範囲の採用）を追記する。この Issue では decisions.md の追記が認められる変更である
2. 実装：#155 改版基板を起点に hash を保存し、外形拡張、J3、MUX_EN1（GPIO6＋100kΩ プルダウン）、5.2V レール（変換 IC 最終選定・周辺部品・強制 PWM）、電源2分岐を行う
3. 電源検証：変換器入力予算（USB 上流＋Main 他負荷で 4.75V を示す）、システム電流と USB 許可電流の照合、実抵抗抽出による最遠点の再評価
4. D-019 条件での再配線、独立資格確認（4指標すべて0、全ネット）。製造データ再生成、POFV 再分類、PCBA 見積更新
- 報告書 docs/issue-167-main-dual-wing-stage2.md と証跡を新規フォルダに追加

## 制約
- 条件緩和と無制限の再試行は禁止。成立しない場合は状態を報告して止める
- 発注・課金は行わない。Draft PR を作成し、merge はしない
- 一時ランタイムは .issue167-runtime/ に置く（/tmp は 512MB）
