ihsinoky/he-piantor-42/hardware/kicad/qualification/issue-163-main-dual-wing-plan-c/instructions.md

# Issue #163 指示：Main 2 Wing 接続化 Stage 2（案C）

GitHub Issue #163「Main 2 Wing 接続化 Stage 2（案C）：実装・再配線・再資格確認」を取得し、その内容を実行してください。作業ブランチは issue-163-main-dual-wing-plan-c を切ってください。

## 採用内容（PO 決定済み）
- 案C：外形 X76–124／Y70–122（48×52mm、北へ 8mm 拡張）、J3 = (105,73)・0°。D-023 の取付穴4個と J1/J2・既存部品の座標は固定
- 電気方式は D-024 のとおり（PR #162 のブランチ issue-160-main-dual-wing-stage2 と docs/issue-160-main-dual-wing-stage2.md を参照）：共通電源・共通アドレス・共通3 ADC、独立 EN×2、U5 近傍からの電源2分岐

## 作業の要点
1. PR #162 ブランチの D-024 本文と #160 の報告書・証跡ファイルを本ブランチに取り込み、docs/decisions.md に D-025（案C切替の採用）を追記する。この Issue では decisions.md の追記が認められる変更である
2. 機構の具体化：ねじと着脱工具・操作方法を具体的に選定し、案Cでの操作領域・ラッチ解除・ケーブル高さを確認する。J3 の北側張り出しによる挿抜荷重とたわみも評価する
3. 実装：#155 改版基板を起点に hash を保存し、外形拡張、J3、MUX_EN1、電源2分岐を行う
4. 電源経路の低抵抗化と2系統モデルの再評価（実配線抵抗、最遠センサー 4.5V 以上を示す）
5. D-019 条件での再配線、独立資格確認（4指標すべて0、全ネット）。製造データ再生成、POFV 再分類、PCBA 見積更新
- 報告書 docs/issue-163-main-dual-wing-plan-c.md と証跡を新規フォルダに追加

## 制約
- 条件緩和と無制限の再試行は禁止。成立しない場合は状態を報告して止める
- 発注・課金は行わない。Draft PR を作成し、merge はしない
- 一時ランタイムは .issue163-runtime/ に置く（/tmp は 512MB）
