ihsinoky/he-piantor-42/hardware/kicad/qualification/issue-158-vera-wing-stage1/instructions.md

# Issue #158 指示：ver.A Wing 標準実装化 Stage 1

GitHub Issue #158「ver.A Wing 標準実装化 Stage 1：設計計画（位置決め穴・裏面センサー・左右展開）」を取得し、その内容を実行してください。作業ブランチは issue-158-vera-wing-stage1 を切ってください。

## 入力
- Issue #150 の筐体 Stage 1 報告書（docs/issue-150-case-stage1.md）：Gateron Magnetic Jade Pro HE のメーカー基準設計（キーごとに位置決め穴 φ1.70mm×2、Hall センサーは基板裏面）、距離チェーンの寸法調査
- 現行 M1 評価 Wing の設計資料（代表21、左半分、hardware/jitx/wing/ と資格確認証跡）と D-021（Wing 基準：2層・1.2mm、信号 0.10mm／電源・GND 0.30mm）
- D-017 の Main↔Wing インタフェース（GH 14ピン）と、Issue #157 の Main 2 Wing 接続化の定義案（左右は同じインタフェースを使う前提）

## 作業
1. 標準実装の要件整理：位置決め穴の配置規則、裏面センサーの配置と検出距離チェーン、スイッチ脚・センサー・位置決め穴の干渉条件
2. 左右展開：左21キーと右（ミラー）の構成。インタフェース互換の確認
3. 取付穴（φ2.2mm×4）と外形の維持可否。位置決め穴42個追加の影響
4. 一体パネルの接合部案（分離は自宅側。手元で分離でき配線を傷めない形）
5. ピッチの扱い：ピッチ確定前に進められる部分と確定が要る部分の切り分け
6. D-021 条件での配線実現性の見通し（裏面部品による両面実装の影響を含む）
- 報告書 docs/issue-158-vera-wing-stage1.md と証跡を新規フォルダに追加のみで置く

## 制約
- 基板データの作成・配線はしない（Stage 2 以降の範囲）
- 発注・課金は行わない。Draft PR を作成し、merge はしない
- 一時ランタイムは .issue158-runtime/ に置く（/tmp は 512MB）
