ihsinoky/he-piantor-42/hardware/kicad/qualification/issue-138-wing-manufacturing-review-prep/instructions.md

# Issue #138 指示書：Wing 発注前製造レビュー準備

- 発行：PMO（2026-11-05）。PO の Codex 回復・GO 指示と PMO-GO 権限委譲に基づく
- ワーカー：Codex
- タイムボックス：**1.5時間**

## 目的

D-021（Wing 基準）の留保事項2件を発注前に点検し、発注前チェックリストと残リスク一覧を作る。発注判断はしない。発注・課金は行わない。

## 点検1：Keyboard Design 加算の該当性

- 出発点：`docs/issue-133-wing-cost-check.md` の「未解消リスク」節と、その証跡（geometry-evidence.json、追加料金ページの取得記録）
- JLCPCB 公式の追加料金ページの記載（対象となる形状の定義）を再確認し、representative21 両ピッチの基板データ（#131 の配線済み基板。外形、内部 Edge.Cuts、スロット、NPTH の実データ）と突き合わせる
- 該当／非該当の自己点検結果を、根拠（基板側の実数と公式記載の引用）つきで示す。ファイル審査でしか確定しない部分は、その範囲を切り分けて明記する

## 点検2：線幅公差 ±20% の影響評価

- 前提：JLCPCB 公式記載の線幅公差 ±20%。0.10mm の配線は最悪 0.08mm まで細る
- #131 の配線済み基板（KRT-16-2L-0100、KRT-17-2L-0100 の合格出力）から、ネット別の配線幅と役割（電源／GND／信号）を集計する
- 電流の見積もり：DRV5055A3 のデータシート（供給電流）からセンサ21個分の供給・リターン電流を見積もり、0.08mm×外層1oz の許容電流（IPC-2152 等の一般的な計算根拠を明示）と対比する。TMUX1208 側も同様に確認する
- 結論：最悪ケースでも電気的に問題ないか、問題がある場合は該当ネットと対処（例：当該ネットのみ幅を太くする再配線の要否）を具体的に示す

## 成果物

- 報告書：`docs/issue-138-wing-manufacturing-review-prep.md`（新規追加のみ）。発注前チェックリスト（点検結果・残リスク・発注時に確認すべき事項）を本文に含める
- 証跡：`hardware/kicad/qualification/issue-138-wing-manufacturing-review-prep/`
- 作業ブランチ `issue-138-wing-manufacturing-review-prep` から Draft PR を作成する（push できない場合はコミット済みの状態で報告。PMO がホスト側から push する）。merge は禁止
- 既存ファイルの変更は禁止（追加のみ）
- 一時ランタイムは作業ディレクトリ内の `.issue138-runtime/` に置く（/tmp は 512MB しかない）
