ihsinoky/he-piantor-42/hardware/kicad/qualification/issue-137-main-manufacturing-review-prep/via-observations.csv

log_index | log_site | x_mm | y_mm | net | ref | pad | category | center_in_pad | drill_overlaps_pad | paste_graphics | drill_overlaps_paste | via_uuid | pad_uuid | paste_uuid
1 | board F.Paste (graphic) | 104.5 | 106.1 | GND | C7 | 2 | component-pad-center | True | True | 1 | True | ed512434-d9b0-4aeb-8a4e-dbf321015709 | adab0244-8b45-4eff-8598-82f76f055d64 | 5c193c4c-9522-45b7-9d35-21da08ca2a79
2 | board F.Paste (graphic) | 106.0 | 96.5 | GND | C10 | 2 | component-pad-center | True | True | 1 | True | 3ab8796b-4086-4764-8277-91f59e9527de | 3e1586a0-059d-4dc6-8200-a7eb83ac17f6 | d8b2c8d0-1663-4559-b33c-e9ef348394bd
3 | board F.Paste (graphic) | 103.5 | 94.0 | GND | C11 | 2 | component-pad-center | True | True | 1 | True | 3ac17486-7ebe-4dc1-af7f-18e6ed510013 | e3e0c447-ddc0-4d04-9690-0620ae4bec0b | b0b76286-a368-4882-a06b-c206125738a5
4 | board F.Paste (graphic) | 103.6 | 90.1 | GND | U3 | 4 | component-pad-edge-hole | False | True | 1 | True | 41f5fba0-adaa-4381-b2fa-140005e23f31 | c49c573d-fecb-4876-9cf9-d0df5b00e2f7 | 8bc1778e-4357-4406-b3bc-3ffccd2f65df
5 | board F.Paste (graphic) | 109.4 | 116.0 | GND | J2 | 8 | component-pad-center | True | True | 1 | True | 635f14dd-6114-49ca-9b49-1b7a82999377 | fc5917f1-dfeb-460d-b298-1ac9c5dc16bd | c7f1b536-e6f3-4365-8387-98fc8c879e6b
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
25 | board F.Paste (graphic) | 110.2 | 116.0 | WING_EN | J2 | 7 | component-pad-edge-hole | False | True | 1 | False | 2e54abd4-027b-4b4b-b82a-79ba63e60780 | 8657a919-cb24-403b-971a-5d56f6f20a55 | f4d3679c-5b0a-44a6-82c9-bf852d5175fb
