ihsinoky/he-piantor-42/hardware/kicad/qualification/issue-138-wing-manufacturing-review-prep/net-widths.csv

cell | net | role | segments | vias | min_width_mm | max_width_mm | worst_width_mm | length_mm | pins
KRT-16-2L-0100 | GND | GND | 200 | 27 | 0.1 | 0.1 | 0.08 | 529.2573952066305 | C_HA0.2;C_HA1.2;C_HA2.2;C_HA3.2;C_HA4.2;C_HA5.2;C_HA6.2;C_HB0.2;C_HB1.2;C_HB2.2;C_HB3.2;C_HB4.2;C_HB5.2;C_HB6.2;C_HC0.2;C_HC1.2;C_HC2.2;C_HC3.2;C_HC4.2;C_HC5.2;C_HC6.2;C_MUX_A.2;C_MUX_B.2;C_MUX_C.2;J_WING.10;J_WING.12;J_WING.14;J_WING.2;J_WING.4;J_WING.8;TP_W_GND.1;TP_W_GND_A.1;TP_W_GND_B.1;TP_W_GND_C.1;U_HA0.3;U_HA1.3;U_HA2.3;U_HA3.3;U_HA4.3;U_HA5.3;U_HA6.3;U_HB0.3;U_HB1.3;U_HB2.3;U_HB3.3;U_HB4.3;U_HB5.3;U_HB6.3;U_HC0.3;U_HC1.3;U_HC2.3;U_HC3.3;U_HC4.3;U_HC5.3;U_HC6.3;U_MUX_A.14;U_MUX_B.14;U_MUX_C.14
KRT-16-2L-0100 | HALL_5V | power | 144 | 56 | 0.1 | 0.1 | 0.08 | 501.63779925734127 | C_HA0.1;C_HA1.1;C_HA2.1;C_HA3.1;C_HA4.1;C_HA5.1;C_HA6.1;C_HB0.1;C_HB1.1;C_HB2.1;C_HB3.1;C_HB4.1;C_HB5.1;C_HB6.1;C_HC0.1;C_HC1.1;C_HC2.1;C_HC3.1;C_HC4.1;C_HC5.1;C_HC6.1;C_MUX_A.1;C_MUX_B.1;C_MUX_C.1;J_WING.1;TP_W_H5V.1;U_HA0.1;U_HA1.1;U_HA2.1;U_HA3.1;U_HA4.1;U_HA5.1;U_HA6.1;U_HB0.1;U_HB1.1;U_HB2.1;U_HB3.1;U_HB4.1;U_HB5.1;U_HB6.1;U_HC0.1;U_HC1.1;U_HC2.1;U_HC3.1;U_HC4.1;U_HC5.1;U_HC6.1;U_MUX_A.13;U_MUX_B.13;U_MUX_C.13
KRT-16-2L-0100 | H_A0_RAW | signal | 10 | 2 | 0.1 | 0.1 | 0.08 | 92.29818895055195 | U_HA0.2;U_MUX_A.4
KRT-16-2L-0100 | H_A1_RAW | signal | 9 | 2 | 0.1 | 0.1 | 0.08 | 81.61370849898476 | U_HA1.2;U_MUX_A.5
KRT-16-2L-0100 | H_A2_RAW | signal | 9 | 2 | 0.1 | 0.1 | 0.08 | 80.01118318204308 | TP_H_CTR_RAW.1;U_HA2.2;U_MUX_A.6
KRT-16-2L-0100 | H_A3_RAW | signal | 14 | 0 | 0.1 | 0.1 | 0.08 | 67.30660171779822 | U_HA3.2;U_MUX_A.7
KRT-16-2L-0100 | H_A4_RAW | signal | 9 | 2 | 0.1 | 0.1 | 0.08 | 98.75218613006982 | U_HA4.2;U_MUX_A.12
KRT-16-2L-0100 | H_A5_RAW | signal | 4 | 0 | 0.1 | 0.1 | 0.08 | 47.438477631085036 | U_HA5.2;U_MUX_A.11
KRT-16-2L-0100 | H_A6_RAW | signal | 4 | 0 | 0.1 | 0.1 | 0.08 | 31.83380951166242 | U_HA6.2;U_MUX_A.10
KRT-16-2L-0100 | H_B0_RAW | signal | 17 | 8 | 0.1 | 0.1 | 0.08 | 90.00285706997455 | U_HB0.2;U_MUX_B.4
KRT-16-2L-0100 | H_B1_RAW | signal | 20 | 6 | 0.1 | 0.1 | 0.08 | 86.68355697996827 | U_HB1.2;U_MUX_B.5
KRT-16-2L-0100 | H_B2_RAW | signal | 16 | 4 | 0.1 | 0.1 | 0.08 | 90.59280656363575 | TP_H_N_RAW.1;U_HB2.2;U_MUX_B.6
KRT-16-2L-0100 | H_B3_RAW | signal | 15 | 0 | 0.1 | 0.1 | 0.08 | 66.52914139223986 | U_HB3.2;U_MUX_B.7
KRT-16-2L-0100 | H_B4_RAW | signal | 15 | 8 | 0.1 | 0.1 | 0.08 | 67.13717164502532 | U_HB4.2;U_MUX_B.12
KRT-16-2L-0100 | H_B5_RAW | signal | 11 | 0 | 0.1 | 0.1 | 0.08 | 51.698275605729684 | U_HB5.2;U_MUX_B.11
KRT-16-2L-0100 | H_B6_RAW | signal | 5 | 0 | 0.1 | 0.1 | 0.08 | 28.28061325481597 | U_HB6.2;U_MUX_B.10
KRT-16-2L-0100 | H_C0_RAW | signal | 16 | 8 | 0.1 | 0.1 | 0.08 | 103.37615433949873 | TP_H_DIAG_RAW.1;U_HC0.2;U_MUX_C.4
KRT-16-2L-0100 | H_C1_RAW | signal | 9 | 0 | 0.1 | 0.1 | 0.08 | 79.33208511739213 | U_HC1.2;U_MUX_C.5
KRT-16-2L-0100 | H_C2_RAW | signal | 32 | 6 | 0.1 | 0.1 | 0.08 | 100.84406922210653 | U_HC2.2;U_MUX_C.6
KRT-16-2L-0100 | H_C3_RAW | signal | 8 | 0 | 0.1 | 0.1 | 0.08 | 64.63208511739214 | U_HC3.2;U_MUX_C.7
KRT-16-2L-0100 | H_C4_RAW | signal | 11 | 6 | 0.1 | 0.1 | 0.08 | 63.57270555095808 | U_HC4.2;U_MUX_C.12
KRT-16-2L-0100 | H_C5_RAW | signal | 6 | 0 | 0.1 | 0.1 | 0.08 | 44.559797974644674 | U_HC5.2;U_MUX_C.11
KRT-16-2L-0100 | H_C6_RAW | signal | 4 | 0 | 0.1 | 0.1 | 0.08 | 25.4906637611548 | U_HC6.2;U_MUX_C.10
KRT-16-2L-0100 | MUX_A0 | signal | 41 | 17 | 0.1 | 0.1 | 0.08 | 169.0508801440101 | J_WING.3;TP_W_A0.1;U_MUX_A.1;U_MUX_B.1;U_MUX_C.1
KRT-16-2L-0100 | MUX_A1 | signal | 35 | 14 | 0.1 | 0.1 | 0.08 | 164.9541197284454 | J_WING.5;TP_W_A1.1;U_MUX_A.16;U_MUX_B.16;U_MUX_C.16
KRT-16-2L-0100 | MUX_A2 | signal | 37 | 12 | 0.1 | 0.1 | 0.08 | 158.20559159102152 | J_WING.6;TP_W_A2.1;U_MUX_A.15;U_MUX_B.15;U_MUX_C.15
KRT-16-2L-0100 | MUX_OUT_A | signal | 10 | 2 | 0.1 | 0.1 | 0.08 | 41.48111831820433 | J_WING.9;TP_W_MUXA.1;U_MUX_A.8
KRT-16-2L-0100 | MUX_OUT_B | signal | 10 | 2 | 0.1 | 0.1 | 0.08 | 59.12964645562816 | J_WING.11;TP_W_MUXB.1;U_MUX_B.8
KRT-16-2L-0100 | MUX_OUT_C | signal | 8 | 0 | 0.1 | 0.1 | 0.08 | 76.17350647362943 | J_WING.13;TP_W_MUXC.1;U_MUX_C.8
KRT-16-2L-0100 | WING_EN | signal | 36 | 9 | 0.1 | 0.1 | 0.08 | 163.14478348960023 | J_WING.7;TP_W_EN.1;U_MUX_A.2;U_MUX_B.2;U_MUX_C.2
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
KRT-17-2L-0100 | MUX_OUT_C | signal | 4 | 0 | 0.1 | 0.1 | 0.08 | 79.97056274847715 | J_WING.13;TP_W_MUXC.1;U_MUX_C.8
KRT-17-2L-0100 | WING_EN | signal | 28 | 7 | 0.1 | 0.1 | 0.08 | 167.78254685319163 | J_WING.7;TP_W_EN.1;U_MUX_A.2;U_MUX_B.2;U_MUX_C.2
