ihsinoky/he-piantor-42/hardware/case/issue-228-final/17mm/assembled-top.png

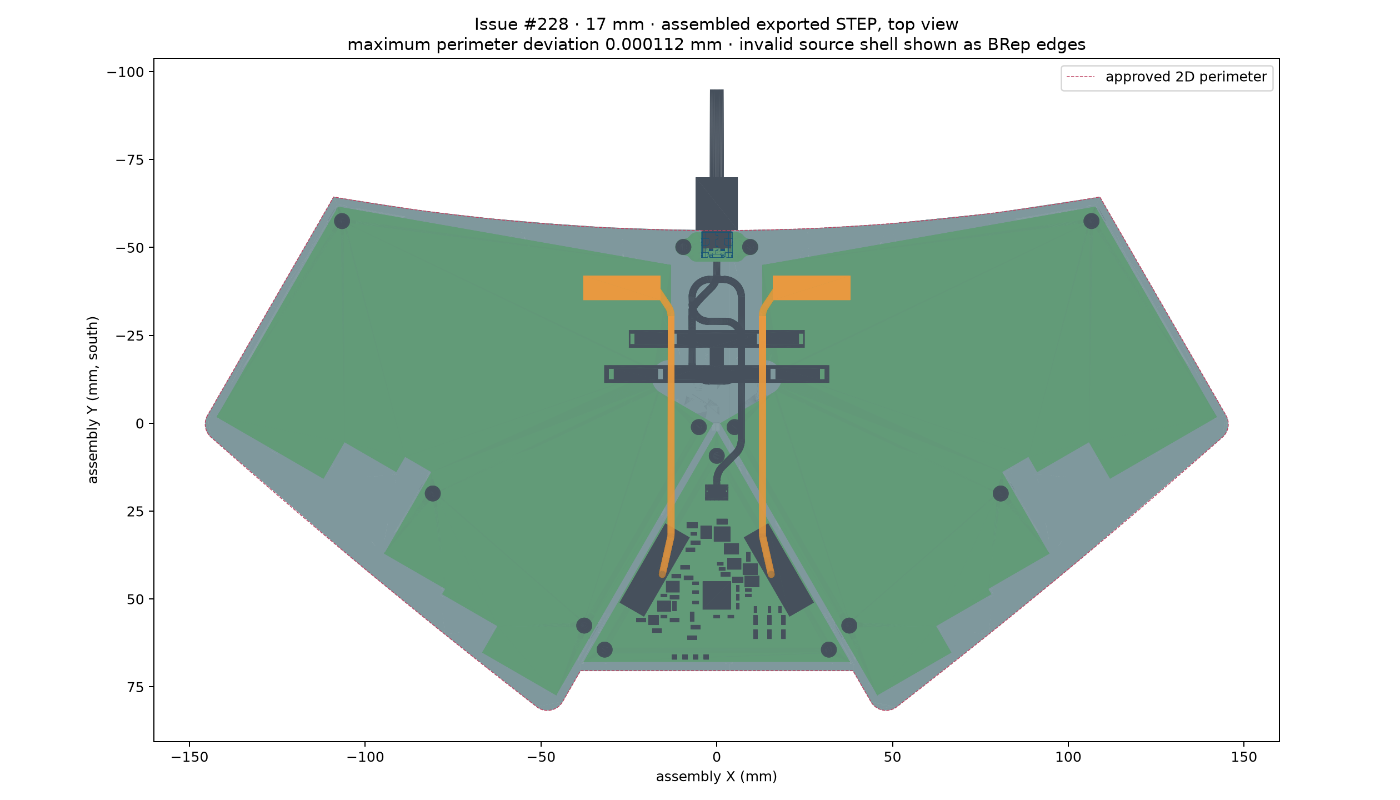
hardware/case/issue-228-final/17mm/assembled-top.png
