ihsinoky/he-piantor-42/hardware/kicad/qualification/issue-178-m1-matrix-board/manufacturing/preview-review/all-layers.png

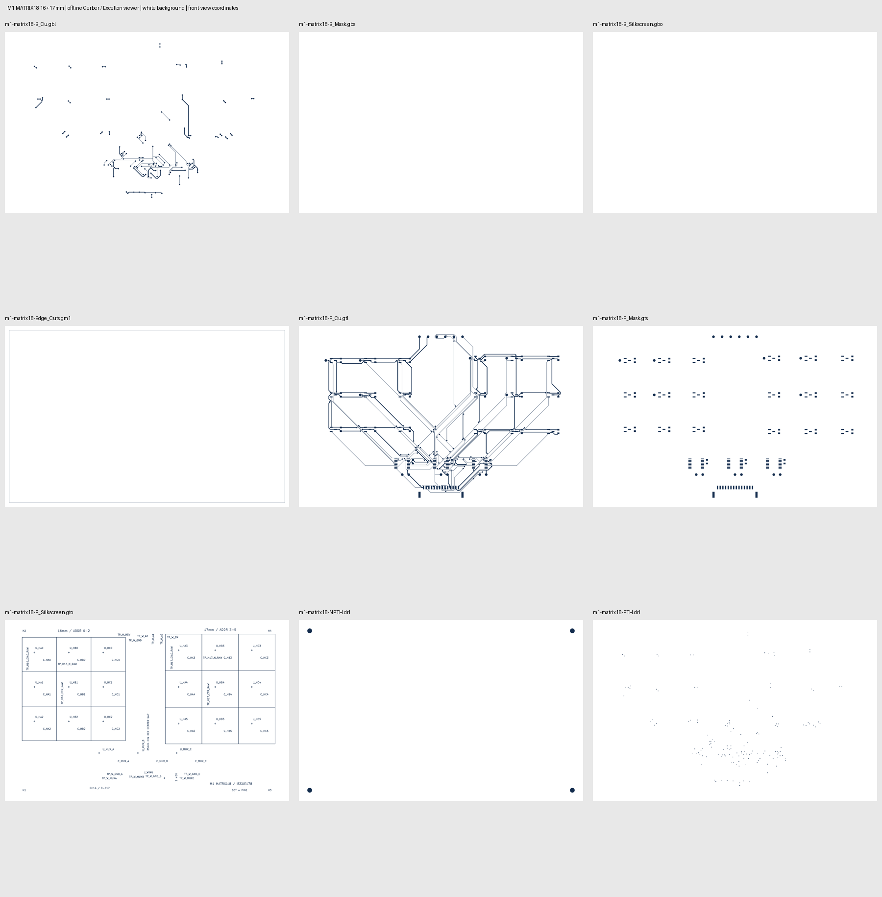
hardware/kicad/qualification/issue-178-m1-matrix-board/manufacturing/preview-review/all-layers.png
