ihsinoky/he-piantor-42/hardware/kicad/qualification/issue-221-main-rev5/manufacturing/cam-review.png

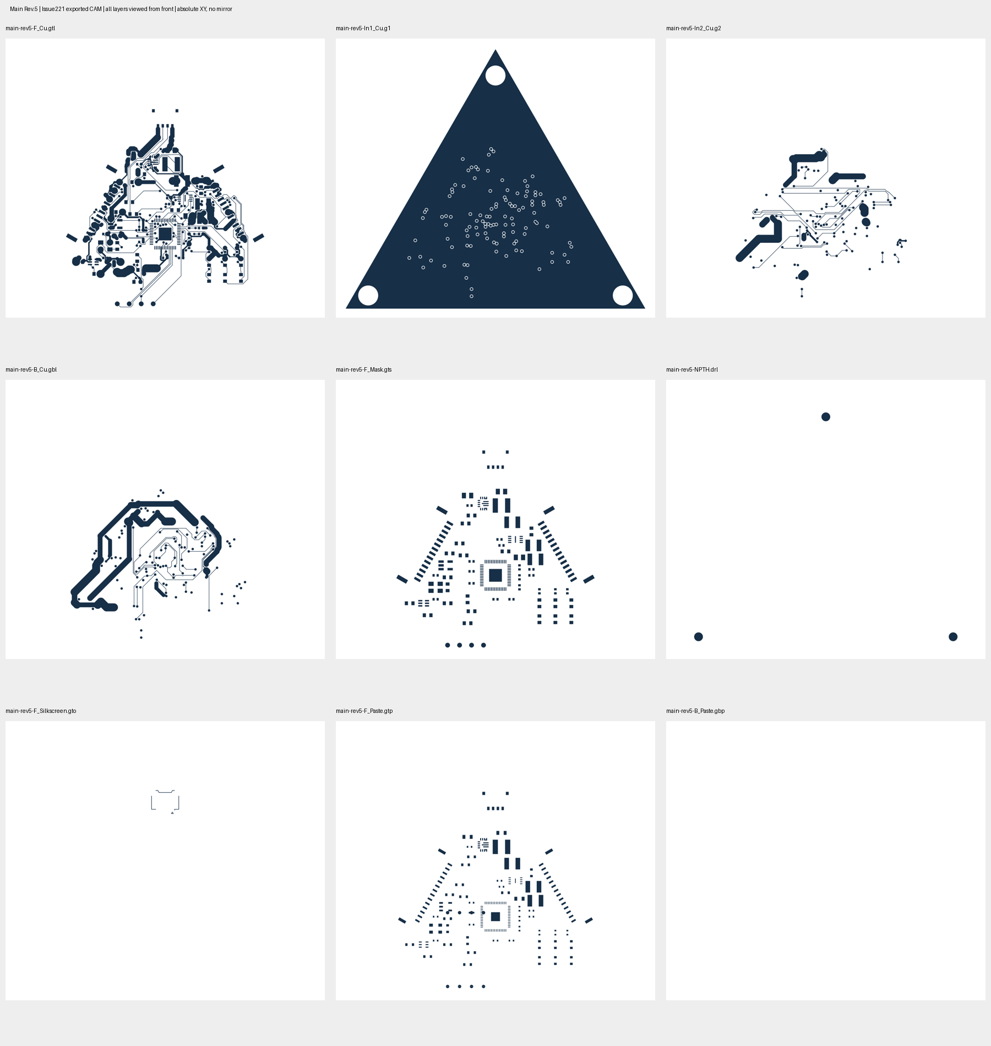
hardware/kicad/qualification/issue-221-main-rev5/manufacturing/cam-review.png
