ihsinoky/he-piantor-42/hardware/sensor-test/README.md

# Sensor evaluation board

Small Hall-effect evaluation board used to validate the selected magnetic switch, Hall sensor, analog acquisition circuit, noise, travel curve, and calibration method before releasing the 42-key PCB.
