ihsinoky/he-piantor-42/hardware/sensor-test/pinmap.csv

signal | rp2040_pin | function | sensor-test | main-board
MUX_A0 | GPIO2 | TMUX address bit 0 | used | used
MUX_A1 | GPIO3 | TMUX address bit 1 | used | used
MUX_A2 | GPIO4 | TMUX address bit 2 | used | used
MUX_EN0 | GPIO5 | Hall mux bank 0 enable | used | used
MUX_EN1 | GPIO6 | Hall mux bank 1 enable | reserved | used
HALL_PWR_EN | GPIO7 | TPS22919 Hall rail enable | used | used
LAYER_R | GPIO8 | Layer RGB red | reserved | used
LAYER_G | GPIO9 | Layer RGB green | reserved | used
LAYER_B | GPIO10 | Layer RGB blue | reserved | used
STATUS_LED | GPIO11 | Evaluation status LED | used | reserved
ADC_A | GPIO26/ADC0 | Hall mux group A ADC | used | used
ADC_B | GPIO27/ADC1 | Hall mux group B ADC | reserved | used
ADC_C | GPIO28/ADC2 | Hall mux group C ADC | reserved | used
VBUS_SENSE | GPIO29/ADC3 | Optional USB/Hall rail diagnostic | reserved | reserved
USB_DP | USB_DP | USB device D+ | used | used
USB_DM | USB_DM | USB device D- | used | used
SWDIO | SWDIO | Debug | used test pad | used test pad
SWCLK | SWCLK | Debug clock | used test pad | used test pad
RUN | RUN | Reset | used button/test pad | used button/test pad
