ihsinoky/he-piantor-42/hardware/kicad/qualification/issue-93-freerouting-v250-jar/evidence/verification.txt

PASS: new run artifact hashes, fixed inputs, baseline raw/SES/settings hashes, official distribution digests, conditional gates, null metrics, document links, existing tracked files unchanged.
