ihsinoky/he-piantor-42/hardware/kicad/qualification/issue-115-kicad-routing-tools-escalation-off/README.md

# Issue #115 qualification evidence

Report: [KRT escalation off](../../../../docs/issue-115-kicad-routing-tools-escalation-off.md).

`evidence/assessment.json` records the failure: independent DRC found 28 opens on 24 nets; all 554 saved tracks measure 0.20mm; output project adds min_via_drill=0.3. The four Main metrics are null as required. The pre-route equivalence and configuration gates, exactly one smoke/Main run, raw outputs, original-rule inspection, and complete project differences are retained. No tool runtime is included.
