ihsinoky/he-piantor-42/hardware/kicad/qualification/issue-105-fab-router-detailed/README.md

# Issue #105 fab_router detailed evidence

See [analysis](../../../../docs/issue-105-fab-router-detailed.md). All submitted files are additions. Main had one infrastructure-interrupted attempt and one recovery execution; exactly one completed run. See recovery-preflight.json and the analysis. Dependency packages and binaries are excluded.
