ihsinoky/he-piantor-42/docs/issue-196-main-rev4-phasea2.md

# Issue #196 — Main Rev.4 Phase A-2：UDB 分離・三角形配置案

**16／17mm 共通の三角形 75.785364×65.632051mm に、既存 58 部品＋UDB 用 JST 1 個と3点穴を配置できる。** これは以下に定義した Wing 配置 datum と2D包絡による実配置の成立例である。Wing 用100mmハーネスは本配置に届かず、200mm候補への変更と電源再評価が必要。ケース南辺にも約4mmの入力間不整合があるため、PMO が条件を確認してから次段へ進む。

指示書 `.issue196-runtime/instructions-196-phaseA2.md` を全文読了し、[Issue 本文](https://github.com/ihsinoky/he-piantor-42/issues/196)と[スコープ改訂コメント](https://github.com/ihsinoky/he-piantor-42/issues/196#issuecomment-6698835609)を確認した。作業は `.issue196-runtime/git` の `issue-196-main-rev4`。Phase A の[旧報告書](issue-196-main-rev4.md)・データを保持し、今回はその面取り・J1固定・J2/J3中心化の結論を適用しない。配線・回路図・製造元基板は編集していない。push は PMO が行う。

## 入力と成果物

- Main Rev.3：`hardware/kicad/qualification/issue-185-main-rev3/inspection/final/main.kicad_pcb`、SHA256 `0e81ba42b194e03fb0422b58a64c967fe83166d0495d84f28c4171184b665bae`。66 footprint（電気部品62、穴4）。Phase A の L1/C26/TP2 影響情報を、全面再配置の入力として参照した。
- Wing：[PR #195](https://github.com/ihsinoky/he-piantor-42/pull/195)、commit `f9084be93faf3defdff3bb3b76e1db1edfe49976` の Phase A definition 4種と報告書を byte 保存。17mm は123.2×87.0、16mm は117.2×83.0。Stage 1 の全キー中心・親指角度・サービス配置を保持する。
- UDB C3：[公開設計](https://github.com/Unified-Daughterboard/UDB-C-Legacy/tree/2ecdd7e0482ecbd3ffe9af04966ab3555f7fc33c/KiCad/C3)の基板とBOM、ライセンスを保存。これは PO 所有 C3 の指定に従う入力である。

証跡ディレクトリ E は [hardware/kicad/qualification/issue-196-main-rev4-phasea2/](../hardware/kicad/qualification/issue-196-main-rev4-phasea2/README.md)。[geometry-plan.json](../hardware/kicad/qualification/issue-196-main-rev4-phasea2/geometry-plan.json) が配置・外形の正であり、全59部品のXY・回転・元位置・pin-net・232 padの実形状／座標、Wing全キーの組立変換、穴、ハーネス経路案を収録する。[placements.csv](../hardware/kicad/qualification/issue-196-main-rev4-phasea2/placements.csv) は同じ部品配置の一覧。図は[組立配置](../hardware/kicad/qualification/issue-196-main-rev4-phasea2/assembly-proposal.svg)と[Main拡大](../hardware/kicad/qualification/issue-196-main-rev4-phasea2/main-placement.svg)。図の橙破線は経路案であり、実ケーブル包絡ではない。

## 三角形の導出

### 120°配置の定義

組立座標は上面視、X右、Y南、mm。左 Wing のローカル座標は PR #195 の X右／Y北をそのまま使う。右は元の右専用definitionを使い、キー配置を変更しない。KiCadへ渡す際の提案変換は `X_K=100+X, Y_K=70+Y`。角度は KiCad の実回転であり、パッド／端子番号を鏡像にしない。

120°だけでは Wing の平行移動・南辺位置は決まらない。以下を**追加の機械設計提案**として明示する。完成イメージv4の独立した寸法付きCADは今回の入力にはないため、これを既承認寸法とは扱わない。

1. 「内側辺」は、左のローカル東辺／右のローカル西辺（矩形の短辺、高さ83／87mm）と定義する。
2. 両 Wing の内側北角を組立 `(-1,0)`／`(+1,0)` に合わせる。北角間隙 `g=2.0mm` は中央寄せの提案値。ピッチ変更時は基板全体をこの datum に合わせ、ローカルキー座標を維持する。
3. 左 Wing をローカルX右／Y北系で−30°、右を＋30°回す。外向き軸は組立 `(-√3/2,-1/2)`／`(+√3/2,-1/2)` なので内積−1/2、なす角は120°となる。

`c=√3/2`、左ローカル内側辺 `x=a`、北辺 `y=b` とすると、左の変換は次式。右は左右を実座標で鏡映対応させた剛体回転で、JSONに左右それぞれの行列・平行移動を保存した。

```text
X = -g/2 + c(x-a) + (y-b)/2
Y =        (x-a)/2 - c(y-b)
16mm: a=60.1, b=49.2, y_min=-33.8
17mm: a=63.1, b=51.2, y_min=-35.8
左内側辺:  cX + Y/2 + cg/2 = 0
右内側辺: -cX + Y/2 + cg/2 = 0
```

| ピッチ | 左内側辺・北端 | 左内側辺・南端 | 左 Wing J1／J_WING | スイッチ包絡の組立南限 Y |
| --- | --- | --- | --- | ---: |
| 16mm | −1,0 | −42.5,71.880109 | −121.191067,13.977034 | 67.924034 |
| 17mm | −1,0 | −44.5,75.344210 | −124.789143,14.209085 | 71.415913 |

右はX符号反転。辺の式は両ピッチで完全に同じになり、有限長だけが変わる。

### クリアランスと頂点

Wing PCB と Main 斜辺の法線間隔を **2.0mm** とする。これは回転配置・ケース公差・作業余裕への設計提案であり、壁厚やケーブル曲げの保証値ではない。係数の法線長が1なので、Main は `±cX+Y/2+cg/2≥2` の共通内部となる。頂点Yは `Y_t=2(2−cg/2)=2.267949192`。

南辺は「ケースをスイッチ包絡へ詰める」入力に合わせ、両ピッチの南限の小さい方を越えない0.1mm格子の `Y_b=floor(67.924034×10)/10=67.9` を共通採用する。ケース内面のスイッチ包絡余裕は別途0.25mmを提案する。Main のためにケース南辺をさらに伸ばす案にはしない。

| 頂点（時計回り） | 組立 X,Y mm | 提案 KiCad X,Y mm |
| --- | --- | --- |
| 北 | 0,2.267949192 | 100,72.267949192 |
| 南東 | 37.892682201,67.9 | 137.892682201,137.9 |
| 南西 | −37.892682201,67.9 | 62.107317799,137.9 |

`半底辺=(Y_b−Y_t)/√3=37.892682201mm`。高さ65.632050808、底辺75.785364402、面積2486.974443465mm²。左右鏡像対称、北頂角60°。Main の斜辺全長は約75.785mmで、Wing の有限内側辺の範囲内に投影される。

| 全PCB多角形での検証 | 16mm 左／右 | 17mm 左／右 |
| --- | ---: | ---: |
| Main → Wing 最小距離 | 2.000000mm | 2.000000mm |
| Main 南辺 → スイッチ南限の北への引込み | 0.024034mm | 3.515913mm |
| PCB重複 | 0 | 0 |

共通datumを維持する限り、Main の外形・穴・部品はピッチ変更に依存しない。Wing の平行移動datum、回転角、ケースを変更した場合まで不変と主張するものではない。

**ケース南辺の入力制約**：Wing の矩形南内角はスイッチ包絡の全体南限より16mm版で3.956075mm、17mm版で3.928297mm南へ出る。従って「ケース全体の一直線の南辺をスイッチ南限＋0.25mm」とすると、既承認の矩形 Wing PCB がケースを越える。中央 Main 前面を詰め、Wing角付近だけケース輪郭を逃がす案なら共存の余地がある。全南辺を詰めるには Wing 外形改訂等の別判断が必要であり、今回は Wing／ケースを変更しない。PCB とケース壁厚・支持物を含む成立は PMO の未決事項とする。

## 実配置と配置可能性

Rev.3 のネイティブ footprint をRAM上で実回転・移動した。オンボードUSB-C J1、CCのR1/R2、データESD U2を除き、**他58部品を全数保持**した。JST J4は C3 の実 footprint を読み取って追加した。R3/R4（27Ω）はRP2040側のUSB終端として保持し、ESD移管を理由に削除しない。J4のpin2/3を旧 `USB_DM_ESD`／`USB_DP_ESD` へ割り当てる提案で、名称整理・回路図反映は次段とする。

| 機能／部品 | 組立位置 mm | 配置上の扱い |
| --- | --- | --- |
| RP2040 U1 | 0,49 | 7×7本体と実パッド、デカップリングを周囲に配置 |
| Flash U3 | 5,40 | 2×3本体と実パッドを含める |
| TPS63070 U6 | −3,31 | 3×3の保守側本体予約、実パッドは保持 |
| インダクタ L1 | 1.5,31.5 | 4×4本体予約、SW1/SW2近傍 |
| C23/C24/C25 | −7,29／1.5,28／−6.5,31.5 | 入力・VAUX周辺 |
| C26/C27/C28 | 4.2,35.7／9.5,41.5／10,45 | 1210出力部品を小型化せず収容 |
| U4／U5 | −12.5,46.5／−18,56 | 3.3V／給電スイッチ、周辺C・Rも保持 |
| Y1／C1／C2 | −15,52／−15,55／−15,49 | 水晶と負荷Cを同じ島に保持 |
| MUX EN・ADC系 R/C | 全座標はCSV | R6–R16等を保持。D-024 pin-netは変更しない |
| TP1–TP4 | X=−12,−9,−6,−3、Y=66.5 | 南辺にプローブ位置を確保 |

保持部品の値・pin-net一致を全数assert。サイズ不足はこの2Dモデルでは **0mm²**、部品小型化は不要。配置包絡の面積合計は808.201923mm²（基板の約32.50%、GHサービス域・JSTアクセス域を含む）。空き面積は配線の成立証明ではない。

検証は全59部品1711組、232 pad、3穴、Wing両ピッチ×左右について実施した。

| 検査 | 最小値／結果 |
| --- | ---: |
| 部品・サービス包絡同士 | 0.300000mm、重複0 |
| 包絡 → Main 外形 | 0.442632mm |
| 実パッド → Main 外形 | 0.800000mm（要求0.20mm以上） |
| 全パッドが各自包絡に包含 | 全件合格 |
| 3穴のボス → 外形 | 1.196152mm以上 |
| 元の製造基板SHA256 | 不変 |

**2D包絡の精度**：Main 元データにはFab／courtyard／3D形状が無い。受動部品は実パッド外接、主要IC・水晶・L1は上表等の本体寸法の矩形と実パッドの外接を合わせ、0.15mm外側へ拡張した。これはメーカー公差付き最大外形ではない。GHは既存26×8サービス予約、SHはC3実パッド＋幅7.3mm・挿入口前方5mmの予約を使う。形状値はJSONに記録した。高さ、最大公差、実ラッチ、挿抜工具、リフロー、ノイズ・放熱・配線余裕は未認定。特にC27/C28の移動後の出力ループとRP2040デカップリングは Phase B 前の電気配置レビュー対象である。

さらに配線に空間が必要になった場合、現在は南西／南東内部に空きがあり再配置を先に検討できる。南辺を伸ばすと16mmのコンパクト条件を破る。斜辺間隔を2→1mmに減らす場合は高さが2mm・底辺が約2.309mm増えるが、機械余裕が減る。Wing北角間隙を広げれば三角形は広がるが製品幅も増える。どれも本案には採用せず、TPS63070級／1210の小型化を前提としない。

## J2／J3 とハーネス

| 部品 | 組立 native `at` | KiCad角度 | 長手軸／ケーブル外向き単位ベクトル |
| --- | --- | ---: | --- |
| J2 左 | −15.5,43 | −120° | 斜辺に平行／(−0.866025,−0.5) |
| J3 右 | 15.5,43 | +120° | 斜辺に平行／(+0.866025,−0.5) |

BM14B-GHS-TBT(LF)(SN)を保持する。pin1を含む全padを実回転し、端子番号や電気契約を鏡像化しない。26×8予約域は斜辺から最小0.442632mm内側。外向きベクトルは各Wing側を向く。

**この品番は上面嵌合（+Z）のため、水平横出しコネクタとしては扱えない。** 本案は斜辺に沿って配置し、上面から嵌合後にケーブルを各Wing側へ曲げる案である。「斜辺から横向きに直接挿す」という要求なら既存品種のまま成立とは言えず、GH14品種変更の別判断が必要。ケース内高さ、曲げ半径、着脱の3D検証は残る。

Wing 側 J1 は PR #195 のサービス配置（左ローカル−37,−23、右+37,−23、26×8予約、上面嵌合）を使用する。

| ピッチ（左右同値） | native datum間直線 | 南内角・南辺経由の折れ線案 | ＋30mmの仮余長 |
| --- | ---: | ---: | ---: |
| 16mm | 109.603532mm | 147.435562mm | 177.435562mm |
| 17mm | 113.017846mm | 156.341316mm | 186.341316mm |

折れ線は `Main→Wing南内角→Wing南辺のJ1投影点→J1`。ケーブルのZ空間やエッジ回避を含む実経路ではなく、30mmも曲げ・高さ等への設計割当である。両ピッチ共通候補を **1:1 GH14、200mm×2本** とする。180mmでは17mm側の上記割当が足りない。既存の100mm契約は両ピッチで直線さえ満たさないので、継承可能としない。200mmの採否・線径・抵抗・供給・ADCノイズを PMO へ戻す。倍長による給電降下を旧50mΩ／4.60V判定へ流用しない。

## UDB 接続

[C3公開BOM](https://github.com/Unified-Daughterboard/UDB-C-Legacy/blob/2ecdd7e0482ecbd3ffe9af04966ab3555f7fc33c/Production/C3/BOM/Unified-Daughterboard_bom_C3.csv)はJ2を **SM04B-SRSS-TB(LF)(SN)** と指定している。[C3向けPCB側資料](https://github.com/Unified-Daughterboard/UDB-C-Legacy/wiki/PCB-side-design-resources)にも同型番と1:1ケーブルの指定がある。Wikiはアーカイブなので、pin番号と実パッド位置は保存したC3基板からも照合した。保護機能の移管は[C3設計説明](https://github.com/Unified-Daughterboard/UDB-C-Legacy/tree/2ecdd7e0482ecbd3ffe9af04966ab3555f7fc33c)のESD／PTC／TVS／CCに基づく。

Main J4の第一候補は同型の水平嵌合4pin・1.0mmピッチ品。ケーブル側候補はSHR-04V-S＋SSH-003T-P0.2（[JST SH資料](https://www.jst.com/wp-content/uploads/2021/01/eSH.pdf)参照、発注品の線径・圧着適合・図面は次段で確認）。電気1:1であることを端子番号で保証し、販売上の「reverse」表記だけでは判断しない。

| J4 pin | C3 net | Main割当 |
| --- | --- | --- |
| 1 | VCC | VBUS（C3保護後） |
| 2 | DA− | USB_DM_ESD → R4 → USB_DM |
| 3 | DA＋ | USB_DP_ESD → R3 → USB_DP |
| 4 | GND | GND |

Main J4は **(0,20)、180°**、挿入口を北へ向ける。C3実 footprint の原点は信号列中心ではなく挿入口側で、元の信号padは局所Y=−4.775mm。180°後の信号列Y=24.775mm。元原点を取り違えず、パッド・固定ランド全数を使った。幅7.3mm、挿入口前方5mmを含む予約域が三角形内に収まる。

UDB のケースdatumは未確定なので、検討用に **C3側J2=(0,−20)、0°** を提案する。C3 PCB外接は X=−9…9、Y=−36.25…−19.75（18×16.5mm、USB部品の突出は別）。両ピッチWing PCBまでの最小距離は13.104002mm。この配置ならJ4–C3 J2の直線40mm＋仮余長30mmに対して **100mm SHケーブル** を候補とする。北のH1を避ける横逃げ・上方の実経路とケースUSB開口を確認し、実datum変更時は長さを再計算する。UDBの固定穴・USBプラグ・シールド／筐体接地は未設計であり、ケース設計を本Phaseで確定しない。

## 新設3点穴と D-023 改訂草案

旧穴H1–H4を転用せず、下記3点で支持する。旧H4を廃止し、NPTH φ2.2、ボス最大φ4.5、全4銅層のtracks／via／ベタ禁止を継承する。公差を吸収する全層予約は直径5.0004mm（公称5.0mm）とする。パッドは別検査が必要。

| 穴 | 組立 X,Y mm | ボス→端 mm | ボス→部品包絡 mm |
| --- | --- | ---: | ---: |
| H1 北 | 0,9.267949192 | 1.250000 | 3.482051 |
| H2 南西 | −31.892682201,64.4 | 1.196152 | 9.656688 |
| H3 南東 | 31.892682201,64.4 | 1.196152 | 10.385136 |

ボス→将来銅箔は予約半径2.5002−ボス半径2.25=0.2502mmを要求する。これは将来の配置・配線契約であって、旧ベタが適合するとの判定ではない。ボス／座金径、ねじ・締結・たわみはケース側レビュー待ち。

> PMO 採択を条件に、Main Rev.4 の D-023 は上記3穴へ置換し、旧H4を廃止する。旧 Rev.3 の穴は変更しない。D-025／Phase A の矩形・面取り案は本三角形へ、D-022 のオンボードJ1方針はUDB C3＋Main J4へ置換する草案とする。D-024の電気的骨格・GH14 pin割当を保持するが、100mmハーネスは本案と両立しないため長さ改訂を別途採択する。D-019と再認定条件は継承する。

草案は本書内に留め、`decisions.md`・D-033・project-status は更新しない。

## BOM と外接寸法・コストの見通し

| 区分 | Main BOM差分／組立差分 |
| --- | --- |
| 廃止 | J1 TYPE-C-31-M-12×1、R1/R2 5.1k×2、U2 USBLC6-2SC6×1（計4部品） |
| 追加 | J4 SM04B-SRSS-TB(LF)(SN)×1 |
| 保持 | R3/R4 27Ω、RP2040、TPS63070と全周辺、U4/U5、MUX EN、GH14×2、水晶、全TP等58部品 |
| Main数量 | 電気部品62→59（−3）、穴4→3、footprint総数66→62 |
| 製品側追加 | PO在庫のUDB C3×1、SH 4芯1:1ケーブル候補100mm×1（C3搭載部品はMain BOMに二重計上しない） |
| 変更候補 | GH14ハーネス100→200mm×2。Main支持3点へ変更、UDB支持は別 |

| PCB項目 | Rev.3 | 本案 |
| --- | ---: | ---: |
| 外接幅×高さ mm | 48×52 | 75.785364×65.632051 |
| 外接面積 mm² | 2496 | 4973.948887（＋99.276798%） |
| 実外形面積 mm² | 2496 | 2486.974443（−0.361601%） |

前Phase Aの面取り面積2435mm²からは約51.974mm²増える。実三角形の面積がほぼ同じでも、外接寸法で価格が決まる本Issueの比較条件では**安価になるとは言えず、Main基板サイズ入力はほぼ倍**になる。層数4・板厚1.2mmは維持する。価格倍率は面積倍率から算出しない。J1等のPCBA費減、JST追加、長いハーネス、UDB在庫の扱いを含む製品総額と、Rev.3の$122.29との差は未見積。製造データと見積はPhase Bで扱う。

## 検証・Phase Bへの引継ぎ

KiCad 9.0.9／Shapely 2.2.0で実パッド形状（ERROR_OUTSIDE、10nm許容）を抽出した。再生成と、標準ライブラリだけの独立幾何検算（凸多角形の分離軸判定、点線分距離、Wing変換の再計算）を実施した。再現手順・全数結果は E のREADMEと `verification.json`。これは製造DRC、無配線数、実電源抵抗の検証ではない。

PMOで確認すべき点は、内側北角datum／2mm間隙／2mm斜辺余裕と南辺、ケースのWing角突出、GHの上面嵌合とケーブルZ経路、200mmハーネス候補、UDB位置・100mm SH、3点支持、コスト増の許容である。3D最大包絡・公差確認を残した条件付きの配置提案としてレビューする。

PMO GO後に引き継ぐ事項：

1. 回路図でJ1/R1/R2/U2を除去しJ4を追加、USB系列net名と保護の移管・CCの重複なし・1:1 pin順を確認。保持したR3/R4の位置とUSB差動経路、ESD経路をレビューする。
2. 本案の部品・外形・3穴予約をネイティブ設計へ実装し、電源／水晶／デカップリングの局所配置を電気的に調整する。単に空きがあることをループ最適化と扱わない。
3. D-019（4層1.2mm、0.10/0.10mm、via 0.60/0.30mm、In1 GND専用）で全面再配線。必須未接続、異ネット接触、物的違反、説明不能転送差分の4指標を全0に再認定する。
4. 共通・各分岐≤50mΩ、最遠点4.60V @127mA/Wingの再抽出。C3 PTC・SHケーブル・コネクタ・延長GHハーネスを含むVBUS／給電条件を定義し、従来の抵抗値を流用しない。未達時の線径・経路・配置変更を報告する。
5. 全via–全pad（同ネット・TP含む）間隔≥0.10mm必須、最小目標≥0.12mm。全層穴予約と実銅箔ボス余裕、POFV不要条件、CAM、BOM/CPL・新見積を再確認する。
6. 必要なD-022/D-023/D-025/D-024変更とD-033・改訂表を採択結果に合わせて整理する。旧Rev.3資格を流用しない。

本Phaseではルータ起動、配線編集、zone再fill、製造データ生成、発注、pushを行っていない。

**Phase A-2 はここで停止し PMO レビュー待ち**
