ihsinoky/he-piantor-42/docs/issue-188-case-crosscheck.md

# Issue #188 — Main Rev.3 発注前確認：筐体 Stage 1 データとの照合

**発注ブロッカーとして確定した項目はない。ただし「問題なし」ではない。** 5項目の判定は OK 2／要注意 2／判定不能 1 で、実物でしか決まらない事項（J3 の支持、GH ラッチ、部品高さ、ハーネス経路）が残る。基板の電気的合格（DRC 4指標等）は機械的適合の証明に使っていない（#150 の原則）。発注・課金・基板改版・筐体 CAD は行っていない。

証跡：[hardware/case/issue-188-crosscheck/](../hardware/case/issue-188-crosscheck/)（`extract.py`、`extracted.json`、`wing-keys-check.csv`、再現手順 README）。以降の「抽出」はこのスクリプトの出力。

値の区分：**設計値**＝基板データからの抽出、**公表値**＝メーカー資料・docs 記載の寸法、**実測待ち**＝実物でしか決まらない事項。

## 判定一覧

| # | 項目 | 判定 |
| --- | --- | --- |
| 1 | 取付穴 H1〜H4 と φ4.5 ボス制限案 | **OK**（幾何。公差・締結は実測待ち） |
| 2 | J3 付近支持の構造的可能性 | **要注意**（不可能とは言えないが、成立は実物確認まで言えない） |
| 3 | 差分表（Stage 1 前提 vs Rev.3） | **要注意**（部品最大高さは **判定不能**） |
| 4 | Wing Rev.1 製造データと #150 計測 | **OK**（右形状は **判定不能**） |
| 5 | D-017 100mm ハーネスの取り回し | **判定不能** |

干渉チェック（PO 追加要件）の結果は末尾の「干渉チェック」節：ボス包絡 干渉なし／J3 支持 要注意／GH ハウジング 要注意（ラッチ 判定不能）／**J1 USB-C フルサイズプラグ 干渉あり**／Wing 板 干渉なし（移動包絡 判定不能）。
## 入力

- Main Rev.3：`hardware/kicad/qualification/issue-185-main-rev3/inspection/final/main.kicad_pcb`（SHA256 `0e81ba42…bae`）、`manufacturing/gerber/main-stage2-Edge_Cuts.gm1`・`main-stage2-NPTH.drl`、`main-bom.csv`。`geometry-check.json` の基板 hash と一致を確認。
- Wing Rev.1：#151 で確定した `hardware/kicad/qualification/issue-149-wing-silkscreen/{16mm,17mm}/`（改版 SILK-149A、`docs/project-status.md` の「Wing board Rev.1」）と `wing-{16,17}mm-silk149-review.zip`。
- #150：`hardware/case/issue-150-stage1/`（`measurements.json`、`keys-*.csv`、`inputs/issue149-interface.json`）。
- 決定記録 D-017／D-023／D-024／D-025、#160／#163／#175 の文書。

## 1. 取付穴 H1〜H4 — OK

| 確認 | 結果 | 区分 |
| --- | --- | --- |
| 座標 | H1(79,92) H2(121,81) H3(79,119) H4(102,111.5)。D-023 と完全一致 | 設計値 |
| 穴径 | 4穴とも φ2.2。ネイティブ基板と Gerber／NPTH ドリルで一致（NPTH 計6＝H1〜H4＋J1 の φ0.65×2） | 設計値 |
| φ5.0 予約 | 4つの keepout が F.Cu／In1.Cu／In2.Cu／B.Cu 全層、tracks・vias・copperpour 禁止、頂点半径 2.5002mm | 設計値 |
| 外形 | 76–124／70–122＝48×52。穴は新しい北端の増設（Y70–78）とは無関係に D-023 座標のまま保持 | 設計値 |
| 外形端→穴中心 | H1／H2／H3 は東西端から 3.0mm、H4 は南端から 10.5mm | 設計値 |
| φ4.5 ボス（半径2.25）の端残り | H1／H2／H3：0.75mm、H4：8.25mm | 設計値 |
| φ4.5 ボス→φ5.0 予約の半径余裕 | 0.25mm（全穴） | 設計値 |
| 穴中心→最近傍パッド端 | H1：3.775（R1）、H2：6.410（J3）、H3：8.410（TP1）、H4：3.650（J2）mm。ボス縁まで 1.52／4.16／6.16／1.40mm、予約縁まで 1.27／3.91／5.91／1.15mm | 設計値 |

φ4.5 以下の制限案（D-023）と整合する。H1／H2／H3 は端から 3.0mm なので、ボスの端残りは 0.75mm（φ4.5 前提）。下面は全部品が F.Cu のため（抽出：全66フットプリントが F.Cu）、下面はんだ・ボスの干渉要因は J1 の PTH 脚と via のみ。via は予約で排除済み。

**実測待ち（本項では判定しない）**：製法ごとの穴位置・外形公差、ねじ・座金の実寸、締付けトルクと基板・樹脂のクリープ、4穴の非矩形配置の支持剛性。#163 の試作寸法案（POM φ4 座金・ボス）は仮案で市販品仕様ではない。

## 2. J3 付近支持 — 要注意

| 確認 | 結果 | 区分 |
| --- | --- | --- |
| J3 | (105,73)、0°。パッド範囲 X94.525–115.475／Y72.15–77.75。北端（Y70）から 2.15mm | 設計値 |
| H1〜H4 の凸包 | 4頂点 H1→H2→H4→H3、面積 846.5mm²（基板 2496mm² の 34%） | 設計値 |
| J3 と凸包 | パッド角72点中0点が凸包内。凸包までの距離 **4.54〜14.75mm**。北端 H1–H2 辺からは原点で 11.79mm | 設計値 |
| J3 に最も近い穴 | H2、パッド端まで 6.41mm。北張出し部（Y70〜約85）に穴は無い | 設計値 |
| J1／J2 も凸包の外 | J1：3.61〜12.13mm、J2：3.34〜20.57mm（D-023 が既に認めた状態） | 設計値 |
| GHR-14V-S | 幅18.75・奥行4.15・高さ5.7mm、上挿し組立高さ参考 7.3mm。ヘッダ BM14B は幅20.75・奥行4.25・高さ4.05、嵌合時 5.7 | 公表値（JST、docs/issue-160・150 経由） |
| ハウジング投影（本体中央合わせの仮定） | X95.625–114.375／Y73.25–77.4 | 設計値（仮定。実ラッチ datum は不明） |
| 支持に使える面 | 下面は全域に部品なし。J3 の東側（X115.5–124／Y70–79）と北側ストリップ（Y70–72.15）に部品なし。ただし X90–120／Y85 未満の範囲に via が16個あり、J3 本体投影の直下（Y74.5 の列）にも並ぶ（リブは絶縁材なので可否は未判断） | 設計値 |
| 従来サービス矩形 26×7.5（X92–118／Y71.5–79）との干渉 | **C26（1210）の東側パッド（X93.025–94.175／Y76.75–79.65）が矩形に 1.15×2.25mm 食い込む**。ハウジング投影までは 1.45mm。L1（4×4 インダクタ）のパッドは矩形から 0.5mm 以内。矩形内の他の部品はなし | 設計値 |

**判定の理由**：J3 は支持ポリゴンから 4.5〜14.7mm 張り出し、ねじ固定点は近傍に無い。したがって J3 周辺の支持は「ケース側が基板下面・端部に接して荷重を受ける」方式にならざるを得ない。基板側にはそのための面（下面・北／東の部品なし帯）が残っているため、構造的に不可能とは言えない。一方、成立を言える根拠は無い：

- 挿抜力（実測待ち）、J3 北端張出しの剛性・ひずみ、上下拘束支持の必要荷重の入力が無い。
- GH ラッチの当たり面・移動量・指／工具の包絡が未取得（#163 の未成立点を継承）。
- #163 は「サービス矩形を縮めず維持」と記録したが、その後 #175 で確定した C26 は矩形に食い込んでいる。1210 の最大高さ（公表値未収集）と、ラッチ操作に C26 の空間が要るかは実物確認が要る。

「J3 を筐体が支える」要件（#150 に不在）に対する本基板の答えは、**基板改版なしで成立する余地はあるが、実物の挿抜・支持試験を経るまで OK とは言えない**。

## 3. 差分表 — 要注意（高さは判定不能）

| 項目 | Stage 1 前提（#150） | Rev.3 実データ | 差 |
| --- | --- | --- | --- |
| 外形 | 48×44（X76–124／Y78–122）、面積 2112mm² | 48×52（X76–124／Y70–122）、2496mm² | 北へ +8mm、+18.2%。D-025 どおり |
| 取付穴 | なし（J1 の φ0.65×2 のみ） | H1〜H4（φ2.2 NPTH）＋J1 の φ0.65×2 | +4 穴 |
| J1（USB-C） | (85,81) | (85,81) | 差なし |
| J2（GH14） | (110,116) | (110,116) | 差なし |
| J3（GH14） | なし | (105,73)、0° | 追加 |
| 部品数 | 49 | 66 | +17：C23〜C28、L1、R16〜R19、U6、J3、H1〜H4。**既存部品の移動・削除・値変更は0** |
| 最大部品高さ | 数値なし | **判定不能** | 下記 |

**J1 の USB 窓（要注意）**：Stage 1 は「北側外周に窓」と記録している。J1 位置は不変だが北端が 8mm 北へ移ったため、J1 パッド北端（Y79.15）は端から 9.15mm 内側になった（旧外形では端から 1.15mm）。USB プラグを受ける開口が壁から 8mm 以上奥まる。USB-C 開口面の座標・向きは基板データ（フットプリントはパッドのみ、3D モデル・Fab 外形なし）に無く、北向きは Stage 1 の記述に基づく推定。ケース側に奥行き約 9mm 以上の USB 用トンネルが要る見込みで、プラグ先端（外装）の実寸確認が必要。

**部品最大高さ（判定不能）**：`main-bom.csv` に高さ欄はなく、フットプリントに 3D モデルも無い。公表値のある高さは GH 系（上記）だけで、新規部品（L1 XFL4020、U6、1210 の C26〜C28）と J1 の実装後最大高さ・浮きを本調査では収集していない。**不足入力：全実装部品の保証最大高さ、実装浮き、ケース蓋の基準高さ**。#150 は数値の高さを置いていない（初期案は PCB 表面から 12mm 以上をケーブル空間に予約）ため、差は「数値が無いまま新規部品が増えた」ことしか言えない。

その他、Stage 1 の TP 列（Y118）、J2 南側サービス空間に影響する移動はない（既存部品の移動0）。

## 4. Wing Rev.1 製造データと #150 計測 — OK

- #150 は #141 の run 基板（`KRT-16/17-2L-P0300/out.kicad_pcb`）を計測した。Wing Rev.1 は同基板にシルクだけを足した #149／#151（SILK-149A）。ファイル hash は異なるが、内容を直接照合した。
- 照合結果：16mm／17mm とも、外形・板厚 1.2・四隅穴・部品座標が #150 の計測値、凍結済み `issue149-interface.json` と**完全一致**。

| 項目 | 16mm | 17mm |
| --- | --- | --- |
| 外形 X／Y | 45–155／50–150（110×100） | 41.75–158.25／47.625–152.375（116.5×104.75） |
| 四隅穴（φ2.2 NPTH、4個） | (48,53) (152,53) (48,147) (152,147) | (44.75,50.625) (155.25,50.625) (44.75,149.375) (155.25,149.375) |
| 穴の位置 | 各角から X・Y とも 3mm 内側 | 同左 |
| J_WING | (63,140) | (59.75,142.375) |
| キー（センサ）座標 | 21点、#150 の `keys-16mm.csv` との差：最大 0mm、回転 0、全て F.Cu | 同左（`keys-17mm.csv`） |
| 製造データ | ZIP 内の Edge_Cuts／NPTH は同名フォルダのファイルと byte 一致。Gerber 外形4辺・NPTH ドリルはネイティブ基板と一致 | 同左 |

**範囲の注記**：キー座標はセンサ中心の基板座標であり、Gerber の銅箔から再導出してはいない（外形と穴のみ Gerber で確認）。リポジトリ内の Wing Rev.1 データは左キー配置の1形状だけで、**右 Wing 形状の製造データは無い**（#158 は計画段階）。D-024 のデュアル Wing の右側が #150 計測と一致するかは **判定不能（不足入力：右 Wing の基板／製造データ）**。

## 5. D-017 の 100mm ハーネスと取り回し — 判定不能

**不足入力**：(a) M1 評価時の Main／Wing の組立位置・角度・Z（筐体 CAD または配置案）、(b) 100mm の測定基準（圧着接点間か被覆端か。#150 も実ハーネスで確認としている）、(c) 将来の逆ハの字の配置・傾斜角、(d) 実線材の曲げ条件と固定点。いずれもリポジトリ内に無く、組立配置を推測して OK／NG を出さない。

確認できた数値（設計値・仮定を明記）：

- D-017：公称 100mm、14 本、1:1。#150：空間経路 70mm 以下＋両端余長合計 30mm、曲げ半径 R≥5mm、通路幅 18mm 以上（これらは #150 の提案値でメーカー規格ではない）。
- J2 と J3 は Main の反対側にある（パッド列の Y 間隔 43mm）。Wing 側 J_WING は 16mm で (63,140)、17mm で (59.75,142.375) と各 Wing の南寄り。
- 楽観側の上界：2つの 90° 曲げ（半径 R）と直線だけで同一平面の2コネクタを結ぶ場合の中心間距離 D の上限は、経路 70mm なら R=3／5／8mm で 66.6／64.3／60.9mm、余長0で 100mm を丸ごと使うと 96.6／94.3／90.9mm。ケーブルは立ち上がり 7.3mm 以上（#160 の高さ感度では R=3〜8 で 10.68〜15.8mm）も要るため、実際の上限はこれより小さい。この値は合否ではなく、配置案が満たすべき最大の目安。
- M1 評価（Main 1枚＋Wing 1枚）で J2 と J3 のどちらを使うかは未定。J2 の pin7 は `WING_EN`、J3 の pin7 は `MUX_EN1` で、ネット名が異なる（機能同等かは本調査の範囲外）。
- 逆ハの字：ver.A 要件として記録（docs/lessons-learned）。角度・取付穴共通の前提のみで、傾斜角・Z は無い。

## 実物でしか決まらない事項（実測待ち）

- GH ラッチの当たり面・移動量・実挿抜力、全線把持との同時操作
- J3 張出し部の挿抜時ひずみと上下拘束支持の必要性
- 公差の積上げ（穴位置・外形・ボス・座金）、締付けトルクと POM のクリープ
- 全部品の実装後最大高さ、USB-C 開口面と USB プラグ外装の実寸
- ハーネスの実長・曲げ・固定点

## 対処案（判定とは分離。実施は PO 判断の別タスク）

1. **J3 支持の実物確認**：3D プリント治具に Rev.3 の実寸基板または外形モデルを載せ、下面リブ＋東側帯での支持を使った挿抜試験を発注前にできるか PO が判断する。成立しなければ基板改版（北側に支持用の穴など）が必要で、発注前に分かれば無駄な発注を避けられる。
2. **C26 の扱い**：実ハウジングを当てて C26 との干渉（ラッチ操作・指）を確認する。干渉するなら配置再検討（#175 の再資格が必要）。
3. **部品高さの収集**：BOM の全部品の公表最大高さを表にまとめる（J1、L1、C26〜C28、U6 を優先）。
4. **USB 開口**：J1 の実シェル座標とプラグ外装寸法で、ケース側トンネルの深さを確認する。
5. **ハーネス**：M1 評価の組立配置案（Main と Wing の相対位置）が出た時点で、上記の上界と照合する。
6. **右 Wing**：右形状の製造データが確定した時点で項目4を再実行する（`extract.py` は assert で不一致を検出）。

## 干渉チェック

PO 追加要件：基板と、#150 が定義した（または本報告が特定した）筐体側の構造・包絡との**幾何干渉**を計算した。幾何のみで、電気 DRC は機械的証明に使っていない。計算は `hardware/case/issue-188-crosscheck/interference.py`（`extract.py` から呼ばれ、結果は `extracted.json` の `interference`）。J3 周辺の1mmセルのゾーン図は `j3-zone-map.txt`。以降の「抽出」はこの出力。

**モデル**：銅＝パッド・トラック（カプセル）・via(φ0.6)・スルーホール・NPTH。部品包絡＝フットプリントのパッド外接矩形（基板データに Fab／3D 本体は無い）。J2／J3／Wing コネクタはパッド外接矩形∪BM14B 本体（20.75×4.25、公表値）、J1 は HRO 本体 8.94×7.35。グリッドは Main 0.05mm／Wing 0.1mm、セル中心が障害物から（余白＋0.7072×解像度）未満なら占有とみなす保守側。余白は 0 と 0.3mm（0.3 は感度確認用の**仮定**であり設計値ではない）。楕円パッドは外接矩形で近似。

### 判定一覧

| # | ペア | 判定 |
| --- | --- | --- |
| 1 | φ4.5 ボス包絡 vs φ5.0 予約・銅・外形（Main H1〜H4、Wing 角穴） | **干渉なし**（幾何。公差・座金・ネジ頭は実測待ち） |
| 2 | J3 付近の支持接触 | **要注意**（下面北側帯は幾何的に使える。上面は不可。剛性は実測待ち） |
| 3 | GH ハウジング包絡（J2／J3）・ハーネス出口・ラッチ操作空間 | J3：**要注意**、J2：**要注意**、ラッチ操作：**判定不能** |
| 4 | J1 USB-C プラグ挿入包絡 | 一般的なフルサイズプラグ：**干渉あり**。低背プラグ・受口高さ：**判定不能（実測待ち）** |
| 5 | Wing 上面の板／トレイ接触案と部品、スイッチ／キーキャップ移動包絡 | 静的な板 vs 部品：**干渉なし**。移動量・キャップ：**判定不能**。テストパッドへの上面アクセス：**要注意** |

### 1. ボス／ネジ包絡 φ4.5 — 干渉なし

入力：#150 §2 のφ4.5 案（設計値案）。穴中心に同心で計算した。

- **Main**：予約の多角形は頂点半径 2.5002／内接半径 2.5。全 4 銅層（F／In1／In2／B）で、穴中心から最近傍の銅までの距離は H1〜H4 とも **2.5mm 以上**（In1 の GND ベタ境界がちょうど 2.5）。ボス半径 2.25 に対する銅クリアランスは全穴で **0.25mm 以上**（F.Cu のトラック：H1 2.637、H4 2.92mm 等）。パッド端までは §1 表のとおり（H1 R1 でボス縁 1.525、H4 J2 1.40、H2 J3 4.16、H3 TP1 6.16）。
- **外形**：H1／H2／H3 の端残り 0.75mm、H4 は 8.25mm。φ4 POM 座金（#163）を使うと端残り 1.0mm（H1〜H3）。
- **Wing 16／17mm**：角穴 4 つの端残りはともに 0.75mm（全角穴）。keepout は F／B のみ。最近傍の銅はコネクタパッド（H1 J_WING パッド中心 5.054 → ボス縁との差 2.80mm）で、他の穴は 10〜20mm 離れる。
- 実測待ち：ネジ頭／座金の実径、穴位置・外形の公差積上げ、ボス実径。0.25mm 余裕は設計値上の余裕で、公差の検証ではない。

### 2. J3 付近の支持接触 — 要注意

J3 包絡＝パッド外接矩形∪BM14B 本体＝X94.525–115.475／Y72.15–77.75。φ4.5 ボス（H2）は帯から除外。「自由」＝部品・銅・テストパッド・via・穴のいずれも無い領域。

| 面 | ゾーン | 自由な最大矩形（余白0） | 余白0.3mm |
| --- | --- | --- | --- |
| 上面 | 北側ストリップ（J3 の北） | **16.9×1.9**（X95.9–112.8／Y70–71.9）。Y71–72 にトラックがあり、深さは場所により 0.2〜2.1mm | — |
| 上面 | 東側（H2 ボス除外） | **8.5×8.7**（X115.5–124／Y70–78.7） | 8.2×8.4 |
| 上面 | J3 本体の下 | **なし** | — |
| 下面 | 北側ストリップ | **26.15×4.15**（X86.65–112.8／Y70–74.15）。J3 の幅の下では 18.3×4.15。限界は Y74〜75 の via 列 | 25.55×3.85 |
| 下面 | 東側 | 部品・via・TP のみ考慮：**10.55×8.7**（X113.45–124／Y70–78.7）。トラック（B.Cu X114〜117 の帯）も含めると **6.95×8.7**（X117.05–124）。Y83.35–92 に 8.5×8.65 の全障害物なし領域もある | 6.65×8.4（トラック込み） |
| 下面 | J3 本体の真下 | **10.5×2.6**（X103.45–113.95／Y74.85–77.45） | 10.0×2.3 |

- X90–124／Y70–90 の上面部品：C24、C26、C27、C28、J3、L1、R19、R2、R5。下面には部品が無く、トラック 6 本と via 19 個。J1 のシェル脚は X88–89／Y79–85（両面に銅）。
- **訂正**：初回報告の「北側ストリップ（Y70–72.15）と J3 東側は部品なし」は**部品についてのみ正しい**。上面の北側ストリップにはトラックがあり（自由深さ 0.2〜2.1mm）、下面は B.Cu トラックの帯が X114〜117 にある。上面で接触できるのは東側 8.5×8.7 のみで、北側ストリップは銅の無い接触面として使えない。
- 結論：下面の北側帯（深さ 4.15）にリブを当てる案は、幾何的には成立する。ただし J3 本体の北側（Y72.15 より北は 2.15mm）を下から支える配置であり、挿抜力に対する剛性・基板のたわみ・J3 パッド直下の via 列との位置関係は**実測待ち**。要注意とする理由は、上面側に接触面が無く、上下拘束が下面だけになること。

### 3. GH ハウジング包絡（J2／J3）— J3 要注意／J2 要注意／ラッチ判定不能

入力：GHR-14V-S 18.75×4.15×5.7、嵌合後高さ参照 7.3、電線外径 0.76〜1.0、BM14B 20.75×4.25×4.05（公表値、#160／#163 記載）。ハウジングはヘッダ本体の中心に置く（ラッチの基準は**不明**）。

| | J3：X95.625–114.375／Y73.25–77.4 | J2：X100.625–119.375／Y116.25–120.4 |
| --- | --- | --- |
| 外形端までの間隔 | 北 **3.25**、東 9.625、西 19.625 | 南 **1.6**、東 4.625 |
| 横方向の最初の障害物 | 西 **1.45（C26）**、南 2.15（C28） | 北 **2.5（H4 ボス）**、西 19.375 |
| 2.0mm 以内の部品 | C26 のみ | なし |
| 最近傍ボス | H2：5.29mm | H4：2.50mm |
| 最近傍テストパッド | TP4／TP3：40mm | TP4 3.025／TP3 6.025mm |

- **ハーネス出口**は +z（上面からの立ち上がり、#160）。立ち上がり高さは 7.3＋s＋R＋d/2＝10.68〜15.8mm（#160）、#150 は基板上 12mm 以上を予約。
- **曲げ先端の水平位置**（曲げ半径 R、ハウジング中心から R+0.5）：J3 を北に折る場合、R=3 で端まで 1.825mm、R=5 で**端を 0.175mm 超過**、R=8 で 3.175mm 超過。J2 を南に折る場合、R=3 で端まで 0.175mm、R=5 で 1.825mm 超過、R=8 で 4.825mm 超過。つまり北（J3）・南（J2）方向の出口は R≥5 だと基板外に出るため、側壁位置（#150 初期案：壁厚 2.0＋隙間 0.5、設計案）と出口方向をそろえる必要がある。東側は J3 が 10.5〜15.5mm、J2 が 5.5〜10.5mm の余裕（R により変わる）。
- サービス矩形 26×7.5（X92–118／Y71.5–79）は C26 と重なる。
- 判定：J3 は C26 まで 1.45mm、北余裕 3.25mm で要注意。J2 は南端 1.6mm と H4 ボス 2.5mm で要注意。部品との直接の干渉は無い（0mm 以内なし）。
- **判定不能**（ラッチ操作）：ラッチの位置・移動量、操作する指／工具の包絡が入力に無い。#160／#163 の工具寸法は仮定。

### 4. J1 USB-C プラグ挿入 — 干渉あり（フルサイズプラグ）

- J1（85,81）。受口前面は Y79.45（HRO 推奨レイアウトの外形端〜位置決め線 4.15 から導出、`hardware/jitx/geometry/EDA-002C3.md`、図の対応に SOURCE_AMBIGUITY あり）。北端から前面まで **9.45mm**（シェル杭の端 Y79.15 基準なら 9.15mm）。本体 8.94×7.35＝X80.53–89.47。
- プラグ寸法（USB-IF 推奨、Amphenol Socapex FAQ 等経由の二次資料で一次仕様は再確認していない）：オーバーモールド ≤12.35×6.5、シェル 8.25×2.40、シェル長 6.65、受口開口 8.34×2.56。
- **トンネル帯**（オーバーモールド幅＋両側 0.5＝13.35、X78.325–91.675／Y70–79.45）の中の上面部品：C23、C24、C25、C26、L1、R17、R18、U6。シェル幅（8.25／8.94）だけでも C23、C24、C25、L1、R17、U6 が入る。例：L1 X87.3–91.7／Y72.2–75.8、U6 X83.55–86.275／Y71.8–75.2。
- オーバーモールドが基板端で止まる場合、プラグ先端は Y76.65 で、前面まで **2.80mm 足りない**。基板上を通すには、プラグ軸が PCB 上面から z≥3.25 でなければならない。受口の高さ（HRO 外形高さ）はリポジトリに無く、一般に約 3.3 と言われるが**未確認**。
- ケース壁外面から前面までのトンネル深さ＝9.45＋2.0（壁）＋0.5（隙間）＝11.95mm（壁・隙間は #150 初期案の値）。
- 判定：一般的なフルサイズプラグは、部品との干渉とプラグ下半分が基板上面より下に出る点の両面で、約 9mm のトンネルでは前面に届かない（**干渉あり**）。ケース開口は幅 13.35mm 以上・高さ 7.5mm 以上（プラグ外形に余白）を、受口軸に合わせて確保する必要がある。低背プラグ（実寸）と受口高さ・軸位置：**実測待ち（判定不能）**。

### 5. Wing 上面：板／トレイ接触案 vs 部品、キー移動包絡

入力：#150 §3〜§5 の設計値（板の支持面 H=10、板厚 1.5、スイッチ下端、センサ上面 1.12+0.10、最大ストローク 3.7）。

- **垂直（設計値）**：板下面 z=8.5。スイッチ下端 z=2.15（公称、H−0.15 で 2.0）。センサ上面 1.22 → 非押下時の最小隙間 0.78（#150 と一致）。板下面→センサ上面 7.28。板下面→嵌合 GH 参照（7.3）＝1.2mm のため、J_WING 周辺は板を切り欠く必要がある（サービス帯はキー領域と重ならない）。スイッチ上面 z=16.1。
- **水平**：キー包絡 15.8 角の外形端余裕 3.1（16mm）／3.6（17mm）。最近傍ボス縁まで 1.851（16mm、H2）／2.637（17mm）。J_WING ハウジングとサービス矩形まで 33〜37mm、本体まで 10.25／10.75mm。キー包絡内にセンサ・キャップ・TP 以外の部品は無い。MUX はキー包絡から 8.6〜9.1mm。
- **板／トレイが触れる面**（銅・部品・via・TP の無い領域、0.1mm グリッド）：上面 16mm は E 側の 13.9×65.5、外周帯は N1.3／S1.8／E1.8／W1.8。下面 16mm は N／S 固定で 13.2×100。17mm は上面 E 側 16.0×67.7、下面 N 13.8×95.6／S 12.0×104.8。#150 の板案が基板上面に触れるのは角ボスのみで、PCB 面への接触は不要。
- **テストパッド**：TP_H_CTR／DIAG／N_RAW はスイッチ包絡 15.8 の下に中心があり（両ピッチ）、スイッチ装着後は上面から届かない。16mm では TP_W_A0／A1／A2／EN が包絡に一部重なる。他の TP は包絡外。→ 要注意。
- **判定不能**：フルストローク時のマグネット／ステムとセンサの隙間（入力に m(q) とマグネット基準が無い。#150 も不明としている）、キーキャップのスカート vs 板上面の自由隙間（キャップモデルとスカート寸法が無い）、キャップ／蓋の隙間。
- **要確認**（外部公表値、リポジトリに無い）：GRM188 の高さ（一般に 0.8 前後）、MUX（TSSOP-16、≤1.2 程度）。板下面との余裕は 7mm 以上あるため静的判定はこれに依存しない。
- 判定：板 vs 部品の静的干渉は **なし**。移動包絡は **判定不能**。

### 値の区分（干渉チェック）

- **公表値**：GHR-14V-S／BM14B の寸法（#160／#163 記載）、USB-C プラグ寸法（二次資料）。
- **設計値**：基板座標・パッド・銅（抽出）、#150 の高さ・板厚・ストローク、壁 2.0／隙間 0.5（初期案）。
- **仮定**：余白 0.3mm、部品包絡＝パッド外接矩形、GH ハウジングの中心配置、Wing 板範囲＝キー包絡 15.8 の下限。
- **実測待ち／判定不能の入力**：GH ラッチ位置・移動量・操作包絡、受口高さ・軸位置、プラグ 3D 形状、部品高さ、キャップ形状、m(q) とマグネット基準、公差、座金・ネジ頭の実寸。
