ihsinoky/he-piantor-42/docs/eda-path-history.md

# EDA path history

Read this before proposing an EDA method change or retry. Decisions remain
historical authority; this index does not replace or rewrite them. Observations,
PO supplements and executor recommendations have different provenance.

| Path / scope | Stop or non-adoption and evidence | Retry condition; reusable work / unproved scope |
| --- | --- | --- |
| Initial KiCad files: integrated four-key schematic, attempted PCB | **PO supplement:** repeated direct-authoring file-format hand fixes ([#79](https://github.com/ihsinoky/he-piantor-42/issues/79)). **Observed:** [PR #6](https://github.com/ihsinoky/he-piantor-42/pull/6) symbol/power/reference corrections; [PR #10](https://github.com/ihsinoky/he-piantor-42/pull/10) local static checks only and final CI 587 DRC violations / 40 unconnected items. [Retained metadata/raw](../hardware/kicad/qualification/eda-004e/evidence/), source `f6a1bbac54eb5161fa4ab785c88a3958a320b4f4`. Full writer commands and root causes **unknown**; a generator header does not prove authoring method. D-014 later retires KiCad as fallback/reference. | A concretely different serialization/validation route and current electrical/geometry proof. Reuse original symbols/footprints/requirements as verified reference only; old four-key design is not current Main authority. Local validation absence is not the sole established cause. |
| JITX: component models, electrical parity, headless physical and downstream pipeline | **PO decision:** [D-016](decisions.md#d-016---jitx-physical-backend-no-go-native-tscircuit-resumes-as-active-revm1-eda-candidate), [Issue #55](https://github.com/ihsinoky/he-piantor-42/issues/55), [C4B5 evidence](../hardware/jitx/physical/EDA-002C4B5.md): project-fit NO-GO, complete supported headless global multilayer routing not demonstrated, 39 downstream unconnected items + dangling via. USB NPTH DFM and thickness handoff are separate limits. | Separately authorized supported complete routing workflow with bounded maintenance/investment. Reuse manufacturer models, graph introspection, electrical parity, DFM and downstream knowledge; retained source/evidence unchanged. No claim that experts or other layouts cannot succeed. |
| Native stock tscircuit physical routing: disposable Main/Wing | **Observed:** [EDA-003B](tscircuit-revm1-routing-proof.md) BLOCKED; [EDA-003C](tscircuit-latest-routing-risk-qualification.md) wrong-net improvement but remaining physical/export risks; [EDA-003D](tscircuit-main-clearance-risk-triage.md) broad clearance failures; [EDA-003E](tscircuit-via-clearance-signature-probe.md) repair boundary unqualified; [EDA-003F](tscircuit-clearance-intervention-ab.md) intervention unsafe regression/K1. **PO planning:** [D-018](decisions.md), #71 ends evaluated internal-router exploration; no backend adoption. | A specifically changed supported routing mechanism showing electrical connectivity and strict 0.20 mm physical spacing simultaneously. Reuse native electrical source, fixed models/interface and independent physical validation; complete representative Main routing/manufacturing unproved. |
| Circuit JSON → KiCad + prospective external routing | [EDA-004B](alternate-physical-backend-main-qualification.md): executor smoke-capture failure, partial evidence, not proof of backend incapability. [EDA-004C](alternate-physical-backend-smoke-requalification.md): duplicate GND land net loss/shorts and unqualified schematic. [EDA-004D / #77 / PR #78](alternate-physical-backend-converter-repair.md): three bounded fixes, then new footprint-library-ID collision and remaining disconnected SIG/ERC failures. **Observed STOP**, no route attempts. | Accepted exact footprint identity, connected schematic/ERC, faithful libraries and effective physical rules before routing. Reuse raw fixtures, pinned env/capture, limited repaired-source lessons and fault checkers. No converted PCB becomes product authority; complete interchange/routing unproved. |
| Native KiCad objects + own serializer: EDA-004E / #79 | [Feasibility result](native-kicad-authoring-feasibility.md): **PCB_IO_PASS / FRONTEND_UNQUALIFIED**. Separate-process I/O and frozen object parity pass; initial fixture acceptance fails two unexpected DRC warnings. No conditional fresh trial or rule negative test. Public pinned 9.0.9 headless schematic authoring not found; SWIG PCB bindings deprecated. **Evaluation-time executor recommendation (report completed 2026-10-08):** STOP before Main and request PO/PMO review. This recommendation is history; the report was later accepted by PR #80, and no later decision is inferred here. | Any new evaluation needs separate authorization for a concrete circuit/connectivity plan and completion conditions. Reusable evidence: official hashed footprint, object API findings, fixed fixture and raw results. No Main, migration, frontend or routing PASS. |
| External kicad-sch-api + fixed KiCad CLI: EDA-004F / #83 / merged PR #84 (accepted report) | [Headless schematic report](headless-schematic-qualification.md): **SMALL_SCHEMATIC_CANDIDATE_PASS** for six symbols/16 pins. Initial acceptance **FAIL**, six library configuration warnings; identical schematic with configured pinned libraries passes ERC and independent parity. Required-input cut/output conflict detection, value-only change and same-environment empty-directory regeneration PASS. No stop condition; bounded experiments completed. | Public library generation and fixed CLI inspection are reusable candidate evidence. Main models, PCB transfer, routing, effective spacing, manufacturing and whole-environment rebuild unproved. Accepted in PR #84; no adoption or automatic extension. Issue #85 separately authorized the subsequent EDA-004G evaluation below. |
| Native public schematic/PCB Main prerequisite: EDA-004G / #85 / Draft PR #86 | [Main report](native-main-routing-qualification.md): initial selected-library shortage and resume01 frozen-role FAIL retained. **Authority correction:** resume02 fresh Main/ERC/DRC exceeded the PO-clarified one-hour saved-evidence scope; “PO-authorized” withdrawn. Retained technical results: fresh v2 raw roles/4 models, ERC0, individual core pads/holes/pose/layer/net/actual USB copper and four Main-shaped synthetic fault cases PASS WITH SCOPE.557 auxiliary primitive parameters match, glyphs unqualified; final DRC61 printing violations → **PRE_ROUTE_PHYSICAL_DRC_STOP / MAIN_UNQUALIFIED**. Effective .20mm/DSN/SES/Main trials NOT ENTERED;0/0/0, routed metrics null. | No old oracle/result repaired retrospectively. Printing violations not excluded or suppressed; no method-wide failure/mandatory-large-work proof. Tmp environment re-prepared, not full rebuild qualification; source/production/decisions unchanged. Six-hour cutoff reinterpretation was executor-only, not verified PO approval. Additional observed submission window1.260h; active work unknown; prior estimates/wait retained. PMO/PO reviews same PR #86; no further experiments/adoption/product/Human Gate inferred. |

Across retries, carry forward the original backend effort cap and known estimates;
unknown human/review/reporting effort stays unknown. CI SKIPPED and successful
management checks are not technical qualification. For any new proposal state the
previous stop reason, the specific mechanism changed and the first falsifiable
hypothesis. No path is reopened merely because it was tried earlier.
