ihsinoky/he-piantor-42/hardware/case/issue-240-bay-cover/provenance/AUDIT.md

The saved outcome is a rejected assembly, not a clearance certificate.

Positive constituent intersections were accumulated by native OCCT Boolean
Common, using the immutable #232 assembly leaves. The source runner was resumed
across slow CAD calls. The saved collision-progress files preserve the last
completed pair and every measured positive contact. The final export used
`--resume --reject-known`: an existing measured positive contact conclusively
fails the zero-interference predicate, so untested pairs cannot change that
failure into a pass. `all_pairs_audited` is false and counts are lower bounds.

Cover tiling is an exact distributive partition of the same CSG, not a new
shape. Sixty-two tiles agree with the original cover volume within
1.6e-9 mm³. Replacing broad Boolean calls with disjoint constituent calls does
not waive any measured collision. Volumes within overlapping cable envelope
constituents are not summed into a unique whole-assembly volume.

A default reproduce.sh invocation performs fresh enumeration. Use resume only
with unchanged geometry/inputs; the checkpoint is an implementation convenience,
not an independently reusable certificate. The full assembly STEP deliberately
contains the failing routes and is named REJECTED. No fit/adoption/retention pass
is asserted by a successful export or evidence-consistency check.
