ihsinoky/he-piantor-42/hardware/kicad/qualification/issue-240-main-rev7/connector/SOURCES.md

# Connector evidence

Selection: JST **SM14B-GHS-TB(LF)(SN)**, LCSC/JLCPCB C265343.

- Manufacturer current catalog: https://www.jst-mfg.com/product/pdf/eng/eGH.pdf — page 2 assembly layout: side-entry mated height **(4.35)** and axial length **(7.15)**, horizontal wire exit; page 3 lists SM14B-GHS-TB and GHR-14V-S. Parentheses indicate reference dimensions. Manufacturer specifications: AWG30–26, insulation diameter 0.76–1.0 mm; contact SSHL-002T-P0.2. Pin 1 drawing is viewed from the mounting surface.
- Archived manufacturer drawing distributed by DigiKey: [eGH-distributor-copy.pdf](eGH-distributor-copy.pdf), https://media.digikey.com/pdf/Data%20Sheets/JST%20PDFs/GH%20Series.pdf (assembly layout page 4). This historical manufacturer copy agrees on 4.35/7.15 geometry; use the current manufacturer catalog for current ratings. Direct download of current JST PDF returned HTTP 403, although the web reader could inspect it.
- Footprint source: https://raw.githubusercontent.com/KiCad/kicad-footprints/master/Connector_JST.pretty/JST_GH_SM14B-GHS-TB_1x14-1MP_P1.25mm_Horizontal.kicad_mod . Original KiCad library footprint, CC BY-SA 4.0 with KiCad library exception; https://github.com/KiCad/kicad-footprints/blob/master/LICENSE.md . Copied unchanged, native board uses its pad numbers. The legacy footprint's "top entry" search tag is erroneous; geometry/part name is horizontal SM.
- [stock.json](stock.json) and compressed raw HTML contain the direct HTTP observations on 2026-11-13. Search-engine cached stock was deliberately not used. LCSC 504; JLCPCB `overseasStockCount` 1859 and separate `canPresaleNumber` 1196, not additive or a reservation. Thirty headers including spares require a preferred stock of about 300; both reported stock fields exceed this. No purchase or factory acceptance is implied.

Both cable ends use standard **GHR-14V-S** and **SSHL-002T-P0.2**. This study changes Main J2/J3 to SM14B-GHS-TB as well; both Main and Wing use side-entry GH headers. Specify fourteen individual AWG28 conductors (at least 0.0804 mm²), each insulation OD <=1.0 mm, six independent return conductors, no substitution with AWG30. Use a harness fabricator's GH-compatible tooling; continuity test every cavity 1→1 through 14→14 and label L/R. No crossed/reversed wire order is allowed. Hand crimps require appropriate tooling and pull/retention checks. Actual assembled height/exit and conductor dressing still require sample measurement before manufacture.
