ihsinoky/he-piantor-42/hardware/kicad/qualification/issue-167-main-dual-wing-stage2/resume/prior-draft-pr-body.md

Issue #167のD-024／D-025と#160／#163報告・証跡をPR #164から取り込み、D-026へ案C・機構(b)・5.2V強制PWMレール・保証範囲を記録する。機構実物確認は今回のゲートから外した。

Refs #167

USB上流4.75Vと正のケーブル／Main抵抗では、Main他負荷0・効率100%でも変換器入力4.75Vを保証できない。電気条件の停止規則を適用し、Issue全体は未完了。

- 上流／Main負荷込みの定電力モデル4,320ケースと電流予算を保存。80%感度・127mA×2では変換器347.579mA、公称出力時に500mAからMainへ152.421mA残るが、入力電圧／実負荷／USB構成許可は未資格。
- 例：上流4.75V、上流R0.10Ω、Main R0.05Ω、Main100mAなら入力4.682107V。入力4.75Vには上流4.817137V以上が必要。いずれも感度例であり実測ではない。
- 下流はMain共通／枝各50mΩを仮置きした条件付き計算。127mAの最遠点4.796435V。改版後の実抵抗抽出ではない。11mA包絡はストレスのみ。
- PCB／回路未変更、配線0試行、独立4指標はnull。CAM／POFV再分類／PCBA見積は未実施。旧板合格を転用しない。
- 検証：PR #164全70ファイルのbyte照合、D-026追記限定、#155 hash・KiCad独立読取り、既存ファイル保全、電力／KVL／過去12行再現、リンク。

報告：`docs/issue-167-main-dual-wing-stage2.md`

証跡：`hardware/kicad/qualification/issue-167-main-dual-wing-stage2/`

停止状態をレビューするDraft。入力要求を緩めたり電源を暗黙に限定したりしていない。Issueを自動closeせず、発注・課金・mergeは行わない。
