ihsinoky/he-piantor-42/hardware/case/issue-232-final/17mm/post-positions-right.csv

id | x_mm | y_mm | contact_diameter_mm | shaft_diameter_mm | top_z_mm | base_z_mm | land_drill_body_edge_gap_mm | assembly_x_mm | assembly_y_mm
R1 | 16.0 | 12.0 | 3 | 3 | 10.0 | 2.0 | 3.0204967281412776 | 89.1026094393491 | -5.601804171650006
R2 | -16.0 | 31.0 | 3 | 3 | 10.0 | 2.0 | 0.7750000000000057 | 51.88979651824707 | -6.056286843554339
R3 | 43.0 | 9.0 | 3 | 3 | 10.0 | 2.0 | 0.6255560000000102 | 113.98529534152894 | -16.50372796029669
R4 | -33.0 | -8.0 | 3 | 3 | 10.0 | 2.0 | 3.7750000000000004 | 56.667364653911605 | 36.21870390403876
R5 | 7.0 | 35.0 | 3 | 3 | 10.0 | 2.0 | 4.2373433890331835 | 69.80838080528915 | -21.020388458692093
R6 | -33.0 | 27.0 | 3 | 3 | 10.0 | 2.0 | 2.7749999999999986 | 39.167364653911605 | 5.907814771583418
