ihsinoky/he-piantor-42/hardware/kicad/qualification/issue-235-wing-round2/power-sensitivity.csv

board | main_branch | actual_assembly_branch | temperature_C | track_width_factor | length_mm | load_A | wing_far_terminal | wing_drop_V | wing_effective_loop_ohm | harness_wire_ohm | harness_loop_ohm | harness_drop_V | main_common_and_switch_drop_V | main_branch_drop_V | Vfar_V | margin_to_4p60_V
wing-rev4-16mm-right | J2 | J3 | 20 | 1.0 | 123.39470408176 | 0.127 | U_HC3 | 0.0013367681548760294 | 0.010525733502960861 | 0.026460797177532636 | 0.14753759670712144 | 0.01873727478180442 | 0.07292694822833748 | 0.00044079972649223943 | 4.95255820910849 | 0.35255820910849067
wing-rev4-16mm-right | J3 | J3 | 20 | 1.0 | 123.39470408176 | 0.127 | U_HC3 | 0.0013367681548760294 | 0.010525733502960861 | 0.026460797177532636 | 0.14753759670712144 | 0.01873727478180442 | 0.07292694822833748 | 0.0035848866982861063 | 4.949414122136696 | 0.34941412213669665
wing-rev4-16mm-right | J2 | J3 | 20 | 1.0 | 124.09716799907045 | 0.127 | U_HC3 | 0.0013367681548760294 | 0.010525733502960861 | 0.02661143374965141 | 0.14771333937459333 | 0.018759594100573353 | 0.07292694822833748 | 0.00044079972649223943 | 4.952535889789721 | 0.3525358897897215
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
