ihsinoky/he-piantor-42/hardware/case/issue-230-mount-study/16mm-left/floating-six-point-candidates.csv

id | x_mm | y_mm | plate_hole_diameter_mm | socket_od_mm | status
T1 | 7.0 | 54.0 | 3.05 | 8 | screened XY; bracket and retention not released
T2 | 44.0 | -4.0 | 3.05 | 8 | screened XY; bracket and retention not released
T3 | -41.0 | 38.0 | 3.05 | 8 | screened XY; bracket and retention not released
T4 | -30.0 | 38.0 | 3.05 | 8 | screened XY; bracket and retention not released
T5 | -49.0 | 38.0 | 3.05 | 8 | screened XY; bracket and retention not released
T6 | 44.0 | 24.0 | 3.05 | 8 | screened XY; bracket and retention not released
