ihsinoky/he-piantor-42/hardware/case/issue-230-mount-study/16mm-left/supports.csv

id | x_mm | y_mm | contact_diameter_mm | shaft_diameter_mm | top_z_mm | base_z_mm | land_drill_body_edge_gap_mm | assembly_x_mm | assembly_y_mm
R1 | -15.0 | 12.0 | 3 | 3 | 10.0 | 2.0 | 2.3389693150955226 | -84.63850782421135 | -5.333854979218881
R2 | -41.0 | 9.0 | 3 | 3 | 10.0 | 2.0 | 0.4588889999999992 | -108.65516832260676 | -15.735778767865565
R3 | 20.0 | 25.0 | 3 | 3 | 10.0 | 2.0 | 2.360081513053842 | -47.827618691755994 | 0.9078147715834177
R4 | 31.0 | -7.0 | 3 | 3 | 10.0 | 2.0 | 3.186765000000002 | -54.30133925012717 | 34.12062769268545
R5 | -7.0 | 34.0 | 3 | 3 | 10.0 | 2.0 | 2.9781614721950085 | -66.71030459393583 | -20.386413862476527
R6 | -25.0 | 9.0 | 3 | 3 | 10.0 | 2.0 | 0.4588889999999921 | -94.79876186205573 | -7.735778767865565
