ihsinoky/he-piantor-42/hardware/case/issue-230-mount-study/16mm-left/tie-holes.csv

id | x_mm | y_mm | plate_hole_diameter_mm | spacer_od_mm | spacer_id_mm | spacer_height_mm | assembly_x_mm | assembly_y_mm
H1 | 3.0 | -5.0 | 2.2 | 3.8 | 2.2 | 3.5 | -77.55005055609145 | 18.388576885116578
H2 | -54.1 | 46.2 | 2.2 | 3.8 | 2.2 | 3.5 | -101.4001011121829 | -54.50192378864669
H3 | 57.1 | -15.0 | 2.2 | 3.8 | 2.2 | 3.5 | -35.69807621135332 | 54.09883092296096
H4 | 57.1 | 46.2 | 2.2 | 3.8 | 2.2 | 3.5 | -5.098076211353316 | 1.098076211353316
