ihsinoky/he-piantor-42/hardware/case/issue-230-mount-study/17mm-right/floating-six-point-candidates.csv

id | x_mm | y_mm | plate_hole_diameter_mm | socket_od_mm | status
T1 | -12.0 | 51.0 | 3.05 | 8 | screened XY; bracket and retention not released
T2 | 36.0 | 39.0 | 3.05 | 8 | screened XY; bracket and retention not released
T3 | -46.0 | -5.0 | 3.05 | 8 | screened XY; bracket and retention not released
T4 | 52.0 | 39.0 | 3.05 | 8 | screened XY; bracket and retention not released
T5 | -46.0 | 27.0 | 3.05 | 8 | screened XY; bracket and retention not released
T6 | -57.0 | -13.0 | 3.05 | 8 | screened XY; bracket and retention not released
