ihsinoky/he-piantor-42/hardware/kicad/qualification/issue-178-m1-matrix-board/all-vias.csv

UUID | X mm | Y mm | Net | Diameter mm | Drill mm | Classification | Pads | Required process
1c65e7ab-cbe3-4193-876f-bb0b42472cfd | 121.0 | 119.0 | H_B5_RAW | 0.6 | 0.3 | no-pad-overlap |  | ALL plated vias: epoxy fill + copper cap + plate over
1dca349c-ab08-4fb0-90f9-357c5a063761 | 119.6 | 119.0 | H_B5_RAW | 0.6 | 0.3 | no-pad-overlap |  | ALL plated vias: epoxy fill + copper cap + plate over
45f3d823-d393-445e-b367-68020234b68b | 103.0 | 119.0 | H_A5_RAW | 0.6 | 0.3 | no-pad-overlap |  | ALL plated vias: epoxy fill + copper cap + plate over
7020d305-9d7c-4d7a-84e4-aaea3af9dbc1 | 95.6 | 121.1 | H_A5_RAW | 0.6 | 0.3 | no-pad-overlap |  | ALL plated vias: epoxy fill + copper cap + plate over
c8262f4a-6277-4228-b941-f0f9def34933 | 97.6 | 118.1 | H_A4_RAW | 0.6 | 0.3 | no-pad-overlap |  | ALL plated vias: epoxy fill + copper cap + plate over
17edcd10-8559-4286-a5c5-989f474b93ee | 95.1 | 120.6 | H_A4_RAW | 0.6 | 0.3 | no-pad-overlap |  | ALL plated vias: epoxy fill + copper cap + plate over
36081fa9-ef1e-4316-8e8c-4bfa5592d4fa | 83.0 | 119.6 | H_B2_RAW | 0.6 | 0.3 | no-pad-overlap |  | ALL plated vias: epoxy fill + copper cap + plate over
3f062386-5caa-4719-b2cf-f16c58b5927a | 83.7 | 120.3 | H_B2_RAW | 0.6 | 0.3 | no-pad-overlap |  | ALL plated vias: epoxy fill + copper cap + plate over
cf6fed5c-6219-4a5a-92f1-9db3322998f2 | 98.3 | 124.3 | H_C2_RAW | 0.6 | 0.3 | no-pad-overlap |  | ALL plated vias: epoxy fill + copper cap + plate over
36840b40-6547-4283-8046-2122ae66b675 | 94.3 | 120.6 | H_C2_RAW | 0.6 | 0.3 | no-pad-overlap |  | ALL plated vias: epoxy fill + copper cap + plate over
19de143e-3158-448b-b439-48e60d4c1c58 | 88.8 | 115.2 | H_C2_RAW | 0.6 | 0.3 | no-pad-overlap |  | ALL plated vias: epoxy fill + copper cap + plate over
725aa938-0bda-43bb-bd60-9c2f27418b76 | 88.1 | 114.5 | H_C2_RAW | 0.6 | 0.3 | no-pad-overlap |  | ALL plated vias: epoxy fill + copper cap + plate over
896498a8-fa70-44a8-8e7e-be0852079c31 | 107.5 | 119.8 | H_C1_RAW | 0.6 | 0.3 | no-pad-overlap |  | ALL plated vias: epoxy fill + copper cap + plate over
9805d378-1108-40c0-8f68-90cfe40b44ef | 104.2 | 116.4 | H_C1_RAW | 0.6 | 0.3 | no-pad-overlap |  | ALL plated vias: epoxy fill + copper cap + plate over
e2064382-12c5-40f4-9ccd-655b4fa2d0fb | 98.1 | 109.6 | H_C1_RAW | 0.6 | 0.3 | no-pad-overlap |  | ALL plated vias: epoxy fill + copper cap + plate over
b3e6995f-da97-4ee1-bbd4-42c90fdfca7c | 95.5 | 106.9 | H_C1_RAW | 0.6 | 0.3 | no-pad-overlap |  | ALL plated vias: epoxy fill + copper cap + plate over
3e55c0c9-498a-464e-91a9-eeec2c12ff32 | 110.5 | 119.8 | H_C0_RAW | 0.6 | 0.3 | no-pad-overlap |  | ALL plated vias: epoxy fill + copper cap + plate over
ffb62841-dad3-4377-9bdb-2660b99d368a | 105.7 | 114.9 | H_C0_RAW | 0.6 | 0.3 | no-pad-overlap |  | ALL plated vias: epoxy fill + copper cap + plate over
ed302f28-0e98-455a-bdf1-8b89ca590845 | 99.3 | 108.4 | H_C0_RAW | 0.6 | 0.3 | no-pad-overlap |  | ALL plated vias: epoxy fill + copper cap + plate over
5677acfa-ac1a-492b-b86e-f7df92cba898 | 97.4 | 104.6 | H_C0_RAW | 0.6 | 0.3 | no-pad-overlap |  | ALL plated vias: epoxy fill + copper cap + plate over
5bd9be12-3628-4101-b34b-b9680e8953bf | 113.3 | 119.8 | WING_EN | 0.6 | 0.3 | no-pad-overlap |  | ALL plated vias: epoxy fill + copper cap + plate over
a895353d-19fd-40f7-8dba-30d09e6f5901 | 110.0 | 110.6 | WING_EN | 0.6 | 0.3 | no-pad-overlap |  | ALL plated vias: epoxy fill + copper cap + plate over
4435317d-0485-4b7d-ae45-5a1321a13329 | 97.5 | 120.4 | WING_EN | 0.6 | 0.3 | mounted-center-in-pad | U_MUX_B.2 | ALL plated vias: epoxy fill + copper cap + plate over
435554c2-a211-40d0-ad36-7c3b758b04a1 | 90.4 | 114.5 | WING_EN | 0.6 | 0.3 | no-pad-overlap |  | ALL plated vias: epoxy fill + copper cap + plate over
ab33f2a6-c180-4b13-8ce4-fd7f997ea18e | 82.0 | 119.8 | WING_EN | 0.6 | 0.3 | no-pad-overlap |  | ALL plated vias: epoxy fill + copper cap + plate over
1f7a5a0c-40cf-409d-9a08-a51f7f491e0a | 104.7 | 125.2 | WING_EN | 0.6 | 0.3 | no-pad-overlap |  | ALL plated vias: epoxy fill + copper cap + plate over
da0fc203-3edd-45a7-a618-b8dacb8b13dd | 80.6 | 74.2 | GND | 0.6 | 0.3 | no-pad-overlap |  | ALL plated vias: epoxy fill + copper cap + plate over
aafedb9c-70cc-4195-84a0-1028c6ccc14f | 79.3 | 74.2 | GND | 0.6 | 0.3 | no-pad-overlap |  | ALL plated vias: epoxy fill + copper cap + plate over
9f1d756c-25b7-4fe9-8fbb-40dfb9d8a55b | 51.5 | 88.6 | GND | 0.6 | 0.3 | no-pad-overlap |  | ALL plated vias: epoxy fill + copper cap + plate over
29b6aa27-2519-4074-b924-595ada7d1bc8 | 51.2 | 89.8 | GND | 0.6 | 0.3 | mounted-center-in-pad | U_HA1.3 | ALL plated vias: epoxy fill + copper cap + plate over
979b4a02-ba20-4759-9b7d-d3ab5993891b | 48.4 | 93.2 | GND | 0.6 | 0.3 | no-pad-overlap |  | ALL plated vias: epoxy fill + copper cap + plate over
e60b9c4f-00d7-4273-83a4-b7235848ef56 | 62.6 | 106.8 | GND | 0.6 | 0.3 | no-pad-overlap |  | ALL plated vias: epoxy fill + copper cap + plate over
25ff5ead-aa29-4691-b89f-f1d0e7dff9a4 | 63.5 | 106.0 | GND | 0.6 | 0.3 | no-pad-overlap |  | ALL plated vias: epoxy fill + copper cap + plate over
9dff3b2a-e054-49e6-8054-5423b1d8d6a9 | 82.5 | 104.4 | GND | 0.6 | 0.3 | no-pad-overlap |  | ALL plated vias: epoxy fill + copper cap + plate over
93ed46a1-4ad3-4922-8837-97b142a344bd | 82.6 | 105.6 | GND | 0.6 | 0.3 | mounted-annulus-only | U_HC2.3 | ALL plated vias: epoxy fill + copper cap + plate over
a3111be7-f4f7-4775-a3cb-c551202cf2ed | 84.2 | 118.4 | GND | 0.6 | 0.3 | no-pad-overlap |  | ALL plated vias: epoxy fill + copper cap + plate over
ffeec37c-9d73-415b-b5b9-a8f677aeef36 | 84.932075 | 121.025 | GND | 0.6 | 0.3 | mounted-center-in-pad | U_MUX_A.14 | ALL plated vias: epoxy fill + copper cap + plate over
86e72995-e972-4cc2-ba21-9742b682ab0a | 84.5 | 125.2 | GND | 0.6 | 0.3 | no-pad-overlap |  | ALL plated vias: epoxy fill + copper cap + plate over
85b2bdf7-d5fe-4e06-95ec-e19ae42da5c3 | 90.4 | 132.3 | GND | 0.6 | 0.3 | no-pad-overlap |  | ALL plated vias: epoxy fill + copper cap + plate over
6bf400b2-1eca-46ad-b4e4-6024c8d218e9 | 91.1 | 133.0 | GND | 0.6 | 0.3 | no-pad-overlap |  | ALL plated vias: epoxy fill + copper cap + plate over
1b10363f-807c-4073-8714-1696d0b95ce8 | 86.7 | 121.5 | GND | 0.6 | 0.3 | mounted-center-in-pad | C_MUX_A.2 | ALL plated vias: epoxy fill + copper cap + plate over
93dba84b-f52c-410b-8c57-d3adb4ca101b | 93.9 | 132.4 | GND | 0.6 | 0.3 | mounted-annulus-only | J_WING.12 | ALL plated vias: epoxy fill + copper cap + plate over
12f6bcae-ab61-4daa-adec-2fcc2ae5ee8e | 96.4 | 132.4 | GND | 0.6 | 0.3 | mounted-annulus-only | J_WING.10 | ALL plated vias: epoxy fill + copper cap + plate over
aadc5ec8-fd19-4123-b8c4-30a235bc527b | 99.1 | 132.7 | GND | 0.6 | 0.3 | mounted-center-in-pad | J_WING.8 | ALL plated vias: epoxy fill + copper cap + plate over
8b535e1c-1339-4b1d-b511-51c50512ea7b | 103.9 | 132.7 | GND | 0.6 | 0.3 | mounted-annulus-only | J_WING.4 | ALL plated vias: epoxy fill + copper cap + plate over
410d0d02-f7d2-41fb-b991-0d3e626a9037 | 100.7 | 125.2 | GND | 0.6 | 0.3 | no-pad-overlap |  | ALL plated vias: epoxy fill + copper cap + plate over
9f8907b0-aaa8-4b60-b766-b4b759c2b71f | 101.8 | 121.1 | GND | 0.6 | 0.3 | no-pad-overlap |  | ALL plated vias: epoxy fill + copper cap + plate over
5c2893a7-dd41-47b7-888a-97c2110b3f43 | 104.1 | 122.4 | GND | 0.6 | 0.3 | no-pad-overlap |  | ALL plated vias: epoxy fill + copper cap + plate over
c92691bb-2893-40cb-9c53-0f6ca38541d5 | 106.9 | 133.0 | GND | 0.6 | 0.3 | mounted-center-in-pad | J_WING.2 | ALL plated vias: epoxy fill + copper cap + plate over
ffb72979-80ad-481c-8f76-bd4bddbe4620 | 123.5 | 123.3 | GND | 0.6 | 0.3 | no-pad-overlap |  | ALL plated vias: epoxy fill + copper cap + plate over
d4a95ee6-a2e9-46f9-b1bc-9e3d349876ca | 120.932075 | 121.025 | GND | 0.6 | 0.3 | mounted-center-in-pad | U_MUX_C.14 | ALL plated vias: epoxy fill + copper cap + plate over
ad5b0cd0-a3c4-49a9-9731-611d64098fb0 | 121.4 | 117.2 | GND | 0.6 | 0.3 | no-pad-overlap |  | ALL plated vias: epoxy fill + copper cap + plate over
4bb37f8b-0bc2-474c-9c32-4141965d5d68 | 131.9 | 106.7 | GND | 0.6 | 0.3 | no-pad-overlap |  | ALL plated vias: epoxy fill + copper cap + plate over
e8f32024-30a9-48b5-b059-088357375f9e | 133.0 | 107.0 | GND | 0.6 | 0.3 | no-pad-overlap |  | ALL plated vias: epoxy fill + copper cap + plate over
be78b770-75a4-44b3-ae95-270594c4ecf3 | 119.7 | 107.3 | GND | 0.6 | 0.3 | no-pad-overlap |  | ALL plated vias: epoxy fill + copper cap + plate over
8d3780bd-e95d-4af3-b4d3-5e6af16efeca | 118.7 | 106.9 | GND | 0.6 | 0.3 | mounted-drill-edge | U_HA5.3 | ALL plated vias: epoxy fill + copper cap + plate over
629c397a-7e36-4295-9c0d-2eecae5e3306 | 117.4 | 102.7 | GND | 0.6 | 0.3 | no-pad-overlap |  | ALL plated vias: epoxy fill + copper cap + plate over
e018b1cb-7656-4ff4-84c1-ee00fbe58d82 | 118.4 | 74.3 | GND | 0.6 | 0.3 | no-pad-overlap |  | ALL plated vias: epoxy fill + copper cap + plate over
8e61f458-da97-4d3a-9da1-46275eb7e4a2 | 118.1 | 73.1 | GND | 0.6 | 0.3 | mounted-center-in-pad | U_HA3.3 | ALL plated vias: epoxy fill + copper cap + plate over
21a4125a-ba41-4049-9950-9c8d92728732 | 134.8 | 71.6 | GND | 0.6 | 0.3 | no-pad-overlap |  | ALL plated vias: epoxy fill + copper cap + plate over
df8d76e8-d077-4e6d-b920-440e8d3c1b15 | 134.8 | 72.8 | GND | 0.6 | 0.3 | mounted-center-in-pad | U_HB3.3 | ALL plated vias: epoxy fill + copper cap + plate over
8a9f5b39-9228-40ba-8a4d-043703ed1fb1 | 135.6 | 90.0 | GND | 0.6 | 0.3 | mounted-center-in-pad | U_HB4.3 | ALL plated vias: epoxy fill + copper cap + plate over
958426d0-84ca-4331-abd7-853715a97a7e | 136.4 | 90.8 | GND | 0.6 | 0.3 | no-pad-overlap |  | ALL plated vias: epoxy fill + copper cap + plate over
1696edfa-a2ee-4c5f-8361-d38a5edef267 | 136.5 | 106.8 | GND | 0.6 | 0.3 | no-pad-overlap |  | ALL plated vias: epoxy fill + copper cap + plate over
f3b59f3d-5d5d-41e9-be7b-45ab565f7441 | 137.3 | 107.6 | GND | 0.6 | 0.3 | mounted-center-in-pad | C_HB5.2 | ALL plated vias: epoxy fill + copper cap + plate over
0df07c37-e390-4ede-93fa-470d8534bc2e | 123.5 | 122.1 | GND | 0.6 | 0.3 | mounted-drill-edge | C_MUX_C.2 | ALL plated vias: epoxy fill + copper cap + plate over
34d06f3b-99b5-44c2-8efc-7dcf99e70cb4 | 93.8 | 121.2 | HALL_5V | 0.6 | 0.3 | no-pad-overlap |  | ALL plated vias: epoxy fill + copper cap + plate over
b2fcae10-1604-47bc-9c1b-f877af7bbb4a | 99.4 | 124.2 | HALL_5V | 0.6 | 0.3 | no-pad-overlap |  | ALL plated vias: epoxy fill + copper cap + plate over
da1f3da6-3ffa-45c5-ade5-3810cb8a1baa | 88.3 | 115.7 | HALL_5V | 0.6 | 0.3 | no-pad-overlap |  | ALL plated vias: epoxy fill + copper cap + plate over
2bcd424b-ee57-47d8-b518-be93500836a0 | 87.3 | 111.4 | HALL_5V | 0.6 | 0.3 | no-pad-overlap |  | ALL plated vias: epoxy fill + copper cap + plate over
e7851090-b856-492f-b7bf-cd0c25c0c78f | 79.2 | 104.5 | HALL_5V | 0.6 | 0.3 | no-pad-overlap |  | ALL plated vias: epoxy fill + copper cap + plate over
d07a1b62-bcd8-4dbb-bd36-7d4c960b748e | 78.5 | 105.2 | HALL_5V | 0.6 | 0.3 | no-pad-overlap |  | ALL plated vias: epoxy fill + copper cap + plate over
cbb380ac-edc4-4a54-a653-190114281708 | 61.8 | 104.3 | HALL_5V | 0.6 | 0.3 | no-pad-overlap |  | ALL plated vias: epoxy fill + copper cap + plate over
06016470-26a7-43d0-bddd-b703e7d15534 | 60.9 | 105.2 | HALL_5V | 0.6 | 0.3 | no-pad-overlap |  | ALL plated vias: epoxy fill + copper cap + plate over
94738b3b-8028-4579-8138-be71c9c8f4e5 | 49.3 | 89.2 | HALL_5V | 0.6 | 0.3 | mounted-center-in-pad | U_HA1.1 | ALL plated vias: epoxy fill + copper cap + plate over
ecf3060c-830b-49d9-bb43-dec4a876c850 | 50.4 | 89.2 | HALL_5V | 0.6 | 0.3 | no-pad-overlap |  | ALL plated vias: epoxy fill + copper cap + plate over
06265d36-53d3-4191-8911-3d11667f0ae1 | 81.3 | 89.2 | HALL_5V | 0.6 | 0.3 | mounted-center-in-pad | U_HC1.1 | ALL plated vias: epoxy fill + copper cap + plate over
a1e76474-c9e4-43e0-b1da-23796d35b352 | 82.4 | 89.2 | HALL_5V | 0.6 | 0.3 | no-pad-overlap |  | ALL plated vias: epoxy fill + copper cap + plate over
68123a99-cd80-4c39-a74e-e67c1a443030 | 101.8 | 123.6 | HALL_5V | 0.6 | 0.3 | no-pad-overlap |  | ALL plated vias: epoxy fill + copper cap + plate over
c7b56618-14a6-40f5-a719-2dd77af37be2 | 106.2 | 122.3 | HALL_5V | 0.6 | 0.3 | no-pad-overlap |  | ALL plated vias: epoxy fill + copper cap + plate over
1af2bc53-31f4-4228-b8f4-fe800429c455 | 106.8 | 120.5 | HALL_5V | 0.6 | 0.3 | no-pad-overlap |  | ALL plated vias: epoxy fill + copper cap + plate over
759d1dc9-2783-4f17-85dc-5c8e44dc8567 | 105.4 | 120.2 | HALL_5V | 0.6 | 0.3 | mounted-center-in-pad | C_MUX_B.1 | ALL plated vias: epoxy fill + copper cap + plate over
9459cfb0-f587-45df-af48-596b4e6c6d49 | 111.6 | 122.3 | HALL_5V | 0.6 | 0.3 | no-pad-overlap |  | ALL plated vias: epoxy fill + copper cap + plate over
63d5e520-9bd3-4458-a38c-b058d4179297 | 117.7 | 122.3 | HALL_5V | 0.6 | 0.3 | no-pad-overlap |  | ALL plated vias: epoxy fill + copper cap + plate over
8cb9d1db-c5d6-48d4-9912-adf0f565506a | 119.3 | 106.2 | HALL_5V | 0.6 | 0.3 | no-pad-overlap |  | ALL plated vias: epoxy fill + copper cap + plate over
748637dd-b38b-415f-9307-49d21ea29a77 | 120.3 | 106.2 | HALL_5V | 0.6 | 0.3 | mounted-center-in-pad | C_HA5.1 | ALL plated vias: epoxy fill + copper cap + plate over
c90fdb2f-dbe3-41d3-a3a7-3daf842e8a2e | 134.0 | 105.5 | HALL_5V | 0.6 | 0.3 | no-pad-overlap |  | ALL plated vias: epoxy fill + copper cap + plate over
a743461a-b6bf-4e3d-93e1-1bef1351902c | 134.7 | 106.2 | HALL_5V | 0.6 | 0.3 | no-pad-overlap |  | ALL plated vias: epoxy fill + copper cap + plate over
1b29d33a-c60b-4f32-bd64-d8e2760503f6 | 138.8 | 105.3 | HALL_5V | 0.6 | 0.3 | no-pad-overlap |  | ALL plated vias: epoxy fill + copper cap + plate over
c454ea0d-2fae-4eec-940d-b99fc96ace05 | 139.5 | 106.0 | HALL_5V | 0.6 | 0.3 | no-pad-overlap |  | ALL plated vias: epoxy fill + copper cap + plate over
b2822d3c-4b73-4df3-b5b4-985c3c88099d | 116.4 | 89.4 | HALL_5V | 0.6 | 0.3 | mounted-drill-edge | U_HA4.1 | ALL plated vias: epoxy fill + copper cap + plate over
fc02aba0-292c-4aee-8012-0772791fc416 | 116.4 | 87.3 | HALL_5V | 0.6 | 0.3 | no-pad-overlap |  | ALL plated vias: epoxy fill + copper cap + plate over
87cc15bd-7f74-4c91-8354-ea902c29c828 | 148.6 | 89.0 | HALL_5V | 0.6 | 0.3 | no-pad-overlap |  | ALL plated vias: epoxy fill + copper cap + plate over
37377f2f-7520-4c14-a8da-3c08d3753b17 | 149.6 | 89.0 | HALL_5V | 0.6 | 0.3 | mounted-center-in-pad | U_HC4.1 | ALL plated vias: epoxy fill + copper cap + plate over
7b065d2e-33f2-4a2f-bbee-a53dfaffd45e | 119.9 | 121.7 | HALL_5V | 0.6 | 0.3 | no-pad-overlap |  | ALL plated vias: epoxy fill + copper cap + plate over
3b7b9aa7-90ab-4093-81bb-0441b2e88b69 | 122.1 | 120.9 | HALL_5V | 0.6 | 0.3 | no-pad-overlap |  | ALL plated vias: epoxy fill + copper cap + plate over
5eabf020-3f48-4884-a50b-3c75a04c35b3 | 96.6 | 107.2 | MUX_A0 | 0.6 | 0.3 | no-pad-overlap |  | ALL plated vias: epoxy fill + copper cap + plate over
5e8f3ace-67fd-4ea3-9559-35a8774a42f4 | 97.6 | 106.2 | MUX_A0 | 0.6 | 0.3 | no-pad-overlap |  | ALL plated vias: epoxy fill + copper cap + plate over
c19dfffe-98fe-4dc0-9d82-0da84e3bc0bd | 96.6 | 117.5 | MUX_A0 | 0.6 | 0.3 | no-pad-overlap |  | ALL plated vias: epoxy fill + copper cap + plate over
f5371eef-afe7-4f26-a5ca-fd04e48f79a6 | 98.1 | 117.6 | MUX_A0 | 0.6 | 0.3 | no-pad-overlap |  | ALL plated vias: epoxy fill + copper cap + plate over
74f1f3cb-48be-4348-bf5f-fa514b1a091b | 99.0 | 121.6 | MUX_A0 | 0.6 | 0.3 | no-pad-overlap |  | ALL plated vias: epoxy fill + copper cap + plate over
7f1cb5d5-b844-4909-a324-4329d21c7161 | 101.9 | 125.8 | MUX_A0 | 0.6 | 0.3 | no-pad-overlap |  | ALL plated vias: epoxy fill + copper cap + plate over
214481d0-3d14-4dc1-8e05-ce8c35be3c10 | 85.0 | 117.6 | MUX_A0 | 0.6 | 0.3 | no-pad-overlap |  | ALL plated vias: epoxy fill + copper cap + plate over
205404d0-9830-4f39-9855-2286fb75584f | 81.3 | 117.8 | MUX_A0 | 0.6 | 0.3 | no-pad-overlap |  | ALL plated vias: epoxy fill + copper cap + plate over
e1e8bba3-32d2-4388-88c3-049cec48ebc4 | 80.1 | 119.8 | MUX_A0 | 0.6 | 0.3 | no-pad-overlap |  | ALL plated vias: epoxy fill + copper cap + plate over
ebb7f0f5-0ec5-4c7b-a580-bb2b6a44706e | 110.9 | 123.3 | MUX_A0 | 0.6 | 0.3 | no-pad-overlap |  | ALL plated vias: epoxy fill + copper cap + plate over
01115066-f8a4-431d-b2a7-c8d603a89c80 | 116.2 | 120.9 | MUX_A0 | 0.6 | 0.3 | no-pad-overlap |  | ALL plated vias: epoxy fill + copper cap + plate over
64ff59ed-c42b-4baa-b120-75996a1191f3 | 64.3 | 90.9 | H_B1_RAW | 0.6 | 0.3 | mounted-drill-edge | U_HB1.2 | ALL plated vias: epoxy fill + copper cap + plate over
226f24a9-246b-41d3-8e84-2eb053c47699 | 63.5 | 90.1 | H_B1_RAW | 0.6 | 0.3 | no-pad-overlap |  | ALL plated vias: epoxy fill + copper cap + plate over
5d255e29-2616-48ec-b6d0-c97b9e2e3eaf | 48.6 | 74.7 | H_A0_RAW | 0.6 | 0.3 | mounted-drill-edge | U_HA0.2 | ALL plated vias: epoxy fill + copper cap + plate over
38525675-662f-4bcd-b20e-c4ce8fadb2cc | 47.7 | 74.0 | H_A0_RAW | 0.6 | 0.3 | no-pad-overlap |  | ALL plated vias: epoxy fill + copper cap + plate over
f942aea3-2d2d-4f0e-ba82-cfced8d5bf3c | 64.6 | 74.7 | H_B0_RAW | 0.6 | 0.3 | mounted-drill-edge | U_HB0.2 | ALL plated vias: epoxy fill + copper cap + plate over
337dc1e4-6876-4ae6-8979-1a0304334c5f | 63.8 | 73.9 | H_B0_RAW | 0.6 | 0.3 | no-pad-overlap |  | ALL plated vias: epoxy fill + copper cap + plate over
af93bced-0739-4738-9068-a7bcd830c730 | 88.8 | 114.3 | H_A3_RAW | 0.6 | 0.3 | no-pad-overlap |  | ALL plated vias: epoxy fill + copper cap + plate over
e62b86c7-bcac-4a6d-b5db-88e3146155e1 | 89.5 | 113.6 | H_A3_RAW | 0.6 | 0.3 | no-pad-overlap |  | ALL plated vias: epoxy fill + copper cap + plate over
8541a6fa-bc69-4d22-956a-3231c4a0044c | 96.6 | 106.1 | H_A3_RAW | 0.6 | 0.3 | no-pad-overlap |  | ALL plated vias: epoxy fill + copper cap + plate over
2d708de8-897f-4b88-9001-22ffec5ac409 | 97.3 | 105.4 | H_A3_RAW | 0.6 | 0.3 | no-pad-overlap |  | ALL plated vias: epoxy fill + copper cap + plate over
61c81e7b-5e7e-4283-8379-a2adfa445548 | 113.8 | 73.2 | H_A3_RAW | 0.6 | 0.3 | bare-testpad | TP_H17_DIAG_RAW.1 | ALL plated vias: epoxy fill + copper cap + plate over
dc2fd63a-b82c-4f21-bfb8-08359384a5ca | 115.4 | 73.4 | H_A3_RAW | 0.6 | 0.3 | no-pad-overlap |  | ALL plated vias: epoxy fill + copper cap + plate over
8c3cdaf8-4c57-4e44-b187-f3a5b4c6d2a1 | 102.9 | 119.7 | MUX_A1 | 0.6 | 0.3 | mounted-center-in-pad | U_MUX_B.16 | ALL plated vias: epoxy fill + copper cap + plate over
6077465e-3fce-4f6f-a9e2-d23b9abe9647 | 102.7 | 111.2 | MUX_A1 | 0.6 | 0.3 | no-pad-overlap |  | ALL plated vias: epoxy fill + copper cap + plate over
7a2ce958-63f6-4dd9-a938-10cb07d0df64 | 89.0 | 117.0 | MUX_A1 | 0.6 | 0.3 | no-pad-overlap |  | ALL plated vias: epoxy fill + copper cap + plate over
5bc9ea8e-6bc7-4790-a71f-03ffd4222caf | 108.2 | 118.8 | MUX_A1 | 0.6 | 0.3 | no-pad-overlap |  | ALL plated vias: epoxy fill + copper cap + plate over
7aeb36ba-1aa6-471b-85ff-c1c74eff96e6 | 118.8 | 119.1 | MUX_A1 | 0.6 | 0.3 | no-pad-overlap |  | ALL plated vias: epoxy fill + copper cap + plate over
5f6eb903-9de3-45bd-807d-52160e6f4bb8 | 120.3 | 119.7 | MUX_A1 | 0.6 | 0.3 | mounted-center-in-pad | U_MUX_C.16 | ALL plated vias: epoxy fill + copper cap + plate over
32b05409-1bec-42df-a4b9-569b3d8984dd | 113.9 | 118.8 | MUX_A1 | 0.6 | 0.3 | no-pad-overlap |  | ALL plated vias: epoxy fill + copper cap + plate over
2ef9f71e-565b-4b21-8a48-c706b06dc87a | 110.3 | 124.2 | MUX_A1 | 0.6 | 0.3 | no-pad-overlap |  | ALL plated vias: epoxy fill + copper cap + plate over
5c5db28b-9282-44e4-b8c5-1ae1aeee4b28 | 104.0 | 120.3 | MUX_A2 | 0.6 | 0.3 | no-pad-overlap |  | ALL plated vias: epoxy fill + copper cap + plate over
32cd5910-0b25-4974-a5be-b73baeb3ce2b | 104.3 | 119.0 | MUX_A2 | 0.6 | 0.3 | no-pad-overlap |  | ALL plated vias: epoxy fill + copper cap + plate over
d0def45a-da7d-4f4e-bda9-c69b80b11fe6 | 111.1 | 110.9 | MUX_A2 | 0.6 | 0.3 | no-pad-overlap |  | ALL plated vias: epoxy fill + copper cap + plate over
9a1be861-ceba-43c4-ae18-50e7ba93a056 | 110.5 | 110.1 | MUX_A2 | 0.6 | 0.3 | no-pad-overlap |  | ALL plated vias: epoxy fill + copper cap + plate over
7154ff5d-9075-4c9a-80d4-a93ce24dbcca | 110.5 | 98.9 | MUX_A2 | 0.6 | 0.3 | no-pad-overlap |  | ALL plated vias: epoxy fill + copper cap + plate over
eeec7912-e085-440d-9759-d06c59dfbf28 | 106.8 | 95.2 | MUX_A2 | 0.6 | 0.3 | no-pad-overlap |  | ALL plated vias: epoxy fill + copper cap + plate over
67ec0c4a-10a0-4920-82bd-d304a2441861 | 106.0 | 65.0 | MUX_A2 | 0.6 | 0.3 | no-pad-overlap |  | ALL plated vias: epoxy fill + copper cap + plate over
ea38acdc-a169-434f-80bb-9a37be6c8832 | 106.0 | 63.6 | MUX_A2 | 0.6 | 0.3 | bare-testpad | TP_W_A2.1 | ALL plated vias: epoxy fill + copper cap + plate over
68faa353-aa52-41e7-b9a9-c414308c75b5 | 100.9 | 119.7 | MUX_A2 | 0.6 | 0.3 | no-pad-overlap |  | ALL plated vias: epoxy fill + copper cap + plate over
a40acdbe-223e-4966-9289-0bfab9bd6f98 | 98.1 | 116.4 | MUX_A2 | 0.6 | 0.3 | no-pad-overlap |  | ALL plated vias: epoxy fill + copper cap + plate over
755a0cf1-0e84-43a4-ae21-bb892782f53c | 96.4 | 116.4 | MUX_A2 | 0.6 | 0.3 | no-pad-overlap |  | ALL plated vias: epoxy fill + copper cap + plate over
c9bbe35f-ca40-45b3-8f57-bc107809ed0a | 94.6 | 118.0 | MUX_A2 | 0.6 | 0.3 | no-pad-overlap |  | ALL plated vias: epoxy fill + copper cap + plate over
edf2fcd6-9547-49b5-ba76-67106298500a | 92.3 | 120.3 | MUX_A2 | 0.6 | 0.3 | no-pad-overlap |  | ALL plated vias: epoxy fill + copper cap + plate over
a6d30d4d-6421-4cb2-b4f4-b6b22375a91d | 119.8 | 120.2 | MUX_A2 | 0.6 | 0.3 | no-pad-overlap |  | ALL plated vias: epoxy fill + copper cap + plate over
b2fafae8-74e0-4765-bd31-a1e90834cdf8 | 119.3 | 125.8 | MUX_A2 | 0.6 | 0.3 | no-pad-overlap |  | ALL plated vias: epoxy fill + copper cap + plate over
c8ab82d9-8400-4431-96bf-b49decfe737c | 102.2 | 134.8 | MUX_A2 | 0.6 | 0.3 | no-pad-overlap |  | ALL plated vias: epoxy fill + copper cap + plate over
4552b27c-bda2-4e6d-82c8-4c9932894d11 | 102.2 | 133.6 | MUX_A2 | 0.6 | 0.3 | mounted-drill-edge | J_WING.6 | ALL plated vias: epoxy fill + copper cap + plate over
bc950abb-6013-4dec-9c46-9b5c6d101d4d | 115.1 | 128.9 | MUX_OUT_C | 0.6 | 0.3 | no-pad-overlap |  | ALL plated vias: epoxy fill + copper cap + plate over
c4147ebe-279c-466d-8f4d-2915207162fd | 115.1 | 124.9 | MUX_OUT_C | 0.6 | 0.3 | no-pad-overlap |  | ALL plated vias: epoxy fill + copper cap + plate over
