ihsinoky/he-piantor-42/hardware/kicad/qualification/issue-157-main-dual-wing-stage1/dual-wing-dc.csv

load_case | pitch_mm | sensor_mA | temperature_C | width_factor | wings | branch_A | total_A | contact_ohm | return_conductors | harness_loop_ohm | main_common_loop_ohm | switch_ohm | switch_drop_V | harness_drop_V | wing_drop_V | main_drop_V | total_drop_V | local_at_source_4V75_V | local_at_source_5V_V | required_source_for_4V5_V | main_loop_budget_at_source_4V75_ohm | switch_loss_W
component-5mA | 16 | 5.0 | 20 | 1.0 | 1 | 0.10500810000000001 | 0.10500810000000001 | 0.03 | 6 | 0.09501803482587065 | 0 | 0.15 | 0.015751215 | 0.009977663302798508 | 0.04751701409205168 | 0.0 | 0.07324589239485019 | 4.6767541076051495 | 4.9267541076051495 | 4.5732458923948505 | 1.6832426032387007 | 0.0016540051598415001
component-5mA | 16 | 5.0 | 20 | 1.0 | 2 | 0.10500810000000001 | 0.21001620000000001 | 0.03 | 6 | 0.09501803482587065 | 0 | 0.15 | 0.03150243 | 0.009977663302798508 | 0.04751701409205168 | 0.0 | 0.08899710739485019 | 4.66100289260515 | 4.91100289260515 | 4.58899710739485 | 0.7666213016193504 | 0.0066160206393660005
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
