ihsinoky/he-piantor-42/hardware/kicad/qualification/issue-155-main-mounting-stage2/pofv-sites.csv

x_mm | y_mm | net | uuid | diameter_mm | drill_mm | classification | pads | drill_overlaps_mounted_pad | drill_overlaps_paste
111.0 | 104.5 | ADC_A | 0a1aeb75-dbbc-4666-a714-b507884f3873 | 0.6 | 0.3 | mounted-center-in-pad | C20.1 | True | True
115.0 | 104.7 | ADC_B | 6c72ee84-83d0-4821-a545-48d43a0366ef | 0.6 | 0.3 | mounted-center-in-pad | C21.1 | True | True
88.8 | 107.0 | GND | 140bcb0a-4fc9-42d4-81c8-d605cc70f9e6 | 0.6 | 0.3 | mounted-center-in-pad | C19.2 | True | True
95.0 | 102.5 | GND | 1aabe013-9faa-4607-b034-4e5864dcb551 | 0.6 | 0.3 | mounted-annulus-only | C5.2 | False | False
103.5 | 94.0 | GND | 3d0ae31f-a5d4-424e-9330-77e2872640c6 | 0.6 | 0.3 | mounted-center-in-pad | C11.2 | True | True
100.0 | 100.0 | GND | 3f1a2a53-dcf9-4e5c-a401-e1144ba2280b | 0.6 | 0.3 | mounted-center-in-pad | U1.57 | True | True
103.6 | 90.1 | GND | 4a53048b-4b79-4320-8169-5f5b95688f81 | 0.6 | 0.3 | mounted-drill-edge-overlap | U3.4 | True | True
84.8 | 97.0 | GND | 5482d3e4-db29-465c-93c5-22cf85846fc6 | 0.6 | 0.3 | mounted-center-in-pad | C17.2 | True | True
116.9 | 116.0 | GND | 7141241f-ea30-421d-8434-1a37fc1eb82d | 0.6 | 0.3 | mounted-center-in-pad | J2.2 | True | True
94.8 | 99.0 | GND | a3cd7182-c4b5-4832-bfb7-24ac2fd39dc6 | 0.6 | 0.3 | mounted-drill-edge-overlap | C4.2 | True | True
109.4 | 116.0 | GND | a672f59b-1684-40fc-a5ff-75dc74b9fde7 | 0.6 | 0.3 | mounted-center-in-pad | J2.8 | True | True
114.4 | 116.0 | GND | ad4205a8-43e2-455b-958d-faee476fcb5f | 0.6 | 0.3 | mounted-center-in-pad | J2.4 | True | True
106.0 | 96.5 | GND | b64c421b-e698-4c68-9613-54605ed26fe5 | 0.6 | 0.3 | mounted-center-in-pad | C10.2 | True | True
83.7 | 92.0 | GND | c6b86a04-f4c7-4964-9382-eca92d4cadc5 | 0.6 | 0.3 | mounted-center-in-pad | U2.2 | True | True
86.2 | 102.1 | GND | c9382b91-8a68-422a-8c1f-6328f3455fdf | 0.6 | 0.3 | mounted-center-in-pad | Y1.2 | True | True
100.6 | 99.8 | GND | d7a7a8f1-f5da-431e-ac9f-0d0d0d67ed6b | 0.6 | 0.3 | mounted-center-in-pad | U1.57 | True | True
104.5 | 106.1 | GND | ee5122bf-1426-4aee-b15d-b7334a3b8d1c | 0.6 | 0.3 | mounted-center-in-pad | C7.2 | True | True
87.0 | 106.8 | HALL_5V | 69f5b359-0e13-4b43-9eb6-478db8c59be6 | 0.6 | 0.3 | mounted-center-in-pad | C19.1 | True | True
97.0 | 118.0 | QSPI_SS_FLASH | e88620e8-03a6-4b54-b3d7-a981f9cfc04b | 0.6 | 0.3 | bare-testpad | TP4.1 | False | True
108.1 | 100.0 | V1V1 | 2e0bea8f-e11c-4977-be5e-58e35c24313e | 0.6 | 0.3 | mounted-drill-edge-overlap | C13.1 | True | False
103.4 | 97.3 | V3V3 | 4887251a-f851-4542-97ca-46355c3a4c67 | 0.6 | 0.3 | mounted-center-in-pad | U1.42 | True | True
93.5 | 99.2 | V3V3 | 83b6e9ed-f13d-4984-8aac-1d3fee6bd3fb | 0.6 | 0.3 | mounted-center-in-pad | C4.1 | True | True
99.7 | 106.0 | V3V3 | c273949e-2771-4daf-9e42-da5813aa1954 | 0.6 | 0.3 | mounted-center-in-pad | C6.1 | True | True
81.2 | 99.0 | VBUS | 479ac357-71d2-46db-a774-93f771d5d835 | 0.6 | 0.3 | mounted-center-in-pad | U4.1 | True | True
110.2 | 116.0 | WING_EN | bbad44c7-8958-4112-9a3a-0ef11ec779c8 | 0.6 | 0.3 | mounted-drill-edge-overlap | J2.7 | True | False
