ihsinoky/he-piantor-42/hardware/kicad/qualification/issue-183-via-pad-audit/main-rev2/all-vias.csv

uuid | x_mm | y_mm | net | diameter_mm | drill_mm | layers | classification | min_annulus_gap_mm | min_physical_gap_mm | passes_0p10 | nearest_pad | nearest_pad_uuid | nearest_pad_kind | nearest_pad_layers | hit_pads | hit_kinds
004177fe-0229-42ea-bdca-67cf28a36573 | 102.2 | 76.4 | MUX_EN1 | 0.6 | 0.3 | ["F.Cu", "In1.Cu", "In2.Cu", "B.Cu"] | none | 2.250122 | 2.250122 | True | J3.10 | bc640559-a87e-46ca-bb3d-33c8f81ddda2 | mounted | ["F.Cu"] | [] | []
01041baf-038c-4cf3-bf66-cc7c59c65f51 | 92.8 | 93.6 | MUX_EN1 | 0.6 | 0.3 | ["F.Cu", "In1.Cu", "In2.Cu", "B.Cu"] | none | 0.789151 | 0.789151 | True | R4.2 | f93039c5-7d11-47d6-b34d-b5523da971c7 | mounted | ["F.Cu"] | [] | []
030cb1bf-4241-4cb2-bcb1-31afdf81ccce | 84.7 | 71.4 | HALL_PWR_EN | 0.6 | 0.3 | ["F.Cu", "In1.Cu", "In2.Cu", "B.Cu"] | none | 0.1 | 0.1 | True | U6.14 | 7e531421-41e4-4533-8c7f-a8cbd737988e | mounted | ["F.Cu"] | [] | []
05a840ca-c309-4196-8d4e-1b0f94b37d6f | 80.0 | 105.85 | V5V2 | 0.6 | 0.3 | ["F.Cu", "In1.Cu", "In2.Cu", "B.Cu"] | none | 0.422253 | 0.422253 | True | U5.1 | 27b3828e-5989-4b5a-a432-2043d0d6da25 | mounted | ["F.Cu"] | [] | []
0cca3dd3-30f4-4f90-99e2-4654965b172c | 103.6 | 90.1 | GND | 0.6 | 0.3 | ["F.Cu", "In1.Cu", "In2.Cu", "B.Cu"] | drill-edge | -0.277001 | 0 | False | U3.4 | c49c573d-fecb-4876-9cf9-d0df5b00e2f7 | mounted | ["F.Cu"] | ["U3.4"] | ["mounted"]
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
f973aad1-3d2e-4173-80d5-2397eff6f418 | 99.4 | 81.0 | GND | 0.6 | 0.3 | ["F.Cu", "In1.Cu", "In2.Cu", "B.Cu"] | center | -0.3 | 0 | False | C28.2 | 32582a56-ba55-4720-959a-0e897fee0023 | mounted | ["F.Cu"] | ["C28.2"] | ["mounted"]
