ihsinoky/he-piantor-42/hardware/kicad/qualification/issue-167-main-dual-wing-stage2/resume/pofv-sites.csv

x_mm | y_mm | net | uuid | diameter_mm | drill_mm | classification | pads | drill_overlaps_mounted_pad | drill_overlaps_paste
111.0 | 104.5 | ADC_A | 602ef846-6204-4819-bb22-6927a61bd279 | 0.6 | 0.3 | mounted-center-in-pad | C20.1 | True | True
115.0 | 104.7 | ADC_B | 9fdda59f-b32f-4ec1-bc0f-8ca826d9edd2 | 0.6 | 0.3 | mounted-center-in-pad | C21.1 | True | True
115.0 | 107.7 | ADC_B | bb36583c-2c08-4ad9-9a84-16589297d1ee | 0.6 | 0.3 | mounted-center-in-pad | R13.1 | True | True
119.0 | 104.7 | ADC_C | b9bfedbf-352d-40cc-8beb-2e2994ee8592 | 0.6 | 0.3 | mounted-center-in-pad | C22.1 | True | True
119.0 | 106.2 | GND | 0733e78b-1dfc-4977-80df-998dbda6e287 | 0.6 | 0.3 | mounted-center-in-pad | R15.2 | True | True
94.3 | 101.9 | GND | 2a2a90fd-776e-4780-b9c4-e89727a2c67a | 0.6 | 0.3 | mounted-center-in-pad | C5.2 | True | True
100.0 | 100.0 | GND | 2c1b52dd-2a13-4e65-9219-bc4e328f05a5 | 0.6 | 0.3 | mounted-center-in-pad | U1.57 | True | True
94.5 | 108.7 | GND | 94a3ebfe-7d91-430e-92eb-2b801db990af | 0.6 | 0.3 | mounted-center-in-pad | R16.2 | True | False
106.0 | 96.4 | GND | 990b5687-9dbd-40b6-92c9-2b345906eb4f | 0.6 | 0.3 | mounted-center-in-pad | C10.2 | True | True
94.5 | 99.0 | GND | a732e977-72f6-4209-9b59-f8e064cf2b4d | 0.6 | 0.3 | mounted-center-in-pad | C4.2 | True | True
84.8 | 97.0 | GND | b6e8d67d-8b36-4c1c-a122-6c796a2ec14e | 0.6 | 0.3 | mounted-center-in-pad | C17.2 | True | True
79.0 | 86.2 | GND | bd2d2783-dd3e-4af7-af75-8caa2c7e96cc | 0.6 | 0.3 | mounted-center-in-pad | R1.2 | True | True
119.0 | 103.5 | GND | e894e7e4-3cfa-4b6a-9698-31937b618649 | 0.6 | 0.3 | mounted-center-in-pad | C22.2 | True | True
106.4 | 73.0 | MUX_A2 | f92cc985-8231-4b03-a2c6-3bf8380dd617 | 0.6 | 0.3 | mounted-annulus-only | J3.6 | False | False
111.6 | 111.8 | MUX_OUT_A | f1be94ca-6ec1-4bf8-adfa-25bdfa364874 | 0.6 | 0.3 | mounted-drill-edge-overlap | R10.1 | True | False
108.3 | 90.2 | QSPI_SS_FLASH | 8e39314e-5360-4b48-9572-6690366591bf | 0.6 | 0.3 | mounted-annulus-only | R5.2 | False | False
97.0 | 118.0 | QSPI_SS_FLASH | ba4bd2a6-c465-4598-a198-48cbfaf4406e | 0.6 | 0.3 | bare-testpad | TP4.1 | False | True
108.1 | 100.0 | V1V1 | 3db5ac4e-6f69-466f-984b-1a8ac11855f8 | 0.6 | 0.3 | mounted-drill-edge-overlap | C13.1 | True | False
93.7 | 84.6 | V3V3 | 3495f91f-63d4-4fbe-bfea-3bf98f8dc70e | 0.6 | 0.3 | mounted-center-in-pad | R19.1 | True | False
96.5 | 97.3 | V3V3 | 3763ab7c-486f-4bf3-a9ef-3a2a7eef3220 | 0.6 | 0.3 | mounted-center-in-pad | U1.1 | True | True
106.0 | 103.6 | V3V3 | a46cef88-d5da-445d-82c8-c74f8de48011 | 0.6 | 0.3 | mounted-center-in-pad | C8.1 | True | True
99.5 | 106.0 | V3V3 | cf41539c-fb74-48cd-aa7b-34fdb0bbf318 | 0.6 | 0.3 | mounted-center-in-pad | C6.1 | True | True
85.8 | 72.3 | VBUS | 10aae309-3daa-423e-bd20-16daad68394b | 0.6 | 0.3 | mounted-center-in-pad | U6.12;U6.12 | True | False
87.5 | 85.4 | VBUS | a899c096-c89f-4416-8ef6-2f958ec2d07d | 0.6 | 0.3 | mounted-center-in-pad | J1.11 | True | True
93.3 | 108.8 | MUX_EN1 | bcc54737-1855-4c41-b6cf-60105cb72234 | 0.6 | 0.3 | mounted-center-in-pad | R16.1 | True | False
82.6 | 76.6 | FB_5V2 | 3f6a1c19-dcef-4c63-8c0a-208c3f235295 | 0.6 | 0.3 | mounted-center-in-pad | R17.2 | True | False
