ihsinoky/he-piantor-42/hardware/kicad/qualification/issue-93-freerouting-v250-jar/evidence/smoke-pass-history.csv

pass_number | unrouted | violations | log_line
1 | 0 | 0 | Auto-routing pass #1 on board 'eb8c7b5997777d1d62e584a1b43575ae' was completed in 0.30 seconds with score 1000.00 (0 unrouted and 0 violations)
2 | 0 | 0 | Auto-routing pass #2 on board '15b1380a139ec35961c90ad66d5a1a4f' was completed in 0.00 seconds with score 1000.00 (0 unrouted and 0 violations)
