ihsinoky/he-piantor-42/hardware/kicad/qualification/issue-235-wing-round2/wing-rev4-16mm-left/round3/power-sensitivity.csv

board | main_branch | actual_assembly_branch | temperature_C | track_width_factor | length_mm | load_A | wing_far_terminal | wing_drop_V | wing_effective_loop_ohm | harness_wire_ohm | harness_loop_ohm | harness_drop_V | main_common_and_switch_drop_V | main_branch_drop_V | Vfar_V | margin_to_4p60_V
wing-rev4-16mm-left | J2 | J2 | 20 | 1.0 | 123.39470408176 | 0.127 | U_HA4 | 0.014458948603754476 | 0.11384998900594076 | 0.026460797177532636 | 0.14753759670712144 | 0.01873727478180442 | 0.07292694822833748 | 0.00044079972649223943 | 4.939436028659612 | 0.33943602865961253
wing-rev4-16mm-left | J3 | J2 | 20 | 1.0 | 123.39470408176 | 0.127 | U_HA4 | 0.014458948603754476 | 0.11384998900594076 | 0.026460797177532636 | 0.14753759670712144 | 0.01873727478180442 | 0.07292694822833748 | 0.0035848866982861063 | 4.936291941687818 | 0.3362919416878185
wing-rev4-16mm-left | J2 | J2 | 20 | 1.0 | 124.09716799907045 | 0.127 | U_HA4 | 0.014458948603754476 | 0.11384998900594076 | 0.02661143374965141 | 0.14771333937459333 | 0.018759594100573353 | 0.07292694822833748 | 0.00044079972649223943 | 4.939413709340843 | 0.33941370934084336
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
