ihsinoky/he-piantor-42/hardware/kicad/qualification/issue-226-main-rev6/inspection/final/audit/via-pad/all-vias.csv

uuid | x_mm | y_mm | net | diameter_mm | drill_mm | layers | classification | min_annulus_gap_mm | min_physical_gap_mm | passes_0p10 | nearest_pad | nearest_pad_uuid | nearest_pad_kind | nearest_pad_layers | hit_pads | hit_kinds
0060a646-207f-465a-9a18-abc50fa4a990 | 84.1 | 116.6 | GND | 0.6 | 0.3 | ["F.Cu", "In1.Cu", "In2.Cu", "B.Cu"] | none | 0.303589 | 0.303589 | True | J2.5 | cc4313e9-b239-4bb8-8354-f6387c6d163c | mounted | ["F.Cu"] | [] | []
041875c9-cc5d-4c5b-aeff-8c87045535b9 | 114.2 | 123.7 | ADC_B | 0.6 | 0.3 | ["F.Cu", "In1.Cu", "In2.Cu", "B.Cu"] | none | 0.18 | 0.18 | True | C21.1 | a71413b5-6386-4afa-b8fe-80f8116d2866 | mounted | ["F.Cu"] | [] | []
04982c99-027b-4d5d-be6b-dc0f9e4f062c | 98.2 | 116.5 | QSPI_SD2 | 0.6 | 0.3 | ["F.Cu", "In1.Cu", "In2.Cu", "B.Cu"] | none | 0.2 | 0.2 | True | U1.54 | cac0140f-1ae3-44d5-8952-d48d1a160788 | mounted | ["F.Cu"] | [] | []
04eec6fd-d424-4f75-b6f3-a2a181a3b1bd | 111.0 | 127.8 | MUX_OUT_A | 0.6 | 0.3 | ["F.Cu", "In1.Cu", "In2.Cu", "B.Cu"] | none | 0.275 | 0.275 | True | R11.1 | eb2bb125-d770-4168-a3da-a6547589d12c | mounted | ["F.Cu"] | [] | []
0630f19a-a790-40f7-9025-58c1800bfc49 | 82.3 | 113.5 | MUX_A0 | 0.6 | 0.3 | ["F.Cu", "In1.Cu", "In2.Cu", "B.Cu"] | none | 0.506349 | 0.506349 | True | J2.6 | d5fe0d3a-dcde-43d5-992d-b1964e95d75b | mounted | ["F.Cu"] | [] | []
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
fe3dd601-d649-40a8-95f3-abbe50fd773d | 87.2 | 127.0 | HALL_5V | 0.6 | 0.3 | ["F.Cu", "In1.Cu", "In2.Cu", "B.Cu"] | none | 0.225 | 0.225 | True | C19.1 | 2a850556-7885-4590-b7e3-46474b8d39a2 | mounted | ["F.Cu"] | [] | []
ffc0f8ae-045b-4668-8c11-2a5253392cf4 | 86.6 | 114.7 | VBUS | 0.6 | 0.3 | ["F.Cu", "In1.Cu", "In2.Cu", "B.Cu"] | none | 0.25 | 0.25 | True | U4.1 | 6a94a843-5c6d-4cfa-8b7b-93568b960fd7 | mounted | ["F.Cu"] | [] | []
