ihsinoky/he-piantor-42/hardware/kicad/qualification/issue-196-main-rev4-phaseb/inspection/auto01/audit/via-pad/pad-hits.csv

via_uuid | ref | pad | pad_uuid | pad_kind | pad_net | same_net | common_layers | center_to_pad_mm | annulus_gap_mm | physical_copper_gap_mm | classification
8666f08c-32a9-484e-a921-694042623510 | J2 | 7 | 8657a919-cb24-403b-971a-5d56f6f20a55 | mounted | WING_EN | True | ["F.Cu"] | 0.0 | -0.3 | 0 | center
