ihsinoky/he-piantor-42/hardware/case/issue-228-outline/17mm-shelf-profile.csv

arclength_mm | shelf_mm | curve_x_mm | curve_y_mm | pcb_x_mm | pcb_y_mm
0.0 | 2.651930323645346 | -144.85065074419109 | -2.2473642092153208 | -142.24432974624284 | -1.7576445984952933
0.006780882020479942 | 2.6541514623556477 | -144.8540096823561 | -2.2414737172681862 | -142.24432974624284 | -1.7576445984952933
0.013561764040959884 | 2.6563880532598465 | -144.85736862052113 | -2.235583225321052 | -142.24432974624284 | -1.7576445984952933
0.020342646061439824 | 2.6586400573602385 | -144.86072755868614 | -2.2296927333739176 | -142.24432974624284 | -1.7576445984952933
0.027123528081919767 | 2.6609074355229305 | -144.86408649685114 | -2.2238022414267835 | -142.24432974624284 | -1.7576445984952933
0.03390441010239971 | 2.6631901484805933 | -144.86744543501618 | -2.217911749479649 | -142.24432974624284 | -1.7576445984952933
0.04068529212287965 | 2.6654881568352082 | -144.8708043731812 | -2.212021257532515 | -142.24432974624284 | -1.7576445984952933
0.047466174143359595 | 2.667801421061081 | -144.87416331134622 | -2.2061307655853803 | -142.24432974624284 | -1.7576445984952933
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
