ihsinoky/he-piantor-42/hardware/case/issue-200-rev3/keys-17mm-left.csv

key | sensor | x_mm | y_mm | kicad_x_mm | kicad_y_mm | rotation_deg | hall_origin_x_mm | hall_origin_y_mm | hall_side
L_R0_C0 | U_HA0 | -51.944444444 | 26.0 | 48.055555556 | 74.0 | 0.0 | -51.944444444 | 26.0 | bottom
L_R0_C1 | U_HB0 | -34.944444444 | 26.0 | 65.055555556 | 74.0 | 0.0 | -34.944444444 | 26.0 | bottom
L_R0_C2 | U_HC0 | -17.944444444 | 38.0 | 82.055555556 | 62.0 | 0.0 | -17.944444444 | 38.0 | bottom
L_R0_C3 | U_HA1 | -0.944444444 | 43.0 | 99.055555556 | 57.0 | 0.0 | -0.944444444 | 43.0 | bottom
L_R0_C4 | U_HB1 | 16.055555556 | 38.0 | 116.055555556 | 62.0 | 0.0 | 16.055555556 | 38.0 | bottom
L_R0_C5 | U_HC1 | 33.055555556 | 36.0 | 133.055555556 | 64.0 | 0.0 | 33.055555556 | 36.0 | bottom
L_R1_C0 | U_HA2 | -51.944444444 | 9.0 | 48.055555556 | 91.0 | 0.0 | -51.944444444 | 9.0 | bottom
L_R1_C1 | U_HB2 | -34.944444444 | 9.0 | 65.055555556 | 91.0 | 0.0 | -34.944444444 | 9.0 | bottom
L_R1_C2 | U_HC2 | -17.944444444 | 21.0 | 82.055555556 | 79.0 | 0.0 | -17.944444444 | 21.0 | bottom
L_R1_C3 | U_HA3 | -0.944444444 | 26.0 | 99.055555556 | 74.0 | 0.0 | -0.944444444 | 26.0 | bottom
L_R1_C4 | U_HB3 | 16.055555556 | 21.0 | 116.055555556 | 79.0 | 0.0 | 16.055555556 | 21.0 | bottom
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
