ihsinoky/he-piantor-42/hardware/case/issue-188-crosscheck/wing-keys-check.csv

pitch_mm | key | sensor | x_mm | y_mm | dx_mm | dy_mm | rotation_deg | layer
16 | L_R0_C0 | U_HA0 | 56.0 | 65.0 | 0.0 | 0.0 | 0 | F.Cu
16 | L_R0_C3 | U_HA1 | 104.0 | 61.0 | 0.0 | 0.0 | 0 | F.Cu
16 | L_R1_C0 | U_HA2 | 56.0 | 81.0 | 0.0 | 0.0 | 0 | F.Cu
16 | L_R1_C3 | U_HA3 | 104.0 | 77.0 | 0.0 | 0.0 | 0 | F.Cu
16 | L_R2_C0 | U_HA4 | 56.0 | 97.0 | 0.0 | 0.0 | 0 | F.Cu
16 | L_R2_C3 | U_HA5 | 104.0 | 93.0 | 0.0 | 0.0 | 0 | F.Cu
16 | L_T0 | U_HA6 | 112.0 | 113.0 | 0.0 | 0.0 | 0 | F.Cu
16 | L_R0_C1 | U_HB0 | 72.0 | 65.0 | 0.0 | 0.0 | 0 | F.Cu
16 | L_R0_C4 | U_HB1 | 120.0 | 63.0 | 0.0 | 0.0 | 0 | F.Cu
16 | L_R1_C1 | U_HB2 | 72.0 | 81.0 | 0.0 | 0.0 | 0 | F.Cu
16 | L_R1_C4 | U_HB3 | 120.0 | 79.0 | 0.0 | 0.0 | 0 | F.Cu
16 | L_R2_C1 | U_HB4 | 72.0 | 97.0 | 0.0 | 0.0 | 0 | F.Cu
16 | L_R2_C4 | U_HB5 | 120.0 | 95.0 | 0.0 | 0.0 | 0 | F.Cu
16 | L_T1 | U_HB6 | 128.0 | 117.0 | 0.0 | 0.0 | 0 | F.Cu
16 | L_R0_C2 | U_HC0 | 88.0 | 63.0 | 0.0 | 0.0 | 0 | F.Cu
16 | L_R0_C5 | U_HC1 | 136.0 | 65.0 | 0.0 | 0.0 | 0 | F.Cu
16 | L_R1_C2 | U_HC2 | 88.0 | 79.0 | 0.0 | 0.0 | 0 | F.Cu
16 | L_R1_C5 | U_HC3 | 136.0 | 81.0 | 0.0 | 0.0 | 0 | F.Cu
16 | L_R2_C2 | U_HC4 | 88.0 | 95.0 | 0.0 | 0.0 | 0 | F.Cu
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
