ihsinoky/he-piantor-42/hardware/case/issue-230-mount-study/16mm-right/per-key.csv

key | option | nearest_support_mm | bend_bracket_low_mm | bend_bracket_high_mm | load_N
R_R0_C0 | baseline | 21.831071412351427 | 0.009408089466969907 | 0.07526471573575925 | 1
R_R0_C1 | baseline | 29.989185293421823 | 0.024387668924680913 | 0.1951013513974473 | 1
R_R0_C2 | baseline | 38.50705513677545 | 0.05162941549010299 | 0.4130353239208239 | 1
R_R0_C3 | baseline | 46.16409272141052 | 0.08895885856126308 | 0.7116708684901046 | 1
R_R0_C4 | baseline | 43.033512110763915 | 0.07206039911655986 | 0.5764831929324788 | 1
R_R0_C5 | baseline | 28.53742870392312 | 0.021014584440413726 | 0.1681166755233098 | 1
R_R1_C0 | baseline | 37.56322242581416 | 0.047925297067201916 | 0.38340237653761533 | 1
R_R1_C1 | baseline | 38.52288080721622 | 0.05169309779128435 | 0.4135447823302748 | 1
R_R1_C2 | baseline | 32.17701491405417 | 0.03012406272919364 | 0.24099250183354912 | 1
R_R1_C3 | baseline | 30.251007533485353 | 0.025032015503339597 | 0.20025612402671678 | 1
R_R1_C4 | baseline | 28.044097416092118 | 0.019943468382248822 | 0.15954774705799057 | 1
R_R1_C5 | baseline | 36.58340189955132 | 0.044271939914894406 | 0.35417551931915525 | 1
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
