ihsinoky/he-piantor-42/hardware/case/issue-230-mount-study/17mm-left/per-key.csv

key | option | nearest_support_mm | bend_bracket_low_mm | bend_bracket_high_mm | load_N
L_R0_C0 | baseline | 22.790782195681714 | 0.01007453572715126 | 0.08059628581721008 | 1
L_R0_C1 | baseline | 31.364129861913955 | 0.026257119411950483 | 0.21005695529560386 | 1
L_R0_C2 | baseline | 40.46229764730375 | 0.05637661169208386 | 0.4510128935366709 | 1
L_R0_C3 | baseline | 49.24883278677579 | 0.10165650520868451 | 0.8132520416694761 | 1
L_R0_C4 | baseline | 45.21009938476803 | 0.07864185233955474 | 0.629134818716438 | 1
L_R0_C5 | baseline | 29.668872160643428 | 0.02222544478073183 | 0.17780355824585464 | 1
L_R1_C0 | baseline | 39.537573940379836 | 0.05259898945814427 | 0.42079191566515417 | 1
L_R1_C1 | baseline | 41.733317062651544 | 0.06185802697996741 | 0.4948642158397393 | 1
L_R1_C2 | baseline | 34.79308324876946 | 0.0358447947364222 | 0.2867583578913776 | 1
L_R1_C3 | baseline | 32.37973951192014 | 0.028891321096436093 | 0.23113056877148874 | 1
L_R1_C4 | baseline | 29.569180234896645 | 0.022002154124055463 | 0.1760172329924437 | 1
L_R1_C5 | baseline | 38.330474934023485 | 0.047926967478829775 | 0.3834157398306382 | 1
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
