ihsinoky/he-piantor-42/hardware/case/issue-230-mount-study/17mm-right/floating.csv

key | layout | shore_A | pin_k_N_per_mm | sink_1N_mm | sink_low_mm | sink_high_mm | max_uplift_reaction_per_N | weight_1N_uniform_settle_mm
R_R0_C0 | existing4 | 50 | 3.0 | 0.2580051046017823 | 0.12900255230089114 | 0.5160102092035646 | 0.16851131831452681 | 0.08333333333333333
R_R0_C1 | existing4 | 50 | 3.0 | 0.18023965984866233 | 0.09011982992433117 | 0.36047931969732466 | 0.041045538934843154 | 0.08333333333333333
R_R0_C2 | existing4 | 50 | 3.0 | 0.1408594693748721 | 0.07042973468743605 | 0.2817189387497442 | 0.005893474252283804 | 0.08333333333333333
R_R0_C3 | existing4 | 50 | 3.0 | 0.1396379642633657 | 0.06981898213168285 | 0.2792759285267314 | 0 | 0.08333333333333333
R_R0_C4 | existing4 | 50 | 3.0 | 0.12366715189335631 | 0.061833575946678154 | 0.24733430378671262 | 0 | 0.08333333333333333
R_R0_C5 | existing4 | 50 | 3.0 | 0.14116759965788428 | 0.07058379982894214 | 0.28233519931576856 | 0 | 0.08333333333333333
R_R1_C0 | existing4 | 50 | 3.0 | 0.31749836793019254 | 0.15874918396509627 | 0.6349967358603851 | 0.38350283900032767 | 0.08333333333333333
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
