ihsinoky/he-piantor-42/hardware/case/issue-228-final/16mm/shelf-profile.csv

arclength_mm | shelf_mm | x_mm | y_mm | pcb_x_mm | pcb_y_mm
0.0 | 16.83541466656928 | -138.1481246368038 | -1.8564799662669433 | -123.15439154502846 | 5.7998347456513955
0.006476799422795024 | 16.83571458304642 | -138.1513329859718 | -1.850853650742621 | -123.15439154502846 | 5.7998347456513955
0.012953598845590048 | 16.836016985799525 | -138.15454133513984 | -1.8452273352182986 | -123.15439154502846 | 5.7998347456513955
0.019430398268385073 | 16.836321874694573 | -138.15774968430784 | -1.8396010196939763 | -123.15439154502846 | 5.7998347456513955
0.025907197691180096 | 16.83662924959653 | -138.16095803347585 | -1.833974704169654 | -123.15439154502846 | 5.7998347456513955
0.03238399711397512 | 16.83693911036924 | -138.16416638264386 | -1.8283483886453316 | -123.15439154502846 | 5.7998347456513955
0.038860796536770145 | 16.837251456875485 | -138.1673747318119 | -1.8227220731210094 | -123.15439154502846 | 5.7998347456513955
0.04533759595956517 | 16.837566288976877 | -138.1705830809799 | -1.817095757596687 | -123.15439154502846 | 5.7998347456513955
0.05181439538236019 | 16.83788360653402 | -138.1737914301479 | -1.8114694420723647 | -123.15439154502846 | 5.7998347456513955
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
