ihsinoky/he-piantor-42/hardware/case/issue-190-layout/inputs/piantor-extracted.csv

source_key | source_x_mm | source_y_mm | source_rotation_deg
K00 | 74.0 | 70.0 | 180.0
K01 | 92.0 | 70.0 | 0
K02 | 110.0 | 58.0 | 0
K03 | 128.0 | 53.0 | 0
K04 | 146.0 | 58.0 | 0
K05 | 164.0 | 60.0 | 0
K10 | 74.0 | 87.0 | 180.0
K11 | 92.0 | 87.0 | 0
K12 | 110.0 | 75.0 | 0
K13 | 128.0 | 70.0 | 0
K14 | 146.0 | 75.0 | 0
K15 | 164.0 | 77.0 | 0
K20 | 74.0 | 104.0 | 180.0
K21 | 92.0 | 104.0 | 0
K22 | 110.0 | 92.0 | 0
K23 | 128.0 | 87.0 | 0
K24 | 146.0 | 92.0 | 0
K25 | 164.0 | 94.0 | 0
K30 | 141.0 | 113.0 | 5.0
K31 | 163.0 | 114.0 | -10.0
K32 | 184.0 | 121.0 | -25.0
