ihsinoky/he-piantor-42/hardware/kicad/qualification/issue-185-main-rev3/connector-current-sensitivity.csv

seed | load_class | connector_V | efficiency_assumption | Wing_A | rail_V | converter_V | converter_A | Main_other_allocation_A | total_USB_A | input_loop_ohm | USB_500mA_calculation | conditional_farthest_J2_V | conditional_farthest_J3_V
final | design | 4.5 | 0.75 | 0.127 | 5.2 | 4.429395877926359 | 0.39758619802823264 | 0.11 | 0.5075861980282327 | 0.13909779727642324 | False | 4.8018825521332795 | 4.801722455244881
final | design | 4.5 | 0.75 | 0.127 | 5.304 | 4.428275539244133 | 0.4056405217066982 | 0.11 | 0.5156405217066982 | 0.13909779727642324 | False | 4.8018825521332795 | 4.801722455244881
final | design | 4.5 | 0.75 | 0.127 | 5.354 | 4.427736710438409 | 0.4095142624579859 | 0.11 | 0.5195142624579859 | 0.13909779727642324 | False | 4.8018825521332795 | 4.801722455244881
final | stress-only | 4.5 | 0.75 | 0.2310081 | 5.2 | 4.383040662792707 | 0.7308424827523665 | 0.11 | 0.8408424827523665 | 0.13909779727642324 | False | 4.601959781035116 | 4.601668570972084
final | stress-only | 4.5 | 0.75 | 0.2310081 | 5.304 | 4.380958201983653 | 0.7458136817923907 | 0.11 | 0.8558136817923907 | 0.13909779727642324 | False | 4.601959781035116 | 4.601668570972084
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
