ihsinoky/he-piantor-42/hardware/kicad/qualification/issue-175-main-dual-wing-final2/connector-current-sensitivity.csv

seed | load_class | connector_V | efficiency_assumption | Wing_A | rail_V | converter_V | converter_A | Main_other_allocation_A | total_USB_A | input_loop_ohm | USB_500mA_calculation | conditional_farthest_J2_V | conditional_farthest_J3_V
final | design | 4.5 | 0.75 | 0.127 | 5.2 | 4.431966387033395 | 0.3973556008500019 | 0.11 | 0.5073556008500019 | 0.1340945341938169 | False | 4.801858493374779 | 4.801698292334052
final | design | 4.5 | 0.75 | 0.127 | 5.304 | 4.430887489081352 | 0.40540140195986374 | 0.11 | 0.5154014019598637 | 0.1340945341938169 | False | 4.801858493374779 | 4.801698292334052
final | design | 4.5 | 0.75 | 0.127 | 5.354 | 4.4303685987523185 | 0.4092709879363025 | 0.11 | 0.5192709879363026 | 0.1340945341938169 | False | 4.801858493374779 | 4.801698292334052
final | stress-only | 4.5 | 0.75 | 0.2310081 | 5.2 | 4.3873437385982115 | 0.7301256775981455 | 0.11 | 0.8401256775981455 | 0.1340945341938169 | False | 4.6019160190816555 | 4.601624619569558
final | stress-only | 4.5 | 0.75 | 0.2310081 | 5.304 | 4.385339991552718 | 0.7450684719300678 | 0.11 | 0.8550684719300677 | 0.1340945341938169 | False | 4.6019160190816555 | 4.601624619569558
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
