ihsinoky/he-piantor-42/hardware/kicad/qualification/issue-153-main-mounting-stage1/candidates.csv

candidate | x | y | local_x | local_y | edge_center | hole_ligament | keepout_edge_gap | head_4_5_edge_gap | pad_keepout_gap | track_keepout_gap | via_keepout_gap | courtyard_keepout_gap | provisional_body_keepout_gap | existing_drill_gap | pad_hits | track_hits | via_hits | plane_hit
NW-corner | 79 | 81 | 3.0 | 3.0 | 3.0 | 1.9 | 0.5 | 0.75 | -1.16019 | -0.92 | 9.162023 | 1.995 | -2.0 | 0.43981 | 1 | 2 | 0 | True
NE-corner | 121 | 81 | 45.0 | 3.0 | 3.0 | 1.9 | 0.5 | 0.75 | 11.985381 | 11.649296 | 13.126079 | 11.603103 | 11.285001 | 14.676079 | 0 | 0 | 0 | True
SW-corner | 79 | 119 | 3.0 | 41.0 | 3.0 | 1.9 | 0.5 | 0.75 | 5.955385 | 5.421198 | 8.368259 | 6.120421 | 5.4 | 9.918259 | 0 | 0 | 0 | True
SE-corner | 121 | 119 | 45.0 | 41.0 | 3.0 | 1.9 | 0.5 | 0.75 | -1.975 | 1.214306 | 2.280354 | 4.117537 | -2.5 | 3.830354 | 1 | 0 | 0 | True
W-upper | 79 | 92 | 3.0 | 14.0 | 3.0 | 1.9 | 0.5 | 0.75 | 1.275 | -0.923654 | 1.9 | 0.995 | 0.775 | 3.45 | 0 | 1 | 0 | True
E-middle | 121 | 98 | 45.0 | 20.0 | 3.0 | 1.9 | 0.5 | 0.75 | 2.983685 | 2.699762 | 6.193887 | 2.770829 | 2.365265 | 7.743887 | 0 | 0 | 0 | True
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
