ihsinoky/he-piantor-42/hardware/case/issue-198-stage2/inputs/rev3-stage1b/keys-16mm-right.csv

key | sensor | x_mm | y_mm | kicad_x_mm | kicad_y_mm | rotation_deg | hall_origin_x_mm | hall_origin_y_mm | hall_side
R_R0_C0 | U_HA0 | 48.888888889 | 25.0 | 148.888888889 | 75.0 | -0.0 | 48.888888889 | 25.0 | bottom
R_R0_C1 | U_HB0 | 32.888888889 | 25.0 | 132.888888889 | 75.0 | -0.0 | 32.888888889 | 25.0 | bottom
R_R0_C2 | U_HC0 | 16.888888889 | 36.294117647 | 116.888888889 | 63.705882353 | -0.0 | 16.888888889 | 36.294117647 | bottom
R_R0_C3 | U_HA1 | 0.888888889 | 41.0 | 100.888888889 | 59.0 | -0.0 | 0.888888889 | 41.0 | bottom
R_R0_C4 | U_HB1 | -15.111111111 | 36.294117647 | 84.888888889 | 63.705882353 | -0.0 | -15.111111111 | 36.294117647 | bottom
R_R0_C5 | U_HC1 | -31.111111111 | 34.411764706 | 68.888888889 | 65.588235294 | -0.0 | -31.111111111 | 34.411764706 | bottom
R_R1_C0 | U_HA2 | 48.888888889 | 9.0 | 148.888888889 | 91.0 | -0.0 | 48.888888889 | 9.0 | bottom
R_R1_C1 | U_HB2 | 32.888888889 | 9.0 | 132.888888889 | 91.0 | -0.0 | 32.888888889 | 9.0 | bottom
R_R1_C2 | U_HC2 | 16.888888889 | 20.294117647 | 116.888888889 | 79.70588235299999 | -0.0 | 16.888888889 | 20.294117647 | bottom
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
