ihsinoky/he-piantor-42/hardware/case/issue-198-stage2/inputs/rev3-stage1b/outline-17mm-right.csv

x_mm | y_mm
-63.1 | -38.15636788289575
-63.1 | 51.2
-45.76025403784439 | 51.2
-45.71662136035252 | 51.200190384679146
-45.672992005657974 | 51.200761524218045
-45.62936929630502 | 51.20171337512222
-45.58575655433189 | 51.203045864904524
-45.54215710101771 | 51.204758892090716
-45.498574256629674 | 51.206852326227136
-45.4550113401701 | 51.20932600789067
-45.41147166912376 | 51.21217974870088
-45.367958559205164 | 51.21541333133436
-45.3244753241061 | 51.21902650954127
-45.28102527524327 | 51.22301900816411
-45.23761172150612 | 51.22739052315863
-45.19423796900486 | 51.232140721617064
-45.15090732081865 | 51.23726924179339
-45.10762307674413 | 51.24277569313095
-45.06438853304407 | 51.24865965629215
-45.02120698219634 | 51.25492068319042
-44.97808171264324 | 51.261558297024315
-44.935016008541005 | 51.268571992313845
-44.89201314950974 | 51.27596123493896
-44.84907641038365 | 51.28372546218023
-44.80620906096166 | 51.291864082761684
-44.76341436575841 | 51.300376476895856
-44.72069558375559 | 51.309261996330974
-44.67805596815388 | 51.31851996440034
-44.63549876612507 | 51.32814967607383
-44.59302721856486 | 51.33815039801162
-44.55064455984605 | 51.34852136862002
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
