ihsinoky/he-piantor-42/hardware/kicad/qualification/issue-200-wing-rev3/panel-17mm/pin1.csv

reference | side | origin_x_mm | origin_y_mm | rotation_ccw_deg | pad1_x_mm | pad1_y_mm
R_TP_W_EN | top | 57.663586 | 157.319816 | -30.0 | 57.663586 | 157.319816
L_TP_H_N_RAW | top | 111.230712 | 37.942305 | 30.0 | 111.230712 | 37.942305
R_TP_W_A2 | top | 59.135829 | 158.169816 | -30.0 | 59.135829 | 158.169816
R_TP_W_GND_B | top | 73.858261 | 166.669816 | -30.0 | 73.858261 | 166.669816
L_U_MUX_C | top | 123.477568 | 38.954483 | 30.0 | 119.800817 | 38.450313
L_TP_H_CTR_RAW | top | 109.758468 | 38.792305 | 30.0 | 109.758468 | 38.792305
L_C_MUX_C | top | 125.977568 | 43.28461 | 30.0 | 125.555601 | 42.553742
L_U_MUX_A | top | 106.15706 | 48.954483 | 30.0 | 102.480309 | 48.450313
L_J_WING | top | 108.18334 | 30.464101 | 30.0 | 115.219796 | 26.401601
R_TP_W_MUXA | top | 78.274991 | 169.219816 | -30.0 | 78.274991 | 169.219816
R_TP_W_GND_A | top | 76.802748 | 168.369816 | -30.0 | 76.802748 | 168.369816
R_C_MUX_C | top | 53.222432 | 168.612121 | -30.0 | 53.644399 | 167.881253
R_J_WING | top | 71.01666 | 155.791612 | -30.0 | 78.053116 | 159.854112
R_TP_W_A0 | top | 62.080316 | 159.869816 | -30.0 | 62.080316 | 159.869816
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
