ihsinoky/he-piantor-42/hardware/kicad/qualification/issue-200-wing-rev3/wing-rev3-17mm-left/pin1.csv

reference | side | origin_x_mm | origin_y_mm | rotation_ccw_deg | pad1_x_mm | pad1_y_mm
TP_W_GND_B | top | 117.241739 | 37.171162 | 30.0 | 117.241739 | 37.171162
TP_H_CTR_RAW | top | 121.658468 | 34.621162 | 30.0 | 121.658468 | 34.621162
J_WING | top | 120.08334 | 26.292958 | 30.0 | 127.119796 | 22.230458
TP_W_MUXC | top | 118.713982 | 36.321162 | 30.0 | 118.713982 | 36.321162
TP_W_A2 | top | 131.964171 | 28.671162 | 30.0 | 131.964171 | 28.671162
TP_H_DIAG_RAW | top | 124.602955 | 32.921162 | 30.0 | 124.602955 | 32.921162
U_MUX_C | top | 135.377568 | 34.78334 | 30.0 | 131.700817 | 34.27917
TP_W_MUXA | top | 112.825009 | 39.721162 | 30.0 | 112.825009 | 39.721162
TP_W_GND_C | top | 120.186225 | 35.471162 | 30.0 | 120.186225 | 35.471162
TP_W_H5V | top | 126.075198 | 32.071162 | 30.0 | 126.075198 | 32.071162
U_MUX_B | top | 126.717314 | 39.78334 | 30.0 | 123.040563 | 39.27917
TP_H_N_RAW | top | 123.130712 | 33.771162 | 30.0 | 123.130712 | 33.771162
TP_W_MUXB | top | 115.769496 | 38.021162 | 30.0 | 115.769496 | 38.021162
TP_W_A1 | top | 130.491927 | 29.521162 | 30.0 | 130.491927 | 29.521162
U_MUX_A | top | 118.05706 | 44.78334 | 30.0 | 114.380309 | 44.27917
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
