ihsinoky/he-piantor-42/hardware/kicad/qualification/issue-200-wing-rev3/wing-rev3-17mm-right/pin1.csv

reference | side | origin_x_mm | origin_y_mm | rotation_ccw_deg | pad1_x_mm | pad1_y_mm
C_MUX_B | top | 70.782686 | 44.113467 | -30.0 | 71.204653 | 43.382599
U_MUX_A | top | 81.94294 | 44.78334 | -30.0 | 80.541189 | 41.347095
TP_W_H5V | top | 73.924802 | 32.071162 | -30.0 | 73.924802 | 32.071162
TP_W_GND_C | top | 79.813775 | 35.471162 | -30.0 | 79.813775 | 35.471162
J_WING | top | 79.91666 | 26.292958 | -30.0 | 86.953116 | 30.355458
TP_W_A0 | top | 70.980316 | 30.371162 | -30.0 | 70.980316 | 30.371162
TP_W_GND_A | top | 85.702748 | 38.871162 | -30.0 | 85.702748 | 38.871162
TP_W_MUXA | top | 87.174991 | 39.721162 | -30.0 | 87.174991 | 39.721162
TP_W_MUXC | top | 81.286018 | 36.321162 | -30.0 | 81.286018 | 36.321162
TP_W_GND | top | 72.452559 | 31.221162 | -30.0 | 72.452559 | 31.221162
TP_W_GND_B | top | 82.758261 | 37.171162 | -30.0 | 82.758261 | 37.171162
TP_W_A1 | top | 69.508073 | 29.521162 | -30.0 | 69.508073 | 29.521162
TP_W_MUXB | top | 84.230504 | 38.021162 | -30.0 | 84.230504 | 38.021162
TP_H_CTR_RAW | top | 78.341532 | 34.621162 | -30.0 | 78.341532 | 34.621162
TP_H_N_RAW | top | 76.869288 | 33.771162 | -30.0 | 76.869288 | 33.771162
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
