ihsinoky/he-piantor-42/hardware/kicad/qualification/issue-194-wing-rev2/wing-rev2-16mm-left/pin1.csv

reference | side | origin_x_mm | origin_y_mm | rotation_ccw_deg | pad1_x_mm | pad1_y_mm
TP_W_A0 | top | 85.0 | 132.3 | 0.0 | 85.0 | 132.3
C_MUX_C | top | 105.0 | 129.0 | 0.0 | 105.0 | 128.156066
TP_W_GND_A | top | 55.0 | 132.3 | 0.0 | 55.0 | 132.3
TP_W_A2 | top | 91.0 | 132.3 | 0.0 | 91.0 | 132.3
J_WING | top | 63.0 | 123.0 | 0.0 | 71.125 | 123.0
TP_H_DIAG_RAW | top | 76.0 | 132.3 | 0.0 | 76.0 | 132.3
TP_H_CTR_RAW | top | 70.0 | 132.3 | 0.0 | 70.0 | 132.3
TP_W_GND_B | top | 61.0 | 132.3 | 0.0 | 61.0 | 132.3
TP_W_A1 | top | 88.0 | 132.3 | 0.0 | 88.0 | 132.3
TP_W_H5V | top | 79.0 | 132.3 | 0.0 | 79.0 | 132.3
U_MUX_C | top | 100.0 | 129.0 | 0.0 | 97.067925 | 126.725
TP_W_EN | top | 94.0 | 132.3 | 0.0 | 94.0 | 132.3
U_MUX_A | top | 81.0 | 123.0 | 0.0 | 78.067925 | 120.725
U_MUX_B | top | 93.0 | 123.0 | 0.0 | 90.067925 | 120.725
TP_W_GND | top | 82.0 | 132.3 | 0.0 | 82.0 | 132.3
TP_W_GND_C | top | 67.0 | 132.3 | 0.0 | 67.0 | 132.3
TP_W_MUXA | top | 52.0 | 132.3 | 0.0 | 52.0 | 132.3
TP_W_MUXC | top | 64.0 | 132.3 | 0.0 | 64.0 | 132.3
TP_H_N_RAW | top | 73.0 | 132.3 | 0.0 | 73.0 | 132.3
C_MUX_B | top | 98.0 | 123.0 | 0.0 | 98.0 | 122.156066
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
