ihsinoky/he-piantor-42/hardware/kicad/qualification/issue-194-wing-rev2/wing-rev2-17mm-right/pin1.csv

reference | side | origin_x_mm | origin_y_mm | rotation_ccw_deg | pad1_x_mm | pad1_y_mm
C_MUX_B | top | 102.0 | 123.0 | 0.0 | 102.0 | 122.156066
U_MUX_A | top | 119.0 | 123.0 | 0.0 | 116.067925 | 120.725
TP_W_H5V | top | 121.0 | 132.3 | 0.0 | 121.0 | 132.3
TP_W_GND_C | top | 133.0 | 132.3 | 0.0 | 133.0 | 132.3
J_WING | top | 137.0 | 123.0 | 0.0 | 145.125 | 123.0
TP_W_A0 | top | 115.0 | 132.3 | 0.0 | 115.0 | 132.3
TP_W_GND_A | top | 145.0 | 132.3 | 0.0 | 145.0 | 132.3
TP_W_MUXA | top | 148.0 | 132.3 | 0.0 | 148.0 | 132.3
TP_W_MUXC | top | 136.0 | 132.3 | 0.0 | 136.0 | 132.3
TP_W_GND | top | 118.0 | 132.3 | 0.0 | 118.0 | 132.3
TP_W_GND_B | top | 139.0 | 132.3 | 0.0 | 139.0 | 132.3
TP_W_A1 | top | 112.0 | 132.3 | 0.0 | 112.0 | 132.3
TP_W_MUXB | top | 142.0 | 132.3 | 0.0 | 142.0 | 132.3
TP_H_CTR_RAW | top | 130.0 | 132.3 | 0.0 | 130.0 | 132.3
TP_H_N_RAW | top | 127.0 | 132.3 | 0.0 | 127.0 | 132.3
TP_W_A2 | top | 109.0 | 132.3 | 0.0 | 109.0 | 132.3
U_MUX_B | top | 107.0 | 123.0 | 0.0 | 104.067925 | 120.725
U_MUX_C | top | 100.0 | 129.0 | 0.0 | 97.067925 | 126.725
C_MUX_A | top | 114.0 | 123.0 | 0.0 | 114.0 | 122.156066
TP_H_DIAG_RAW | top | 124.0 | 132.3 | 0.0 | 124.0 | 132.3
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
