ihsinoky/he-piantor-42/hardware/kicad/qualification/issue-99-fastroute-width-floor/evidence/main-pass-history.csv

line | elapsed_s | pass_number | pass_seconds | score | unrouted | violations | scope
19 | 3.104 | 1 | 1.36 | 548.72 | 44 | 0 | first run
21 | 3.909 | 2 | 0.8 | 138.46 | 103 | 0 | first run
23 | 4.246 | 3 | 0.33 | 610.26 | 38 | 0 | first run
25 | 4.701 | 4 | 0.45 | 620.51 | 37 | 0 | first run
27 | 4.849 | 5 | 0.15 | 620.51 | 37 | 0 | first run
28 | 4.999 | 6 | 0.15 | 620.51 | 37 | 0 | first run
29 | 5.168 | 7 | 0.17 | 620.51 | 37 | 0 | first run
30 | 5.319 | 8 | 0.15 | 620.51 | 37 | 0 | first run
31 | 5.44 | 9 | 0.12 | 620.51 | 37 | 0 | first run
32 | 5.637 | 10 | 0.2 | 620.51 | 37 | 0 | first run
33 | 5.751 | 11 | 0.11 | 620.51 | 37 | 0 | first run
34 | 5.905 | 12 | 0.14 | 620.51 | 37 | 0 | first run
35 | 6.021 | 13 | 0.12 | 620.51 | 37 | 0 | first run
36 | 6.125 | 14 | 0.1 | 620.51 | 37 | 0 | first run
37 | 6.285 | 15 | 0.16 | 620.51 | 37 | 0 | first run
38 | 6.416 | 16 | 0.13 | 620.51 | 37 | 0 | first run
39 | 6.519 | 17 | 0.1 | 620.51 | 37 | 0 | first run
40 | 6.642 | 18 | 0.12 | 620.51 | 37 | 0 | first run
80 | 12.911 | 1 | 2.42 | 497.44 | 49 | 0 | parallel variants (identity not logged)
81 | 13.425 | 1 | 3.02 | 446.15 | 54 | 0 | parallel variants (identity not logged)
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
