ihsinoky/he-piantor-42/hardware/case/issue-194-layout/inputs/stage1/hardware/case/issue-190-layout/coordinates-16mm.csv

key | sensor | x_mm | y_mm | kicad_x_mm | kicad_y_mm | rotation_deg
L_R0_C0 | U_HA0 | -48.888888889 | 25.0 | 51.111111111 | 75.0 | 0
L_R0_C1 | U_HB0 | -32.888888889 | 25.0 | 67.111111111 | 75.0 | 0
L_R0_C2 | U_HC0 | -16.888888889 | 36.294117647 | 83.111111111 | 63.705882353 | 0
L_R0_C3 | U_HA1 | -0.888888889 | 41.0 | 99.111111111 | 59.0 | 0
L_R0_C4 | U_HB1 | 15.111111111 | 36.294117647 | 115.111111111 | 63.705882353 | 0
L_R0_C5 | U_HC1 | 31.111111111 | 34.411764706 | 131.111111111 | 65.588235294 | 0
L_R1_C0 | U_HA2 | -48.888888889 | 9.0 | 51.111111111 | 91.0 | 0
L_R1_C1 | U_HB2 | -32.888888889 | 9.0 | 67.111111111 | 91.0 | 0
L_R1_C2 | U_HC2 | -16.888888889 | 20.294117647 | 83.111111111 | 79.705882353 | 0
L_R1_C3 | U_HA3 | -0.888888889 | 25.0 | 99.111111111 | 75.0 | 0
L_R1_C4 | U_HB3 | 15.111111111 | 20.294117647 | 115.111111111 | 79.705882353 | 0
L_R1_C5 | U_HC3 | 31.111111111 | 18.411764706 | 131.111111111 | 81.588235294 | 0
L_R2_C0 | U_HA4 | -48.888888889 | -7.0 | 51.111111111 | 107.0 | 0
L_R2_C1 | U_HB4 | -32.888888889 | -7.0 | 67.111111111 | 107.0 | 0
L_R2_C2 | U_HC4 | -16.888888889 | 4.294117647 | 83.111111111 | 95.705882353 | 0
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
