ihsinoky/he-piantor-42/hardware/case/issue-194-layout/inputs/stage1/hardware/case/issue-190-layout/coordinates-u.csv

source_key | key | source_x_mm | source_y_mm | x_u_exact | y_u_exact | x_u | y_u | source_rotation_deg
K00 | L_R0_C0 | 74.0 | 70.0 | 0 | 1 | 0.0 | 1.0 | 0
K01 | L_R0_C1 | 92.0 | 70.0 | 1 | 1 | 1.0 | 1.0 | 0
K02 | L_R0_C2 | 110.0 | 58.0 | 2 | 5/17 | 2.0 | 0.294117647 | 0
K03 | L_R0_C3 | 128.0 | 53.0 | 3 | 0 | 3.0 | 0.0 | 0
K04 | L_R0_C4 | 146.0 | 58.0 | 4 | 5/17 | 4.0 | 0.294117647 | 0
K05 | L_R0_C5 | 164.0 | 60.0 | 5 | 7/17 | 5.0 | 0.411764706 | 0
K10 | L_R1_C0 | 74.0 | 87.0 | 0 | 2 | 0.0 | 2.0 | 0
K11 | L_R1_C1 | 92.0 | 87.0 | 1 | 2 | 1.0 | 2.0 | 0
K12 | L_R1_C2 | 110.0 | 75.0 | 2 | 22/17 | 2.0 | 1.294117647 | 0
K13 | L_R1_C3 | 128.0 | 70.0 | 3 | 1 | 3.0 | 1.0 | 0
K14 | L_R1_C4 | 146.0 | 75.0 | 4 | 22/17 | 4.0 | 1.294117647 | 0
K15 | L_R1_C5 | 164.0 | 77.0 | 5 | 24/17 | 5.0 | 1.411764706 | 0
K20 | L_R2_C0 | 74.0 | 104.0 | 0 | 3 | 0.0 | 3.0 | 0
K21 | L_R2_C1 | 92.0 | 104.0 | 1 | 3 | 1.0 | 3.0 | 0
K22 | L_R2_C2 | 110.0 | 92.0 | 2 | 39/17 | 2.0 | 2.294117647 | 0
K23 | L_R2_C3 | 128.0 | 87.0 | 3 | 2 | 3.0 | 2.0 | 0
K24 | L_R2_C4 | 146.0 | 92.0 | 4 | 39/17 | 4.0 | 2.294117647 | 0
K25 | L_R2_C5 | 164.0 | 94.0 | 5 | 41/17 | 5.0 | 2.411764706 | 0
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
