ihsinoky/he-piantor-42/hardware/case/issue-228-final/16mm/north-wall-closeup.png

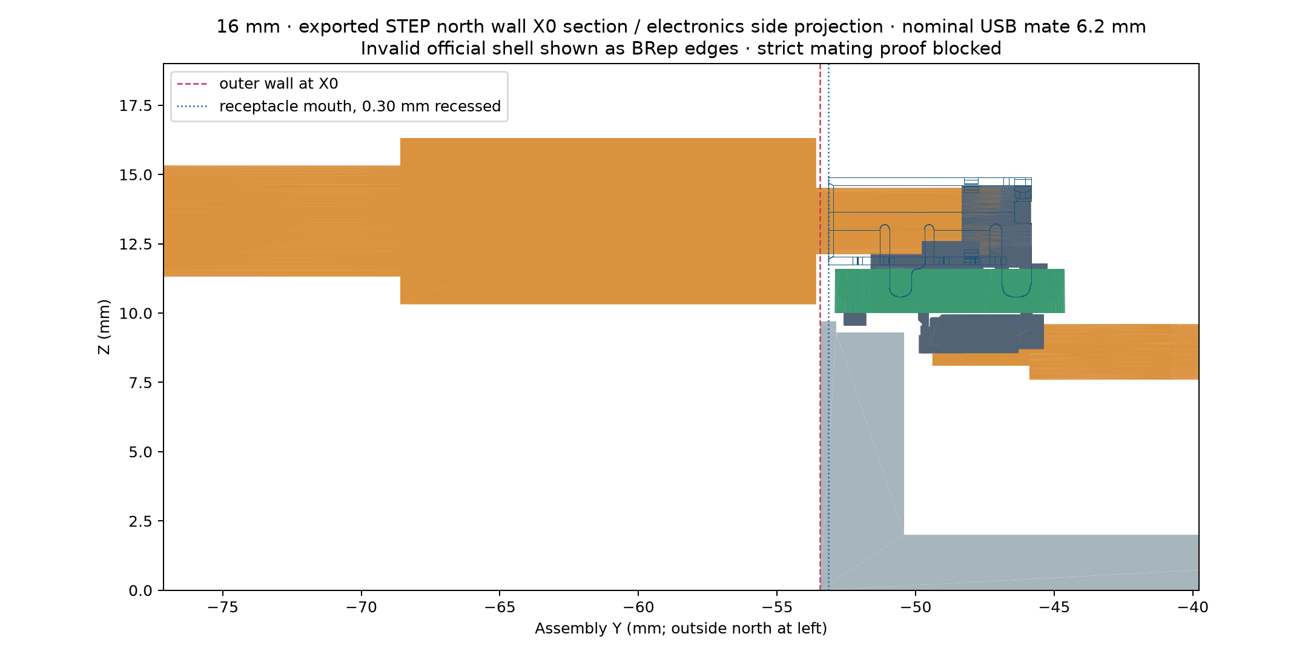
hardware/case/issue-228-final/16mm/north-wall-closeup.png
