ihsinoky/he-piantor-42/hardware/case/issue-228-outline/17mm-outline-overlay.png

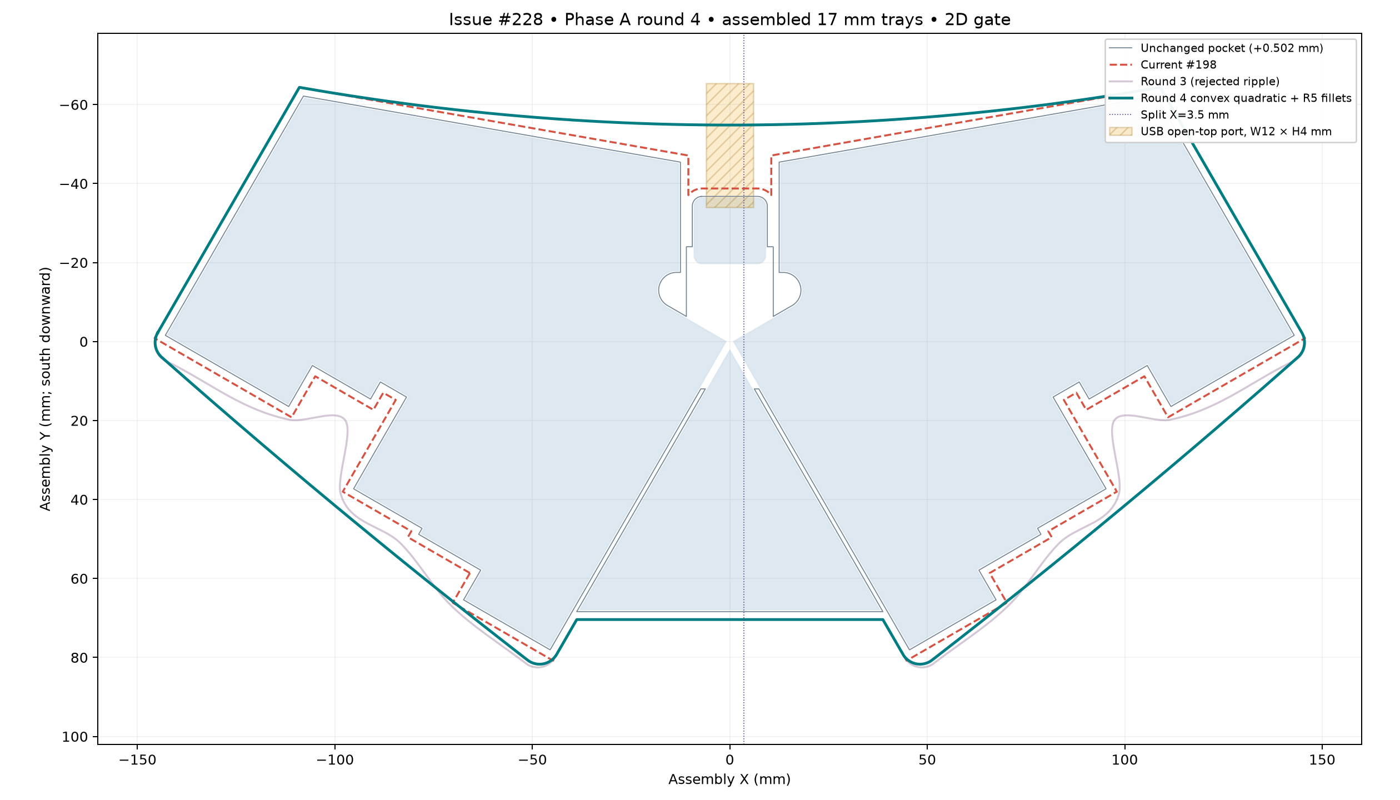
hardware/case/issue-228-outline/17mm-outline-overlay.png
