ihsinoky/he-piantor-42/hardware/case/issue-230-mount-study/recommendation.png

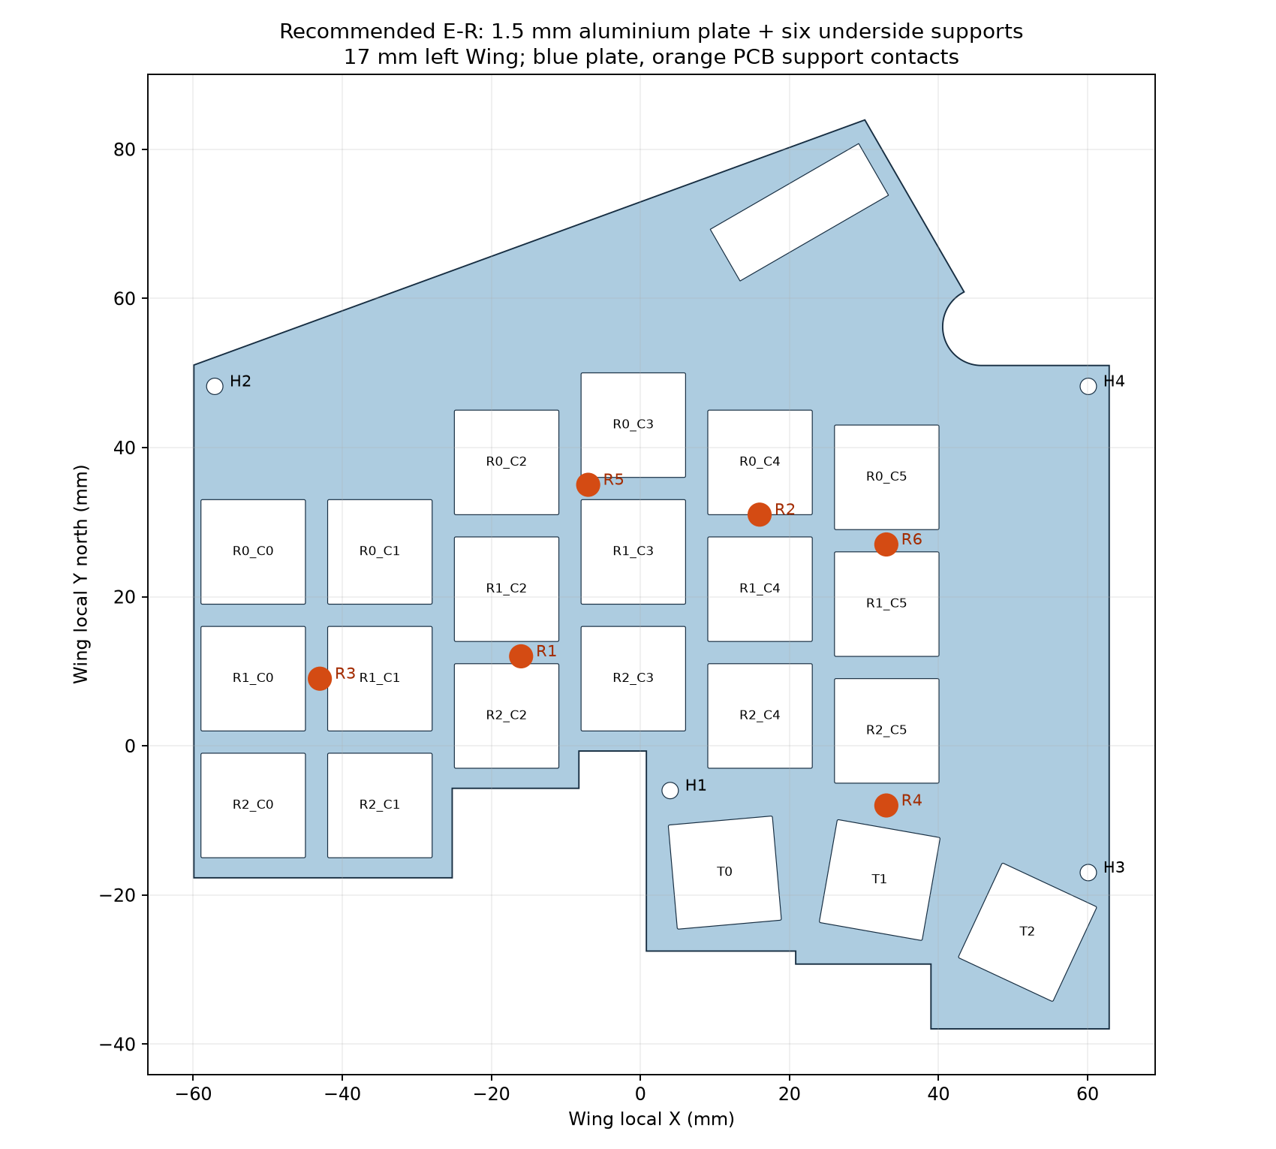
hardware/case/issue-230-mount-study/recommendation.png
