ihsinoky/he-piantor-42/hardware/case/issue-232-final/16mm/review-section.png

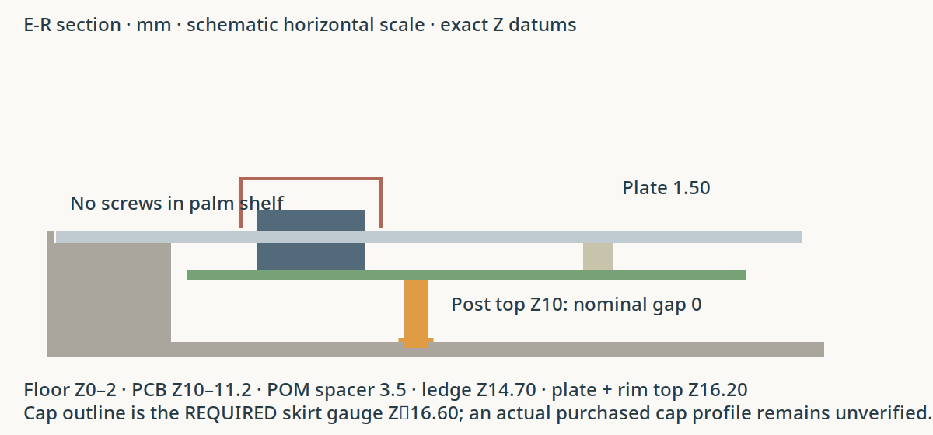
hardware/case/issue-232-final/16mm/review-section.png
