ihsinoky/he-piantor-42/hardware/case/issue-238-bay-study/section-gh.png

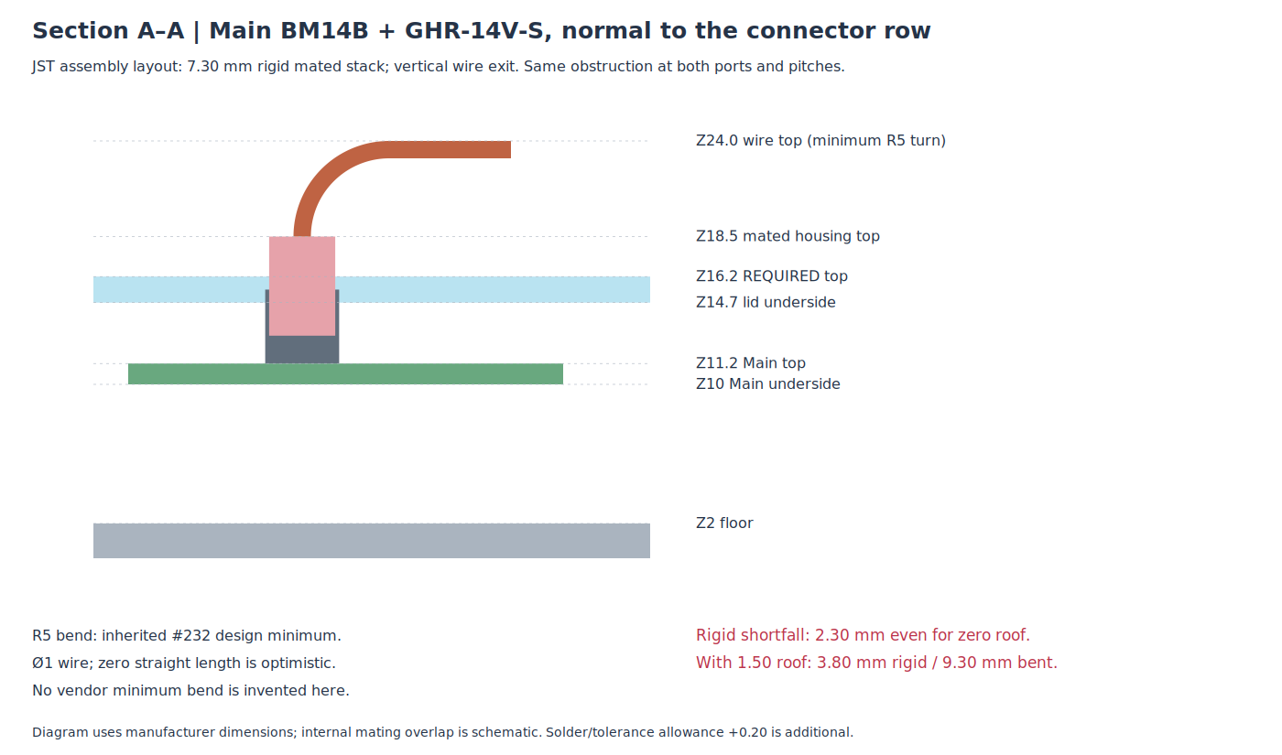
hardware/case/issue-238-bay-study/section-gh.png
