ihsinoky/he-piantor-42/hardware/case/issue-238-bay-study/top-view.png

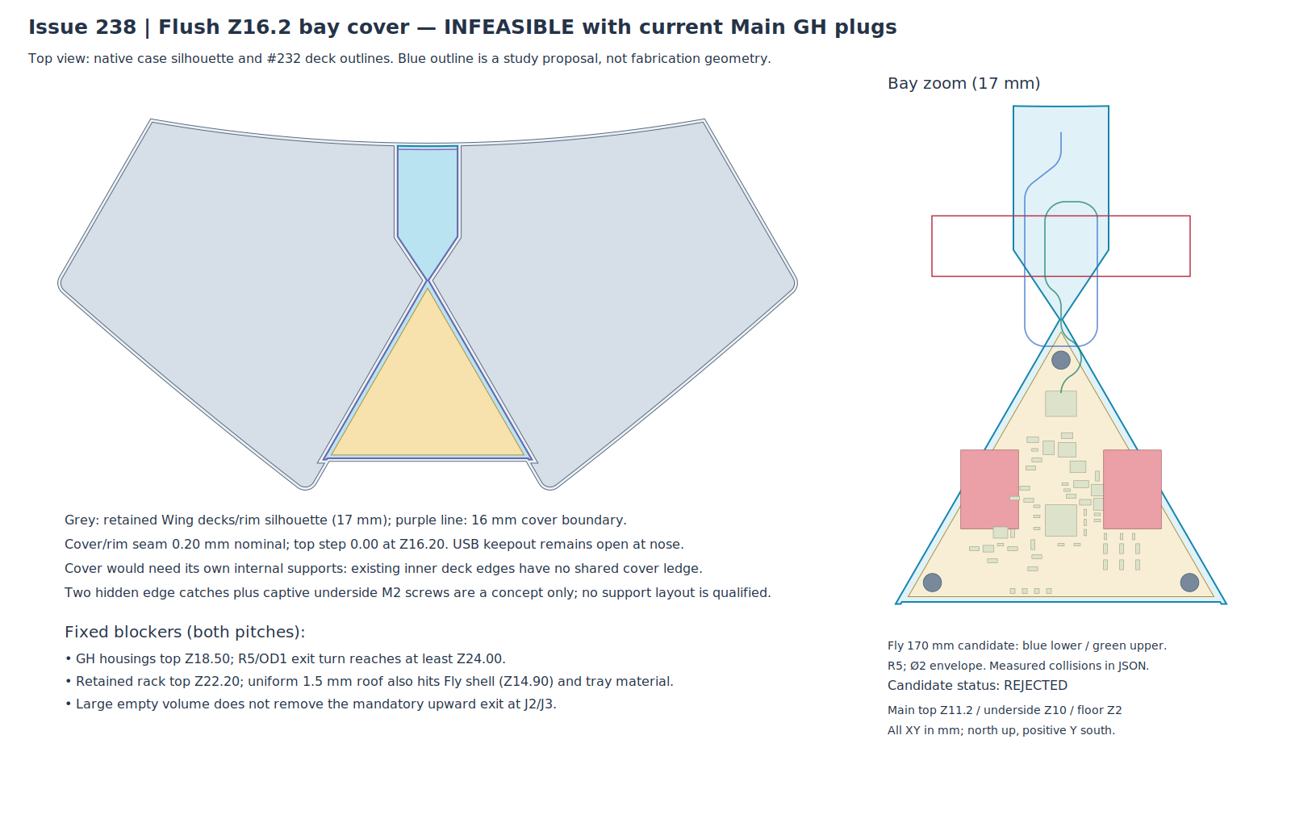
hardware/case/issue-238-bay-study/top-view.png
