ihsinoky/he-piantor-42/hardware/case/issue-242-bay-final/top-view.png

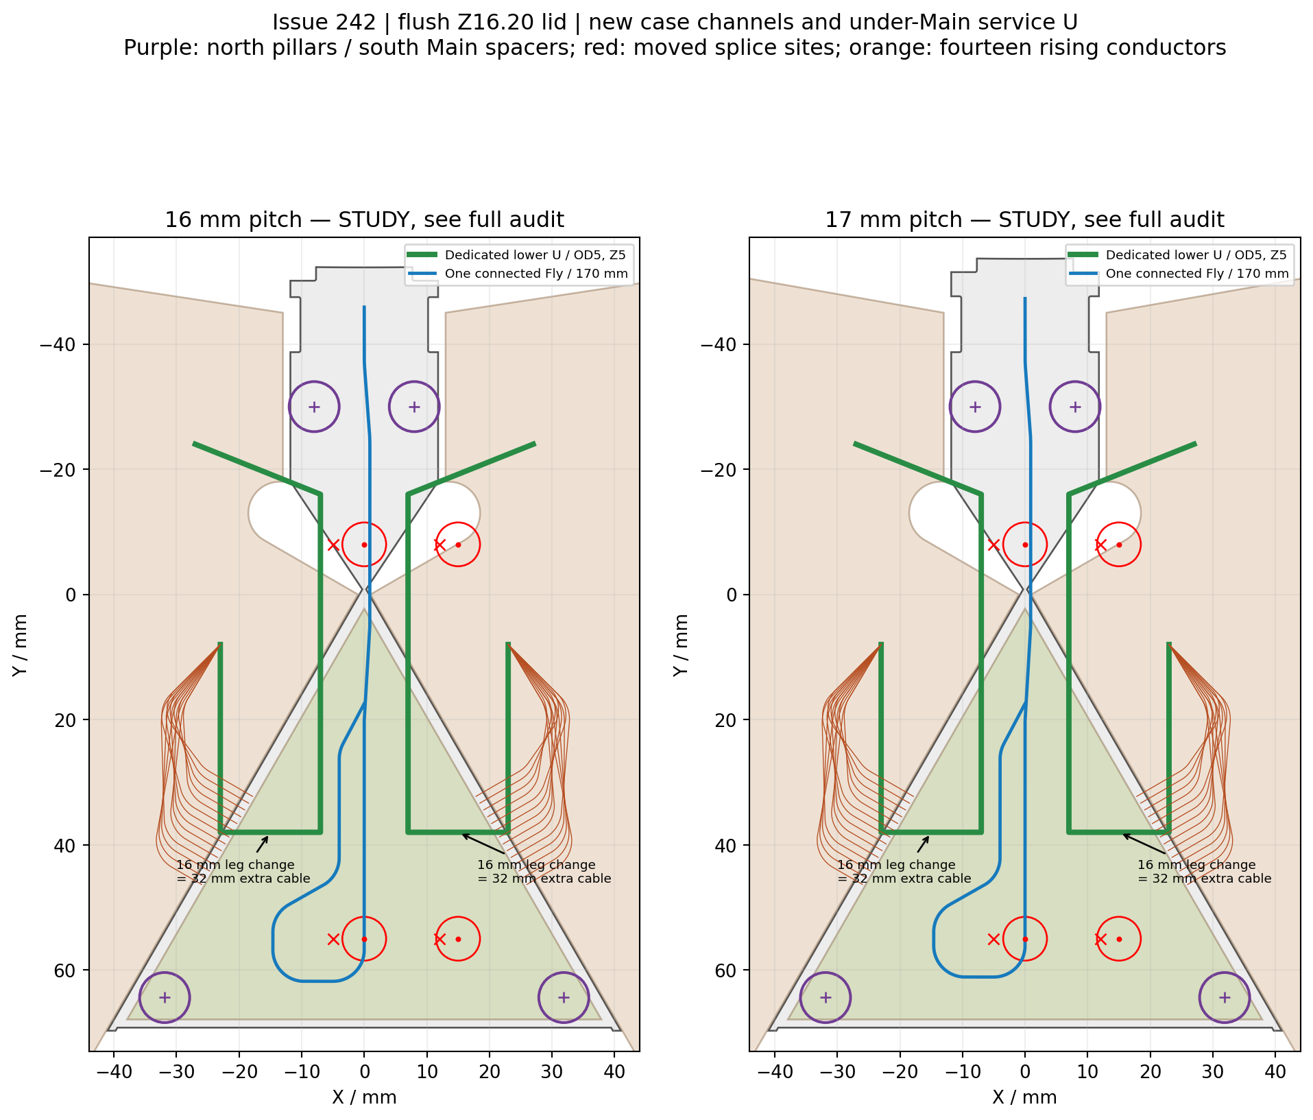
hardware/case/issue-242-bay-final/top-view.png
