ihsinoky/he-piantor-42/hardware/case/issue-244-height-search/delta-6/17mm/top-view.png

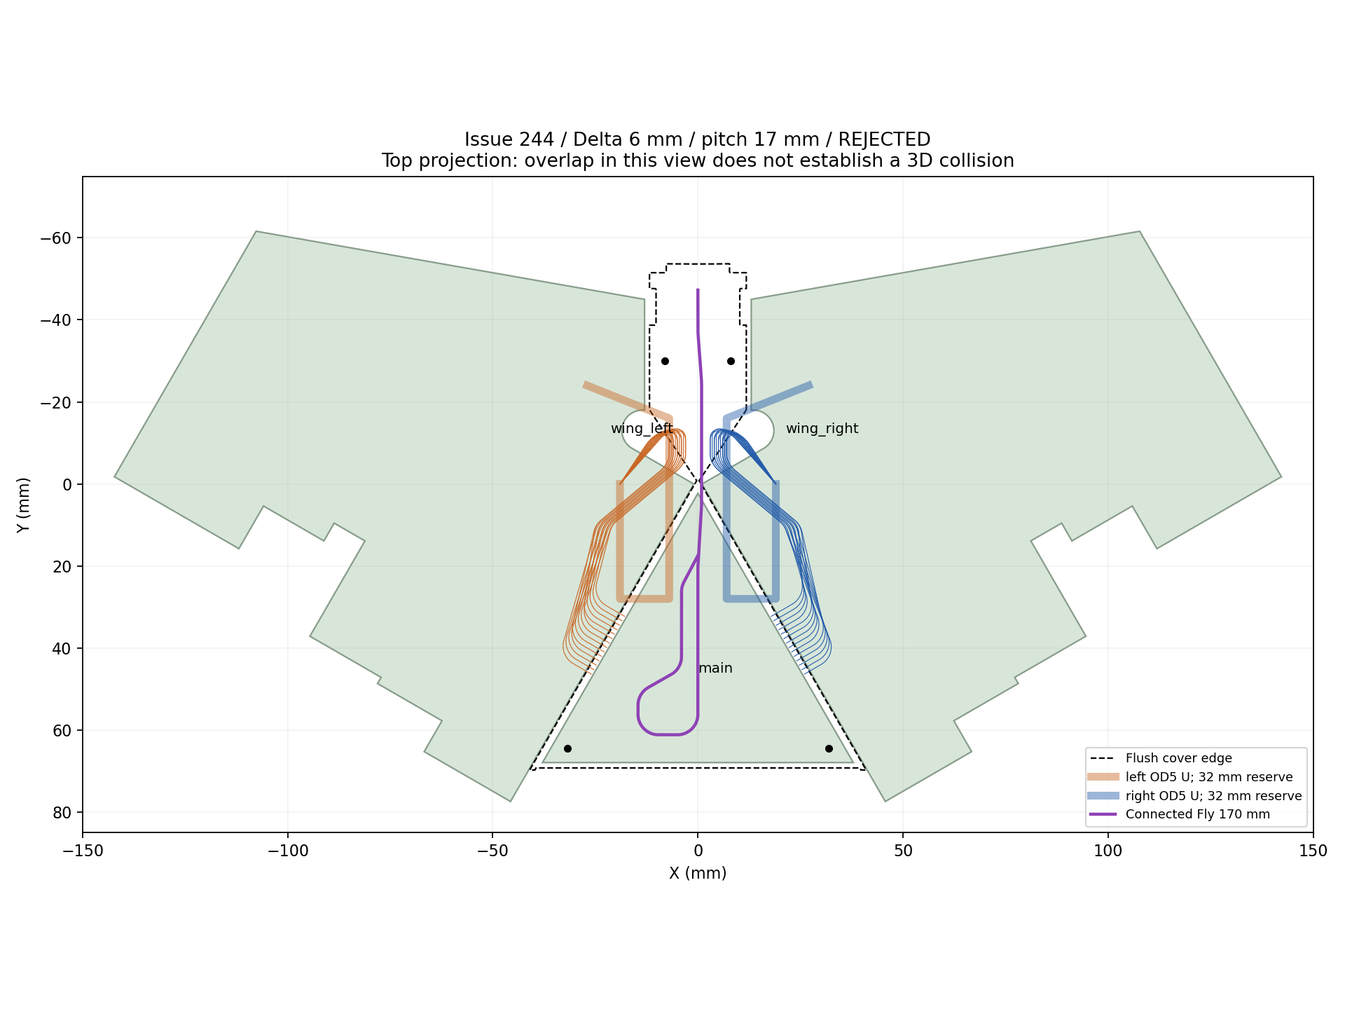
hardware/case/issue-244-height-search/delta-6/17mm/top-view.png
