ihsinoky/he-piantor-42/hardware/case/issue-244-height-search/delta-10/17mm/sections.png

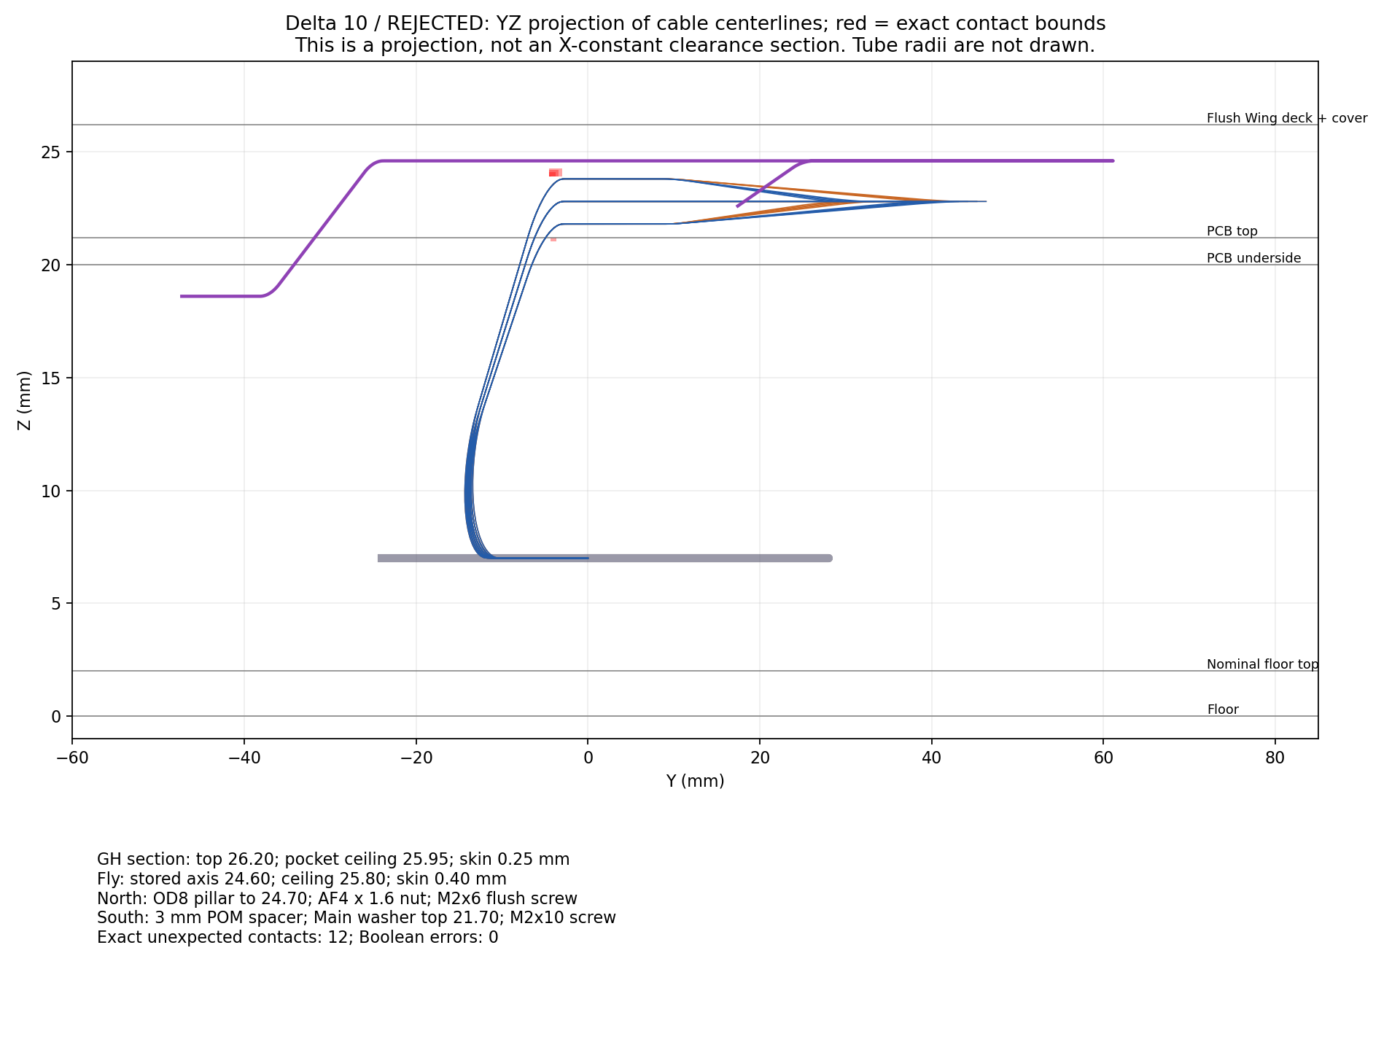
hardware/case/issue-244-height-search/delta-10/17mm/sections.png
