ihsinoky/he-piantor-42/hardware/case/issue-246-delta6-tuning/packed/delta-6/17mm/sections.png

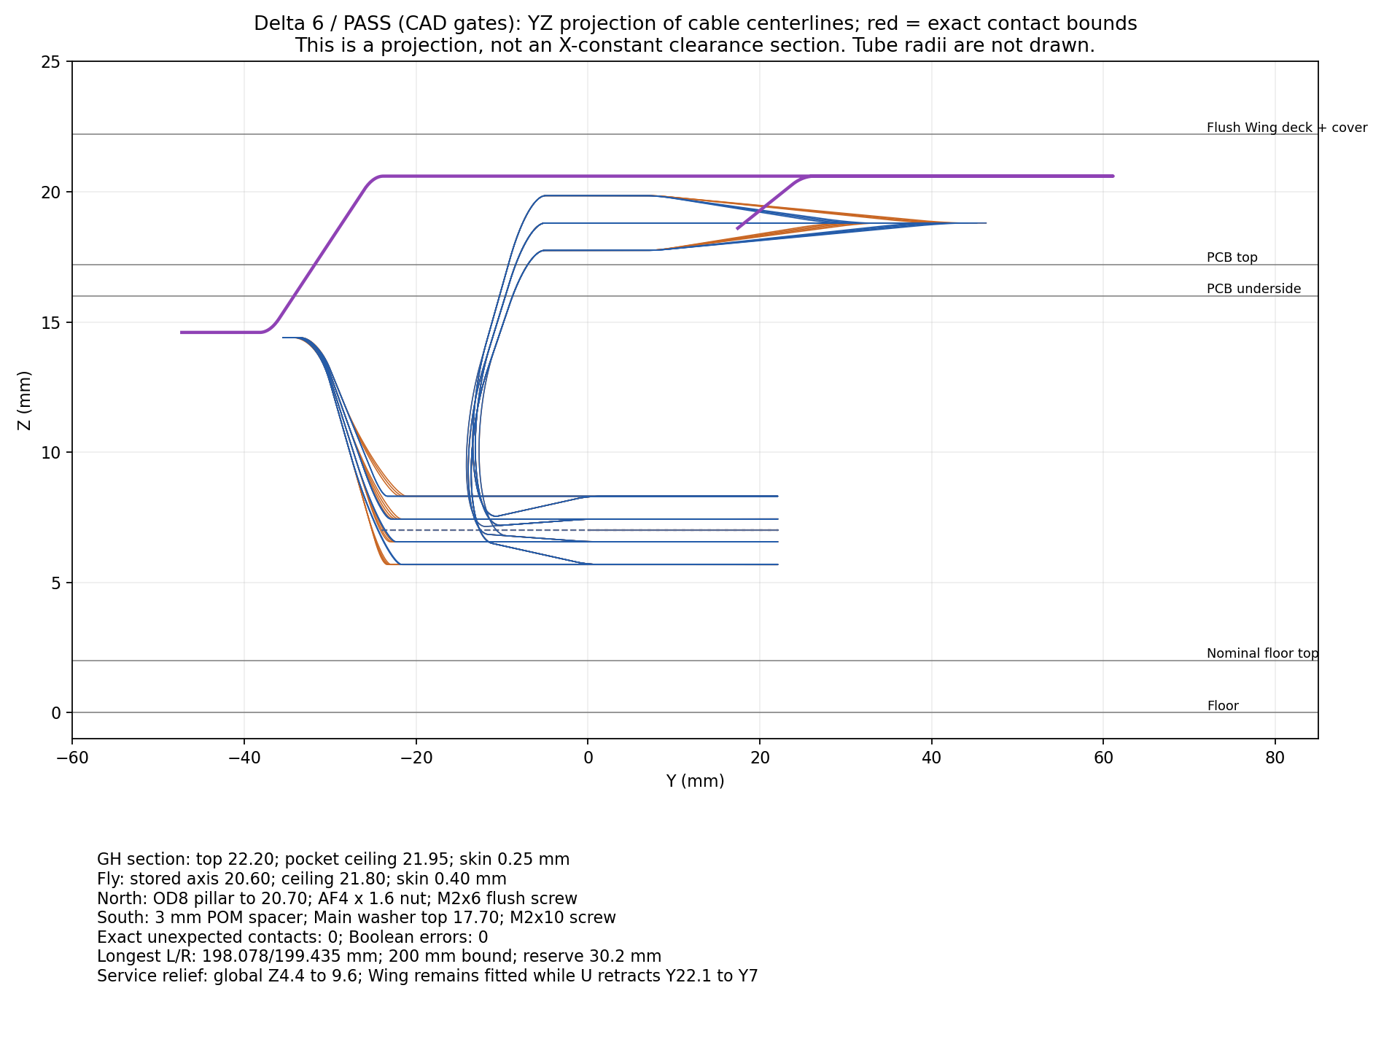
hardware/case/issue-246-delta6-tuning/packed/delta-6/17mm/sections.png
