ihsinoky/he-piantor-42/hardware/kicad/qualification/issue-149-wing-silkscreen/16mm/preview-review/bottom-copper-holes.png

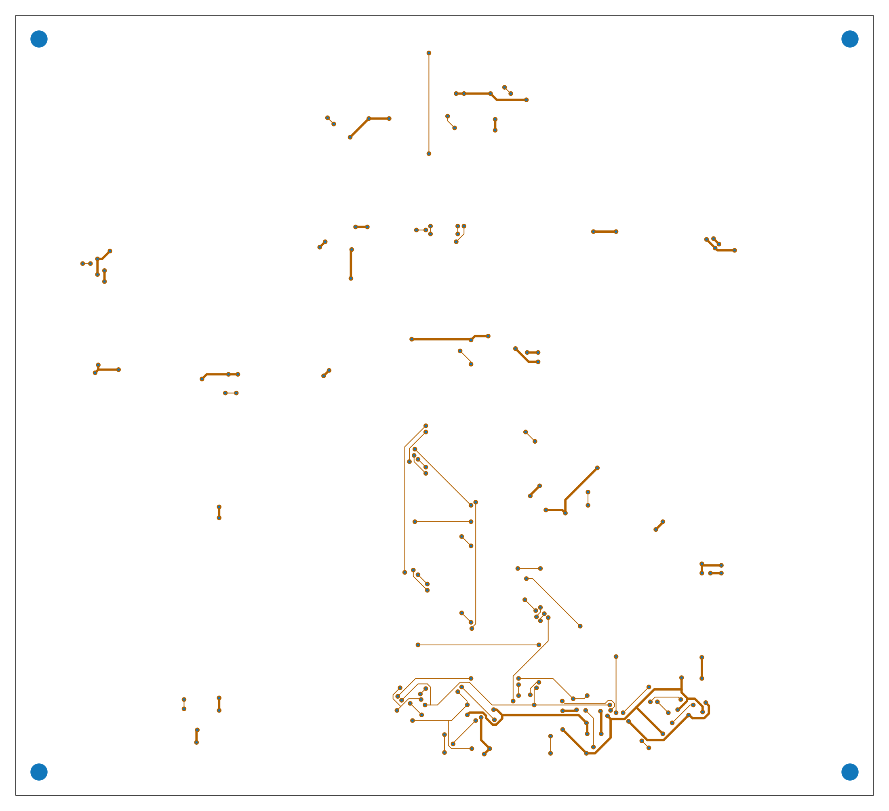
hardware/kicad/qualification/issue-149-wing-silkscreen/16mm/preview-review/bottom-copper-holes.png
