ihsinoky/he-piantor-42/hardware/kicad/qualification/issue-149-wing-silkscreen/16mm/preview-review/front-silkscreen.png

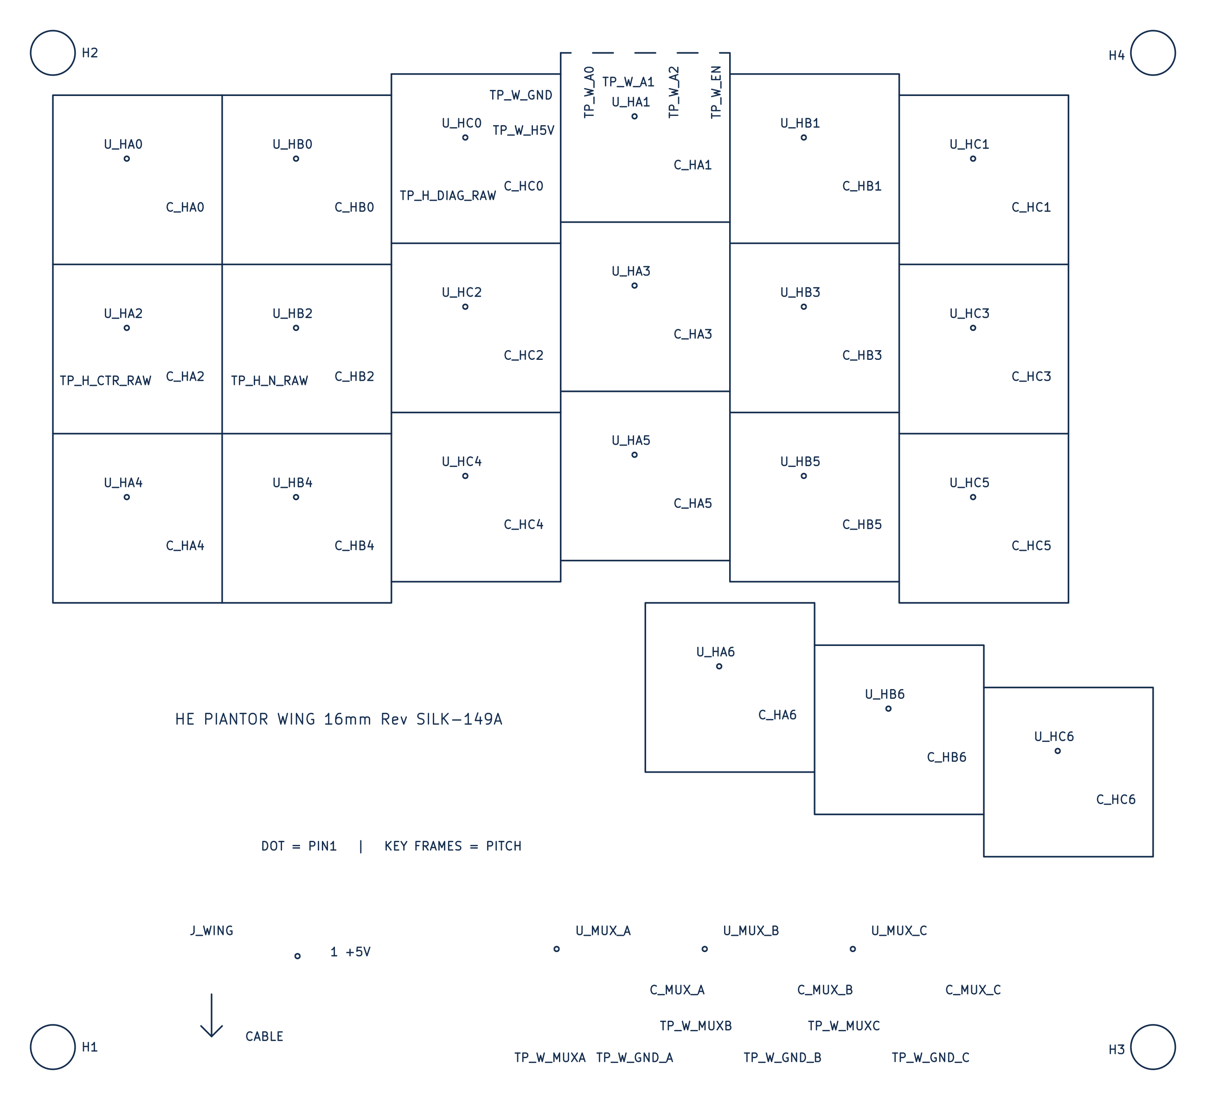
hardware/kicad/qualification/issue-149-wing-silkscreen/16mm/preview-review/front-silkscreen.png
