ihsinoky/he-piantor-42/hardware/kicad/qualification/issue-149-wing-silkscreen/17mm/preview-review/bottom-copper-holes.png

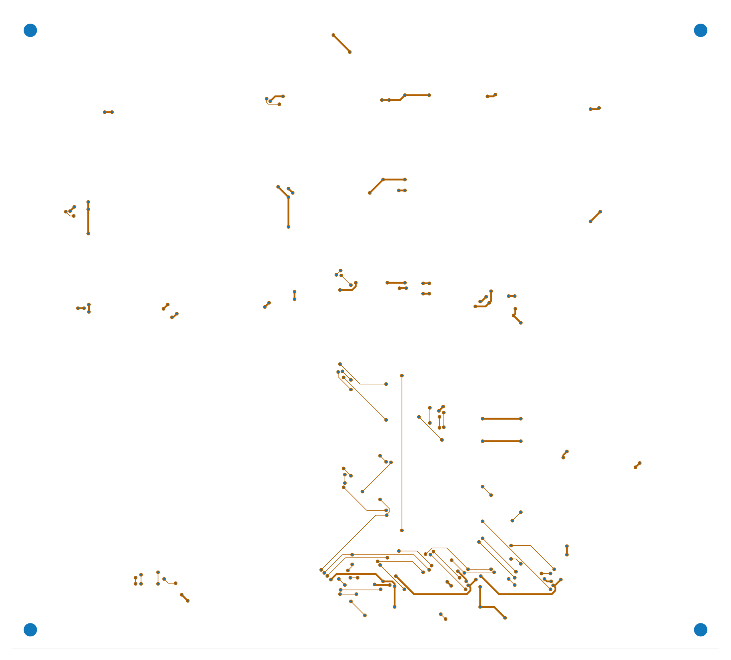
hardware/kicad/qualification/issue-149-wing-silkscreen/17mm/preview-review/bottom-copper-holes.png
