ihsinoky/he-piantor-42/hardware/kicad/qualification/issue-226-main-rev6/outline-comparison.png

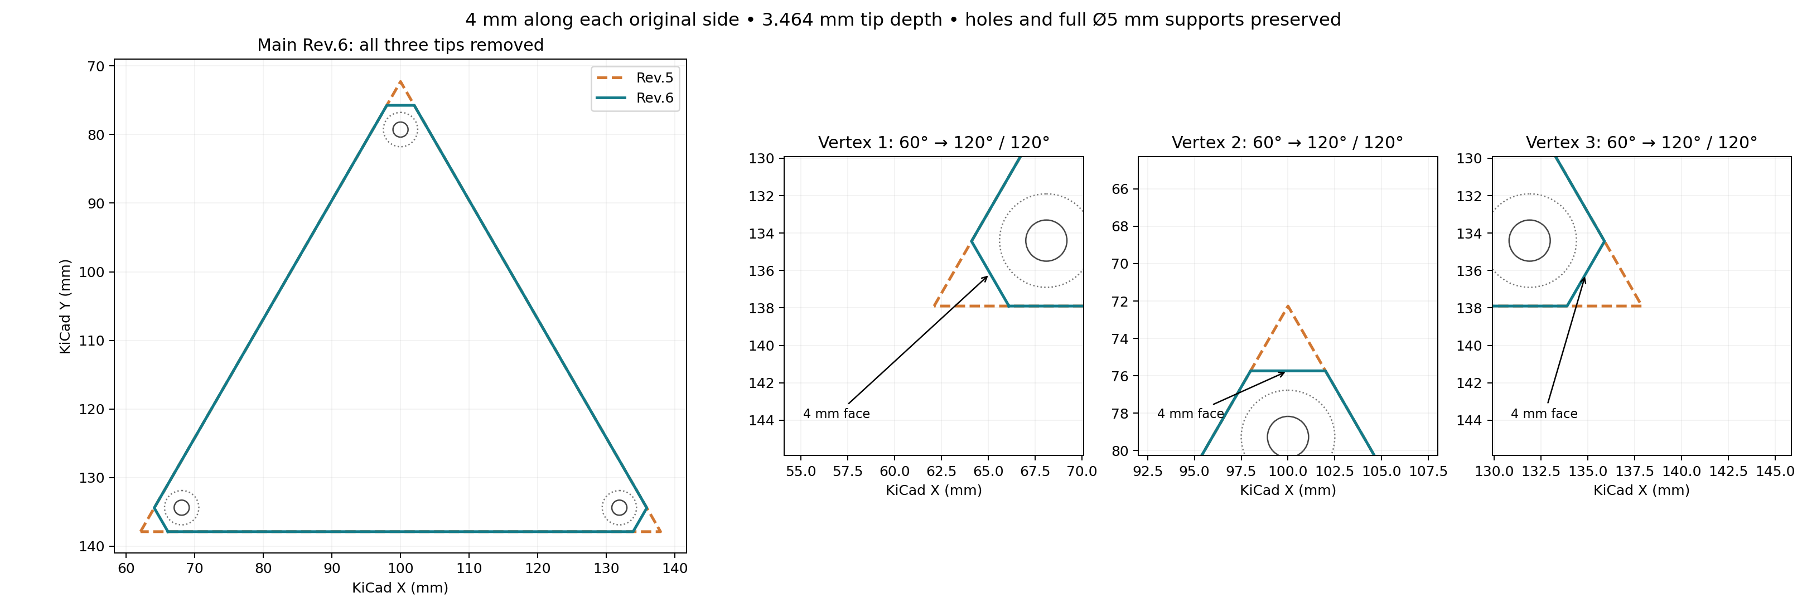
hardware/kicad/qualification/issue-226-main-rev6/outline-comparison.png
