ihsinoky/he-piantor-42/hardware/case/issue-238-bay-study/sources/Uniroyal-dimensions.pdf

# 可降低装置成本及配合机器组装

# 应用于GPS、移动电话、PDA、机顶盒、仪表

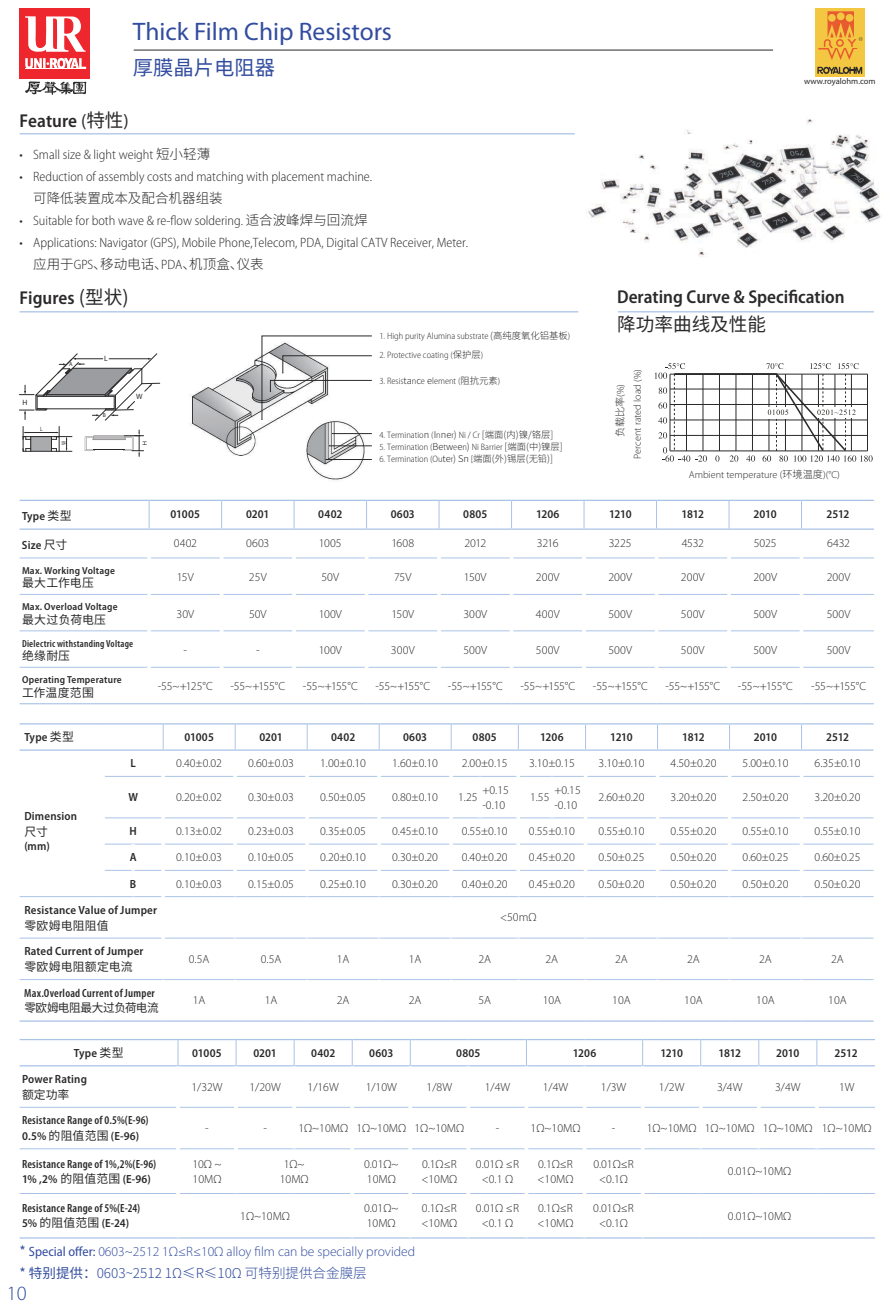
[picture p64: page 1]
Type 类型; Size 尺寸; 最大工作电压; 最大过负荷电压; 绝缘耐压; Operating Temperature; 工作温度范围; Feature (特性); Figures (型状); Derating Curve & Specification; 降功率曲线及性能; Dimension 尺寸; 零欧姆电阻阻值; 零欧姆电阻额定电流; 零欧姆电阻最大过负荷电流; Power Rating; 额定功率; 0.5% 的阻值范围 (E-96); 5% 的阻值范围 (E-24); 负载比率(%)

Thick Film Chip Resistors
厚膜晶片电阻器

www.royalohm.com

• Small size & light weight 短小轻薄

• Reduction of assembly costs and matching with placement machine.

• Suitable for both wave & re-flow soldering. 适合波峰焊与回流焊

• Applications: Navigator (GPS), Mobile Phone,Telecom, PDA, Digital CATV Receiver, Meter.

1. High purity Alumina substrate (高纯度氧化铝基板)

2. Protective coating (保护层)

3. Resistance element (阻抗元素)

Percent rated load (%)

4. Termination (Inner) Ni / Cr [端面(内)镍/铬层]
5. Termination (Between) Ni Barrier [端面(中)镍层]
6. Termination (Outer) Sn [端面(外)锡层(无铅)]

Ambient temperature (环境温度)(°C)

Max. Working Voltage

Max. Overload Voltage

Dielectric withstanding Voltage

Resistance Value of Jumper

Rated Current of Jumper

Max.Overload Current of Jumper

Resistance Range of 0.5%(E-96)

Resistance Range of 1%,2%(E-96)
1% ,2% 的阻值范围 (E-96)

Resistance Range of 5%(E-24)
* 特别提供：0603~2512 1Ω≤R≤10Ω 可特别提供合金膜层

* Special offer: 0603~2512 1Ω≤R≤10Ω alloy film can be specially provided
