ihsinoky/he-piantor-42/hardware/kicad/qualification/issue-178-m1-matrix-board/manufacturing/assembly-top.pdf

## M1 MATRIX18 — TOP ASSEMBLY / 16mm + 17mm

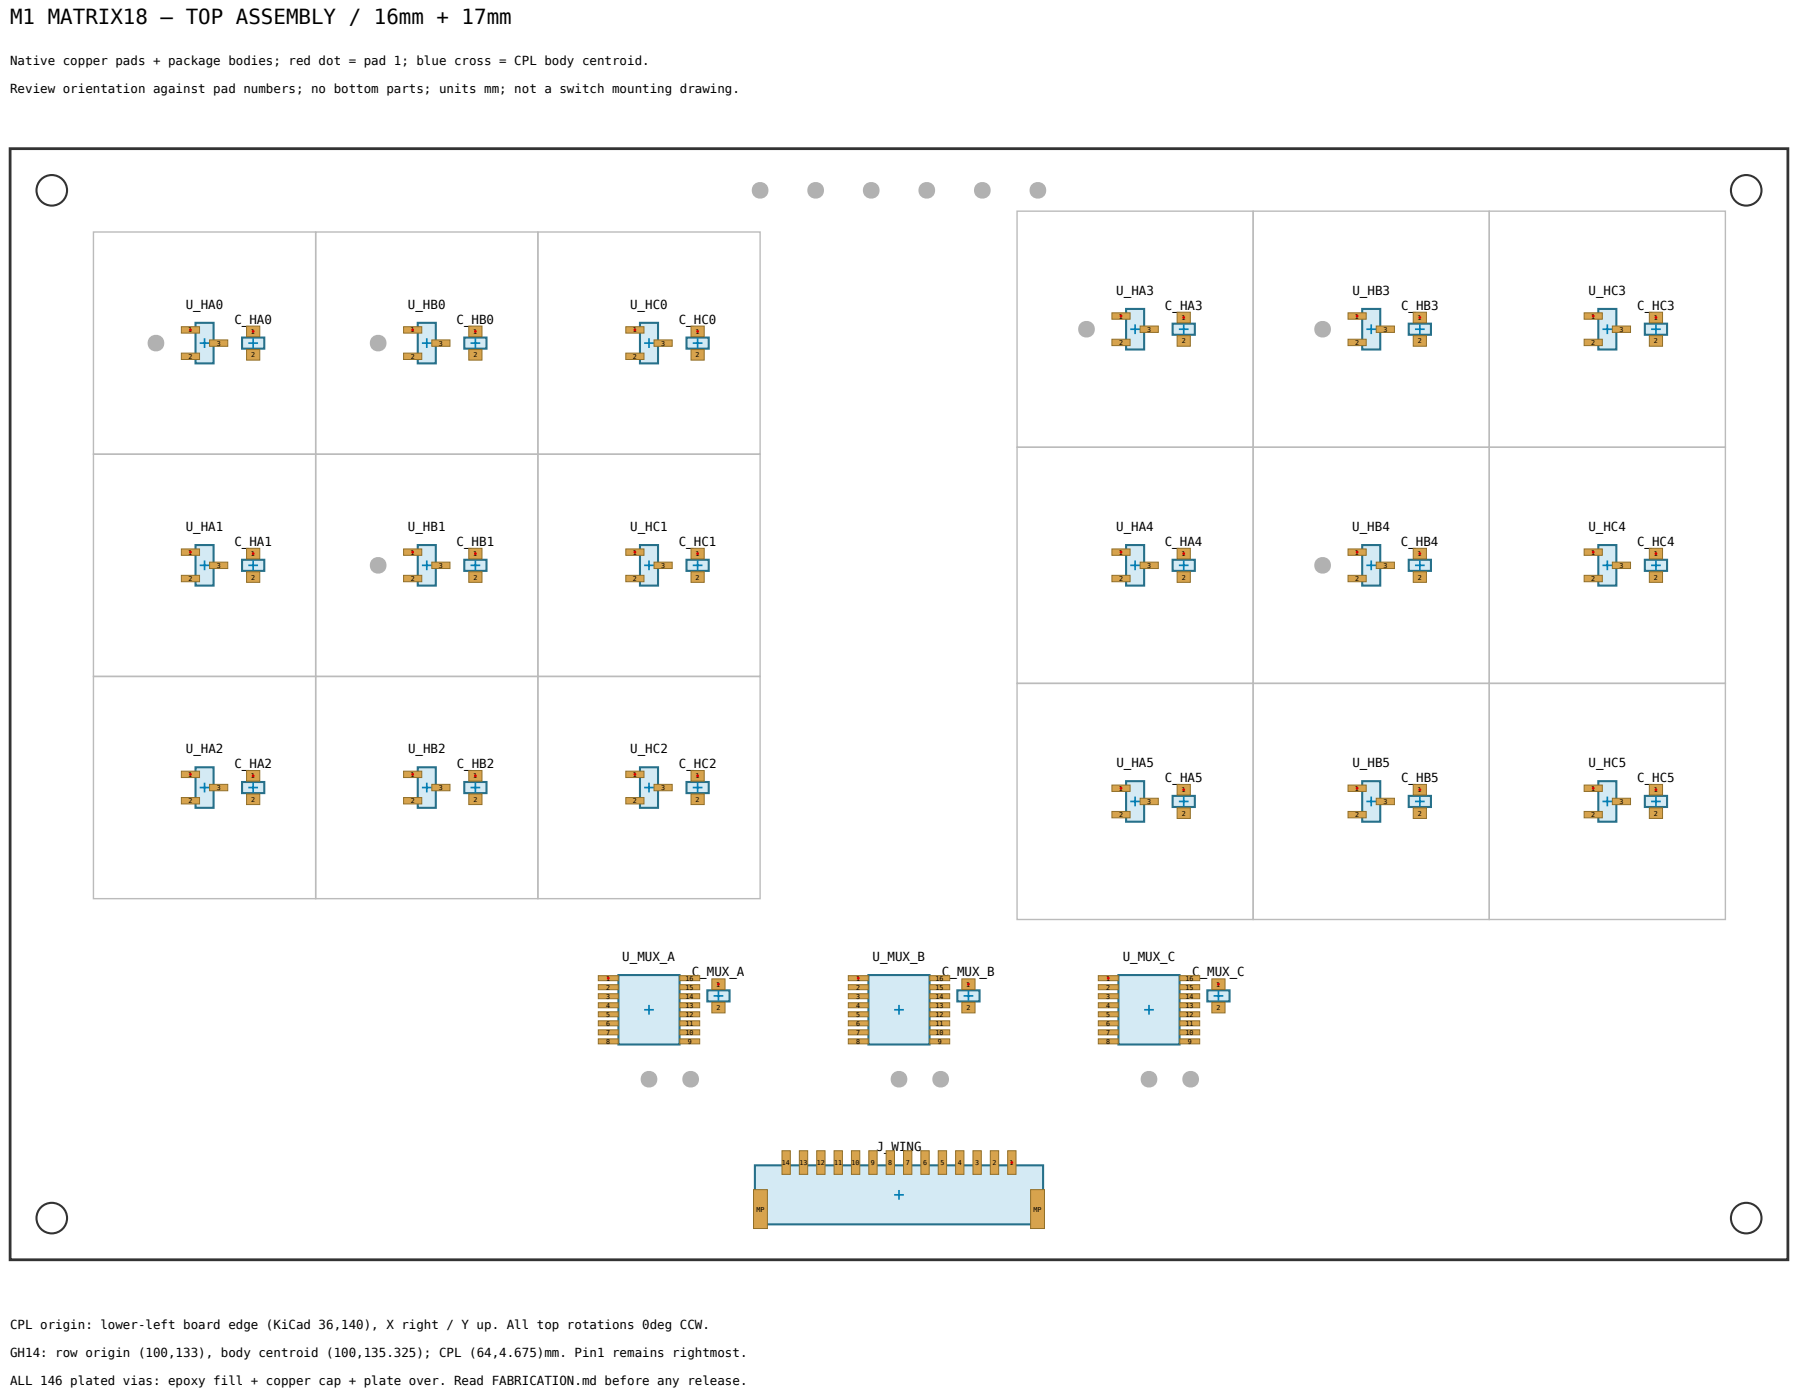
[picture p65: page 1]
U_MUX_A; C_MUX_A; U_MUX_B; C_MUX_B; U_MUX_C; C_MUX_C; J_WING

Native copper pads + package bodies; red dot = pad 1; blue cross = CPL body centroid.
Review orientation against pad numbers; no bottom parts; units mm; not a switch mounting drawing.

CPL origin: lower-left board edge (KiCad 36,140), X right / Y up. All top rotations 0deg CCW.
GH14: row origin (100,133), body centroid (100,135.325); CPL (64,4.675)mm. Pin1 remains rightmost.
ALL 146 plated vias: epoxy fill + copper cap + plate over. Read FABRICATION.md before any release.
