ihsinoky/he-piantor-42/(list of files, drawings)

Other design files:
hardware/kicad/qualification/issue-87-native-main-routing/evidence/processes/smoke-dsn/input.dsn
hardware/kicad/qualification/issue-105-fab-router-detailed/evidence/processes/main/corrected.dsn
hardware/kicad/qualification/issue-105-fab-router-detailed/evidence/processes/smoke/corrected.dsn
hardware/kicad/qualification/issue-117-four-layer-main/evidence/amendment-01/inputs/smoke/raw.dsn
hardware/kicad/qualification/issue-117-four-layer-main/evidence/inputs/smoke/raw.dsn
hardware/kicad/qualification/issue-117-four-layer-main/evidence/preparation-attempt-01/main/raw.dsn
hardware/kicad/qualification/issue-119-promising-tools-relaxed/evidence/inputs/smoke4/original.dsn
hardware/kicad/qualification/issue-121-full-auto-conditions/evidence/inputs/main-cell2/corrected.dsn
hardware/kicad/qualification/issue-121-full-auto-conditions/evidence/inputs/main-cell3/corrected.dsn
hardware/kicad/qualification/issue-121-full-auto-conditions/evidence/inputs/smoke-cell2/corrected.dsn
hardware/kicad/qualification/issue-129-wing-2layer-routing/evidence/runs/FAB-16/input.dsn
hardware/kicad/qualification/issue-129-wing-2layer-routing/evidence/runs/FAB-17/input.dsn
hardware/kicad/qualification/issue-221-main-rev5/schematic-repairs.json
