ihsinoky/he-piantor-42/hardware/kicad/qualification/issue-235-wing-round2/wing-rev4-17mm-left/routed.kicad_pcb

## KiCad design hardware/kicad/qualification/issue-235-wing-round2/wing-rev4-17mm-left/routed.kicad_pcb (2026-11-13)

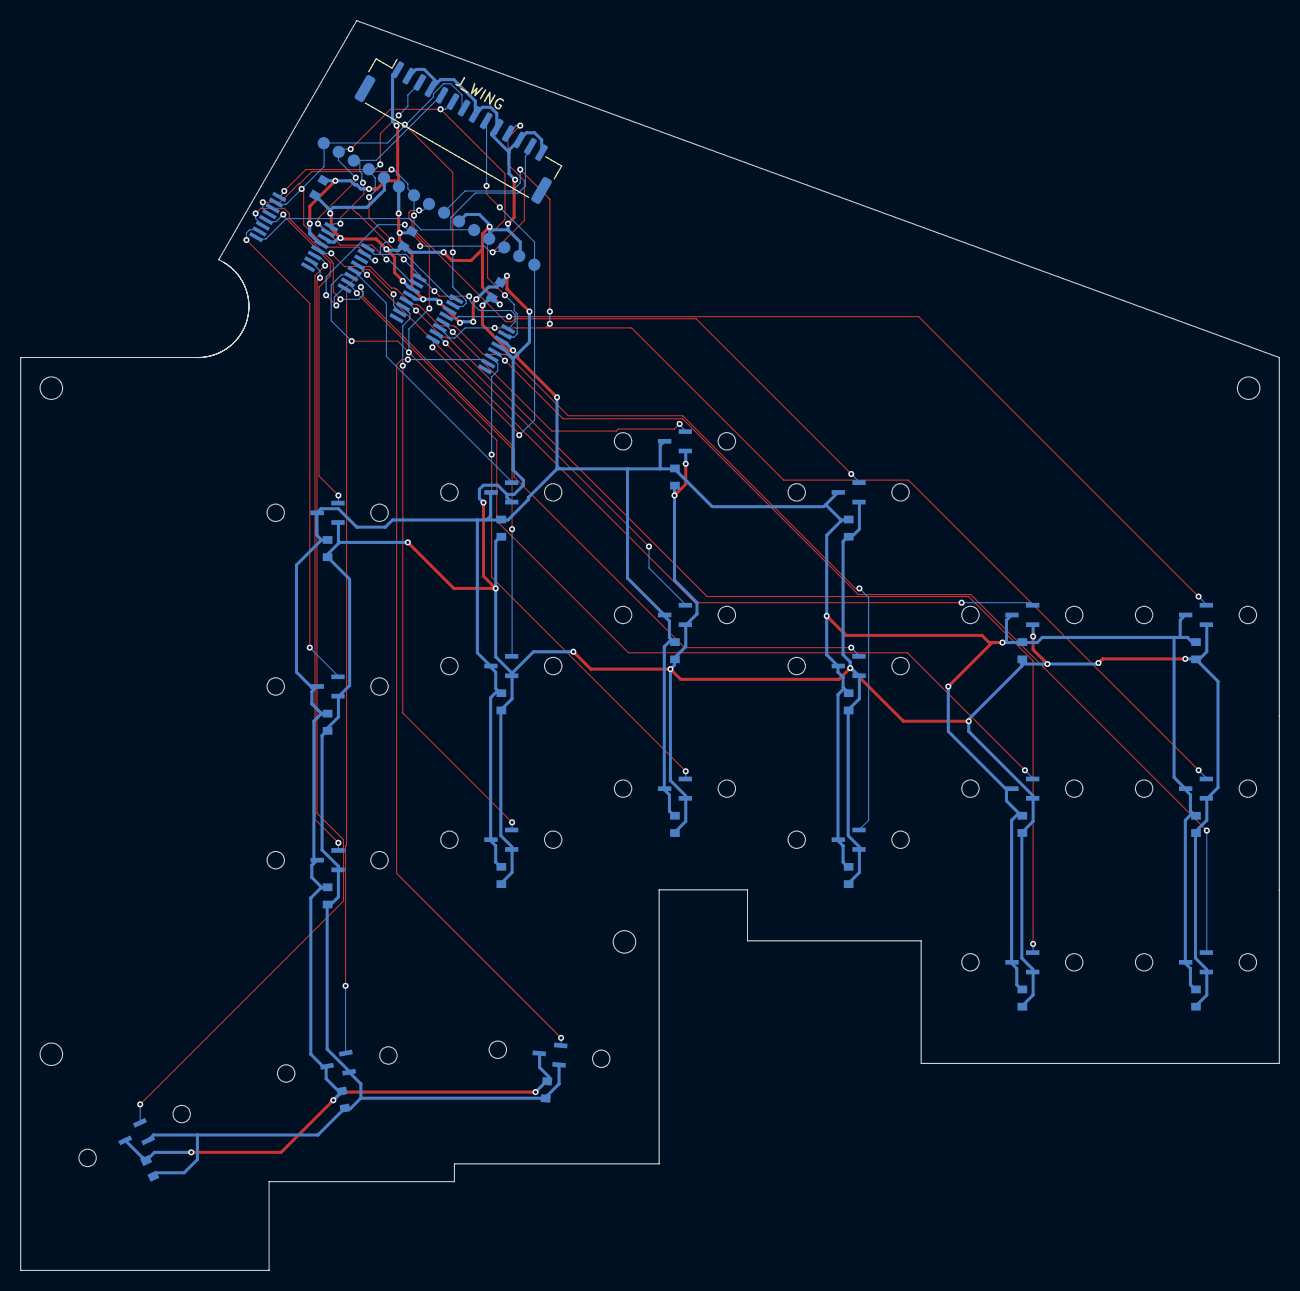
[picture p66: board routed.kicad_pcb from below]

Board: 2 copper layers, 123.2 x 122.3 mm, 110 parts (64 on the bottom side), 30 nets.

Parts:
C_HA0, C_HA1, C_HA2, C_HA3, C_HA4, C_HA5, C_HA6: GRM188R71C104KA01D; capacitor
C_HB0, C_HB1, C_HB2, C_HB3, C_HB4, C_HB5, C_HB6: GRM188R71C104KA01D; capacitor
C_HC0, C_HC1, C_HC2, C_HC3, C_HC4, C_HC5, C_HC6: GRM188R71C104KA01D; capacitor
C_MUX_A: GRM188R71C104KA01D; capacitor
C_MUX_B: GRM188R71C104KA01D; capacitor
C_MUX_C: GRM188R71C104KA01D; capacitor
H1, H2, H3, H4: NPTH_2.2; NPTH
J_WING: SM14B-GHS-TB(LF)(SN); JST_GH_SM14B-GHS-TB_1x14-1MP_P1.25mm_Horizontal
MH_1_1, MH_1_2, MH_2_1, MH_2_2, MH_3_1, MH_3_2, MH_4_1, MH_4_2, MH_5_1, MH_5_2, MH_6_1, MH_6_2, MH_7_1, MH_7_2, MH_8_1, MH_8_2, MH_9_1, MH_9_2, MH_10_1, MH_10_2, MH_11_1, MH_11_2, MH_12_1, MH_12_2, MH_13_1, MH_13_2, MH_14_1, MH_14_2, MH_15_1, MH_15_2, MH_16_1, MH_16_2, MH_17_1, MH_17_2, MH_18_1, MH_18_2, MH_19_1, MH_19_2, MH_20_1, MH_20_2, MH_21_1, MH_21_2: NPTH_1.7; NPTH
TP_H_CTR_RAW: PCB_PAD_1.2MM; testpoint
TP_H_DIAG_RAW: PCB_PAD_1.2MM; testpoint
TP_H_N_RAW: PCB_PAD_1.2MM; testpoint
TP_W_A0, TP_W_A1, TP_W_A2: PCB_PAD_1.2MM; testpoint
TP_W_EN: PCB_PAD_1.2MM; testpoint
TP_W_GND: PCB_PAD_1.2MM; testpoint
TP_W_GND_A: PCB_PAD_1.2MM; testpoint
TP_W_GND_B: PCB_PAD_1.2MM; testpoint
TP_W_GND_C: PCB_PAD_1.2MM; testpoint
TP_W_H5V: PCB_PAD_1.2MM; testpoint
TP_W_MUXA: PCB_PAD_1.2MM; testpoint
TP_W_MUXB: PCB_PAD_1.2MM; testpoint
TP_W_MUXC: PCB_PAD_1.2MM; testpoint
U_HA0, U_HA1, U_HA2, U_HA3, U_HA4, U_HA5, U_HA6: DRV5055A3QDBZR; hall
U_HB0, U_HB1, U_HB2, U_HB3, U_HB4, U_HB5, U_HB6: DRV5055A3QDBZR; hall
U_HC0, U_HC1, U_HC2, U_HC3, U_HC4, U_HC5, U_HC6: DRV5055A3QDBZR; hall
U_MUX_A: TMUX1208PWR; mux
U_MUX_B: TMUX1208PWR; mux
U_MUX_C: TMUX1208PWR; mux

Connections:
GND: C_HA0.2, C_HA1.2, C_HA2.2, C_HA3.2, C_HA4.2, C_HA5.2, C_HA6.2, C_HB0.2, C_HB1.2, C_HB2.2, C_HB3.2, C_HB4.2, C_HB5.2, C_HB6.2, C_HC0.2, C_HC1.2, C_HC2.2, C_HC3.2, C_HC4.2, C_HC5.2, C_HC6.2, C_MUX_A.2, C_MUX_B.2, C_MUX_C.2, J_WING.2, J_WING.4, J_WING.8, J_WING.10, J_WING.12, J_WING.14, TP_W_GND.1, TP_W_GND_A.1, TP_W_GND_B.1, TP_W_GND_C.1, U_HA0.3, U_HA1.3, U_HA2.3, U_HA3.3, U_HA4.3, U_HA5.3, U_HA6.3, U_HB0.3, U_HB1.3, U_HB2.3, U_HB3.3, U_HB4.3, U_HB5.3, U_HB6.3, U_HC0.3, U_HC1.3, U_HC2.3, U_HC3.3, U_HC4.3, U_HC5.3, U_HC6.3, U_MUX_A.14, U_MUX_B.14, U_MUX_C.14
HALL_5V: C_HA0.1, C_HA1.1, C_HA2.1, C_HA3.1, C_HA4.1, C_HA5.1, C_HA6.1, C_HB0.1, C_HB1.1, C_HB2.1, C_HB3.1, C_HB4.1, C_HB5.1, C_HB6.1, C_HC0.1, C_HC1.1, C_HC2.1, C_HC3.1, C_HC4.1, C_HC5.1, C_HC6.1, C_MUX_A.1, C_MUX_B.1, C_MUX_C.1, J_WING.1, TP_W_H5V.1, U_HA0.1, U_HA1.1, U_HA2.1, U_HA3.1, U_HA4.1, U_HA5.1, U_HA6.1, U_HB0.1, U_HB1.1, U_HB2.1, U_HB3.1, U_HB4.1, U_HB5.1, U_HB6.1, U_HC0.1, U_HC1.1, U_HC2.1, U_HC3.1, U_HC4.1, U_HC5.1, U_HC6.1, U_MUX_A.13, U_MUX_B.13, U_MUX_C.13
H_A0_RAW: U_HA0.2, U_MUX_A.4
H_A1_RAW: U_HA1.2, U_MUX_A.5
H_A2_RAW: TP_H_CTR_RAW.1, U_HA2.2, U_MUX_A.6
H_A3_RAW: U_HA3.2, U_MUX_A.7
H_A4_RAW: U_HA4.2, U_MUX_A.12
H_A5_RAW: U_HA5.2, U_MUX_A.11
H_A6_RAW: U_HA6.2, U_MUX_A.10
H_B0_RAW: U_HB0.2, U_MUX_B.4
H_B1_RAW: U_HB1.2, U_MUX_B.5
H_B2_RAW: TP_H_N_RAW.1, U_HB2.2, U_MUX_B.6
H_B3_RAW: U_HB3.2, U_MUX_B.7
H_B4_RAW: U_HB4.2, U_MUX_B.12
H_B5_RAW: U_HB5.2, U_MUX_B.11
H_B6_RAW: U_HB6.2, U_MUX_B.10
H_C0_RAW: TP_H_DIAG_RAW.1, U_HC0.2, U_MUX_C.4
H_C1_RAW: U_HC1.2, U_MUX_C.5
H_C2_RAW: U_HC2.2, U_MUX_C.6
H_C3_RAW: U_HC3.2, U_MUX_C.7
H_C4_RAW: U_HC4.2, U_MUX_C.12
H_C5_RAW: U_HC5.2, U_MUX_C.11
H_C6_RAW: U_HC6.2, U_MUX_C.10
MUX_A0: J_WING.3, TP_W_A0.1, U_MUX_A.1, U_MUX_B.1, U_MUX_C.1
MUX_A1: J_WING.5, TP_W_A1.1, U_MUX_A.16, U_MUX_B.16, U_MUX_C.16
MUX_A2: J_WING.6, TP_W_A2.1, U_MUX_A.15, U_MUX_B.15, U_MUX_C.15
MUX_OUT_A: J_WING.9, TP_W_MUXA.1, U_MUX_A.8
MUX_OUT_B: J_WING.11, TP_W_MUXB.1, U_MUX_B.8
MUX_OUT_C: J_WING.13, TP_W_MUXC.1, U_MUX_C.8
WING_EN: J_WING.7, TP_W_EN.1, U_MUX_A.2, U_MUX_B.2, U_MUX_C.2
