ihsinoky/he-piantor-42/hardware/kicad/qualification/issue-200-wing-rev3/panel-16mm/main.kicad_pcb

## KiCad design hardware/kicad/qualification/issue-200-wing-rev3/panel-16mm/main.kicad_pcb (2026-11-07)

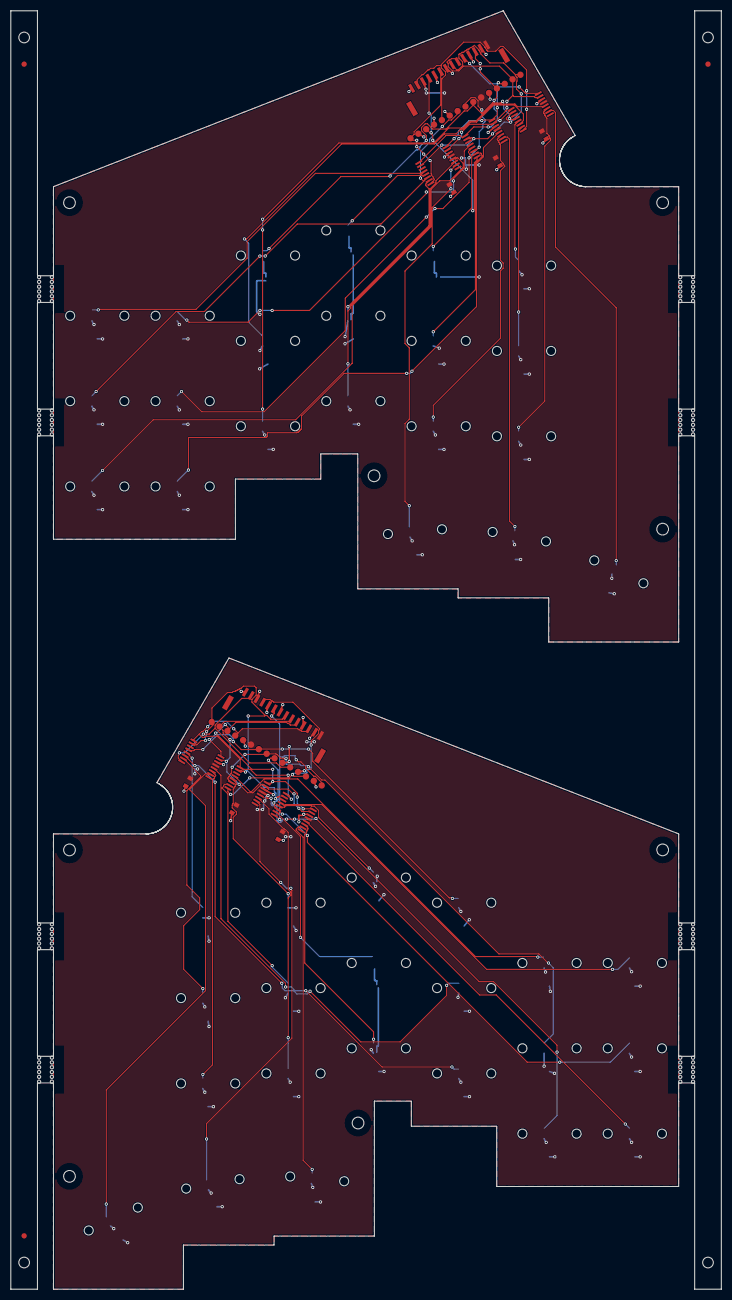
[picture p68: board hardware/kicad/qualification/issue-200-wing-rev3/panel-16mm/main.kica… from above]

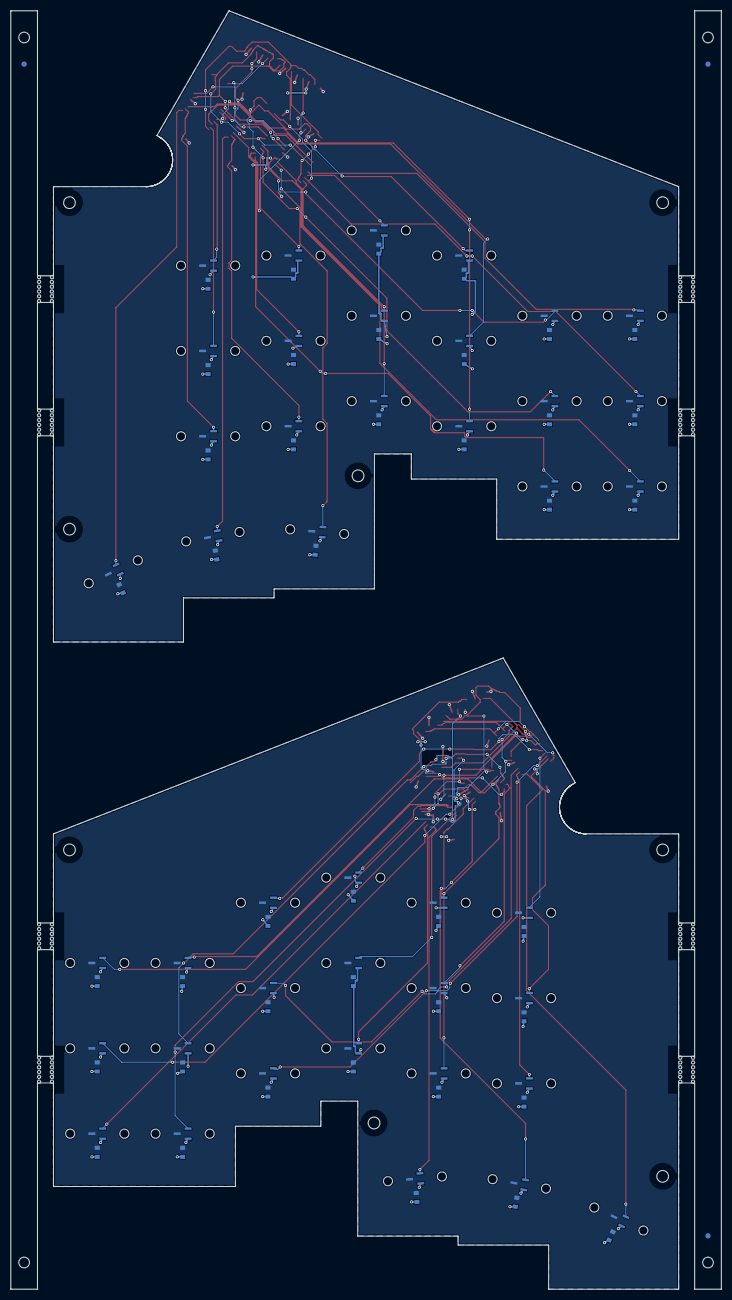
[picture p69: board hardware/kicad/qualification/issue-200-wing-rev3/panel-16mm/main.kica… from below]

Board: 2 copper layers, 133.2 x 239.7 mm, 323 parts (84 on the bottom side), 60 nets.

Parts:
FID1, FID2, FID3: Fiducial_1mm
L_C_HA0, L_C_HA1, L_C_HA2, L_C_HA3, L_C_HA4, L_C_HA5, L_C_HA6: GRM188R71C104KA01D; capacitor
L_C_HB0, L_C_HB1, L_C_HB2, L_C_HB3, L_C_HB4, L_C_HB5, L_C_HB6: GRM188R71C104KA01D; capacitor
L_C_HC0, L_C_HC1, L_C_HC2, L_C_HC3, L_C_HC4, L_C_HC5, L_C_HC6: GRM188R71C104KA01D; capacitor
L_C_MUX_A: GRM188R71C104KA01D; capacitor
L_C_MUX_B: GRM188R71C104KA01D; capacitor
L_C_MUX_C: GRM188R71C104KA01D; capacitor
L_H1, L_H2, L_H3, L_H4: NPTH_2.2; NPTH
L_J_WING: BM14B-GHS-TBT(LF)(SN); connector
L_MH_1_1, L_MH_1_2, L_MH_2_1, L_MH_2_2, L_MH_3_1, L_MH_3_2, L_MH_4_1, L_MH_4_2, L_MH_5_1, L_MH_5_2, L_MH_6_1, L_MH_6_2, L_MH_7_1, L_MH_7_2, L_MH_8_1, L_MH_8_2, L_MH_9_1, L_MH_9_2, L_MH_10_1, L_MH_10_2, L_MH_11_1, L_MH_11_2, L_MH_12_1, L_MH_12_2, L_MH_13_1, L_MH_13_2, L_MH_14_1, L_MH_14_2, L_MH_15_1, L_MH_15_2, L_MH_16_1, L_MH_16_2, L_MH_17_1, L_MH_17_2, L_MH_18_1, L_MH_18_2, L_MH_19_1, L_MH_19_2, L_MH_20_1, L_MH_20_2, L_MH_21_1, L_MH_21_2: NPTH_1.7; NPTH
L_TP_H_CTR_RAW: PCB_PAD_1.2MM; testpoint
L_TP_H_DIAG_RAW: PCB_PAD_1.2MM; testpoint
L_TP_H_N_RAW: PCB_PAD_1.2MM; testpoint
L_TP_W_A0, L_TP_W_A1, L_TP_W_A2: PCB_PAD_1.2MM; testpoint
L_TP_W_EN: PCB_PAD_1.2MM; testpoint
L_TP_W_GND: PCB_PAD_1.2MM; testpoint
L_TP_W_GND_A: PCB_PAD_1.2MM; testpoint
L_TP_W_GND_B: PCB_PAD_1.2MM; testpoint
L_TP_W_GND_C: PCB_PAD_1.2MM; testpoint
L_TP_W_H5V: PCB_PAD_1.2MM; testpoint
L_TP_W_MUXA: PCB_PAD_1.2MM; testpoint
L_TP_W_MUXB: PCB_PAD_1.2MM; testpoint
L_TP_W_MUXC: PCB_PAD_1.2MM; testpoint
L_U_HA0, L_U_HA1, L_U_HA2, L_U_HA3, L_U_HA4, L_U_HA5, L_U_HA6: DRV5055A3QDBZR; hall
L_U_HB0, L_U_HB1, L_U_HB2, L_U_HB3, L_U_HB4, L_U_HB5, L_U_HB6: DRV5055A3QDBZR; hall
L_U_HC0, L_U_HC1, L_U_HC2, L_U_HC3, L_U_HC4, L_U_HC5, L_U_HC6: DRV5055A3QDBZR; hall
L_U_MUX_A: TMUX1208PWR; mux
L_U_MUX_B: TMUX1208PWR; mux
L_U_MUX_C: TMUX1208PWR; mux
MB_1, MB_2, MB_3, MB_4, MB_5, MB_6, MB_7, MB_8, MB_9, MB_10, MB_11, MB_12, MB_13, MB_14, MB_15, MB_16, MB_17, MB_18, MB_19, MB_20, MB_21, MB_22, MB_23, MB_24, MB_25, MB_26, MB_27, MB_28, MB_29, MB_30, MB_31, MB_32, MB_33, MB_34, MB_35, MB_36, MB_37, MB_38, MB_39, MB_40, MB_41, MB_42, MB_43, MB_44, MB_45, MB_46, MB_47, MB_48, MB_49, MB_50, MB_51, MB_52, MB_53, MB_54, MB_55, MB_56, MB_57, MB_58, MB_59, MB_60, MB_61, MB_62, MB_63, MB_64, MB_65, MB_66, MB_67, MB_68, MB_69, MB_70, MB_71, MB_72, MB_73, MB_74, MB_75, MB_76, MB_77, MB_78, MB_79, MB_80, MB_81, MB_82, MB_83, MB_84, MB_85, MB_86, MB_87, MB_88, MB_89, MB_90, MB_91, MB_92, MB_93, MB_94, MB_95, MB_96: NPTH_0.6
R_C_HA0, R_C_HA1, R_C_HA2, R_C_HA3, R_C_HA4, R_C_HA5, R_C_HA6: GRM188R71C104KA01D; capacitor
R_C_HB0, R_C_HB1, R_C_HB2, R_C_HB3, R_C_HB4, R_C_HB5, R_C_HB6: GRM188R71C104KA01D; capacitor
R_C_HC0, R_C_HC1, R_C_HC2, R_C_HC3, R_C_HC4, R_C_HC5, R_C_HC6: GRM188R71C104KA01D; capacitor
R_C_MUX_A: GRM188R71C104KA01D; capacitor
R_C_MUX_B: GRM188R71C104KA01D; capacitor
R_C_MUX_C: GRM188R71C104KA01D; capacitor
R_H1, R_H2, R_H3, R_H4: NPTH_2.2; NPTH
R_J_WING: BM14B-GHS-TBT(LF)(SN); connector
R_MH_1_1, R_MH_1_2, R_MH_2_1, R_MH_2_2, R_MH_3_1, R_MH_3_2, R_MH_4_1, R_MH_4_2, R_MH_5_1, R_MH_5_2, R_MH_6_1, R_MH_6_2, R_MH_7_1, R_MH_7_2, R_MH_8_1, R_MH_8_2, R_MH_9_1, R_MH_9_2, R_MH_10_1, R_MH_10_2, R_MH_11_1, R_MH_11_2, R_MH_12_1, R_MH_12_2, R_MH_13_1, R_MH_13_2, R_MH_14_1, R_MH_14_2, R_MH_15_1, R_MH_15_2, R_MH_16_1, R_MH_16_2, R_MH_17_1, R_MH_17_2, R_MH_18_1, R_MH_18_2, R_MH_19_1, R_MH_19_2, R_MH_20_1, R_MH_20_2, R_MH_21_1, R_MH_21_2: NPTH_1.7; NPTH
R_TP_H_CTR_RAW: PCB_PAD_1.2MM; testpoint
R_TP_H_DIAG_RAW: PCB_PAD_1.2MM; testpoint
R_TP_H_N_RAW: PCB_PAD_1.2MM; testpoint
R_TP_W_A0, R_TP_W_A1, R_TP_W_A2: PCB_PAD_1.2MM; testpoint
R_TP_W_EN: PCB_PAD_1.2MM; testpoint
R_TP_W_GND: PCB_PAD_1.2MM; testpoint
R_TP_W_GND_A: PCB_PAD_1.2MM; testpoint
R_TP_W_GND_B: PCB_PAD_1.2MM; testpoint
R_TP_W_GND_C: PCB_PAD_1.2MM; testpoint
R_TP_W_H5V: PCB_PAD_1.2MM; testpoint
R_TP_W_MUXA: PCB_PAD_1.2MM; testpoint
R_TP_W_MUXB: PCB_PAD_1.2MM; testpoint
R_TP_W_MUXC: PCB_PAD_1.2MM; testpoint
R_U_HA0, R_U_HA1, R_U_HA2, R_U_HA3, R_U_HA4, R_U_HA5, R_U_HA6: DRV5055A3QDBZR; hall
R_U_HB0, R_U_HB1, R_U_HB2, R_U_HB3, R_U_HB4, R_U_HB5, R_U_HB6: DRV5055A3QDBZR; hall
R_U_HC0, R_U_HC1, R_U_HC2, R_U_HC3, R_U_HC4, R_U_HC5, R_U_HC6: DRV5055A3QDBZR; hall
R_U_MUX_A: TMUX1208PWR; mux
R_U_MUX_B: TMUX1208PWR; mux
R_U_MUX_C: TMUX1208PWR; mux
TOOL_1, TOOL_2, TOOL_3, TOOL_4: NPTH_2

Connections:
L_GND: L_C_HA0.2, L_C_HA1.2, L_C_HA2.2, L_C_HA3.2, L_C_HA4.2, L_C_HA5.2, L_C_HA6.2, L_C_HB0.2, L_C_HB1.2, L_C_HB2.2, L_C_HB3.2, L_C_HB4.2, L_C_HB5.2, L_C_HB6.2, L_C_HC0.2, L_C_HC1.2, L_C_HC2.2, L_C_HC3.2, L_C_HC4.2, L_C_HC5.2, L_C_HC6.2, L_C_MUX_A.2, L_C_MUX_B.2, L_C_MUX_C.2, L_J_WING.2, L_J_WING.4, L_J_WING.8, L_J_WING.10, L_J_WING.12, L_J_WING.14, L_TP_W_GND.1, L_TP_W_GND_A.1, L_TP_W_GND_B.1, L_TP_W_GND_C.1, L_U_HA0.3, L_U_HA1.3, L_U_HA2.3, L_U_HA3.3, L_U_HA4.3, L_U_HA5.3, L_U_HA6.3, L_U_HB0.3, L_U_HB1.3, L_U_HB2.3, L_U_HB3.3, L_U_HB4.3, L_U_HB5.3, L_U_HB6.3, L_U_HC0.3, L_U_HC1.3, L_U_HC2.3, L_U_HC3.3, L_U_HC4.3, L_U_HC5.3, L_U_HC6.3, L_U_MUX_A.14, L_U_MUX_B.14, L_U_MUX_C.14
L_HALL_5V: L_C_HA0.1, L_C_HA1.1, L_C_HA2.1, L_C_HA3.1, L_C_HA4.1, L_C_HA5.1, L_C_HA6.1, L_C_HB0.1, L_C_HB1.1, L_C_HB2.1, L_C_HB3.1, L_C_HB4.1, L_C_HB5.1, L_C_HB6.1, L_C_HC0.1, L_C_HC1.1, L_C_HC2.1, L_C_HC3.1, L_C_HC4.1, L_C_HC5.1, L_C_HC6.1, L_C_MUX_A.1, L_C_MUX_B.1, L_C_MUX_C.1, L_J_WING.1, L_TP_W_H5V.1, L_U_HA0.1, L_U_HA1.1, L_U_HA2.1, L_U_HA3.1, L_U_HA4.1, L_U_HA5.1, L_U_HA6.1, L_U_HB0.1, L_U_HB1.1, L_U_HB2.1, L_U_HB3.1, L_U_HB4.1, L_U_HB5.1, L_U_HB6.1, L_U_HC0.1, L_U_HC1.1, L_U_HC2.1, L_U_HC3.1, L_U_HC4.1, L_U_HC5.1, L_U_HC6.1, L_U_MUX_A.13, L_U_MUX_B.13, L_U_MUX_C.13
L_H_A0_RAW: L_U_HA0.2, L_U_MUX_A.4
L_H_A1_RAW: L_U_HA1.2, L_U_MUX_A.5
L_H_A2_RAW: L_TP_H_CTR_RAW.1, L_U_HA2.2, L_U_MUX_A.6
L_H_A3_RAW: L_U_HA3.2, L_U_MUX_A.7
L_H_A4_RAW: L_U_HA4.2, L_U_MUX_A.12
L_H_A5_RAW: L_U_HA5.2, L_U_MUX_A.11
L_H_A6_RAW: L_U_HA6.2, L_U_MUX_A.10
L_H_B0_RAW: L_U_HB0.2, L_U_MUX_B.4
L_H_B1_RAW: L_U_HB1.2, L_U_MUX_B.5
L_H_B2_RAW: L_TP_H_N_RAW.1, L_U_HB2.2, L_U_MUX_B.6
L_H_B3_RAW: L_U_HB3.2, L_U_MUX_B.7
L_H_B4_RAW: L_U_HB4.2, L_U_MUX_B.12
L_H_B5_RAW: L_U_HB5.2, L_U_MUX_B.11
L_H_B6_RAW: L_U_HB6.2, L_U_MUX_B.10
L_H_C0_RAW: L_TP_H_DIAG_RAW.1, L_U_HC0.2, L_U_MUX_C.4
L_H_C1_RAW: L_U_HC1.2, L_U_MUX_C.5
L_H_C2_RAW: L_U_HC2.2, L_U_MUX_C.6
L_H_C3_RAW: L_U_HC3.2, L_U_MUX_C.7
L_H_C4_RAW: L_U_HC4.2, L_U_MUX_C.12
L_H_C5_RAW: L_U_HC5.2, L_U_MUX_C.11
L_H_C6_RAW: L_U_HC6.2, L_U_MUX_C.10
L_MUX_A0: L_J_WING.3, L_TP_W_A0.1, L_U_MUX_A.1, L_U_MUX_B.1, L_U_MUX_C.1
L_MUX_A1: L_J_WING.5, L_TP_W_A1.1, L_U_MUX_A.16, L_U_MUX_B.16, L_U_MUX_C.16
L_MUX_A2: L_J_WING.6, L_TP_W_A2.1, L_U_MUX_A.15, L_U_MUX_B.15, L_U_MUX_C.15
L_MUX_OUT_A: L_J_WING.9, L_TP_W_MUXA.1, L_U_MUX_A.8
L_MUX_OUT_B: L_J_WING.11, L_TP_W_MUXB.1, L_U_MUX_B.8
L_MUX_OUT_C: L_J_WING.13, L_TP_W_MUXC.1, L_U_MUX_C.8
L_WING_EN: L_J_WING.7, L_TP_W_EN.1, L_U_MUX_A.2, L_U_MUX_B.2, L_U_MUX_C.2
R_GND: R_C_HA0.2, R_C_HA1.2, R_C_HA2.2, R_C_HA3.2, R_C_HA4.2, R_C_HA5.2, R_C_HA6.2, R_C_HB0.2, R_C_HB1.2, R_C_HB2.2, R_C_HB3.2, R_C_HB4.2, R_C_HB5.2, R_C_HB6.2, R_C_HC0.2, R_C_HC1.2, R_C_HC2.2, R_C_HC3.2, R_C_HC4.2, R_C_HC5.2, R_C_HC6.2, R_C_MUX_A.2, R_C_MUX_B.2, R_C_MUX_C.2, R_J_WING.2, R_J_WING.4, R_J_WING.8, R_J_WING.10, R_J_WING.12, R_J_WING.14, R_TP_W_GND.1, R_TP_W_GND_A.1, R_TP_W_GND_B.1, R_TP_W_GND_C.1, R_U_HA0.3, R_U_HA1.3, R_U_HA2.3, R_U_HA3.3, R_U_HA4.3, R_U_HA5.3, R_U_HA6.3, R_U_HB0.3, R_U_HB1.3, R_U_HB2.3, R_U_HB3.3, R_U_HB4.3, R_U_HB5.3, R_U_HB6.3, R_U_HC0.3, R_U_HC1.3, R_U_HC2.3, R_U_HC3.3, R_U_HC4.3, R_U_HC5.3, R_U_HC6.3, R_U_MUX_A.14, R_U_MUX_B.14, R_U_MUX_C.14
R_HALL_5V: R_C_HA0.1, R_C_HA1.1, R_C_HA2.1, R_C_HA3.1, R_C_HA4.1, R_C_HA5.1, R_C_HA6.1, R_C_HB0.1, R_C_HB1.1, R_C_HB2.1, R_C_HB3.1, R_C_HB4.1, R_C_HB5.1, R_C_HB6.1, R_C_HC0.1, R_C_HC1.1, R_C_HC2.1, R_C_HC3.1, R_C_HC4.1, R_C_HC5.1, R_C_HC6.1, R_C_MUX_A.1, R_C_MUX_B.1, R_C_MUX_C.1, R_J_WING.1, R_TP_W_H5V.1, R_U_HA0.1, R_U_HA1.1, R_U_HA2.1, R_U_HA3.1, R_U_HA4.1, R_U_HA5.1, R_U_HA6.1, R_U_HB0.1, R_U_HB1.1, R_U_HB2.1, R_U_HB3.1, R_U_HB4.1, R_U_HB5.1, R_U_HB6.1, R_U_HC0.1, R_U_HC1.1, R_U_HC2.1, R_U_HC3.1, R_U_HC4.1, R_U_HC5.1, R_U_HC6.1, R_U_MUX_A.13, R_U_MUX_B.13, R_U_MUX_C.13
R_H_A0_RAW: R_U_HA0.2, R_U_MUX_A.4
R_H_A1_RAW: R_U_HA1.2, R_U_MUX_A.5
R_H_A2_RAW: R_TP_H_CTR_RAW.1, R_U_HA2.2, R_U_MUX_A.6
R_H_A3_RAW: R_U_HA3.2, R_U_MUX_A.7
R_H_A4_RAW: R_U_HA4.2, R_U_MUX_A.12
R_H_A5_RAW: R_U_HA5.2, R_U_MUX_A.11
R_H_A6_RAW: R_U_HA6.2, R_U_MUX_A.10
R_H_B0_RAW: R_U_HB0.2, R_U_MUX_B.4
R_H_B1_RAW: R_U_HB1.2, R_U_MUX_B.5
R_H_B2_RAW: R_TP_H_N_RAW.1, R_U_HB2.2, R_U_MUX_B.6
R_H_B3_RAW: R_U_HB3.2, R_U_MUX_B.7
R_H_B4_RAW: R_U_HB4.2, R_U_MUX_B.12
R_H_B5_RAW: R_U_HB5.2, R_U_MUX_B.11
R_H_B6_RAW: R_U_HB6.2, R_U_MUX_B.10
R_H_C0_RAW: R_TP_H_DIAG_RAW.1, R_U_HC0.2, R_U_MUX_C.4
R_H_C1_RAW: R_U_HC1.2, R_U_MUX_C.5
R_H_C2_RAW: R_U_HC2.2, R_U_MUX_C.6
R_H_C3_RAW: R_U_HC3.2, R_U_MUX_C.7
R_H_C4_RAW: R_U_HC4.2, R_U_MUX_C.12
R_H_C5_RAW: R_U_HC5.2, R_U_MUX_C.11
R_H_C6_RAW: R_U_HC6.2, R_U_MUX_C.10
R_MUX_A0: R_J_WING.3, R_TP_W_A0.1, R_U_MUX_A.1, R_U_MUX_B.1, R_U_MUX_C.1
R_MUX_A1: R_J_WING.5, R_TP_W_A1.1, R_U_MUX_A.16, R_U_MUX_B.16, R_U_MUX_C.16
R_MUX_A2: R_J_WING.6, R_TP_W_A2.1, R_U_MUX_A.15, R_U_MUX_B.15, R_U_MUX_C.15
R_MUX_OUT_A: R_J_WING.9, R_TP_W_MUXA.1, R_U_MUX_A.8
R_MUX_OUT_B: R_J_WING.11, R_TP_W_MUXB.1, R_U_MUX_B.8
R_MUX_OUT_C: R_J_WING.13, R_TP_W_MUXC.1, R_U_MUX_C.8
R_WING_EN: R_J_WING.7, R_TP_W_EN.1, R_U_MUX_A.2, R_U_MUX_B.2, R_U_MUX_C.2
