ihsinoky/he-piantor-42/hardware/sensor-test/kicad/hall-front-end.kicad_sch

## KiCad design hardware/sensor-test/kicad/hall-front-end.kicad_sch (2026-09-26)

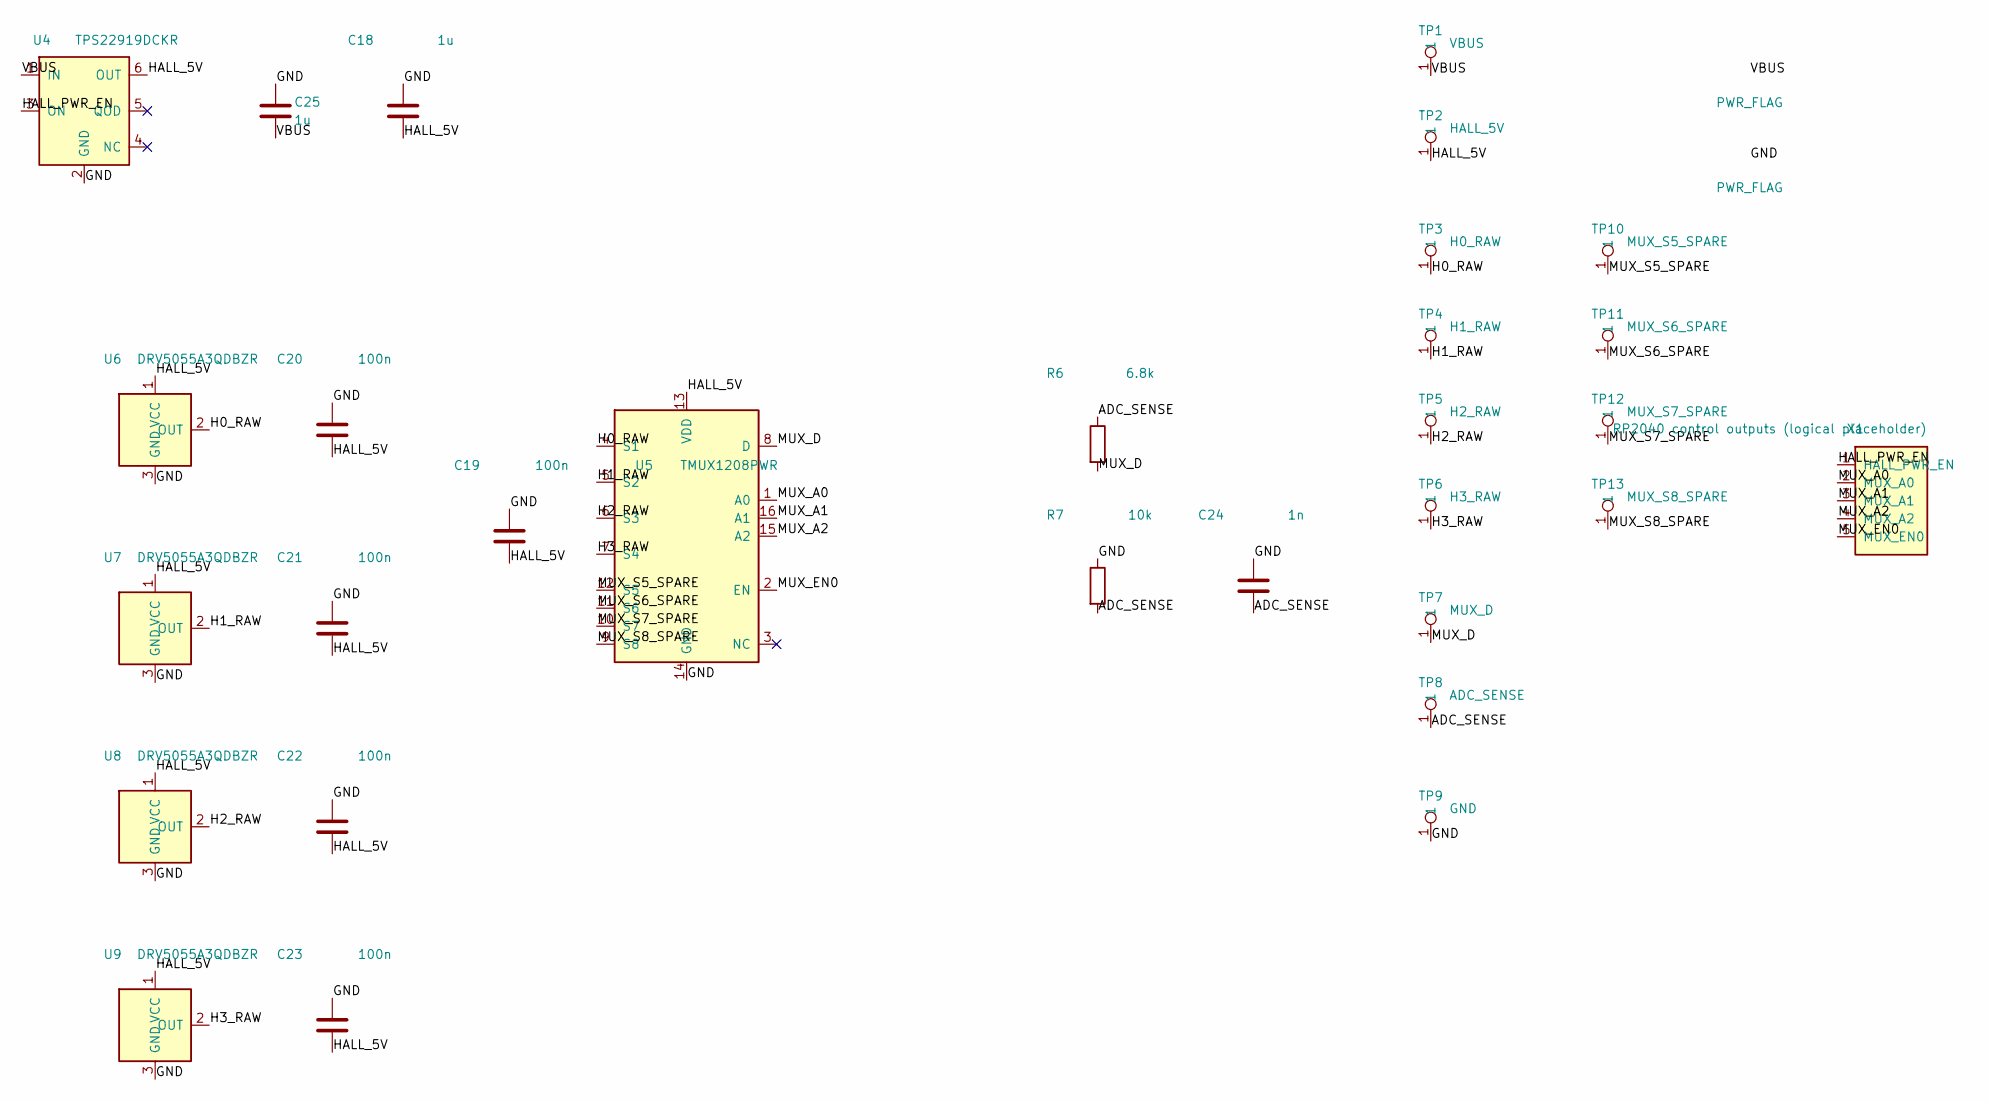
[picture p70: schematic hall-front-end.kicad_sch]

Parts:
C18, C25: 1u; C_0603_1608Metric
C19, C20, C21, C22, C23: 100n; C_0603_1608Metric
C24: 1n; C_0603_1608Metric
R6: 6.8k; R_0603_1608Metric
R7: 10k; R_0603_1608Metric
TP1: VBUS; TestPoint_Pad_D1.5mm
TP2: HALL_5V; TestPoint_Pad_D1.5mm
TP3: H0_RAW; TestPoint_Pad_D1.5mm
TP4: H1_RAW; TestPoint_Pad_D1.5mm
TP5: H2_RAW; TestPoint_Pad_D1.5mm
TP6: H3_RAW; TestPoint_Pad_D1.5mm
TP7: MUX_D; TestPoint_Pad_D1.5mm
TP8: ADC_SENSE; TestPoint_Pad_D1.5mm
TP9: GND; TestPoint_Pad_D1.5mm
TP10: MUX_S5_SPARE; TestPoint_Pad_D1.5mm
TP11: MUX_S6_SPARE; TestPoint_Pad_D1.5mm
TP12: MUX_S7_SPARE; TestPoint_Pad_D1.5mm
TP13: MUX_S8_SPARE; TestPoint_Pad_D1.5mm
U4: TPS22919DCKR; SOT-363_SC-70-6; LCSC C2149796
U5: TMUX1208PWR; TSSOP-16_4.4x5mm_P0.65mm; LCSC C494728
U6, U7, U8, U9: DRV5055A3QDBZR; SW_MX_HE_0deg_1u; LCSC C266128
X1: RP2040 control outputs (logical placeholder)

Connections:
ADC_SENSE: C24.2, R6.1, R7.2, TP8.1
GND: C18.1, C19.1, C20.1, C21.1, C22.1, C23.1, C24.1, C25.1, R7.1, TP9.1, U4.2 (GND), U5.14 (GND), U6.3 (GND), U7.3 (GND), U8.3 (GND), U9.3 (GND)
H0_RAW: TP3.1, U5.4 (S1), U6.2 (OUT)
H1_RAW: TP4.1, U5.5 (S2), U7.2 (OUT)
H2_RAW: TP5.1, U5.6 (S3), U8.2 (OUT)
H3_RAW: TP6.1, U5.7 (S4), U9.2 (OUT)
HALL_5V: C18.2, C19.2, C20.2, C21.2, C22.2, C23.2, TP2.1, U4.6 (OUT), U5.13 (VDD), U6.1 (VCC), U7.1 (VCC), U8.1 (VCC), U9.1 (VCC)
HALL_PWR_EN: U4.3 (ON), X1.1 (HALL_PWR_EN)
MUX_A0: U5.1 (A0), X1.2 (MUX_A0)
MUX_A1: U5.16 (A1), X1.3 (MUX_A1)
MUX_A2: U5.15 (A2), X1.4 (MUX_A2)
MUX_D: R6.2, TP7.1, U5.8 (D)
MUX_EN0: U5.2 (EN), X1.5 (MUX_EN0)
MUX_S5_SPARE: TP10.1, U5.12 (S5)
MUX_S6_SPARE: TP11.1, U5.11 (S6)
MUX_S7_SPARE: TP12.1, U5.10 (S7)
MUX_S8_SPARE: TP13.1, U5.9 (S8)
VBUS: C25.2, TP1.1, U4.1 (IN)
