ihsinoky/he-piantor-42/hardware/sensor-test/kicad/integrated-sensor-test.kicad_sch

## KiCad design hardware/sensor-test/kicad/integrated-sensor-test.kicad_sch (2026-09-27)

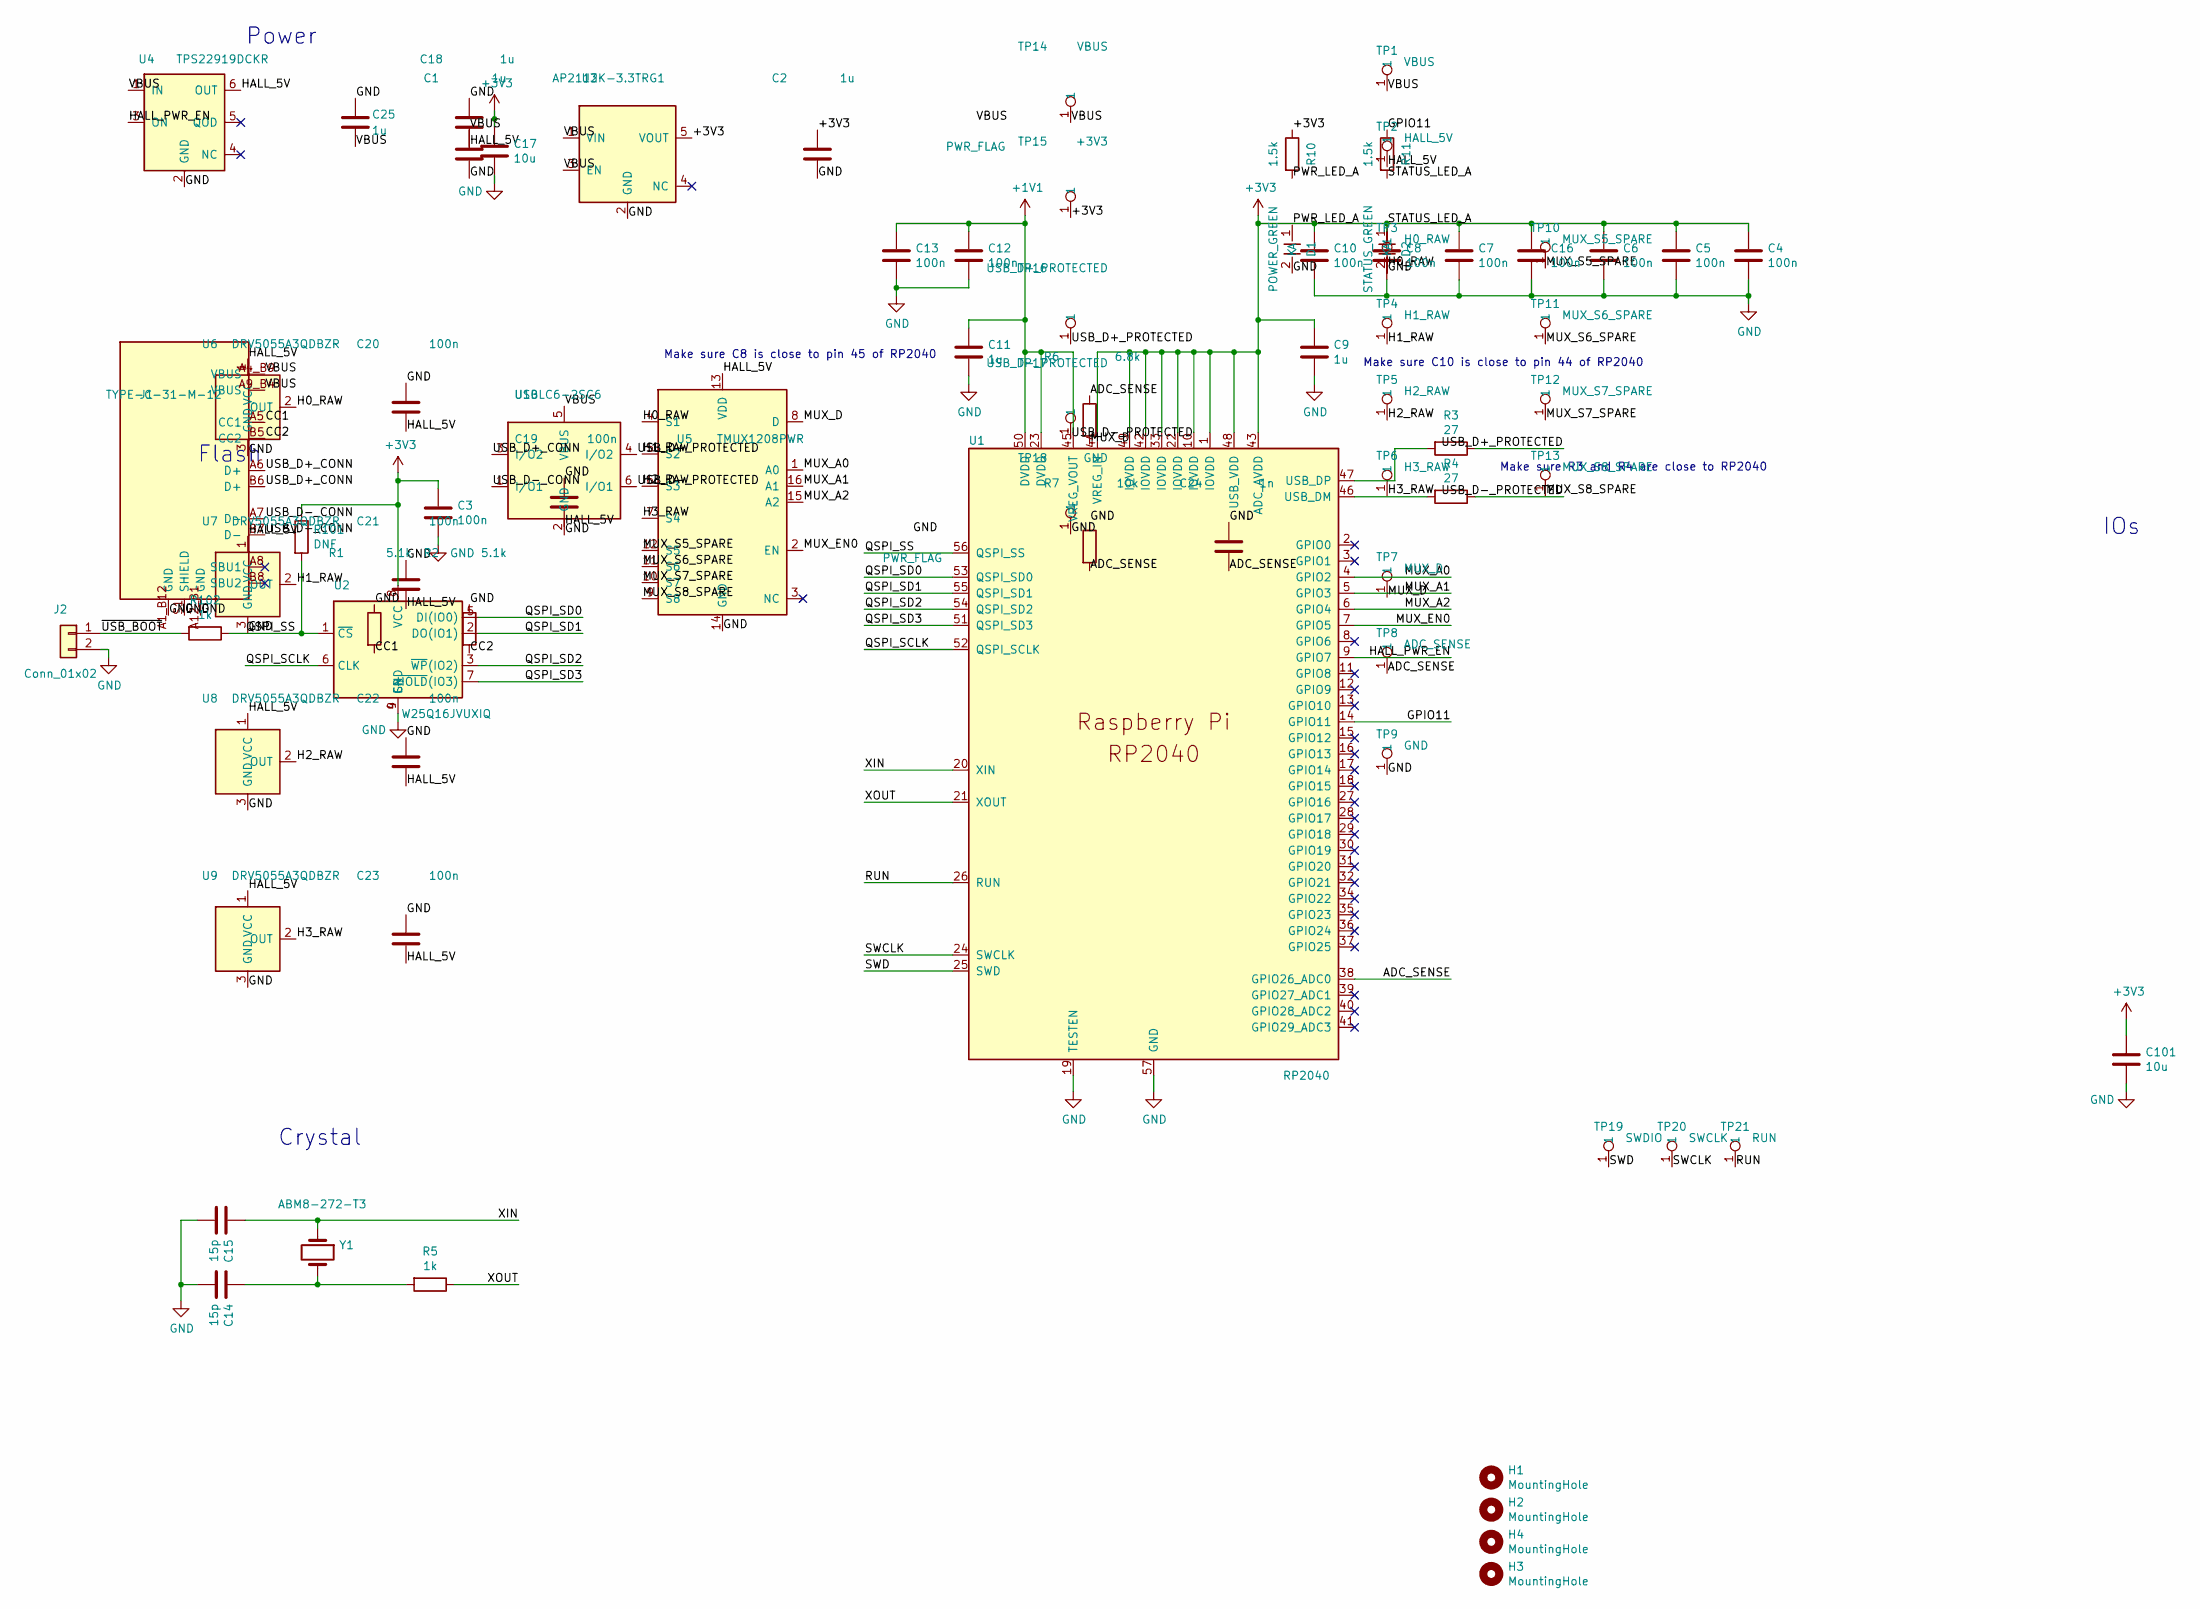
[picture p72: schematic integrated-sensor-test.kicad_sch]

Parts:
C1, C2, C18, C25: 1u; C_0603_1608Metric
C3, C4, C5, C6, C7, C8, C10, C12, C13, C16: 100n; C_0402_1005Metric; LCSC C126504
C9, C11: 1u; C_0402_1005Metric; LCSC C307331
C14, C15: 15p; C_0402_1005Metric
C17, C101: 10u; C_0805_2012Metric; LCSC C15850
C19, C20, C21, C22, C23: 100n; C_0603_1608Metric
C24: 1n; C_0603_1608Metric
D1: POWER_GREEN; LED_0603_1608Metric
D2: STATUS_GREEN; LED_0603_1608Metric
H1, H2, H3, H4: MountingHole; MountingHole_2.7mm_M2.5
J1: TYPE-C-31-M-12; USB_C_Receptacle_HRO_TYPE-C-31-M-12; LCSC C165948
J2: Conn_01x02; PinHeader_1x02_P2.54mm_Vertical; LCSC C124375
R1, R2: 5.1k; R_0603_1608Metric
R3, R4: 27; C_0402_1005Metric; LCSC C274349
R5: 1k; R_0402_1005Metric; LCSC C11702
R6: 6.8k; R_0603_1608Metric
R7: 10k; R_0603_1608Metric
R10, R11: 1.5k; R_0603_1608Metric
R101: DNF; C_0402_1005Metric
R102: 1k; C_0402_1005Metric; LCSC C11702
TP1, TP14: VBUS; TestPoint_Pad_D1.5mm
TP2: HALL_5V; TestPoint_Pad_D1.5mm
TP3: H0_RAW; TestPoint_Pad_D1.5mm
TP4: H1_RAW; TestPoint_Pad_D1.5mm
TP5: H2_RAW; TestPoint_Pad_D1.5mm
TP6: H3_RAW; TestPoint_Pad_D1.5mm
TP7: MUX_D; TestPoint_Pad_D1.5mm
TP8: ADC_SENSE; TestPoint_Pad_D1.5mm
TP9, TP18: GND; TestPoint_Pad_D1.5mm
TP10: MUX_S5_SPARE; TestPoint_Pad_D1.5mm
TP11: MUX_S6_SPARE; TestPoint_Pad_D1.5mm
TP12: MUX_S7_SPARE; TestPoint_Pad_D1.5mm
TP13: MUX_S8_SPARE; TestPoint_Pad_D1.5mm
TP15: +3V3; TestPoint_Pad_D1.5mm
TP16: USB_D+_PROTECTED; TestPoint_Pad_D1.5mm
TP17: USB_D-_PROTECTED; TestPoint_Pad_D1.5mm
TP19: SWDIO; TestPoint_Pad_D1.5mm
TP20: SWCLK; TestPoint_Pad_D1.5mm
TP21: RUN; TestPoint_Pad_D1.5mm
U1: RP2040; RP2040-QFN-56; LCSC C2040
U2: W25Q16JVUXIQ; USON-8_UX_2x3x0p6_WIN; LCSC C2843335
U3: AP2112K-3.3TRG1; SOT-23-5; LCSC C51118
U4: TPS22919DCKR; SOT-363_SC-70-6; LCSC C2149796
U5: TMUX1208PWR; TSSOP-16_4.4x5mm_P0.65mm; LCSC C494728
U6, U7, U8, U9: DRV5055A3QDBZR; SW_MX_HE_0deg_1u; LCSC C266128
U10: USBLC6-2SC6; SOT-23-6; LCSC C7519
Y1: ABM8-272-T3; Crystal_SMD_Abracon_ABM8G-2Pin_3.2x2.5mm; LCSC C20625731

Connections:
+1V1: C11.1, C12.1, C13.1, U1.23 (DVDD), U1.45 (VREG_VOUT), U1.50 (DVDD)
+3V3: C2.1, C3.1, C4.1, C5.1, C6.1, C7.1, C8.1, C9.1, C10.1, C16.1, C17.1, C101.1, R10.1, R101.1, TP15.1, U1.1 (IOVDD), U1.10 (IOVDD), U1.22 (IOVDD), U1.33 (IOVDD), U1.42 (IOVDD), U1.43 (ADC_AVDD), U1.44 (VREG_IN), U1.48 (USB_VDD), U1.49 (IOVDD), U2.8 (VCC), U3.5 (VOUT)
ADC_SENSE: C24.2, R6.1, R7.2, TP8.1, U1.38 (GPIO26_ADC0)
CC1: J1.A5 (CC1), R1.2
CC2: J1.B5 (CC2), R2.2
GND: C1.2, C2.2, C3.2, C4.2, C5.2, C6.2, C7.2, C8.2, C9.2, C10.2, C11.2, C12.2, C13.2, C14.2, C15.2, C16.2, C17.2, C18.1, C19.1, C20.1, C21.1, C22.1, C23.1, C24.1, C25.1, C101.2, D1.2 (A), D2.2 (A), J1.A1_B12 (GND), J1.A12_B1 (GND), J1.S1 (SHIELD), J2.2, R1.1, R2.1, R7.1, TP9.1, TP18.1, U1.19 (TESTEN), U1.57 (GND), U2.4 (GND), U2.9 (EP), U3.2 (GND), U4.2 (GND), U5.14 (GND), U6.3 (GND), U7.3 (GND), U8.3 (GND), U9.3 (GND), U10.2 (GND)
GPIO11: R11.1, U1.14 (GPIO11)
H0_RAW: TP3.1, U5.4 (S1), U6.2 (OUT)
H1_RAW: TP4.1, U5.5 (S2), U7.2 (OUT)
H2_RAW: TP5.1, U5.6 (S3), U8.2 (OUT)
H3_RAW: TP6.1, U5.7 (S4), U9.2 (OUT)
HALL_5V: C18.2, C19.2, C20.2, C21.2, C22.2, C23.2, TP2.1, U4.6 (OUT), U5.13 (VDD), U6.1 (VCC), U7.1 (VCC), U8.1 (VCC), U9.1 (VCC)
HALL_PWR_EN: U1.9 (GPIO7), U4.3 (ON)
MUX_A0: U1.4 (GPIO2), U5.1 (A0)
MUX_A1: U1.5 (GPIO3), U5.16 (A1)
MUX_A2: U1.6 (GPIO4), U5.15 (A2)
MUX_D: R6.2, TP7.1, U5.8 (D)
MUX_EN0: U1.7 (GPIO5), U5.2 (EN)
MUX_S5_SPARE: TP10.1, U5.12 (S5)
MUX_S6_SPARE: TP11.1, U5.11 (S6)
MUX_S7_SPARE: TP12.1, U5.10 (S7)
MUX_S8_SPARE: TP13.1, U5.9 (S8)
unnamed: C14.1, R5.2, Y1.2
unnamed: R3.2, U1.47 (USB_DP)
unnamed: R4.2, U1.46 (USB_DM)
PWR_LED_A: D1.1 (K), R10.2
QSPI_SCLK: U1.52 (QSPI_SCLK), U2.6 (CLK)
QSPI_SD0: U1.53 (QSPI_SD0), U2.5 (DI(IO0))
QSPI_SD1: U1.55 (QSPI_SD1), U2.2 (DO(IO1))
QSPI_SD2: U1.54 (QSPI_SD2), U2.3 (~WP(IO2))
QSPI_SD3: U1.51 (QSPI_SD3), U2.7 (~HOLD(IO3))
QSPI_SS: R101.2, R102.1, U1.56 (QSPI_SS), U2.1 (~CS)
RUN: TP21.1, U1.26 (RUN)
STATUS_LED_A: D2.1 (K), R11.2
SWCLK: TP20.1, U1.24 (SWCLK)
SWD: TP19.1, U1.25 (SWD)
USB_D+_CONN: J1.A6 (D+), J1.B6 (D+), U10.3 (I/O2)
USB_D+_PROTECTED: R3.1, TP16.1, U10.4 (I/O2)
USB_D-_CONN: J1.A7 (D-), J1.B7 (D-), U10.1 (I/O1)
USB_D-_PROTECTED: R4.1, TP17.1, U10.6 (I/O1)
VBUS: C1.1, C25.2, J1.A4_B9 (VBUS), J1.A9_B4 (VBUS), TP1.1, TP14.1, U3.1 (VIN), U3.3 (EN), U4.1 (IN), U10.5 (VBUS)
XIN: C15.1, U1.20 (XIN), Y1.1
XOUT: R5.1, U1.21 (XOUT)
~USB_BOOT: J2.1, R102.2

Notes on the sheet:
IOs
Make sure C8 is close to pin 45 of RP2040
Make sure C10 is close to pin 44 of RP2040
Crystal
Power
Flash
Make sure R3 and R4 are close to RP2040
