ihsinoky/he-piantor-42/hardware/sensor-test/kicad/usb-power.kicad_sch

## KiCad design hardware/sensor-test/kicad/usb-power.kicad_sch (2026-09-26)

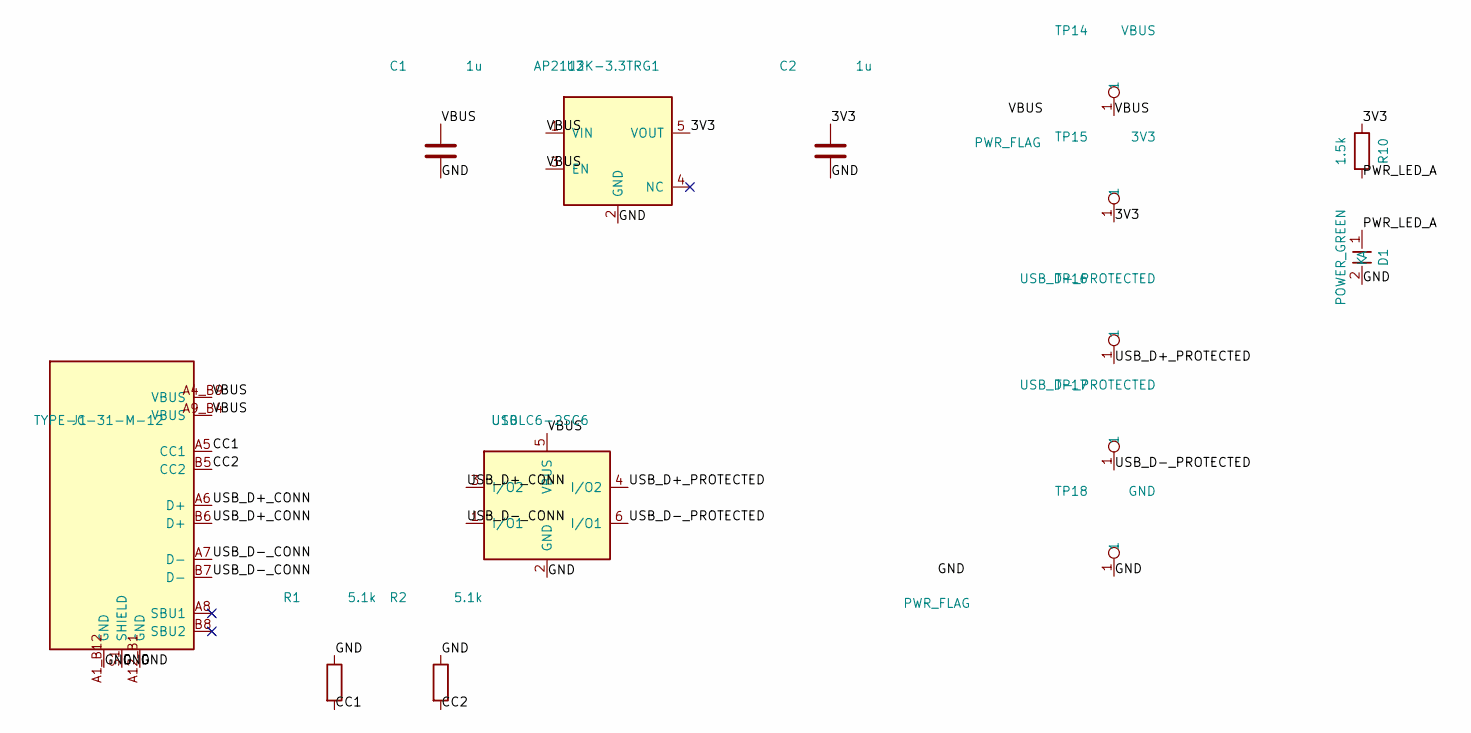
[picture p73: schematic usb-power.kicad_sch]

Parts:
C1, C2: 1u; C_0603_1608Metric
D1: POWER_GREEN; LED_0603_1608Metric
J1: TYPE-C-31-M-12; USB_C_Receptacle_HRO_TYPE-C-31-M-12; LCSC C165948
R1, R2: 5.1k; R_0603_1608Metric
R10: 1.5k; R_0603_1608Metric
TP14: VBUS; TestPoint_Pad_D1.5mm
TP15: 3V3; TestPoint_Pad_D1.5mm
TP16: USB_D+_PROTECTED; TestPoint_Pad_D1.5mm
TP17: USB_D-_PROTECTED; TestPoint_Pad_D1.5mm
TP18: GND; TestPoint_Pad_D1.5mm
U3: AP2112K-3.3TRG1; SOT-23-5; LCSC C51118
U10: USBLC6-2SC6; SOT-23-6; LCSC C7519

Connections:
3V3: C2.1, R10.1, TP15.1, U3.5 (VOUT)
CC1: J1.A5 (CC1), R1.2
CC2: J1.B5 (CC2), R2.2
GND: C1.2, C2.2, D1.2 (A), J1.A1_B12 (GND), J1.A12_B1 (GND), J1.S1 (SHIELD), R1.1, R2.1, TP18.1, U3.2 (GND), U10.2 (GND)
PWR_LED_A: D1.1 (K), R10.2
USB_D+_CONN: J1.A6 (D+), J1.B6 (D+), U10.3 (I/O2)
USB_D+_PROTECTED: TP16.1, U10.4 (I/O2)
USB_D-_CONN: J1.A7 (D-), J1.B7 (D-), U10.1 (I/O1)
USB_D-_PROTECTED: TP17.1, U10.6 (I/O1)
VBUS: C1.1, J1.A4_B9 (VBUS), J1.A9_B4 (VBUS), TP14.1, U3.1 (VIN), U3.3 (EN), U10.5 (VBUS)
