ihsinoky/he-piantor-42/hardware/kicad/qualification/issue-196-main-rev4-phaseb/schematic/main.kicad_sch

## KiCad design hardware/kicad/qualification/issue-196-main-rev4-phaseb/schematic/main.kicad_sch (2026-11-07)

Schematic: main.kicad_sch

Parts:
C1: 15pF; C1
C2: 15pF; C2
C3: 100nF; C3
C4: 100nF; C4
C5: 100nF; C5
C6: 100nF; C6
C7: 100nF; C7
C8: 100nF; C8
C9: 100nF; C9
C10: 100nF; C10
C11: 100nF; C11
C12: 1uF; C12
C13: 1uF; C13
C14: 10uF; C14
C15: 100nF; C15
C16: 1uF; C16
C17: 1uF; C17
C18: 1uF; C18
C19: 1uF; C19
C20: 1nF; C20
C21: 1nF; C21
C22: 1nF; C22
C23: 22uF 16V X6S 0805; C23
C24: 22uF 16V X6S 0805; C24
C25: 100nF; C25
C26: 22uF 16V X7R 1210; C26
C27: 22uF 16V X7R 1210; C27
C28: 22uF 16V X7R 1210; C28
J2: BM14B-GHS-TBT(LF)(SN); J2
J3: BM14B-GHS-TBT(LF)(SN); J3
J4: SM04B-SRSS-TB(LF)(SN); J4
L1: 1.5uH XFL4020-152MEC; L1
R3: 27; R3
R4: 27; R4
R5: 1k; R5
R6: 100k; R6
R7: 100k; R7
R8: 10k; R8
R9: 1k; R9
R10: 6.8k; R10
R11: 10k; R11
R12: 6.8k; R12
R13: 10k; R13
R14: 6.8k; R14
R15: 10k; R15
R16: 100k; R16
R17: 54.9k 0.1% 25ppm/K; R17
R18: 10k 0.1% 25ppm/K; R18
R19: 100k; R19
TP1: TestPoint; TP1
TP2: TestPoint; TP2
TP3: TestPoint; TP3
TP4: TestPoint; TP4
U1: RP2040; U1
U3: W25Q16JVUXIQ; U3
U4: AP2112K-3.3TRG1; U4
U5: TPS22919DCKR; U5
U6: TPS63070RNMR; U6
Y1: ABM8-272-T3; Y1

Connections:
ADC_A: C20.1, R10.2, R11.1, U1.38 (GPIO26/ADC0)
ADC_B: C21.1, R12.2, R13.1, U1.39 (GPIO27/ADC1)
ADC_C: C22.1, R14.2, R15.1, U1.40 (GPIO28/ADC2)
FB_5V2: R17.2, R18.1, U6.5 (FB)
GND: C1.2, C2.2, C3.2, C4.2, C5.2, C6.2, C7.2, C8.2, C9.2, C10.2, C11.2, C12.2, C13.2, C14.2, C15.2, C16.2, C17.2, C18.2, C19.2, C20.2, C21.2, C22.2, C23.2, C24.2, C25.2, C26.2, C27.2, C28.2, J2.2, J2.4, J2.8, J2.10, J2.12, J2.14, J3.2, J3.4, J3.8, J3.10, J3.12, J3.14, J4.4, R6.2, R7.2, R11.2, R13.2, R15.2, R16.2, R18.2, U1.19 (TESTEN), U1.57 (GND), U3.4 (GND), U4.2 (GND), U5.2 (GND), U6.1 (PS/SYNC), U6.4 (GND), U6.6 (FB2), U6.10 (PGND), U6.15 (VSEL), Y1.2 (G), Y1.4 (G)
HALL_5V: C19.1, J2.1, J3.1, U5.6 (OUT)
HALL_PWR_EN: R7.1, U1.9 (GPIO7), U5.3 (ON), U6.14 (EN)
MUX_A0: J2.3, J3.3, U1.4 (GPIO2)
MUX_A1: J2.5, J3.5, U1.5 (GPIO3)
MUX_A2: J2.6, J3.6, U1.6 (GPIO4)
MUX_EN1: J3.7, R16.1, U1.8 (GPIO6)
MUX_OUT_A: J2.9, J3.9, R10.1
MUX_OUT_B: J2.11, J3.11, R12.1
MUX_OUT_C: J2.13, J3.13, R14.1
QSPI_SCLK: U1.52 (QSPI_SCLK), U3.6 (CLK)
QSPI_SD0: U1.53 (QSPI_SD0), U3.5 (DI(IO0))
QSPI_SD1: U1.55 (QSPI_SD1), U3.2 (DO(IO1))
QSPI_SD2: U1.54 (QSPI_SD2), U3.3 (~WP(IO2))
QSPI_SD3: U1.51 (QSPI_SD3), U3.7 (~HOLD(IO3))
QSPI_SS_FLASH: R5.2, TP4.1, U3.1 (~CS)
QSPI_SS_MCU: R5.1, U1.56 (~QSPI_SS)
RAIL_PG: R19.2, U6.2 (PG)
RUN: R8.2, TP3.1, U1.26 (RUN)
SW1: L1.1, U6.11 (L1)
SW2: L1.2, U6.9 (L2)
SWCLK: TP2.1, U1.24 (SWCLK)
SWDIO: TP1.1, U1.25 (SWDIO)
USB_DM: R4.2, U1.46 (USB_DM)
USB_DM_ESD: J4.2, R4.1
USB_DP: R3.2, U1.47 (USB_DP)
USB_DP_ESD: J4.3, R3.1
V1V1: C11.1, C13.1, U1.23 (DVDD), U1.45 (VREG_VOUT), U1.50 (DVDD)
V3V3: C3.1, C4.1, C5.1, C6.1, C7.1, C8.1, C9.1, C10.1, C12.1, C14.1, C15.1, C17.1, R8.1, R19.1, U1.1 (IOVDD), U1.10 (IOVDD), U1.22 (IOVDD), U1.33 (IOVDD), U1.42 (IOVDD), U1.43 (ADC_AVDD), U1.44 (VREG_VIN), U1.48 (USB_VDD), U1.49 (IOVDD), U3.8 (VCC), U4.5 (VOUT)
V5V2: C26.1, C27.1, C28.1, R17.1, U5.1 (IN), U6.7 (VOUT), U6.8 (VOUT)
VAUX: C25.1, U6.3 (VAUX)
VBUS: C16.1, C18.1, C23.1, C24.1, J4.1, U4.1 (VIN), U4.3 (EN), U6.12 (VIN), U6.13 (VIN)
WING_EN: J2.7, R6.1, U1.7 (GPIO5)
XIN: C1.1, U1.20 (XIN), Y1.1
XOUT: R9.2, U1.21 (XOUT)
XOUT_XTAL: C2.1, R9.1, Y1.3
