ihsinoky/he-piantor-42/hardware/kicad/qualification/eda-004f/evidence/processes/conflict-generate/fixture.kicad_sch

## KiCad design hardware/kicad/qualification/eda-004f/evidence/processes/conflict-generate/fixture.kicad_sch (2026-10-14)

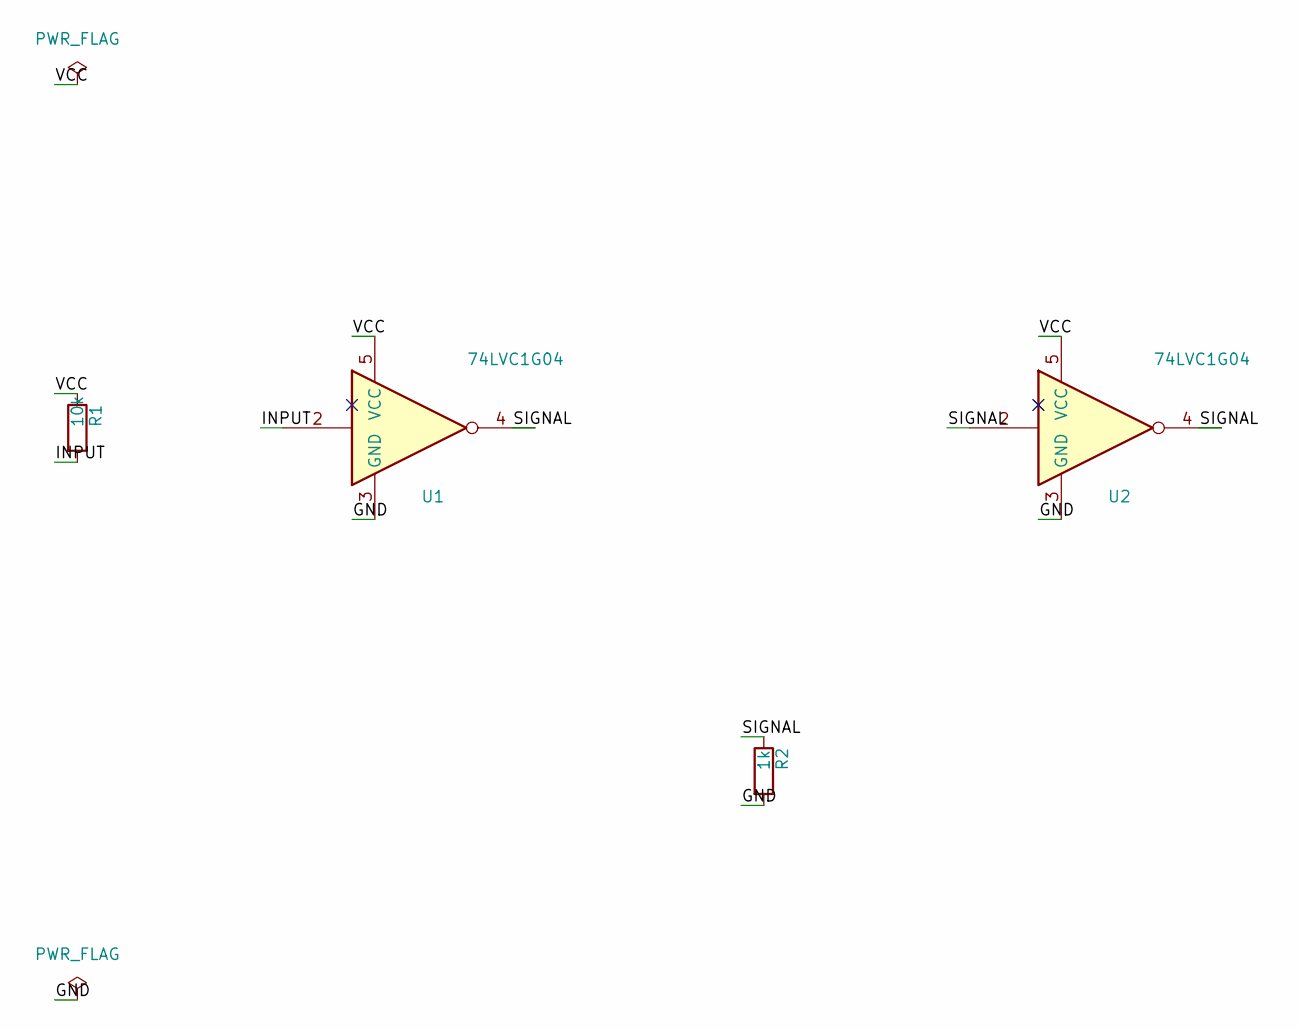
[picture p74: schematic fixture.kicad_sch]

Parts:
R1: 10k
R2: 1k
U1, U2: 74LVC1G04

Connections:
GND: R2.2, U1.3 (GND), U2.3 (GND)
INPUT: R1.2, U1.2
SIGNAL: R2.1, U1.4, U2.2, U2.4
VCC: R1.1, U1.5 (VCC), U2.5 (VCC)
