ihsinoky/he-piantor-42/hardware/kicad/qualification/eda-004g/resume-01/evidence/processes/initial-author-schematic-annotation-compatible/main.kicad_sch

## KiCad design hardware/kicad/qualification/eda-004g/resume-01/evidence/processes/initial-author-schematic-annotation-compatible/main.kicad_sch (2026-10-14)

Schematic: main.kicad_sch

Parts:
C1: 15pF; C1
C2: 15pF; C2
C3: 100nF; C3
C4: 100nF; C4
C5: 100nF; C5
C6: 100nF; C6
C7: 100nF; C7
C8: 100nF; C8
C9: 100nF; C9
C10: 100nF; C10
C11: 100nF; C11
C12: 1uF; C12
C13: 1uF; C13
C14: 10uF; C14
C15: 100nF; C15
C16: 1uF; C16
C17: 1uF; C17
C18: 1uF; C18
C19: 1uF; C19
C20: 1nF; C20
C21: 1nF; C21
C22: 1nF; C22
J1: TYPE-C-31-M-12; J1
J2: BM14B-GHS-TBT(LF)(SN); J2
R1: 5.1k; R1
R2: 5.1k; R2
R3: 27; R3
R4: 27; R4
R5: 1k; R5
R6: 100k; R6
R7: 100k; R7
R8: 10k; R8
R9: 1k; R9
R10: 6.8k; R10
R11: 10k; R11
R12: 6.8k; R12
R13: 10k; R13
R14: 6.8k; R14
R15: 10k; R15
TP1: TestPoint; TP1
TP2: TestPoint; TP2
TP3: TestPoint; TP3
TP4: TestPoint; TP4
U1: RP2040; U1
U2: USBLC6-2SC6; U2
U3: W25Q16JVUXIQ; U3
U4: AP2112K-3.3TRG1; U4
U5: TPS22919DCKR; U5
Y1: ABM8-272-T3; Y1

Connections:
ADC_A: C20.1, R10.2, R11.1, U1.38 (GPIO26/ADC0)
ADC_B: C21.1, R12.2, R13.1, U1.39 (GPIO27/ADC1)
ADC_C: C22.1, R14.2, R15.1, U1.40 (GPIO28/ADC2)
CC1: J1.3 (CC1), R1.1
CC2: J1.10 (CC2), R2.1
GND: C1.2, C2.2, C3.2, C4.2, C5.2, C6.2, C7.2, C8.2, C9.2, C10.2, C11.2, C12.2, C13.2, C14.2, C15.2, C16.2, C17.2, C18.2, C19.2, C20.2, C21.2, C22.2, J1.1 (GND), J1.12 (GND), J1.13 (SHIELD), J2.2, J2.4, J2.8, J2.10, J2.12, J2.14, R1.2, R2.2, R6.2, R7.2, R11.2, R13.2, R15.2, U1.19 (TESTEN), U1.57 (GND), U2.2 (GND), U3.4 (GND), U4.2 (GND), U5.2 (GND), Y1.2 (G), Y1.4 (G)
HALL_5V: C19.1, J2.1, U5.6 (OUT)
HALL_PWR_EN: R7.1, U1.9 (GPIO7), U5.3 (ON)
MUX_A0: J2.3, U1.4 (GPIO2)
MUX_A1: J2.5, U1.5 (GPIO3)
MUX_A2: J2.6, U1.6 (GPIO4)
MUX_OUT_A: J2.9, R10.1
MUX_OUT_B: J2.11, R12.1
MUX_OUT_C: J2.13, R14.1
QSPI_SCLK: U1.52 (QSPI_SCLK), U3.6 (CLK)
QSPI_SD0: U1.53 (QSPI_SD0), U3.5 (DI(IO0))
QSPI_SD1: U1.55 (QSPI_SD1), U3.2 (DO(IO1))
QSPI_SD2: U1.54 (QSPI_SD2), U3.3 (~WP(IO2))
QSPI_SD3: U1.51 (QSPI_SD3), U3.7 (~HOLD(IO3))
QSPI_SS_FLASH: R5.2, TP4.1, U3.1 (~CS)
QSPI_SS_MCU: R5.1, U1.56 (~QSPI_SS)
RUN: R8.2, TP3.1, U1.26 (RUN)
SWCLK: TP2.1, U1.24 (SWCLK)
SWDIO: TP1.1, U1.25 (SWDIO)
USB_DM: R4.2, U1.46 (USB_DM)
USB_DM_CONN: J1.5 (D-), J1.8 (D-), U2.3 (I/O2)
USB_DM_ESD: R4.1, U2.4 (I/O2)
USB_DP: R3.2, U1.47 (USB_DP)
USB_DP_CONN: J1.4 (D+), J1.9 (D+), U2.1 (I/O1)
USB_DP_ESD: R3.1, U2.6 (I/O1)
V1V1: C11.1, C13.1, U1.23 (DVDD), U1.45 (VREG_VOUT), U1.50 (DVDD)
V3V3: C3.1, C4.1, C5.1, C6.1, C7.1, C8.1, C9.1, C10.1, C12.1, C14.1, C15.1, C17.1, R8.1, U1.1 (IOVDD), U1.10 (IOVDD), U1.22 (IOVDD), U1.33 (IOVDD), U1.42 (IOVDD), U1.43 (ADC_AVDD), U1.44 (VREG_VIN), U1.48 (USB_VDD), U1.49 (IOVDD), U3.8 (VCC), U4.5 (VOUT)
VBUS: C16.1, C18.1, J1.2 (VBUS), J1.11 (VBUS), U2.5 (VBUS), U4.1 (VIN), U4.3 (EN), U5.1 (IN)
WING_EN: J2.7, R6.1, U1.7 (GPIO5)
XIN: C1.1, U1.20 (XIN), Y1.1
XOUT: R9.2, U1.21 (XOUT)
XOUT_XTAL: C2.1, R9.1, Y1.3
