ihsinoky/he-piantor-42/(commit log)

2026-09-25 Add sensor evaluation board workspace
2026-09-25 Add main PCB workspace
2026-09-25 Add 17 mm transformed key coordinates
    [key_positions.csv]
2026-09-25 Vendor Magnetic Jade HE switch footprint
2026-09-25 Document third-party HE footprint
2026-09-25 Define Hall sensor evaluation architecture
2026-09-25 Revise Hall acquisition to switched 5V TMUX1208 architecture
2026-09-25 Define sensor-test electrical design
2026-09-25 Add provisional sensor-test BOM
    [bom.csv]
2026-09-25 Add RP2040 pin allocation
    [pinmap.csv]
2026-09-25 Add Hall keyboard power budget
    [power-budget.csv]
2026-09-25 Add sensor evaluation verification plan
2026-09-25 Vendor RP2040 minimal reference: RP2040_minimal.kicad_sch
2026-09-25 Vendor RP2040 minimal reference: RP2040_minimal.kicad_pcb
2026-09-25 Vendor RP2040 minimal reference: RP2040_minimal.kicad_pro
2026-09-25 Sync dashboard with current engineering status
2026-09-25 Add layout and KiCad engineering CI
2026-09-25 Fix KiCad CI report permissions
2026-09-25 Normalize generated layout rotation values
    [key_positions.csv]
2026-09-25 Align system specification with Hall acquisition design
2026-09-25 Record Hall power, mux, PCB thickness, and evaluation decisions
2026-09-25 Align sensor-test BOM with captured Hall front end
    [bom.csv]
2026-09-25 Update dashboard for sensor-test hardware and firmware work
2026-09-25 Collect all KiCad ERC and DRC reports in CI
2026-09-25 Align USB and 3V3 BOM references with schematic
    [bom.csv]
2026-09-26 Align sensor-test BOM with RP2040 core
    [bom.csv]
2026-09-26 Fix evaluation LED BOM references
    [bom.csv]
2026-09-26 Sensor-test electrical baseline (#2)
    Establish the reviewable USB/power and Hall front-end baseline, sensor-test firmware, engineering CI, licensed reference assets, dashboard Preview workflow, and PR-based development process.
    [hall-front-end.kicad_sch, he-piantor-sensor-test.kicad_sch, usb-power.kicad_sch]
2026-09-27 Integrate four-key Hall evaluation schematic
    [integrated-sensor-test.kicad_sch]
2026-09-27 Fix integrated schematic power declarations
    [integrated-sensor-test.kicad_sch]
2026-09-27 Remove RP2040 reference-only circuitry
    [integrated-sensor-test.kicad_sch]
2026-09-27 Restore loadable flash symbol definition
    [integrated-sensor-test.kicad_sch]
2026-09-27 Remove breakout header ERC remnants
    [integrated-sensor-test.kicad_sch]
2026-09-27 Align U2 with W25Q16 USON baseline
    [integrated-sensor-test.kicad_sch]
2026-10-02 Implement native M1 four-key Hall evaluation circuit (#27)
2026-10-04 EDA-002C4B2: Qualify headless KiCad downstream CAM — BLOCKED (#46)
    [run-1-positions.csv, run-2-positions.csv]
2026-10-04 Classify JITX manufacturing blockers with C4B3 evidence (#48)
    [run-1-positions.csv, run-2-positions.csv]
2026-10-05 EDA-002C4B5: qualify supported source routing — BLOCKED (#54)
2026-10-06 EDA-003A: Re-qualify KiCad footprint importer fidelity (#59)
2026-10-07 EDA-003E: Probe recurring via-clearance signature fixability (#68)
    [analyze.py]
2026-10-08 EDA-004C: CONVERSION_BLOCKED at duplicate GND net handoff (#76)
    [smoke.kicad_pcb, smoke.kicad_sch]
2026-10-08 EDA-004D: bounded converter repair blocked at footprint library identity (#78)
    [smoke.kicad_pcb, smoke.kicad_sch]
2026-10-12 EDA-004E: native KiCad PCB I/O passes; frontend remains unqualified (#80)
2026-10-14 EDA-004F: qualify headless small-schematic creation and electrical checks (#84)
2026-11-03 Issue #89: Freerouting Main未完了の原因分析と技術推奨 (#90)
    * docs: analyze saved Freerouting Main failure for issue 89
    * docs: record draft submission and elapsed work time
2026-11-03 Issue #97: falsify default fastroute condition with unrouted and narrow SES traces (#98)
2026-11-04 docs: #105 fab_router tiles — 未配線21件・固定条件不合格 (#106)
    * docs: record issue 105 detailed routing recovery and failure
    * docs: retain draft PR 106 verification receipt
2026-11-04 Issue #115: test KRT escalation off; record 28 opens at 0.20mm (#116)
2026-11-04 Issue #119: 有望3ツール×4セルの4層・0.127mm固定条件評価 (#120)
    * docs: measure four relaxed-condition routing cells for issue 119
    * docs: record Draft PR 120 receipt and final issue 119 evidence audit
    ---------
2026-11-04 Issue #117: smoke通過・4層Main両セルの未配線26/28件とWing見通し (#118)
    * Issue #117: record four-layer Stage 0 conflict and Wing outlook
    * Record Draft PR 118 submission and final evidence audit
    * Issue #117: pass amended smoke gate and record both four-layer Main cells
    * Record PR 118 amendment submission receipt and final audit
    * Confirm remote PR head and finalize amendment submission record
    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
2026-11-04 Issue #121: 0.10mm条件で完全自動配線を確認 (#122)
    * docs: qualify full automatic routing at 0.10mm for issue 121
    * docs: record draft PR 122 submission receipt
    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
2026-11-04 Issue #124: Main BOM具体化とPCBA総額見積もり (#125)
    * Issue #124: Main BOM具体化とPCBA総額見積もり
    * Issue #124: select approved Basic capacitors and revise PCBA estimate
    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
2026-11-04 docs: record Main four-layer and 0.10 mm baseline (D-019) (#126)
2026-11-04 Evaluation Wing: 部品寄せ分析と16/17mm・21キー設計入力 (#127) (#128)
    * docs: review Wing parts placement and frozen interface budget (#127)
    * feat: define 16mm and 17mm Evaluation Wings and 21-key candidates (#127)
    * fix(wing): replace representative21 with recorded Piantor layout
    * docs: record D-020 representative Wing dimension relaxation (#127)
2026-11-04 Wing 2層配線評価: 入力等価性ゲート不通過で停止 (#129) (#130)
    * Wing routing evaluation: stop at failed input equivalence gate (#129)
    * Fix Wing footprint library IDs and record single-run routing results (#129)
    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
2026-11-04 Wing自動配線: 2層0.10mmで16/17mm合格条件を確認 (#131) (#132)
    * Document Issue #131 Wing routing conditions and audited evidence
    * Record Draft PR publication and seal Issue #131 submission hashes
    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
2026-11-04 Add Wing 0.10mm cost check evidence and report (#133) (#134)
2026-11-04 docs: record D-021 Wing two-layer 0.10 mm baseline (#135) (#136)
2026-11-05 Main 製造前レビュー準備：via 25箇所とJ1固定脚の判断材料 (#137) (#139)
    * docs: prepare Main manufacturing review for issue #137
    * docs: record Draft PR #139 submission evidence
    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
2026-11-05 Wing 発注前製造レビュー準備：形状加算と線幅公差の影響 (#138) (#140)
    * docs: prepare Wing manufacturing review for issue 138
    * docs: record draft PR 140 publication for issue 138
2026-11-05 Wing 電源インテグリティ・フォローアップ：電源／GND 0.30mm 拡幅セルの合格と電圧降下の再評価（#141） (#142)
    * Evaluate Wing power integrity with split power and signal widths (#141)
    * Record publication attempts and host handoff for #141
    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
2026-11-05 docs: Main 発注仕様の確定記録 D-022（POFV・J1 Economic PCBA）(#145) (#146)
    * docs: record D-021 amendment (trace-width classes) (#143)
    * docs: record Main order specs (POFV vias, J1 Economic PCBA) as D-022 (#145)
    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
2026-11-05 Main 機構改版 Stage 1：取付穴配置案と再資格確認の見通し (#153) (#154)
    * docs: propose Main mounting geometry and Stage 2 checks (#153)
    * docs: record Draft PR submission and final verification (#153)
    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
2026-11-05 Main 機構改版 Stage 2：案A の実装・再配線・再資格確認 (#155) (#156)
    * feat(hardware): qualify Main mounting plan A for issue 155
    * docs: record issue 155 push authentication failure and draft PR text
    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
2026-11-05 Main 2 Wing 接続化 Stage 1：実現性・インタフェース定義案 (#157) (#159)
    * docs: propose Main dual-Wing interface and feasibility for issue 157
    * docs: record issue 157 draft PR publication and final preservation checks
    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
2026-11-06 Wing素基板：両ピッチの製造ZIPと発注前チェック（#147） (#148)
    * Prepare Wing bare PCB manufacturing packages and order checks (#147)
    * Record Draft PR #148 publication and support read-only follow-up audits
    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
2026-11-06 Wing 両ピッチにシルクを追加し製造データを再検証 (#149) (#151)
    * Wing 両ピッチにシルク追加・銅箔同一性と製造データを再検証 (#149)
    * docs: record Issue 149 Draft PR and committed artifact audit
    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
2026-11-06 docs: 筐体設計 Stage 1 の機械要件と寸法根拠 (#150) (#152)
    * docs: propose Stage 1 case mechanics and dimension evidence (#150)
    * docs: record Stage 1 Draft PR publication (#150)
    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
2026-11-06 ver.A Wing 標準実装化 Stage 1：位置決め穴・裏面Hall・左右展開の設計計画 (#158) (#161)
    * docs: plan ver.A Wing standard mounting for issue #158
    * docs: record issue #158 Draft PR publication and validation
    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
2026-11-06 Main 2 Wing Stage 2：D-024と機構ゲート停止・案C切替提案 (#160) (#162)
    * docs: record D-024 and issue 160 mechanical stop with plan C proposal
    * docs: record draft PR 162 publication and final preservation checks
    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
2026-11-06 2 Wing 電源：4方式の数値比較と保証条件の推奨 (#165) (#166)
    * docs: compare dual-Wing power architectures for issue 165
    * docs: record issue 165 Draft PR and publication evidence
    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
2026-11-06 Main案CのD-025採用記録・機構具体化とゲート未成立による停止 (#163) (#164)
    * Record plan C adoption and unresolved mechanical gate for issue 163
    * Record draft PR 164 publication and final artifact checks
    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
2026-11-06 Main 2 Wing Stage 2：D-027入力再定義・実装候補と再資格確認の停止 (#167) (#168)
    * Record D-026 and stop Main dual-Wing Stage 2 on USB input budget (#167)
    * Record successful branch push and approval-policy rejection of Draft PR
    * Record D-027 and dual-Wing implementation candidate; stop after bounded qualification failure (#167)
    * Record successful content push and blocked PR metadata update (#167)
    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
2026-11-06 docs: add lessons-learned device development notes (#170) (#171)
    Distilled from docs/decisions.md (D-001–D-027), the docs/issue-*.md
    verification reports, and the PMO run record (Issues #87–#169).
    Adds pointers from project-status.md and eda-path-history.md.
2026-11-06 Audit Main Rev.2 and Wing Rev.1 via-pad overlap (#183) (#184)
2026-11-06 マトリクス基板 Rev.2：16mm／17mm 両ブロック 18キー評価基板（#178） (#181)
    * M1 matrix: combine 16/17mm 3x3 fields, qualify D-021 and export PCBA (#178)
    * Record Issue 178 publication and automatic Draft PR approval rejection
    * D-028 の文面を命名規約（Issue #179）に合わせて調整（PMO 記録整備）
    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
2026-11-06 マトリクス基板 Rev.3：via-パッド重なり排除で POFV 不要化（#182） (#186)
    * Matrix Rev.3: eliminate via-pad overlaps, qualify D-021 and regenerate CAM (#182)
    * Record Issue 182 publication and Draft PR approval-policy rejection
    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
2026-11-06 Main 2 Wing Stage 2 フォローアップ：1回目合格・部品更新後の2回目不合格で停止 (#169) (#172)
    * Record bounded Main dual-Wing seed/component follow-up and qualification stop (#169)
    * Record content push and approval-policy rejection of Draft PR creation (#169)
    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
2026-11-06 Main 2 Wing Stage 2 限定継続：preflight 停止と seed-a の整理 (#173) (#174)
    * Stop Issue 173 at failed preflight and preserve qualified seed-a handoff
    * Record Issue 173 push authentication fail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
2026-11-06 Main 2 Wing Stage 2 完成：1210 出力C 維持で全44ネット・4指標0 (#175) (#176)
    * Record Issue 173 push authentication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
2026-11-06 BOM 訂正：C26-C28 と R17 の代替品を反映 (#175 訂正) (#177)
    * Record Issue 173 push authentication failure and Draft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
2026-11-06 Main Rev.3：via 移設で POFV 不要化（#185） (#187)
    * Record Issue 173 push authentication failure and Draft PR approval r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
2026-11-06 基板の命名規約：版は基板ごとに持つ（Rev.M1 廃止） (#180)
    * 基板の命名規約を追加：版は基板ごとに持ち、Rev.M1 を廃止（PO 決定 2026-11-06）
    * 命名規約を訂正：pitch9（ピッチ別 3×3）をマトリクス基板 Rev.1 とし、18キー基板を Rev.2 とする
    * 命名規約に版ごとの経緯（1行履歴）を追加
    * 対応表と経緯に Matrix Rev.3 と Main Rev.3 を追加
    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
2026-11-06 BOM 訂正：C25 を Basic 部品へ統一（#185 訂正） (#189)
2026-11-06 Issue #188：Main Rev.3 発注前確認 — 筐体 Stage 1 照合＋干渉チェック (#191)
    * Issue #188: 筐体 Stage 1 データと Main Rev.3 の照合レポートと証跡
    * Issue #188: add geometric interference checks (case envelopes vs boards)
    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
2026-11-07 Issue #194 Wing Rev.2 Stage 2：Cantor配列での再レイアウト（Phase A＋B 完了） (#195)
    * Issue #194 Phase A: propose Wing Rev.2 placement and compact outlines
    * Complete issue #194 Wing Rev.2 Phase B qualification and CAM
    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
2026-11-07 Issue #196 Main Rev.4：三角形 Main＋UDB 分離（Phase A／A-2／B 完了） (#197)
    * Issue #196 Phase A: propose centered connectors and chamfered Main Rev.4 outline
    * docs(hardware): add issue 196 phase A-2 triangular Main placement study
    * feat(hardware): complete issue 196 Main Rev.4 Phase B routing and manufacturing handoff
    * docs: remove stray conflict marker line left in decisions.md
    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
2026-11-07 Issue #200 Wing Rev.3 Stage 1：北タブ移設・南トリムの形状検討 (#201)
    * Issue #200 Stage 1: evaluate Wing Rev.3 tab, harness and south trim geometry
    * Issue #200 Stage 1b: replace north tab with broad R5 shoulder
    * Issue #200 Stage 2: Wing Rev.3 boards, qualification, power/harness checks, CAM
    Four independently generated Wing Rev.3 boards (16/17mm x left/right) with
    native DRC and independent gate metrics at zero, via-to-pad minimum 0.126mm.
    Rev.3 copper resistance extraction, 124.097/200mm harness comparison,
    Main clearance check, Standard-PCBA panels/CAM, case CSVs, D-034 draft and
    Stage 2 report. Harness length decision remains open.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
2026-11-07 Issue #198 ケース Stage 2：Wing Rev.3 形状での詳細モデリング (#202)
    * feat(case): complete issue 198 stage 1 mechanical study
    * Model issue 198 Stage 2 case for Wing Rev3 Stage1b
    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
2026-11-07 Issue #198 ケース最終データ：Rev.3 確定 CSV・固定点15点・200mm 最終化 (#203)
    * Issue #198 ケース最終データ：Wing Rev.3 確定CSV、固定点15点、200mmハーネス最終化
    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
2026-11-07 Add Issue 190 Stage 1 Cantor-derived Wing geometry proposal (#193)
2026-11-07 D-031：ナレッジ記録方式の採用と findings.md 新設 (#192)
2026-11-07 リポジトリ整理・ナレッジ整理 実行計画（P0） (#204)
    * docs: リポジトリ整理とナレッジ整理の実行計画を追加
    * docs: 整理計画にダッシュボード（task/）の扱いを追加（PO指摘）
    * docs: ダッシュボードは用途変更（マイルストーン＋現在位置の大局ビュー）に決定（PO）
    * docs: 成果公開方式の比較と整理計画への提言を追加
    * docs: work層方式の議論と参照整合性の実測を追加
    * docs: PO判断（2026-11-08）を計画に反映 — 開発repo は現構造維持、公開は独立repo＋Releases、P7/P8 は対象外
    Co-autho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
2026-11-08 docs: index current artifacts and refresh milestone dashboard for #207 (#208)
2026-11-08 Issue #209（整理計画 P4）：履歴索引の新設 (#210)
    * docs: add generation and evidence history index for issue #209
    * docs: correct D-030 adoption history after PO confirmation
    * docs: order history index from newest to oldest
    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
2026-11-08 fix(manufacturing): add verified Gerber-frame ordering CPLs for issue #219 (#220)
2026-11-09 Main Rev.5：J4 を Molex Pico-EZmate 781710004 に変更（Issue #221） (#222)
    * docs(main): record issue 221 connector research and hold for primary Fly pinout
    * feat(main): qualify Rev5 Pico-EZmate J4 and regenerate manufacturing package (#221)
    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
2026-11-12 Main Rev.6: 三角形の頂点を面取り（Issue #226） (#227)
    * hardware: chamfer Main Rev.6 vertices and qualify manufacturing data
    * docs: adopt D-036 and finalize F-014 at the PR #227 merge gate
    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
2026-11-12 ケース外形の平滑化：凸な曲線の南縁＋北側USB凹みの解消（Issue #228） (#229)
    * Design Issue 228 straight south case outline for Phase A approval
    * Revise Issue 228 Phase A with smooth south and north curves
    * Revise Issue 228 Phase A with shallow south spline and R5 joins
    * Revise Issue 228 south outline to convex sweep and report shelf conflict
    * Build Issue 228 round-4 production case for both pitches
    * Checkpoint Phase C Fly candidate: BLOCKED by connector and 16mm clearance defects
    * Phase C continuation: store full 170mm cable and audit USB overlap curves; remains BLOCKED
    * Fix 16mm Fly seat clearance while preserving Wing pockets and boss supports
    * Rec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
2026-11-13 Wing マウント方式＋スイッチプレート設計検討（Issue #230） (#231)
    * Study Wing mounting and design reversible supported switch plates (#230)
    * Supplement Wing mount study with acrylic plate evaluation (#230)
    * Record D-038 adopting the E-R Wing mount and aluminium plate (#230)
    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
2026-11-13 Study Wing Rev.4 single-sided assembly: placement passes, routing and underside GH exit fail (Issue #233) (#234)
2026-11-13 Wing Rev.4 第2ラウンド：直角GH選定＋3/4配線合格（Issue #235） (#236)
    * Study Wing Rev4 right-angle GH and bounded routing closure for issue 235
    * Close issue 235 16L power escape with unchanged qualification gates
    * Record D-039 adopting Wing Rev.4 single-sided assembly (#235)
    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
2026-11-13 Complete issue 232 full-cover plate and case release package (#237)
2026-11-13 Study: flush Z16.2 bay cover is infeasible with top-entry GH on Main (Issue #238) (#239)
    * Complete issue 232 full-cover plate and case release package
    * Study flush Z16.2 bay cover feasibility and measured GH obstruction
    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
2026-11-13 Study: Main Rev.7 side-entry candidate + bay cover routing rejection (Issue #240) (#241)
    * Study #240 side-entry Main candidate and rejected flush-cover routes
    Requalify the outward SM14B-GHS-TB candidate, preserve D-024 nets and
    board/placement invariants, and disclose the wider copper-routing exception.
    Record connected Wing160/Fly170 trials, underside cover pockets, retention
    concept, external USB checks and measured mechanical counterexamples.
    Electrical gates pass. The evaluated cover assembly fails and no global
    feasibility or adoption claim is made.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
2026-11-13 Study: dedicated under-cover routing at current height — collision map (Issue #242) (#243)
    feasibility or adoption claim is ma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
2026-11-13 Study: Delta=6/10 height search — near-miss grazes remain, length bound exceeded (Issue #244) (#245)
    feasibility or adoption c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
2026-11-13 Study: Delta=6 flush bay cover PASSES all gates at both pitches (Issue #246) (#247)
    feasibility or adoption claim is made. Inclu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
